NetHunter123/Jflyproject/GN+.md

---
tags:
  - project
  - engineering
  - gungnear
status: ✅ CFD дорахований; форма прийнята рішенням 01.10 з винятком (2 кВт на 250 км/год) — R07g, розд. 10 і 12
updated: 2026-10-01
---

# GN+ — модель для симуляції

> Зібрано 2026-09-29 з генератора light+. Питання: **чи лишаємо зовнішню форму**, перш ніж деталізувати стовбур, ніс і хвіст.
> Як рахувати і що вже запущено — [[R07g-GN+-CFD]]. Перший план із цієї нотатки аудит визнав невиконуваним, він в архіві: [[GN+-plan-do-audytu]].

## Файли

| | |
|---|---|
| STEP | `CAD/GN+.step` |
| STL | `CAD/GN+.stl` |
| Генератор | `python CAD/gn_detail.py` |
| Профіль | `CAD/clarky.dat` (Clark Y, UIUC) |
| Onshape | [GN+_onshape.step](https://cad.onshape.com/documents/81c8f94cadaabcb52f3eb3df/w/f67ffecee0ddf9010c7fb0ed) — окремі деталі, імпорт 2026-10-01. Файл `CAD/GN+_onshape.step`. Безкоштовний акаунт: документ публічний |

Перевірка збірки: планер і кок — два валідні тіла. Ніс від кока, хвіст x = 1371 мм, розмах 1342 мм, хорда 224 мм. Труба Ø80.

**Одиниці файлу — міліметри.** У солвері модель має стати метрами (масштаб 0,001). Контроль після імпорту: розмах **1,342 м**, довжина **1,37 м**. Якщо розмах вийшов 1342 м, масштаб не застосований, результати викинути.

Старий запуск на 250 км/год (16,5–18,5 Н) — інший літак: коротший, MH 32, із шасі. З цією GN+ його не порівнювати.

## Що в моделі є

Зібрано `python CAD/gn_detail.py`. Два тіла: планер і кок із гвинтом. Кок **не злитий** з корпусом.

- Крило **0,30 м²**, Clark Y, установка +2°, V 2°.
- Труба **Ø80**, шкіра носа і конуса врівень з нею.
- **Кок до x = 33 мм** сидить на гвинті. **Капот починається з x = 39 мм.** Між ними щілина 6 мм, у ній лопать.
- Чотири пази за мотором (x 104–118) і отвір **Ø20** у торці хвоста. Це записаний варіант носа, не остаточне рішення по охолодженню батареї.
- Чотири отвори під шпильки М3 на пробці носа і на пробці хвоста, хрест під 45° до крила.
- Джойнер Ø16 крізь трубу, з буртиком на стінці.
- Стабілізатор і кіль на конусі.

## Чого в моделі немає

- Отворів вентиляції батареї в циліндрі труби. Їх досі не вибрали.
- Люків. Труба суцільна.
- Окремих гайок і різьби: шпильки задані отворами, не нарізаним металом.
- NACA 4412.

Числа R07c (11,9 Н і 33 хв на 180 км/год, зрив 73 км/год, запас стійкості 12 %) пораховані на **MH 32**. Для Clark Y на 180 км/год очікувалась втрата близько **4 хв**, якщо решта літака та сама. Це орієнтир, не результат CFD.

## Навіщо кожен пакет

Форму міняємо, якщо спрацьовує хоч один пункт:

1. **180 км/год.** Поправлений опір на 1g вищий за **16 Н**: 33 хв тоді стають близько 25 хв, форму обговорюємо до заморозки. Стелю мотора **2 кВт** дивитись на 250 км/год: на 180 вона відповідає опору близько 34 Н і спрацьовує пізніше за 16 Н.
2. **Катапульта.** З отриманого CL_max швидкість сходу 1,2·Vs вища за **25 м/с** (стеля ELI PL-40).
3. **Стійкість.** Нахил Cm(CL) дає запас відносно x = 591 мм менший за **8 %** хорди або більший за **20 %**. Або нейтральна точка так зсунулась, що записана коробка ЦМ 575–596 мм більше не тримає близько 12 %.

Якщо жоден пункт не спрацював — зовнішня форма GN+ для цього кроку прийнятна, можна переходити до стовбура. Матеріал крила і заміна на NACA 4412 цим пакетом не вирішуються.

## Опорні числа (повний літак, 7,75 кг)

Вага **76,0 Н**. Площа **0,30 м²**. Хорда **0,2236 м**. Розмах **1,3416 м**. Повітря ρ = 1,225 кг/м³, ν = 1,46·10⁻⁵ м²/с.

Точка моментів: **x = 0,5837 м** (25 % хорди), y = 0, z = 0. Осі файлу: x назад, y на праве крило, z вгору. Позитивний Cm — ніс угору.

ЦМ для запасу стійкості лишаємо **x = 0,591 м** з R07c. Під масу крила Clark Y його не перераховували. У звіті це написати прямо.

| Режим | V | Потрібний CL на 1g | Re хорди |
|---|---|---|---|
| Найдовший політ, 88 км/год | 24,4 м/с | **0,69** | 3,7·10⁵ |
| Крейсер, 180 км/год | 50 м/с | **0,166** | 7,7·10⁵ |
| Стеля, 250 км/год | 69,4 м/с | **0,086** | 1,06·10⁶ |

CL на 1g = 76,0 / (q · 0,30), q = 0,5 · 1,225 · V². Кут 1g знаходити інтерполяцією поляри, не вгадувати. **α = 0° — це не безпідйомний політ** (установка крила +2°, профіль вигнутий).

## Як читати результат

Розклад кутів, сітки і поправка на шорсткість — у [[R07g-GN+-CFD]]. Коротко, щоб не розійтись із тим файлом:

- A і B — півмодель `GN+_cfd`. F — повна модель, бо ковзання на дзеркалі не існує.
- Лопаті в розрахунку немає. Корпус для сітки суцільний.
- Шорсткість: **D_льот = D_тиск + 1,35·D_тертя**. На весь опір 1,35 не множити.
- Опорна площа півмоделі в солвері **0,15 м²**, довжина **0,2236 м**. Сили півмоделі ×2 = повний літак.
- Наступна сітка, якщо ці запуски доведеться повторити: розділ 8 у R07g. Не повертати рецепт «7 мкм, 18 шарів, ріст 1,25».

Форму чіпаємо, якщо спрацював хоч один поріг із розділу вище. Геометрію в солвері під результат не підправляти.
