NetHunter123/Jflyproject/R08-Elektronik.md

---
tags:
  - project
  - engineering
  - gungnear
status: 🔍 дослідження записане 2026-10-03; окрема перевірка ще не проведена
updated: 2026-10-03
---

# R08 — електроніка light+: підбір, розміри, розклад

> **Рішення Віктора 2026-10-03.** Нічого ще не куплено, підбираємо все. **4 серви, без закрилків** (2 елерони + висота + напрямок). **FPV на борту** (камера + відеопередавач). Розклад робимо в Python-генераторі, а всі розміри й креслення лежать тут.
> Генератор: `python CAD/gn_layout.py` → `CAD/GN+_layout.step` (імпорт в Onshape) і `CAD/layout_report.json`.
> Скоуп як завжди: посадка і правила польотів не враховуються ([[proj. Gungnear]]).

## 1. Коротко

- Усе підібрано під стандарт R07c (12S, ~400 kV, APC 11×14). У кожної деталі є точні розміри з даташита або магазину. Де розмір оцінений, це сказано прямо (розділ 11).
- **Рекомендую варіант A:** друкований ніс подовжується на **92 мм**, у ньому відсік з ESC, датчиком струму і FPV. Ніс стає окремим «силовим модулем». **Маса ≈7,74 кг, центр мас 584,8 мм** (❌ без шпильок; з ними ≈7,97 кг і ≈587 мм — розділ 7) (коробка 575–596, перші польоти 583–590), баласт не потрібен. Апарат стає 1468 мм замість 1371.
- Варіант B (як у R07c: ESC у спинному обтічнику над носом): 593,8 мм, для перших польотів потрібно ≈60 г баласту в носі.
- Чотири речі, які розклад знайшов у вже записаному. Деталі в розділі 9:
  1. **Щілина 6 мм між коком і капотом не пропускає справжній гвинт.** Маточина APC 11×14 має товщину 14,5 мм, корінь лопаті ще ширший. Кок має закривати маточину і мати вирізи під лопаті, а капот починається за ним.
  2. **Алюмінієва труба — клітка Фарадея.** Антени приймача, відео й GPS усередині ринви не працюють. Тому GPS і приймач стоять у друкованому конусі, а відео — у друкованому носі.
  3. **ESC у трубу не стає ні вздовж, ні впоперек.** Дроти виходять з торців, і місця на їхній вигин немає. Звідси подовження носа (A) або обтічник (B).
  4. **Пакет 21700 має обрис Ø66, а не Ø70.** Шпильки М3 на Ø72 проходять з запасом 3,5 мм, суперечності з хаба більше немає. У центрі пакета лишається отвір **Ø22,5** під дроти і повітря.

> ❌ **З перевірки [[R09-Akku-Waerme]] (2026-10-04), стосується цього розкладу:**
> - **Старт на справжньому повному газі — ≈80–95 А з пакета**, а не 55–65 А (розділ 11 тут). Це понад 70 А мотора і на межі 80 А ESC. Для катапульти потрібен ліміт газу ≈85 % або сильніші мотор і ESC.
> - **250 км/год лише на свіжому пакеті** (≥3,68 В на комірку): нижче мотору бракує напруги.
> - **Потрібен конденсаторний блок (Castle CapPack ≈880 мкФ / 50 В) біля ESC**: силові дроти від пакета до ESC ≈1,5 м.
> - **XT90-S і XT90 у кільці** розраховані на 40–45 А тривало: старт і 250 км/год їх перевантажують.
> - **ESC Edge Lite у відсіку A** потребує тісного кожуха з власним NACA-входом. Деталі й решта — у R09, розділи 3–6.
> - Струм на 180 км/год ≈26 А, а не 19 А з R07c.

## 2. Список деталей

| № | Вузол | Модель | Розміри, мм | Маса, г | Живлення | Джерело |
|---|---|---|---|---|---|---|
| M | Мотор | **Scorpion SII-4035-380KV** | Ø48,8 × 64,9 корпус, загальна довжина з валом 95, вал Ø7,98, різьба гайки M8×1 | 435 | 12S, до 70 А, 2600 Вт тривало | scorpionsystem.com |
| P | Гвинт | **APC 11×14 (LP11014, «Sport»)** | маточина Ø25,4 × 14,5, отвір 5/16" (7,94) → розвернути до 8,0 | 39 | — | apcprop.com |
| E | ESC | **Castle Phoenix Edge Lite HV 80** (без BEC) | 69 × 30,5 × 17,8; у другого продавця 66 × 30,5 × 21,4 → у моделі конверт **69 × 30,5 × 21,4** | 94,6 з дротами (42,5 без) | 3–12S, 80 А | Castle / Kings Lynn Model Shop |
| I | Датчик струму + напруги | **Mauch HS-100-HV** | 47 × 18 × 11 | 8 | 4–14S, 100 А, живлення 5 В | mauch-electronic.com |
| PM | BEC | **Matek PM12S-3** | 61 × 40 × 15 | 53 | вхід 9–55 В; Vx 5,25/6/8 В 15 А; 5,2 В 4 А; 12 В 4 А; дільник 1:21 | mateksys.com |
| FC | Польотник | **Matek H743-WING V3** | 54 × 36 × 13, кріплення 30,5 × 30,5 | 30 | вхід 8–36 В (беремо 12 В з PM); свої BEC 5 В і 9/12 В | getfpv / mateksys |
| RX | Приймач | **RadioMaster RP3 V2** (ELRS 2,4 ГГц, дві антени) | 22 × 13 × 4, антени T 65 мм | 4,6 | 5 В | buddyrc |
| G | GPS + компас | **Matek M10Q-5883** | 20 × 20 × 12,4 | 8 | 5 В | readymaderc / rotorama |
| A | Датчик швидкості | **Matek ASPD-4525** + трубка Піто | плата ≈20 × 20, у моделі 20 × 20 × 6 | 3,5 + трубки | 5 В, I2C | readymaderc |
| V, K | FPV | **DJI O4 Air Unit (Lite)** | модуль 30 × 30 × 6, камера 13,44 × 12,36 × 16,5 | 8,2 (+0,75 антена) | 3,7–13,2 В → беремо 9 В з FC | DJI / getfpv |
| T, WS | Серви, 4 шт. | **KST X10** (тонке крильне, сталеві шестерні) | 30 × 29,6 × 10; з вушками 35,5 | 28 кожне | 6–8,4 В; 9,5 кг·см на 7,4 В, 10,8 на 8,4 В | KST / buddyrc |
| X1 | Головний роз'єм | **Amass XT90-S** (антиіскровий) | пара в зборі 49 × 21 × 10 | 15,3 | 45 А тривало, 90 А пік | rotorama / gator-rc |
| J | Сигнальні роз'єми | **MPX8** (8 контактів), 4 пари | ≈24 × 14 × 10 — **зміряти** | ≈6 пара | 6 А на контакт | modelheliservices |
| — | Комірки | клас 21700, приклад **Molicel P50B** | Ø21,55 × 70,15 max | 71 max | 5 Ач, 60 А | molicel.com |

**Чому саме ці.**

- **Мотор.** Справжніх 12S-моторів на ~400 kV і 2 кВт мало. SII-4025-440 бере лише 7S. T-Motor AT4130 є на 12S тільки у версії KV300, а це 13,3 тис. об/хв без навантаження: нижча стеля швидкості. SunnySky X4130-III розрахований на 6S. SII-4035-380 — 12S, 2600 Вт, 380 kV × 44,4 В ≈ 16 900 об/хв, тобто під лімітом APC 11×14 (17 273). Ціна: **на 55 г важчий** за бюджет 380 г, 279,99 $.
- **ESC.** Найменший і найлегший з 12S-регуляторів на 80 А, які знайшлися. Інші: Castle Edge HV 80 72 × 51 × 23, T-Motor FLAME 80A 84 × 33,5 × 19,5 / 109 г, YGE Aureus 105 V2 78 × 37 × 20 / 146 г / 369 €, Hobbywing FlyFun HV 110A 92,7 × 45,6 × 27 / 170 г. У Edge **Lite немає радіатора**, тому він мусить стояти в потоці повітря. У варіанті A він сидить на шляху охолодження мотора.
- **Живлення авіоніки.** Matek H743-WING бере максимум 8S. Тому 12S іде в PM12S-3: 12 В на вхід польотника, 8 В окремою шиною на серви. Польотник далі сам дає 5 В на приймач, GPS і датчики та 9 В на відео. Струм усього літака міряє Mauch на головному проводі, бо датчик польотника тепер бачить лише авіоніку. Напругу 12S дає дільник у PM12S-3.
- **FPV.** O4 Lite важить 8,2 г і має тонкий модуль 6 мм, який стає над ESC. O4 Pro (33,5 × 33,5 × 13 + камера 25,55 × 20 × 23,3, 32 г, 7,4–26,4 В) пише краще відео, але у відсік стане лише після перекладання датчика струму.
- **Серви.** Момент на шарнірі елерона 310 × 56 мм на 250 км/год: ≈3 кг·см при 10° і ≈6 кг·см при 20° (Ch_δ ≈ −0,6/рад, оцінка). X10 на 8 В дає ≈10 кг·см, запас ≥1,7. Руль висоти ≈1,7 кг·см при 10°. Усі чотири серви однакові, тож запасне одне на всіх.

## 3. Схема живлення і проводів

```
         НІС (знімний)                  ПЕРЕДНІЙ ПАКЕТ+ВАНТАЖ          КІЛЬЦЕ     ЗАДНІЙ ВАНТАЖ+ПАКЕТ        ЗАДНІЙ МОДУЛЬ + КОНУС
 мотор ─3 фази─ ESC ─ Mauch ─ XT90-S ══ F−  [6S3P]  F+ ──────────── XT90 ── R−  [6S3P]  R+                 PM12S-3 ─12 В→ FC ─5 В→ RX, GPS, ASPD
                 │                       ↑ R+ іде крізь отвір Ø22,5 ───── XT90 ───────────┘                   │  └─8 В→ 4 серви
                 └─ шина 12S (2×20 AWG) ═ MPX8 ═════════════════════════ MPX8 ═════════════════════════ MPX8 ┘  FC ─9 В→ O4 (у носі)
 O4 Lite + камера ── UART ═ MPX8 ═════════════════════════════════════ MPX8 ═════════════════════════ MPX8 ── FC
```

- **Пакет 12S** — два блоки 6S3P, з'єднані послідовно через XT90 у кільці. Плюс заднього блоку (R+) іде вперед крізь центральний отвір переднього блоку до XT90-S на носі.
- **Ніс з'єднується наосліп.** Половина XT90-S і MPX8 сидять на торцевій пластині переднього пакета, друга половина — у носі. Ніс сідає на шпильки, і роз'єми входять самі. **Посадка носа = подача живлення**, мотор крутиться лише після арму з пульта.
- **Вісім контактів MPX8, однакові на всіх трьох стиках:** 1 +12S шина (запобіжник 2 А біля Mauch), 2 GND, 3 +5 В (живлення Mauch), 4 сигнал струму Mauch, 5 газ ESC, 6 +9 В на O4, 7 UART TX, 8 UART RX. На задньому стику друга MPX8 несе 2 сигнали елеронів, +8 В і GND (4 контакти в резерві).
- **Крило.** Дроти серв і силіконові трубки Піто заходять у трубу біля кільця. Як саме — відкрите питання 3 у розділі 10.

## 4. Варіанти розкладу носа

| | **A — подовжений ніс (рекомендую)** | B — спинний обтічник (R07c) |
|---|---|---|
| Де ESC | у друкованому відсіку Ø80 × 92 мм між моторною плитою і трубою, уздовж осі | у горбі ≈75 × 55 × 28 на капоті |
| Довжина апарата | **1468 мм** (+97) | 1373 мм |
| Маса | **7,74 кг** | 7,70 кг (+60 г баласту = 7,76) |
| Центр мас | **584,8 мм** — у вікні перших польотів 583–590 | 593,8 мм → ≈60 г баласту для 590 |
| Додатковий опір на 180 км/год (оцінка) | ≈+0,2 Н від довшого циліндра + ≈0,05 Н блістер камери → ≈−0,4 хв з 26 | ≈+0,05–0,16 Н від горба (R07b-V, перераховано з 250 км/год) |
| Нейтральна точка | ≈1 мм уперед (довший ніс і гвинт далі) — запас 14–16 % майже не міняється | без змін |
| Охолодження | ESC у потоці мотора, вихід через пази капота; батарея й авіоніка мають свій шлях | ESC у зовнішньому потоці, найкраще охолодження |
| Обшивка | гладка, лише блістер камери 8 мм | горб над носом, нових продувок не було |

Обидва варіанти вкладаються в коробку ЦМ. Різниця в тому, чи ніс стає знімним силовим модулем без нічого назовні (A), чи лишається коротким із горбом (B). **Вибір за Віктором.** Генератор будує геометрію лише для A.

## 5. Станції варіанта A (x від старого носа, мм)

| Зона | x | Що там |
|---|---|---|
| Новий ніс (вершина кока) | **−97,0** | було −2,1 |
| Маточина гвинта | −60,4 … −45,9 | APC 11×14, Ø25,4 |
| Кок | −97,0 … −44,9 | кок закриває маточину, вирізи під лопаті, основа ≈Ø57,6 |
| Капот (друк, стінка 2,4) | від −42,9 | щілина 2 мм за коком |
| Мотор | −40,9 … 24,0 | Ø48,8; зазор дзвона до капота **2,6 мм** |
| Моторна плита | 24,0 … 28,0 | 4 мм |
| **Відсік ESC** (друк, Ø80) | **28,0 … 120,0** | 8 мм на фазні дроти, ESC 36–105, 15 мм на вхідні дроти |
| ESC (E) | 36 … 105 | y ±15,25, z ±10,7, по осі |
| Датчик струму (I) | 58 … 105 | над ESC, z 12–23 |
| Модуль O4 (V) | 40 … 70 | під кришкою зверху, z 25–31 |
| Камера O4 (K) | 30 … 46,5 | у блістері, верх лінзи z ≈47 (на 7,4 мм вище Ø80) |
| XT90-S (X1) | 87 … 136 | під ESC, z −23…−13; з'єднання біля x ≈118 |
| MPX8 ніс (J1) | 106 … 136 | зверху, z 25–35, запас до стінки 0,8 мм |
| Ринва Ø80 × 0,7 | 120,0 … 1230,26 | без змін |
| Пробка носа | 120 … **134** | було 20 мм, тепер 14: батарея починається на 136 |
| Передній блок B1 | 136,0 … 350,25 | 6 комірок кільцем, обрис Ø65,7 (+рукав 0,8), отвір Ø22,5 |
| Передня камера вантажу | 354,25 … 574,25 | Ø66, як R07c |
| Кільце + XT90 + MPX8 | 577,25 … 601,25 | джойнер Ø16 на x 589,25 |
| Задня камера вантажу | 604,25 … 824,25 | Ø66 |
| Задній блок B2 | 843,26 … 1057,51 | як B1 |
| 2 × MPX8 (J2) | 1060 … 1088 | стик пакет ↔ задній модуль |
| PM12S-3 | 1090 … 1151 | знизу, z −20…−5 |
| FC H743-WING | 1094 … 1148 | над PM, z −2…11 |
| ASPD-4525 | 1152 … 1172 | |
| Серви хвоста T1, T2 | 1190,8 … 1226,3 | на конусному модулі, стоять у пробці, y ±2…12 |
| Пробка хвоста | 1205,3 … 1230,3 | 25 мм |
| GPS | 1236 … 1256 | угорі конуса під коренем кіля, z 20–32,4, запас 1,7 мм |
| Приймач | 1262 … 1284 | над стабілізатором, z 9–13 |
| Торець конуса | 1371,26 | вихід Ø20 без змін |

**Крило (кожне півкрило):** серво X10 на x 620–650, y 345–380, плоско (товщина Clark Y там ≈23 мм, серво 10 мм). Елерон y 330–640, хорда 56 мм (25 %), шарнір x 695,5. Трубка Піто на y 300: виступає на 40 мм перед передньою кромкою, поза струменем гвинта (r ≈ 140).

## 6. Креслення

Бічний розріз (помаранчеве — ніс, синє — пакет і вантаж, зелене — задній модуль, червоне — конус):

![[gungnear-r08-layout-side.png]]

Поперечні розрізи (вигляд ззаду). Жовті точки — шпильки М3 на Ø72:

![[gungnear-r08-layout-sections.png]]

Праве півкрило:

![[gungnear-r08-layout-wing.png]]

3D: `CAD/GN+_layout.step` — оболонка напівпрозора, кожна деталь окремим тілом з ID з таблиці. Імпортується в Onshape як збірка.

## 7. Маса і центр мас

База — R07c-V: **7750 г, ЦМ 590,6 мм**. З неї знято старий бюджет електроніки і додано новий поелементний список. Батарея, вантаж і конструкція лишаються на місцях R07c.

**Знято (бюджет R07b-V/R07c), 1111 г:** мотор 380 @88 · гвинт 39 @48 · кок/моторама/капот 81 @70 · ESC в обтічнику з проводкою, роз'ємами і запобіжником 271 @165 · авіоніка FC/GPS/RX/BEC 96 @1132 · 2 серво хвоста 75 @1142 · 4 серво крила 149 @620 · проводка R07c 20 @600.

**Додано, варіант A, 1097 г:**

| Що | г | x, мм |
|---|---|---|
| Мотор | 435 | −4 |
| Гвинт | 39 | −53 |
| Кок | 20 | −62 |
| Капот + плита | 61 | −5 |
| Відсік ESC (друк) | 50 | 74 |
| ESC | 94,6 | 70,5 |
| Mauch | 8 | 81,5 |
| O4 модуль + антена | 5,9 | 55 |
| O4 камера + блістер | 6,1 | 38 |
| XT90-S | 15,3 | 111,5 |
| MPX8 ніс | 6 | 121 |
| Кільце: XT90 + MPX8 | 20 | 589 |
| Провід R+ крізь передній блок | 21 | 220 |
| Джгут ніс → корма | 27 | 610 |
| Дроти серв крила | 8 | 860 |
| 2 × MPX8 ззаду | 12 | 1074 |
| PM12S-3 | 53 | 1120 |
| FC | 30 | 1121 |
| ASPD | 3,5 | 1162 |
| Розподіл 8 В | 5 | 1120 |
| 2 серво хвоста | 56 | 1209 |
| Тяги хвоста | 20 | 1280 |
| GPS | 8 | 1246 |
| Приймач | 4,6 | 1273 |
| 2 серво елеронів | 56 | 635 |
| Тяги й кришки серв крила | 24 | 686 |
| Піто + трубки | 8,4 | 760 |

**Результат A: 7736 г, ЦМ 584,8 мм.** Без баласту, у вікні перших польотів 583–590. Розпіркою заднього блоку (±15 мм → ±3,5 мм ЦМ) можна підняти ЦМ до 588 ± 3.
**Результат B: 7704 г, ЦМ 593,8 мм.** До 590 потрібно ≈60 г баласту в носі.

Не враховано: шпильки довші на ≈83 мм кожна, якщо вони доходять до моторної плити (+≈18 г на x ≈80, ЦМ −1,2 мм).

> ❌ **ВИПРАВЛЕНО 2026-10-03** (знайдено перевіркою довідки про Ø90): **самі шпильки в масі взагалі не враховані**, ні тут, ні в R07c. Це 8 × М3 сталь, 0,0555 г/мм: передні 4 × ≈457 мм (кільце → пробка носа) ≈101 г, задні 4 × ≈604 мм ≈134 г, разом **≈235 г**. З ними варіант A ≈**7,97 кг, ЦМ ≈587 мм**. Це ще у вікні перших польотів 583–590 і в коробці 575–596. Якщо шпильки доходять до моторної плити, додай ще ≈18 г. Полегшити можна алюмінієвими (7075) або титановими шпильками, або М2,5 — не пораховано. Окремої перевірки R08 ще не було.

## 8. Перевірка «чи влазить» (генератор)

Запас від кута деталі до внутрішньої стінки в найвужчому місці її довжини, мм. Перетинів між деталями немає.

| Деталь | Запас | | Деталь | Запас |
|---|---|---|---|---|
| Мотор у капоті | 2,6 | | PM12S-3 | 11,0 |
| ESC | 19,0 | | FC | 18,2 |
| Mauch | 12,9 | | ASPD | 28,5 |
| Модуль O4 | 3,2 | | Серви хвоста (у пробці) | 17,5 |
| XT90-S | 11,2 | | **GPS у конусі** | **1,7** |
| **MPX8 ніс** | **0,8** | | Приймач | 15,1 |
| Пакети B1/B2 | 5,7 | | Камери вантажу | 6,3 |
| Шпилька ↔ комірка | 3,5 | | Отвір у пакеті | Ø22,5 |

Найтісніші місця — MPX8 у пробці носа і GPS під кілем. Обидва треба звірити зі справжніми деталями.

## 9. Що це міняє в уже записаному

- ~~Кок до x = 33, капот з x = 39, щілина 6 мм, у ній лопать~~ ❌ **R08:** маточина APC 11×14 має 14,5 мм, а лопать біля кореня при кроці 14" займає вздовж осі ще більше. Кок мусить закривати маточину й мати вирізи під лопаті. Капот починається на 2 мм за коком. Повітря на мотор у такій щілині ≈3 см², тож вхід охолодження проєктувати окремо. **Зовнішня форма не міняється.**
- ~~Мотор у капоті x 48–98, «загальний» Ø46~~ ❌ **R08:** реальний 12S-мотор має довжину 64,9 мм і Ø48,8. Перед x ≈54 (старі координати) капот для нього затісний. Моторна плита стоїть на 118,9–122,9 (старі) або 24–28 (A).
- ~~Пакет 21700 у конверті Ø70, шпилька на r=36 заходить на пакет~~ ❌ **R08:** 6 комірок кільцем дають обрис **Ø65,7** (з рукавом ≈Ø67,3). Шпилька на Ø72 за 3,5 мм від найближчої комірки. Суперечність закрита.
- ~~Пробка носа 20 мм~~ ❌ **R08:** **14 мм**, бо батарея починається за 16 мм від торця труби. Навантаження несуть шпильки й торець, як і записано в [[Zbirka-shpilky]].
- ~~ESC Castle Edge HV 80 (72 × 51 × 23) як еталон~~ ❌ **R08:** беремо Edge **Lite** HV 80 (69 × 30,5 × 21,4, 94,6 г). Усередину ринви він не стає з жодним поворотом, бо дроти виходять з торців.
- ~~Авіоніка FC/GPS/приймач/BEC на x ≈1132, серви хвоста x ≈1142~~ ❌ **R08:** GPS і приймач переїхали в друкований конус, бо крізь алюміній не проходить радіо. Серви хвоста стоять на конусному модулі в пробці (1191–1226). Кіль у зоні над GPS не може мати вуглецю.
- ~~6 серв (з закрилками)~~ ❌ рішення 03.10: **4 серви**.

## 10. Відкриті питання — рішення Віктора

1. **Варіант A чи B** (розділ 4). Від цього залежить, чи переробляти ніс у CAD.
2. **Комірка.** P50B (5 Ач, 71 г, 648 Вт·год на 36 шт.) чи P45B (4,5 Ач, 70 г, 583 Вт·год, база R07c). Розміри однакові, розклад від вибору не залежить. Час у повітрі з P50B ≈+11 %, маса +36 г.
3. **Як дроти крила і Піто заходять у трубу.** Пропоную по два отвори Ø8–10 на кожен бік, на 15–20 мм позаду гільзи джойнера, під зализом кореня крила. У кільці стоять гнізда, у які встромляються роз'єми кореня. Хаб поки дозволяє лише отвір під джойнер, тож без рішення Віктора не свердлити.
4. **Компас.** Серви хвоста стоять за ≈10 мм від GPS-компаса. Для літака INAV/ArduPilot можуть летіти без компаса, за курсом GPS. Пропоную компас вимкнути, а не відсувати серви.
5. **O4 Lite чи Pro.** Lite стає як є. Pro потребує переставити датчик струму.
6. Шпильки до моторної плити (тягу несе метал, +≈18 г) чи до пробки носа (тягу несе друкований відсік).

## 11. Що не перевірено (для окремого проходу перевірки)

- Розміри MPX8 (≈24 × 14 × 10) — даних не знайдено, оцінка.
- Монтажні отвори Scorpion SII-4035 не опубліковані. У старшої серії HKIII-4035 — 30 × 25 мм під M4; для SII зміряти.
- Довжина валу перед дзвоном (≈30 мм з «загальної довжини 95») — висновок, не креслення.
- Струм на старті з катапульти: оцінка ≈55–65 А при повному газі (Cp статичний ≈0,08–0,09, не з даних APC). Межі ESC 80 А, мотора 70 А, XT90-S 45/90 А не перевищено, але це треба перерахувати.
- Шлейф камери O4 Lite: чи дістає від блістера до модуля (≈40 мм шляху).
- Маси: кок 20, капот 61, друкований відсік 50, тяги, джгути, роз'єми MPX8 — оцінки.
- Розміри Castle Edge Lite в двох джерелах різні (17,8 / 21,4 мм висоти). У моделі взято більший.
- Шарнірні моменти — тонкопрофільна оцінка Ch_δ ≈ −0,6/рад, без даних для конкретних рулів.
- Ефект подовженого носа на опір і стійкість — оцінка, не CFD.

## 12. Джерела

- Scorpion SII-4035-380: https://www.scorpionsystem.com/catalog/aeroplane/motors_1/sii-40/SII-4035-380/
- Scorpion SII-4025-440 (7S max): https://www.scorpionsystem.com/catalog/aeroplane/motors_1/sii-40/SII-4025-440/
- T-Motor AT4130: https://store.tmotor.com/product/at4130-long-shaft-fixed-wing-motor.html
- APC 11×14: https://www.apcprop.com/product/11x14/
- Castle Edge Lite HV 80: https://www.castlecreations.com/en/phoenix-edge-lite-hv-80-esc-010-0118-00 · https://www.kingslynnmodelshop.co.uk/castle-creations-phoenix-edge-80-lite-hv-esc/
- YGE HV: https://www.yge.de/en/high-voltage-hv-2/ · T-Motor FLAME 80A: https://www.getfpv.com/tiger-motor-flame-80a-esc.html
- Matek PM12S-3: https://www.mateksys.com/?portfolio=pm12s-3 · PM12S-4A: https://www.mateksys.com/?portfolio=pm12s-4a · FCHUB-12S: https://www.mateksys.com/?portfolio=fchub-12s
- Matek H743-WING V3: https://www.getfpv.com/mateksys-h743-wing-v3-flight-controller.html
- Mauch HS-100-HV: https://mauch-electronic.com/products/074-hs-100-hv
- Matek M10Q-5883: https://www.readymaderc.com/products/details/matek_gps_compass_module_m10q-5883
- Matek ASPD-4525: https://www.readymaderc.com/products/details/matek-digital-airspeed-sensor-aspd-4525
- RadioMaster RP3 V2: https://www.buddyrc.com/products/radiomaster-rp3-expresslrs-2-4ghz-nano-receiver
- DJI O4 Lite: https://www.getfpv.com/dji-o4-air-unit.html · O4 Pro: https://www.getfpv.com/dji-o4-air-unit-pro.html
- KST X10: https://www.buddyrc.com/products/kst-x10-digital-servo-8-4v-0-10s-7-5kg-cm-104oz-in
- XT90-S: https://www.rotorama.com/product/xt90s-antispark-konektor-par
- MPX8: https://www.modelheliservices.com/products/mpx8-gp-high-current-plug-green-1-pair
- Molicel P50B: https://www.molicel.com/wp-content/uploads/Product-Data-Sheet-of-INR-21700-P50B-80122.pdf · P45B: https://www.molicel.com/inr-21700-p45b/
