NetHunter123/Jflyproject/R09-Akku-Waerme.md

---
tags:
  - project
  - engineering
  - gungnear
status: 🔍 перевірено 2026-10-04 (розділ 9) — основне вистояло, кілька важливих поправок внесено видимо
updated: 2026-10-04
---

# R09 — готові батареї, нагрів, охолодження, шкідливе сусідство

> **Питання Віктора 2026-10-04.** (1) Чи не логічніше брати готові зібрані батареї? Вони зазвичай прямокутні. Знайти збірки різного формату, які підходять. (2) Список усього, що гріється, хто потребує сильного чи активного охолодження, орієнтовні температури на різних режимах, варіанти охолодження і їхній вплив на конструкцію. (3) Список шкідливого сусідства, на кшталт «мотор біля GPS» чи «GPS біля BEC».
> База — розклад [[R08-Elektronik]] (варіант A, Ø80). Тут нічого не змінено в CAD і в рішеннях: усе нижче — дані й пропозиції. Рахунки лежать у scratchpad-сесії (`r10/packs`, `r10/thermal`). Скоуп як завжди: без посадки й правил.

## 1. Коротко

**Батареї.** Віктор правий наполовину. Готові Li-ion збірки справді прямокутні, і популярні «пласкі» 6S2P (130 × 75 × 42 та подібні) у трубу **не стають ніколи**: у них комірка лежить поперек, а 70–75 мм поперек труби Ø78,6 не проходять. Але є друга поширена родина — **«башта» 2 × 3 комірки** (переріз ≈43 × 64), де комірки стоять уздовж. Вона стає без змін шпильок і має в шарі ті самі 6 комірок, що й наше кільце. Тобто кругла труба нічого не губить.
- Найкращий двійник нашого блока — **Topwell 6S3P 42 × 63 × 210**. Дві штуки дають 648 Вт·год, 2,66 кг і стають точно на станції 214 мм, але продаються лише за запитом.
- Що реально продається в ЄС — **Dogcom 6S2P 43 × 64 × 145**. Дві штуки дають 444 Вт·год і ≈20 хв замість 26, зараз немає в наявності.
- **Рекомендація:** не купувати LiPo, напівтвердотільні чи «пласкі» пакети. Блок перемалювати з кільця на **брусок 2 × 3 × 3** і замовити у німецького збирача на P50B/P60B. P60B дає ≈778 Вт·год, ≈34,6 хв.

> ❌ **Після перевірки (розділ 9) головне змінилось так:**
> - Брусок 2 × 3 стає лише в двох вікнах кута, тому **обов'язковий лоток зі шпонкою**, вставляти під 45°.
> - Канал Б охолоджує ESC **лише з тісним кожухом** довкола нього (зазор 2–3 мм). Без кожуха ESC перегрівається, навіть на 88 км/год.
> - **Справжній повний газ на старті — ≈80–95 А, а не 60 А.** Це понад межу мотора (70 А) і на межі ESC (80 А), тож для старту потрібен ліміт газу.
> - **250 км/год досяжні лише в першій половині розряду батареї** (≥3,68 В на комірку).
> - **Потрібен конденсаторний блок біля ESC:** силові дроти від батареї ≈1,5 м, а Castle для HV-регуляторів вимагає додаткових конденсаторів уже понад ≈30 см.

**Нагрів.** Справжніх проблем три:
1. **ESC без радіатора** у закритому відсіку перегрівається за ≈1–2 хв у будь-якому режимі, крім 88 км/год. Потрібні свій канал повітря і пластина на обшивку.
2. **Мотор** без вихідних пазів у капоті перегрівається вже на 180 км/год. З пазами 180 км/год нормально, а рівно 250 км/год — межа на ≈3 хв.
3. **Батарея при +35 °C** після старту і 24 хв на 180 км/год доходить до ≈63 °C при межі 60 °C. Ривок на 250 км/год обмежений теплоємністю: від 35 до 60 °C за ≈4 хв.

Окремо: **O4 Lite на землі без обдуву вимикається за кілька хвилин.** Потрібен вентилятор до пуску.

**Сусідство.** Головне — компас у GPS:
- поруч сталеві гайки задніх шпильок (13 мм) і серви хвоста (11 мм), норма 10 см;
- приймач ELRS за 9 мм від GPS, норма ≥5 см.

Найпростіше рішення — **вимкнути компас**: літак летить за курсом GPS. Приймач відсунути. Головний струм батареї компасу майже не заважає, бо дроти укладені співвісно.

## 2. Готові батареї

### 2.1 Яка форма проходить у трубу

Внутрішній Ø78,6. 4 шпильки М3 на Ø72 під 45° до крила, їхній внутрішній край на r 34,5. Зазор на люфт і друкований лоток — 1,8 мм.

| Форма | Що проходить |
|---|---|
| Прямокутник з гострими кутами, сторони вздовж осей крила | квадрат ≤46 мм; «висока» смуга між шпильками 44 × 61, 40 × 63, 30 × 69; «пласка» 64 × 39, 70 × 27, 72 × 21 |
| Той самий прямокутник, повернутий на 45° (шпильки дивляться в середини граней) | квадрат ≈53 мм; 50 × 56, 60 × 45 |
| Сітка 2 × 3 комірок 21700 (круглі кути) | ~~**стає**: 4,1 мм до стінки, 2,6–4,35 мм до шпильок~~ ❌ **стає лише в двох вікнах кута**: уздовж осей крила ±2,5° (2,6 мм до шпильок); під **45° ±11°** (4,1 мм до стінки, 5,45 мм до шпильок). При 9–27° налазить на шпильки до −0,7 мм |
| 1 + 6 (шестикутник) 21700 | стає |
| 3 × 3 комірок 18650 | стає (3,4 мм) ❌ лише при повороті ≈16–74°; уздовж осей крила налазить на шпильку (−1,4 мм) |
| 3 × 3 або 2 × 4 комірок 21700 | **не стає** |
| Будь-який переріз, де один розмір = довжина комірки 70–78 мм | ~~**не стає ніколи**~~ ❌ один ряд комірок поперек, ≤72 × 22 мм, стає. Два ряди або довжина ≥73 мм — ні. На практиці такий ряд дає ≈−46 % енергії на мм труби |

**Правило:** готовий Li-ion пакет стає, лише якщо комірки в ньому стоять **уздовж труби**, а переріз не більший за 2 × 3 комірки 21700 (≈43 × 65) або 3 × 3 комірки 18650 (≈56 × 56). Повернути пакет на 45° — те саме, що перенести шпильки на 0/90/180/270°. Тому переносити шпильки не треба.

### 2.2 Знайдені збірки

| Збірка | Хімія, схема | Розміри, мм | Маса, г | Вт·год | Струм | Стає? | Для 12S | Ціна, де купити |
|---|---|---|---|---|---|---|---|---|
| **Topwell 6S3P 15 Аг** | Li-ion 21700 | **42 × 63 × 210** | 1330 | 324 | 90 А | **так** | 2 шт.: 12S3P, 648 Вт·год, 2,66 кг, ≈28,9 хв, станції без змін | за запитом, OEM (Китай) |
| **Dogcom 6S2P 10 Аг** | Li-ion 21700 | **43 × 64 × 145** | 896 | 222 | ≈100 А | **так** | 2 шт.: 12S2P, 444 Вт·год, 1,79 кг, ≈20 хв, на станції 69 мм запасу (±8,7 мм ЦМ) | 112,90 € fpv24.com, зараз немає |
| Dogcom 6S1P 4 Аг | Li-ion 21700 | 43 × 64 × 77 | 434 | 89 | ≈40 А | так | 6 шт. (3P на станцію): 533 Вт·год, 2,6 кг, станція 239 мм, ≈23,8 хв | не вказано |
| Tattu напівтвердотільний 6S 12 Аг | напівтвердий LiPo | 194 × 71 × 32 | 800 | 266 | **36 А** | ні (0,36 мм до голої стінки) | 2 шт.: 533 Вт·год, 1,6 кг, але 36 А не тягне 250 км/год | 267 € gensace.de, немає |
| Tattu напівтвердотільний 6S 17 Аг | напівтвердий LiPo | 191,5 × 71,5 × 49,4 | 1376 | 377 | 51 А | ні | — | 345 € gensace.de |
| Gens Ace G-Tech 6S 5000 | LiPo | 163 × 46 × 45 | 724 | 111 | 300 А | так | 4 шт.: 444 Вт·год, 2,9 кг, станції 330 мм, камери вантажу 104 мм | 120 € gensace.de |
| Tattu G-Tech 6S 8000 | LiPo | 172 × 66 × 48 | 1140 | 178 | 200 А | ні | — | — |
| Tattu 12S 10000 | LiPo | 182 × 67 × 115 | 2800 | 444 | 300 А | ні | — | 468 $ |
| Upgrade Energy GREEN 6S3P (Amprius SA10) | Li-ion 18650 Si | 135 × 56 × 56 | 919 | 259 | **≈11,5 А** | так (як 3 × 3) | 2 шт.: 518 Вт·год, 1,84 кг, але струм не тягне навіть крейсер | 275 $, США |
| ZOHD Lionpack 4S1P 21700 | Li-ion 21700 | 75 × 43 × 43 | 305 | 74 | 10 А | так | 9 шт., 707 мм — камер не лишається | знято з виробництва |
| Keeppower 6S2P 21700 | Li-ion 21700 | 130 × 75 × 42 | — | 216 | — | **ні** | — | — |
| Auline S70 6S2P | Li-ion 21700 | 75 × 42 × 130 | 852 | 200 | 140 А | ні | — | 169 $ |
| GNB / Racepow 6S2P 8000 | Li-ion 21700 | 44 × 81 × 130 / 43 × 77 × 130 | 880 / 858 | 178 | 80 А | ні | — | rotorama, знято |
| MaxAmps 12S2P | Li-ion | 253 × 43 × 75 | — | 432 | — | ні | — | 720 $, США |
| WREKD 6S1P P50B | Li-ion 21700 | 139 × 25 × 72 | 450 | 108 | 60 А | впритул, без лотка | 6 шт.: станції по 425 мм | 126 $, США |

### 2.3 Порівняння з нашим блоком

Хвилини на 180 км/год рахуються як 26 хв × (Вт·год / 583) − 0,027 хв на кожні +100 г.

| Варіант | Вт·год | Маса, кг | Вт·год/кг | Довжина в трубі | Хв на 180 |
|---|---|---|---|---|---|
| Кільце P45B (R07c/R08) | 583 | 2,63 | 222 | 2 × 214 | 26,0 |
| Кільце / брусок на P50B | 648 | ≈2,67 | ≈243 | 2 × 214 | ≈28,9 |
| Брусок на **P60B** (6 Аг, 21,6 Вт·год, ≤75 г, 60 А) | ≈778 | ≈2,81 | 277 | 2 × 214 | **≈34,6** |
| Topwell 6S3P × 2 | 648 | 2,66 | 244 | 2 × 210 | ≈28,9 |
| Dogcom 6S2P × 2 | 444 | 1,79 | 248 | 2 × 145 | ≈20,0 |
| LiPo Gens Ace 6S 5000 × 4 | 444 | 2,90 | 153 | 2 × 330 | ≈19,7 |

**Де готове краще:** заводське зварювання, ізоляція, баланс-роз'єм, тест. Не потрібні зварювальник і навичка, можна купити одразу.
**Де готове гірше:** більшість готових пакетів не стає зовсім. Ті, що стають, у роздрібі продаються лише як 6S1P/6S2P: це або −24 % енергії, або 4–6 пакетів з паралельним джгутом. Бренд комірок у Dogcom і Topwell невідомий. LiPo і напівтвердотільні або не стають, або слабкі за струмом.

**Струм.** Крейсер ≈25–26 А, старт і 250 км/год ≈60–68 А. Це ≥20–23 А на комірку в 3P. P45B/P50B/P60B і Dogcom 10C тягнуть. Amprius SA10 (8 А на комірку) і Tattu 12 Аг (36 А на пакет) — ні.

### 2.4 Рекомендація

1. **Не купувати** LiPo, напівтвердотільні і «пласкі» Li-ion 6S2P.
2. **Перемалювати блок з кільця на брусок 2 × 3 × 3**: 18 комірок 21700 уздовж труби, переріз ≈43 × 65, довжина ≈215 мм. Шість комірок у шарі, 214 мм на станцію — маса й ЦМ не міняються. Шпильки лишаються, брусок краще повернути на ≈40–45° до крила (запас 4,35 мм). Провід R+ іде вільним сегментом труби (висота ≈17,5 мм) замість центрального отвору. Повітря довкола бруска навіть більше, ніж довкола кільця: ≈2040 мм² проти ≈1690.
   ❌ **Уточнення перевірки:**
   - **Лоток зі шпонкою обов'язковий.** Брусок ставити під **45°**: допуск ±11°, до шпильок 5,45 мм, мінімум 4,13 мм дає стінка. Без шпонки при 9–27° різьба шпильки зрізає термоусадку.
   - **Довжина ≈215 мм не влазить** у станцію 214,25 мм. У кресленні для збирача задати ≤214 мм або подовжити станцію на 1–3 мм.
   - Під 45° шпильки стоять посеред вільних сегментів, тож для R+ лишається **≈11,8 мм**. R+ вести в захисній оболонці, бо він тертиметься об різьбу.
   - **Проводка «U»:** ряд A — три шари вглиб, на задньому торці перемичка A → B, ряд B повертається вперед. Так обидва полюси на передньому торці. Між рядами до ≈21 В — потрібна ізоляція (fish paper).
   - Відводи балансу (7 на блок) класти на грані, що дивляться у вільні сегменти, не на кути біля шпильок.
   - Масу лотка замість рукава 0,8 мм не пораховано.
3. Такий блок **замовити у збирача пакетів** за кресленням, комірки Molicel P50B або P60B:
   - AkkuPlus (Burgwald): https://akkuplus.de/Akku-und-Batteriepacks-Konfektionierung
   - Akkukaufhaus «Wunschakku» (Kiel): https://www.akkukaufhaus.de/Wunschakku/
   - також akkukonfigurator.de, elbatec.de

   Або запитати Topwell 6S3P 42 × 63 × 210 у двох екземплярах. Або зварити самому, але прямокутником.
4. **Купити й летіти зараз:** 2 × Dogcom 6S2P 10 Аг. Це 444 Вт·год, ≈20 хв, ЦМ 585,9 мм, пакети можна зсувати на станції для підстроювання ЦМ.
   ❌ **Уточнення перевірки:**
   - Це 2P: на крейсері 13 А на комірку (у 3P — 8,7 А), на піку 30–34 А. Тепла в комірках ≈2,2 раза більше, просідання більше, тож **≈20 хв оптимістично**.
   - У готових пакетів гнучкі виводи. Для сліпого стикування XT90-S і MPX8 потрібна своя торцева пластина.
   - **Topwell:** 42 × 63 × 210 — це рівно кратні голої комірки, без нікелю й ізоляції. Реальний пакет ≈44 × 65 × ≥215, тож «точно на станції 214» не доведено. Заявлені 90 А суперечать ≤300 мОм з того самого даташиту.

⚠️ Кільце в [[R08-Elektronik]] — це досі записаний розклад. Перехід на брусок — **рішення Віктора**, тут лише пропозиція.

## 3. Що гріється

Режими з R07g: 88 км/год — 0,18 кВт на валу; 180 км/год — 0,91 кВт; 250 км/год — 2,29 кВт. Старт з набором — повний газ ≈60 А протягом 2 хв (оцінка). Повітря на землі +20 і +35 °C.

> ❌ **ВИПРАВЛЕНО:** струм пакета на 180 км/год **≈26 А**, а не ≈19 А з R07c/R08. 19 А — це книжковий опір 11,9 Н на MH 32. За CFD (15,3 Н) виходить ≈26 А, ≈8,7 А на комірку.

Температури: «20 / 35» означає повітря +20 / +35 °C. «Без доробки» — так, як зараз у R08.

| Що | Де | Втрати, Вт (88 / 180 / 250 / старт) | Температура без доробки | З охолодженням | Межа | Потреба |
|---|---|---|---|---|---|---|
| **ESC Castle Edge Lite HV 80** | ніс x 36–105, без радіатора | 14 / 43 / 65 / 60 | перегрів: 35 → 100 °C за ≈100 с на 180, ≈66 с на 250 | канал Б: 180 — 69–83 / 84–98 °C; 250 — 83–102 / 98–117 °C; з пластиною В ще −10…20 К | 100 °C (Castle) | **сильний потік, окремий канал** |
| **Мотор Scorpion SII-4035** | ніс x −41…24 | 35 / 109 / 243 / 232 | глухий капот: 180 — ≈151/166 °C, 250 — >200 °C | з пазами: 88 — 30–51 °C; 180 — 53–84 °C; 250 (≈3 хв) — 92–140 °C; старт 2 хв — 79–110 °C | провід 180 °C, магніти без числа | **сильний потік, вихідні пази** |
| **Батарея (кожен блок)** | x 136–350, 843–1058 | 1 / 20 / 140 / 116 (на блок) | старт + 24 хв на 180: 48 / **63 °C**; з 3 хв на 250: 62 / 78 °C | канал Г: 35 / 50 °C; містки Д: 31 / 46 °C; з ривком 41 / 56 °C | 60 °C розряд (Molicel) | **потік або містки при 35 °C** |
| Провід R+ 10 AWG у центрі пакета | вісь, ≈0,96 м | 0,1 / 2,1 / 14,6 / 12,1 | +25 К/хв на 250 без потоку, гріє комірки зсередини | 8 AWG: 9,6 Вт/м замість 15,3 | комірки 60 °C поруч | пасивне |
| XT90-S (ніс) / XT90 (кільце) | x 87–136 / 577–601 | 0,04 / 0,76 / 5,2 / 4,3 і 0,02 / 0,41 / 2,8 / 2,3 | 88, 180: +5–10 К; 250, старт: +30–60 К за кілька хв | — | **40 А тривало** (RS PRO), 90 А мить | пасивне |
| Mauch HS-100-HV | над ESC | ≈0,1 / 0,5 на 250 | ≈ESC − 10…20 К, до 70–90 °C | у каналі ESC | ≥85 °C | пасивне |
| **DJI O4 Lite** | над ESC | 4,9–6,0 у польоті, 3 у low-power | **на землі: 70 °C за 60 с, вимкнення за кілька хв** | у польоті з обдувом 44–54 / 59–69 °C | внутрішній захист | **активне на землі (вентилятор)** |
| BEC PM12S-3 | x 1090–1151, закритий задній відсік | 1–1,6 крейсер, 2–3 пік | 45–60 / 60–75 °C | 1–2 малі отвори або частина каналу | тепловий захист, числа немає | пасивне |
| Польотник H743-WING | над PM | ≈1,7 | 40–55 / 55–70 °C | як PM | ≈85 °C (типово) | пасивне |
| Серви KST X10 (хвіст, крило) | пробка хвоста / крило | 0,3–1,5 кожна | 35–50 / 50–65 °C | не пускати на них вихлоп батареї | **65 °C** (KST) | пасивне |
| ASPD-4525 | 3 мм від PM | ≈0,01 | 45–60 / 60–75 °C, **дрейф нуля** | відсунути ≥30 мм | 85 °C | пасивне |
| GPS, приймач, MPX8 | конус / шини | <0,5 | ≈температура повітря | — | GPS 80 °C | не треба |
| Сонце на землі | уся труба | +18…80 Вт поглинання | пакет на 5–15 К тепліший за повітря після 20–30 хв | тінь, пакет ставити перед пуском | — | організаційне |

> ❌ **Поправки перевірки до таблиці:**
> - **ESC:** теплоємність плати ≈40 Дж/К, а не 66 (52 г із 94,6 — дроти). У закритому відсіку 100 °C настає за ≈61 с на 180 і ≈40 с на 250. **Перегрівається і на 88 км/год:** за 9–15 хв, а політ 96 хв. Числа «з охолодженням» вимагають ≈15–25 м/с повітря вздовж ESC. Це дає лише **тісний кожух** (зазор 2–3 мм, прохідний переріз ≈2–3 см²). Без кожуха 5,4 г/с розходяться по відсіку до ≈1,3 м/с, і ESC на 180 значно вище 100 °C.
> - **Мотор:** втрати в залізі невизначені, діапазон 29–35 / 81–109 / 185–243 Вт.
> - **250 км/год:** мотору на 14 000 об/хв треба 38,9 В, а пакет під 68 А при 3,6 В на комірку дає лише 38,3 В. **Ривок 250 можливий лише в першій половині розряду** (≥3,68 В на комірку).
> - **Старт:** «60 А» — це ≈87 % газу. **Справжній повний газ дає ≈80–95 А**: понад 70 А мотора, на межі 80 А ESC, удвічі понад XT90-S і XT90 (40/45 А). Тепло на старті в 1,6–2,4 раза більше. Для катапульти — ліміт газу ≈85 % або сильніші мотор, ESC і роз'єми.
> - **Батарея, закритий пакет:** не враховано випромінювання й контакт лотка. Реальний UA 0,25–0,5 Вт/К, тож старт + 24 хв при +35 °C дають **≈58–60 °C, а не 63**. Межа 60 °C у Molicel — це температура середовища при розряді; струми задані до 80 °C на комірці (P60B — 90 °C). Тобто ризик менший, ніж здавалось. Не враховано ≈5 мОм перемичок (+9 % тепла). P50B гріється на ≈15 % менше за P45B.
> - На старті обдув гвинтом (45–51 м/с у струмені проти 26) охолоджує мотор і ESC краще, ніж пораховано.
> - O4 Lite «70 °C за 60 с» — джерело blog.uavmodel.com, не oscarliang. На oscarliang лише «дуже гарячий за 20–30 с» і «вимикається за кілька хвилин».
> - **Пропущено:** від батареї до ESC ≈1,5 м силових дротів (R+ ≈0,96 м + перемичка ≈0,55 м). Castle для HV-регуляторів понад ≈30 см вимагає додаткових конденсаторів. Потрібен **Castle CapPack (≈880 мкФ / 50 В) біля ESC**, інакше вхідні конденсатори ESC гріються і з'являються викиди напруги.
> - **Пропущено:** нагрів після зупинки мотора на землі (тепло мотора, ESC і пакета йде в ніс і на O4); сонце на чорних друкованих конусі й носі (до 50–60 °C — межа для PLA, тому ASA і світлий колір).

**Сильного або активного охолодження потребують:**
- **ESC** — свій канал повітря обов'язково, плюс пластина на обшивку. Якщо на тесті понад 90 °C — більший ESC.
- **Мотор** — вихідні пази в капоті ≥4,5 см² обов'язково. Вхід 2 мм за коком повітря дає достатньо.
- **O4 Lite** — вентилятор на землі (активне), у польоті вистачає потоку.
- **Батарея при +35 °C** — канал або теплові містки. При +20 °C закритий пакет витримує крейсер.
- **Ривок 250 км/год** охолодженням не лікується: його обмежує теплоємність пакета. Ліміт ≤3 хв при +35 °C, датчики NTC.

## 4. Варіанти охолодження

| | Для чого | Як | Розміри і потік | Опір на 180 км/год (верхня межа m·V) | Маса | Вплив на конструкцію |
|---|---|---|---|---|---|---|
| **А** | мотор | вхід — щілина 2 мм за коком (≈3 см²), уздовж дзвона, вихід — пази в капоті одразу за мотором; моторна плита **глуха** | пази ≥4,5 см² (напр. 4 × 12 × 10 мм); 3,7 / 7,6 / 10,6 г/с на 88/180/250 | 0,38 Н (≈0,6 хв) | ≈0 | труба не зачеплена. Капот і плита з **ASA** (PLA м'якне при 60 °C, PETG при 80, ASA при 110). Пази не мають дути на камеру |
| **Б** | ESC, O4, Mauch | свій втоплений **NACA-вхід** знизу-збоку відсіку носа: O4 → перегородка → ESC → жалюзі **назовні** | горло ≈1,8 см² (≈15 × 12 мм), рампа ≈60 мм, вихід ≥2,5 см² на x ≈105–118 | 0,27 Н (≈0,45 хв) | 5–8 г | лише друкований ніс. Вода й пил на ESC і O4 → лак (conformal coat). Вирізи не перетинають шпильки |
| **В** | ESC (доповнення до Б) | ESC без термоусадки з боку ключів через **ізолюючу** термопрокладку притиснутий до алюмінієвого вікна ≈70 × 40 × 1 мм у дні відсіку | знімає 15–30 Вт при +40–50 К | 0 | 8–12 г | на ключах фаза 44 В: прокладка мусить ізолювати |
| **Г** | батарея, R+, частково PM/FC | **канал Віктора з 01.10**: свій вхід → крізь пробку носа → центр і зазор B1 → повз вантаж → крізь кільце → B2 → вихід | ≈4 г/с на 180; вхід ≈1 см²; доступний тиск ≈q = 357 / 1500 / 2890 Па, канал не задихається | 0,20 Н (≈0,35 хв) | 15–30 г | вихід а) крізь хвіст Ø20 — тепло на серви, FC, барометр; **б) 2–4 круглі отвори Ø8–10 на боках труби (y ±40, z 0) біля x 1060–1080** — краще. Кільце з осьовими отворами ≥2–3 см². Пил і вода крізь пакет → сітка, злив, герметичний рукав |
| **Д** | батарея | **теплові містки** пакет → труба: алюмінієві сідла 0,5 мм на ізолюючих прокладках, пружні смужки до стінки, між шпильками | 0,3–0,6 К/Вт на блок; труба має UA ≈34 Вт/К на 180 | 0 | 60–80 г на обидва блоки | отворів немає. **Критично:** банки комірок під різними потенціалами — лише ізолюючі прокладки, подвійна ізоляція. Займають зазор, де мав іти канал Г: містки вгорі й унизу, канал з боків |
| **Е** | O4, ESC на стоянці | вентилятор 25–30 мм 5 В у вхід каналу Б (вмикає FC до арму) або зовнішній у NACA до пуску | 1–2 л/с | бортовий ≤0,05 Н | 3–5 г | нічого в трубі |
| **Є** | батарея, мотор, ESC, XT90-S | **обмеження режиму + датчики**: NTC у кожен блок і на мотор, лог температури ESC, ривок 250 ≤3 хв при 35 °C, тривога на 55 °C | — | 0 | ≈5 г | 2 дроти через вільні контакти MPX8 |

**Сумарно:** А + Б + Г за верхньою межею коштують ≈0,85 Н на 180 км/год, тобто ≈−1,4 хв з 26. Реально приблизно вдвічі менше, бо виходи назад повертають частину імпульсу. Цього опору немає в CFD R07g.

> ❌ **Поправки перевірки до варіантів:**
> - **Б:** без кожуха не працює (розділ 3). ESC ставити в тісний друкований кожух з прохідним перерізом ≈2–3 см², O4 — перед ним. Геометрія NACA ~~15 × 12 мм, рампа 60 мм~~ → **≈27 × 7 мм, рампа ≈55 мм під ≈7°** (ширина/глибина 3–5). Площа та сама.
> - **Г:** модель тепловіддачі неявно потребує **≈8 г/с**, а не 4. Вхід 1 см² пропускає ≤6 г/с. При 4 г/с задній блок B2 дихає повітрям після B1 і при +35 °C доходить до **≈57 °C, а не 50**. Запас лише ≈3 К. При 8 г/с опір ≈0,4 Н, а не 0,2. Канал Г сам по собі слабший, ніж записано. Містки Д або комбінація Г + Д надійніші.

## 5. Шкідливе сусідство

**Хто кому заважає — простими словами:**
- **Компас** (маленький магнітний датчик усередині модуля GPS) чує магнітні поля. Йому шкодять постійні магніти (мотор, двигуни серв), струми в дротах, дроселі BEC і **сталь** (шпильки, гайки).
- **Сам GPS** (приймач супутників) чує радіо. Йому шкодять передавачі поруч (ELRS-телеметрія, відео), цифровий шум і метал над антеною.
- Тому «мотор біля GPS» — це насамперед проблема **компаса**, а «GPS біля BEC» — і магнітна, і радіошумова, але слабша.

| Пара | Чому | Серйозність | Зараз у R08 | Норма | Що зробити |
|---|---|---|---|---|---|
| **Компас ↔ сталеві шпильки й гайки в хвостовій пробці** | сталь концентрує поле Землі, спотворення міняється з курсом; помилка курсу ≈6–28° | високa | гайки 12,8 мм до GPS, 29 мм до центру | Matek: 10 см від заліза | **вимкнути компас**; якщо лишати — останні ≈150 мм шпильок і гайки з титану, латуні чи алюмінію |
| **Компас ↔ серви хвоста** | магніти двигунів + змінний струм до ≈1 А | висока | 11 мм | Matek 10 см, INAV ≥5 см | вимкнути компас; дроти серв скрутити й вести вперед |
| **GPS ↔ приймач ELRS з телеметрією** | 250 мВт за кілька мм «глушить» вхід GPS | висока | **9 мм** | INAV ≥5 см | приймач у задню частину конуса (x ≈1300–1340), антени назовні вниз і вбік, обмежити потужність телеметрії |
| **Антена O4 ↔ алюмінієва труба** | труба закриває пілота позаду-внизу на 5,8 ГГц | висока | антена на верху відсіку, труба за 50 мм | — | антену вивести **вниз або вбік, нижче осі труби** |
| **ESC ↔ O4 Lite** | тепло 43–65 Вт + шум комутації | висока | 14 мм | — | O4 першим у холодному потоці, перегородка, живлення 9 В — скручена пара |
| GPS ↔ край алюмінієвої труби | труба закриває небо попереду нижче ≈26° | середня | 5,7 мм від торця | — | GPS на 10–20 мм назад (і на 3–5 мм нижче) → ≈12–16° |
| GPS/компас ↔ PM12S-3 і FC | дроселі, імпульсні струми, ВЧ-шум | середня | ≈88 мм | 5–10 см | майже в нормі; вихідні дроти скрутити, ферит на кабель GPS |
| Антени ELRS ↔ труба і вуглець | тінь на 2,4 ГГц, вуглець розлаштовує | середня | місце антен не задане | — | одна вниз під конусом, друга вбік, поза вуглецем |
| ASPD-4525 ↔ PM і FC | нагрів → дрейф нуля швидкості | середня | 3–4 мм | — | ≥30 мм або в корінь крила; нуль калібрувати після прогріву |
| Барометр FC ↔ канал охолодження | тиск каналу міняється зі швидкістю → висота стрибає | середня | на шляху виходу Г-а | — | вихід Г-б через бокові отвори, або барометр під поролоном |
| Серви хвоста ↔ вихлоп батареї | +5–10 К, межа 65 °C | середня | на шляху виходу Ø20 | — | вихід Г-б |
| Батарея B1 ↔ ESC, XT90-S, гаряче повітря носа | тепло в трубу | середня | XT90-S впритул до B1 | — | глуха моторна плита, вихлоп носа назовні, 3–5 мм повітря між XT90-S і B1 |
| Батарея ↔ провід R+ у центрі | 12–15 Вт/м на 250 і старті | середня | по осі | — | 8 AWG або 2 × 10 AWG |
| Аналоговий Mauch і газ ESC ↔ 12S-шина в джгуті | наводки, петля землі → шумний струм | середня | сусідні контакти 4 і 5 поруч з 12S | ArduPilot: скручувати | кожен сигнал скрутити зі своїм GND, GND між сигналами в MPX8, RC-фільтр |
| Компас ↔ головний струм батареї | поле постійного струму | **низька** | 192 мм | 10 см | укладка співвісна (R+ по осі, комірки кільцем) гасить поле до 0,2–0,5 мкТл; лишити R+ по осі, перемичку в зоні вантажу скрутити з R+ |
| Mauch ↔ фазні дроти ESC | стороннє поле в Hall-датчику | низька | 1,3 мм над ESC | — | калібрувати на місці |
| Вантаж ↔ батарея | тепло | низька | 4 і 19 мм | — | диски пінопласту 5–10 мм, якщо вантаж чутливий |
| Сталеві шпильки ↔ алюмінієва труба | різне розширення (0,26 мм на 600 мм при 40 К), гальванічна корозія | низька | по всій довжині | — | пружні шайби, оцинковані або титанові шпильки, друковані втулки |
| GPS ↔ O4; ELRS ↔ O4 | радіошум | низька | ≈1,2 м, між ними труба | ≥5 см / 10–20 см | нічого |

**Примітка про брусок 2 × 3:** якщо блок стане бруском (розділ 2.4), R+ уже не йде по осі крізь кільце. Співвісного гасіння поля тоді немає, тож R+ і перемичку треба вести скрученою парою.

> ❌ **Поправки перевірки до сусідства:**
> - **Шпильки:** «6–28°» — це помилка **до калібрування**. Сталь, закріплена на корпусі, — класичне «м'яке залізо», і калібрування компаса компенсує більшу частину. Дешева заміна — шпильки з **нержавійки A2/A4** (майже немагнітна, μr ≈1–1,05). Вимкнення компаса лишається найпростішим.
> - **Брусок 2 × 3:** поле головного струму на компасі ≈0,6–3,4 мкТл, у ≈5 разів більше, ніж у кільця, але мало. Скрутка R+ з перемичкою це зміщення не прибирає. Компенсується параметром **COMPASS_MOTCT** за струмом з датчика Mauch.
> - Серви: постійні магніти — сталий зсув, калібрується. Змінний струм — ні.
> - **Пропущено:** гальванічна пара **вуглецевий джойнер ↔ алюмінієва труба й гільза**, якщо джойнер вуглецевий. Вона сильніша за сталь ↔ алюміній. Потрібні ізолююча втулка або плівка.
> - **Пропущено:** довгі силові дроти без конденсаторів біля ESC (розділ 3).
> - Друковані пробки в трубі розширюються на 0,14–0,21 мм на 40 К при зазорі 0,4 мм на радіус — ризик малий.

## 6. Що пропонується змінити в R08 (рішення Віктора, нічого не внесено)

1. **Компас вимкнути.** ArduPilot Plane: `COMPASS_ENABLE=0`, курс від GPS або GSF (`EK3_SRC1_YAW=8`). INAV fixed-wing компас не вимагає. Тоді можна взяти GPS без компаса.
2. **Приймач** у задню частину конуса, ≥50 мм від GPS; антени назовні. **GPS** на 10–20 мм назад.
3. **Ніс:** глуха моторна плита; пази капота ≥4,5 см²; NACA-канал Б з порядком O4 → перегородка → ESC → вихід назовні; алюмінієве вікно під ESC; усе з ASA.
4. **Антена O4** на низ або бік носа.
5. **R+** 8 AWG або 2 × 10 AWG.
6. **XT90-S** на 60–68 А перевищує номінал 40 А тривало (RS PRO), а не 45 А, як записано в R08. Для ривків довше 2–3 хв — роз'єм більшого класу. Між XT90-S і B1 — 3–5 мм повітря.
7. **ASPD** відсунути ≥30 мм від PM/FC.
8. **Батарея:** при +35 °C канал Г, містки Д або комбінація. Тримачі лише з PETG/ASA. Датчики NTC.
9. **Канал Г** — вихід через бокові отвори Ø8–10 біля x 1060–1080, не крізь хвіст. Кільце з прохідними отворами.
10. **Задній відсік** провітрити 1–2 малими отворами; барометр під поролон.
11. **На землі:** O4 у low-power режимі, вентилятор, живлення перед пуском, тінь.
12. **Сигнальні дроти** скрутити з GND, GND між сигналами в MPX8.

## 7. Що не перевірено (для окремого проходу)

- Внутрішнє розміщення комірок у Dogcom і Topwell (2 × 3) виведене з розмірів, продавці його не публікують. Бренд комірок невідомий; заявлені 10C і 90 А — дані продавців.
- Чи візьмуться німецькі збирачі за 2 бруски, ціна і строк. Ціни P50B/P60B у ЄС не перевірені.
- Кути пакета Tattu 12 Аг: якщо округлені радіусом ≈5 мм, він міг би стати. Треба виміряти.
- ККД ESC (94–97,5 %), тепловий опір мотора, втрати в залізі ((об/хв)^1,5 від Io), оберти гвинта на режимах — оцінки.
- Струм старту 55–65 А і тривалість ривку 250 — оцінки, не виміри.
- Межа 100 °C і «Edge Lite для екстремального потоку» — з пошукових фрагментів castlecreations.com, сторінка обрізалась.
- O4 Lite: 70 °C за 60 с і вимкнення — з oscarliang.com; 2,5 хв на землі — DJI FAQ.
- Теплові містки 0,3–0,6 К/Вт і маса 30–40 г на блок — без прототипу.
- Магнетизм: μr сталі шпильок 100–500, місце гайок за пробкою, поле Землі ≈21 мкТл, схема перемичок у блоці — оцінки.
- Тінь антен від труби, правила λ/4 від металу й вуглецю — без джерела.
- Опір охолодження (m·V) — верхня межа; опір пазів на обтіканні не пораховано.
- Номінал XT90-S: 40 А тривало (RS PRO) проти 45 А (rotorama, R08). Розбіжність між джерелами.

## 9. Перевірка (2026-10-04)

Окремий прохід, 2 агенти, лише читання. Кожне число перераховано власними скриптами, веб-сторінки відкрито заново.

**Підтверджено:**
- Межі перерізу: квадрат 46,2 мм уздовж осей / 53,0 мм під 45°. Пари W × H — з точністю до округлення, деякі рівно на межі зазору 1,8 мм.
- 1 + 6 стає за будь-якого кута. 3 × 3 і 2 × 4 комірок 21700 не стають.
- 14 сторінок пакетів (Dogcom, Tattu, Gens Ace, Amprius, ZOHD, Auline, GNB, MaxAmps, WREKD, Topwell): розміри, маси, струми, ціни, наявність. Keeppower не відкрився (блок мережі).
- Molicel P60B за даташитом: 6 Аг / 21,6 Вт·год, ≤75 г, Ø21,35 × 70,13, 60 А стандартно / 100 А максимум, 12,8 мОм. Таблиця 2.3 відтворюється до сотих.
- Німецькі збирачі існують і роблять пакети за кресленням. AkkuPlus прямо продає P50B і варить поштучно.
- Струм на 180 км/год 25–26 А; втрати мотора, батареї й ESC (за прийнятими ККД) відтворюються. Закритий пакет 48 / 63 °C, 6,3 К/хв на 250 — за тією самою моделлю (див. поправку про випромінювання).
- Опір охолодження m·V: 0,38 / 0,27 / 0,20 Н.
- Співвісне гасіння поля в кільці: 0,23–0,60 мкТл.
- Дослівно підтверджено:
  - Castle: «Controller temperature must never exceed 100C»; Edge Lite «for applications with extreme air-flow».
  - Matek M10Q-5883: компас 10 см від заліза й силових дротів; −20…80 °C.
  - INAV: GPS ≥5 см від джерел завад, зокрема приймача з телеметрією.
  - ArduPilot Plane: `COMPASS_ENABLE=0`, `EK3_SRC1_YAW=8` (GSF).
  - INAV fixed-wing: компас опційний (з 8.0 дає лише бонус у RTH і dead-reckoning).
- XT90-S: RS PRO — 40 А тривало, rotorama — 45 А. Обидва числа реальні, обидва нижчі за 60–68 А. Те саме стосується XT90 у кільці.

**Виправлено** — позначено ❌ у розділах 1–5. Головне:
- брусок 2 × 3 — лише під кутом, лоток зі шпонкою;
- ESC — лише з тісним кожухом, перегрівається й на 88 км/год без нього;
- старт на повному газі 80–95 А;
- 250 км/год — лише на свіжому пакеті;
- канал Г потребує ≈8 г/с і дає B2 ≈57 °C при +35 °C;
- закритий пакет ≈58–60 °C, а не 63;
- конденсатори біля ESC;
- NACA 27 × 7 мм;
- шпильки калібруються, A2/A4 як дешева заміна;
- гальванічна пара вуглецевий джойнер ↔ алюміній.

Скрипти перевірки: scratchpad `r10/verify`.

## 8. Джерела

- Topwell 6S3P: https://www.topwellpower.com/products/6s3p-216v-15000mah-li-ion-battery-pack-for-agricultural-drone
- Dogcom 6S2P (fpv24): https://www.fpv24.com/de/dogcom/dogcom-batterie-10000mah-222v-6s2p-10c-li-ion-akku-xt90-plug · Dogcom 6S1P: https://dogcombattery.com/products/dogcom-21700-li-ion-battery-4000mah-6s1p-222v-is-designed-for-long-range-pilots
- Tattu напівтвердотільні: https://www.tattuworld.com/products/tattu-380wh-kg-12000mah-6s1p-22-2v-10c-semi-solid-state-uav-lipo-battery.html · https://www.tattuworld.com/products/tattu-300wh-kg-17000mah-6s1p-22-2v-10c-semi-solid-state-uav-lipo-battery.html
- Gens Ace 6S 5000: https://gensace.de/products/gens-ace-g-tech-5000mah-22-2v-60c-6s1p-xt90-lipo-battery-pack
- Tattu 6S 8000: https://www.grepow.com/uav-battery/tattu-g-tech-6s-8000mah-22-2v-25c-lipo-drone-battery.html · Tattu 12S 10000: https://genstattu.com/ta-30c-10000-12s1p-as150u.html
- Amprius GREEN 6S3P: https://www.upgradeenergytech.com/products/green-6s3p-12000mah-ampruis-sa10
- ZOHD Lionpack: https://www.readymaderc.com/products/details/zohd-liion-pack-5000-4s1p
- Keeppower 6S2P: https://keeppower.com/product/keeppower-6s2p-21-6v-22-2v-21700-10000mah-fpv-drone-and-uav-high-power-li-ion-battery-pack-with-amass-xt90s-f-connector/
- Auline S70: https://www.au-line.com/products/21700-s70-9000mah-6s2p-22-2v-140a-xt60 · GNB: https://www.rotorama.com/product/gnb-liion-8000mah-6s2p-10c
- MaxAmps 12S: https://maxamps.com/collections/12s-43-2v-li-ion · WREKD P50B: https://wrekd.com/products/6s1p-21-6v-molicel-p50b-5000mah-li-ion-battery-pack
- Збирачі: https://akkuplus.de/Akku-und-Batteriepacks-Konfektionierung · https://www.akkukaufhaus.de/Wunschakku/
- Molicel P45B / P50B даташити (опір 15 мОм DC, межа 60 °C): https://www.molicel.com/inr-21700-p45b/ · https://www.molicel.com/wp-content/uploads/Product-Data-Sheet-of-INR-21700-P50B-80122.pdf
- Scorpion (провід 180 °C): scorpionsystem.com · Matek M10Q-5883 (10 см від заліза, −20…80 °C): mateksys.com · KST X10 (−10…65 °C): kstservos.com
- INAV GPS-and-Compass-setup (≥5 см) · ArduPilot common-compassless, common-magnetic-interference: ardupilot.org
- O4 Lite нагрів: https://oscarliang.com/dji-o4-air-unit-lite/ · DJI FAQ
- Температури друку: CNC Kitchen
