NetHunter123/Jflyproject/configs/gungnear-v1-light/Gungnear v1 light.md

---
tags:
  - project
  - engineering
  - gungnear
config: gungnear-v1-light
status: ❄️ заморожена конфігурація (2026-09-25)
---

# Gungnear v1 light

> Базова конфігурація **без шасі**, запуск із катапульти. Числа перевірено в [[R07b-Masa-Nutzlast]] (розділ R07b-V).
> CAD: `gungnear-v1-light.step` у цій папці. Генератор: `CAD/model1.py --no-gear` (`CAD/model1b_nogear.step`).
> GitHub (приватний): `NetHunter123/gungnear`, тег `gungnear-v1-light`.

![[gungnear-r07b-model1b-nogear.png]]

> Цю конфігурацію не будуємо. Труба проєкту вирішена пізніше: [[R07f-Fertigrohr]]. Шлях до неї — [[R07e-Rumpf-Material]] в архіві.

> 🔎 **[[R07e-Rumpf-Material]] (перевірено 2026-09-26):** для light папір + скло з люком батареї **на межі або нижче** (MS −0,36 з неперевіреною силою на хвості; ≈ −0,01 без неї). Рішення — **1 шар карбону замість скла** (маса та сама, MS +0,66) або скло + 4 стрічки 1×5 (+23 г). Потрібні щоки рами крила (зминання під гільзою джойнера 7,9 МПа у папері). Klima Ø75 зараз не продається.

## Геометрія

| | |
|---|---|
| Довжина з коком | 898,5 мм (корпус 900) |
| Розмах × хорда | 1224,7 × 204,1 мм, прямокутне, AR 6 |
| Площа крила | 0,25 м² |
| Профіль | MH 32 (8,7 %), установка +2°, V 2°, середньоплан |
| Крило на фюзеляжі | передня кромка x 304, c/4 x 355, лонжерон / джойнер x 361 мм |
| Фюзеляж | паперова труба Ø75 / 72,6 × **639 мм** (x 120–759) + друкований ніс 120 мм (ожива, кок Ø57) + друкований S-конус 141 мм до Ø30 |
| Стабілізатор | 470 × 118 мм, NACA 0009, 0° (V_H 0,49) |
| Кіль | хорди 150 / 100 мм, висота 190 мм (V_V 0,035) |
| Висота | 257,5 мм |
| Шасі | немає |

## Силова установка (стандарт, зафіксовано Віктором)

- Мотор 1,5–2 кВт, ~380–420 kV, 12S (реальна маса ≈380 г).
- Гвинт APC 11×14, фіксований, тягнучий.
- ESC 80 A HV — у спинному обтічнику над носом.
- Батарея 12S3P Molicel P45B, 583 Вт·год, 2,63 кг, два блоки 6S3P: x 136–350 і 372–586.

## Маса й центрування

| | |
|---|---|
| **Готовий до польоту** | **≈5,07 кг (4,4–6,0)** |
| Навантаження на крило | ≈20 кг/м² |
| ЦМ | ≈358 мм (26 % САХ) |
| Нейтральна точка | ≈376–394 мм |
| Межі ЦМ | 345–365 мм |

## Льотні характеристики (розрахунок)

| | |
|---|---|
| Зрив (CL_max ≈1,0) | ≈65 км/год |
| Найдовший політ | ≈155–160 хв (≈120–190) на ≈78 км/год |
| 250 км/год | ≈1,5 кВт на валу |
| Схід із катапульти | ≈21,6 м/с, ≈1,2 кДж |
| Вантаж усередині | ≈0,2 кг без баласту, ≈0,45 кг максимум (корма Ø64 × 140 мм) |

## Не вирішено (див. R07a / R07b)

- Подовження крила, довжина фюзеляжу, профіль — блокери R07a.
- Лонжерон і труба не пораховані на міцність.
- Посадка відкладена.
