NetHunter123/Jflyproject/Kontekst-chativ.md

---
tags:
  - project
  - gungnear
updated: 2026-10-03
---

# Контекст чатів розробки

Зведення п’яти чатів (28.09–01.10). Числа CFD лишаються в [[R07g-GN+-CFD]]. Тут те, що вирішували в розмові.

## Що це за літак

Відкритий гвинт, труба як фюзеляж, без каналу і без шасі. Канал, імпелер, саморобний кожух і гібрид відхилені. Модульні відрізки труби — окрема ідея на потім, у цю збірку не входить, поки Віктор сам не скаже.

Робочий апарат — **light+**. Light і V30 не ведемо. Метрика — час у повітрі. Стеля 250 км/год не тримається на 2 кВт; форму через це не міняли.

## Збірка, як її зафіксували

- Ринва Ø80, суцільна, без люків, без заклепок. У магазині (toom/OBI) на полиці саме 80 мм, не 76. Циліндр близько 1110 мм, увесь літак 1371 мм.
- Зварювання немає і не планується: інструментів немає.
- Два друковані стовбури з торців. Кришки на 4 шпильках з кільця біля джойнера. Шпильки фіксувати в кільці, дві четвірки, не одна на всю довжину. Хрест під 45°.
- Шкіра кришок врівень, пробка всередині. Ніс 20 мм, хвіст 25 мм. Довша пробка з’їдає батарею.
- Тягу несе моторна пластина, не тонка стінка носа. Гвинт на рідному валу. Кок крутиться з гвинтом (до x=33 мм), капот з x=39 мм, щілина 6 мм. Надставку вала на 6 см відкинуто.
- Комірки — клас 21700, 12S3P, не прив’язані до Tenpower 40TG. У розрахунку середина ринку, близько 2,7 кг і 580 Вт·год. Приклад Віктора був ≈2,6 кг.
- Зліт — катапульта. З руки не злітає.
- Джойнер Ø16 для навантаження не завеликий. У MH 32 він не влазив у товщину крила. У Clark Y висота ≈26 мм, місце є.

## Крило і хвіст

- Зараз **Clark Y**, бо плоский низ простіше зробити. NACA 4412 — наступний: кращий біля зриву, важчий у виготовленні. На 180 км/год обидва близько −4 хв проти MH 32 (до CFD).
- Стабілізатор і кіль — **NACA 0009**, симетричні, установка 0°. Сидять на знімному конусі. Чи друкуються разом із конусом, чи окремо — не вирішено. У CAD злиті. Кіль зсунутий назад на 5,6 мм, щоб корінь сів на конус.
- Матеріал і спосіб крила відкриті.

## Охолодження — не вирішено

Глухий капот мотор перегріє. Голий мотор холодніший, але бруднить ніс. Щілина за коком і чотири бічні пази — варіант у моделі, не рішення. Довгий хід «ніс → вся труба → хвіст» гріє батарею повітрям після мотора.

01.10, слова Віктора: охолодження робити **разом із начинкою**, не дірками в уже зібраній укладці. Ідея, не рішення: окремі канали в зазорі між стовбуром і стінкою, вихід у хвіст; свій шлях від мотора, свій для батареї і плат. «Димар» у горизонтальній трубі не працює: перепад від висоти Ø80 мізерний, потік дають гвинт і швидкість. Дірок у трубі не свердлити, поки шлях не вибраний.

## CFD, простими словами

Форму прийнято 01.10 з винятком: на 2 кВт (вал) виходить близько 235–238 км/год, не 250. Віктор сказав, що цей результат наразі влаштовує.

На звичайних 180 км/год потік тримається літака. Зворотна течія на α −3° — 29 см² півмоделі, сила +0,007 Н. Зайвий опір це не пояснює. Слабке місце в сітці на тонкому передньому краї, тож «2,3 кВт» може бути песимістичним. Сказати, що в повітрі на 250 км/год потужності точно вистачить, не можна: гвинт, щілини й охолодження додадуть опір, якого в рахунку немає.

Нових продувок поки не треба. Лишилось 5 запусків із 10. Тиск для охолодження із записаних результатів не знятий.

SimScale, проєкт «Model 1», симуляція Incompressible 2: https://www.simscale.com/workbench/?pid=6964947354939215330

## Onshape, де зупинились увечері 01.10

Модель залили в інший акаунт, ніж публічний GN+. Робочий документ: https://cad.onshape.com/documents/5a8118881f4951e4960dce78

Імпорт `GN+_onshape.step` сів окремими тілами. Z вгору. Труба від x=120 до x=1230, Ø80.

Зроблено кільце окремою деталлю: зовні Ø77,8, довжина 24 мм, центр на джойнері. Вісім глухих отворів Ø2,5×8 мм під різьбу М3, коло Ø72, хрест 45°. Між зустрічними отворами 8 мм тіла, шпилька має упор. Різьба не нарізана. Роз’ємів немає: розміру немає.

Стовбур Віктор сказав поки не чіпати. Чорнову укладку з кільцем розклали без труби. ESC Castle Phoenix Edge HV 80 (72×51×23 мм, еталон класу, не обов’язкова покупка) **у трубу не влазить**: лежить на зовнішній шкірі. Польотник Matek H743-WING бере лише до 8S, на 12S потрібен окремий BEC. Батарея в моделі — 36 комірок, два блоки по 18, у перерізі 6 штук кільцем без центральної, обрис близько Ø64 у конверті Ø70.

Наступний крок того вечора: Віктор шукає точні розміри куплених речей (мотор, BEC, GPS, приймач, датчик, серво, маточина гвинта). Поки їх немає, конверти не замінювати.

Ключі Onshape в цю нотатку не переносяться.
