NetHunter123/Jflyproject/proj. Gungnear.md

---
tags:
  - project
  - engineering
status: 🔧 зовнішня форма прийнята, далі фюзеляж
ziel: зібрати light+ до зваженого апарата з центром мас у коробці
updated: 2026-10-03
---

# proj. Gungnear

Будуємо **light+**. Відкритий гвинт, без каналу і без шасі. Метрика — час у повітрі. Стеля швидкості ~~250 км/год~~ ❌ CFD 01.10: на 2 кВт (вал) ≈235–238 км/год; рівно 250 потребує ≈2,3–2,4 кВт (R07g, розд. 10–12). Ривок на 344 км/год скасовано.

> [!note] Робочий літак (рішення 2026-09-28, порядок 2026-09-29)
> Труба — **алюмінієвий водостік Ø80**, суцільна, **без люків**. Шкіра кришок врівень. Пробки: ніс 20 мм, хвіст 25 мм. Охолодження мотора і батареї **не вирішене** — [[Zbirka-shpilky]]. Отвір лише під джойнер крила, з втулкою. Начинка — два друковані стовбури: передній через знімний ніс, задній через знімний хвостовий конус (на ньому стабілізатор і кіль). Кришки тримають 4 шпильки з розпірного кільця біля джойнера. Комірка не фіксована: клас 21700, 12S3P, у розрахунку ≈2,7 кг і ≈580 Вт·год.
>
> **Порядок, що лишилось (2026-10-01).** Зовнішня форма прийнята. Light і планер на 8 кг не ведемо.
> 1. **Фюзеляж у металі.** Ринва Ø80, гільза джойнера, кільце, 4 шпильки, ніс і хвіст. Перед різкою закрити суперечності: пробка носа 20 мм не влазить у 16 мм до батареї; шпилька на r=36 заходить на пакет Ø70; текст про батарею досі рахує Ø76.
> 2. **Начинка разом з охолодженням.** Два стовбури. Окремий короткий хід повітря від мотора, окремий для батареї і плат до виходу в хвіст. Шлях ще не вибраний, дірки в трубі не свердлити до того.
> 3. **Крило.** Матеріал і спосіб виготовлення відкриті. Зараз Clark Y. NACA 4412 — коли дійдемо до заміни. Елерони додати (рішення 2026-10-03): два на задній кромці, дві сервоприводи в товстій частині крила, петлі, кабанчики, тяги всередині. Закрилки не повертаємо. У CFD їх ще немає.
> 4. **Хвіст на конусі.** Стабілізатор, кіль, серво, тяги. У CAD кіль зсунутий на 5,6 мм без потреби — прибрати, коли робитимемо хвіст.
> 5. **Мотор, гвинт, батарея, авіоніка** за вже записаним стандартом. Нічого з цього ще не зважене.
>    ➕ 2026-10-03: підібрано всі моделі з розмірами й зроблено розклад — [[R08-Elektronik]] (перевірка ще попереду). Рішення: 4 серви без закрилків, FPV на борту. Варіант A (ніс +92 мм під ESC) дає ЦМ 584,8 мм без баласту. Знайдено: щілина 6 мм за коком не пропускає гвинт, антени мусять стояти поза алюмінієм. Суперечності з пункту 1 (пробка носа, шпилька і пакет Ø70) закриті там.
> 6. **Зважити зібране** і перевірити центр мас у коробці 575–596 мм. Міцність суцільної ринви ще не порахована: старі числа були про папір з люками.

Посадку і правила польотів Віктор тримає поза розробкою (2026-09-26). Довідка про правила лежить в архіві, у [[R07d-8kg-160kmh]].

## Де що лежить

| | |
|---|---|
| Збірка і шпильки | [[Zbirka-shpilky]] |
| Труба, яку купувати | [[R07f-Fertigrohr]] — ринва Ø76 / Ø80 × 0,7, toom/OBI |
| Числа польоту і маси | [[R07c-Light-Plus]] — ще на MH 32, під Clark Y не перераховані |
| Модель для CFD | [[GN+]], файли `CAD/GN+.step` |
| Стан симуляції | [[R07g-GN+-CFD]] |
| Електроніка, розміри, розклад | [[R08-Elektronik]], генератор `CAD/gn_layout.py` |
| Готові батареї, нагрів, охолодження, шкідливе сусідство | [[R09-Akku-Waerme]] (2026-10-04, перевірено) |

CFD зовнішньої форми дорахований (A, B, F) і 01.10 прийнятий **рішенням Віктора з винятком**: поріг 2 кВт на 250 км/год спрацював. Кіль тримає, запас стійкості 14–16 % з гвинтом, катапульта 23,2–23,7 м/с. На 180 км/год поправлений опір 15,3 Н → **≈26 хв** (книга R07c — 33). Поріг 16 Н пройдено номінально, але в межах похибки сітки не вирішено. 2 кВт на валу вистачає приблизно до ~~**238 км/год**~~ **≈235–238 км/год**; на рівно 250 виходить 2,3–2,4 кВт. Форму через це не міняємо. Числа в [[R07g-GN+-CFD]], розділ 10. Перевірка 01.10 — розділ 12: числа підтверджені, надлишок опору ймовірно здебільшого чисельний, тиск для охолодження ще не отримано.

## Крило

Зараз у моделі **Clark Y**: його простіше виготовити. Коли дійдемо до заміни — **NACA 4412**. Матеріал і спосіб виготовлення крила відкриті.

Елерони — рішення 2026-10-03. Два рулі на задній кромці і дві сервоприводи в крилі. У продувці крило ще суцільне: щілину в `GN+.step` не різали. На рівному польоті рулі стоять на нулі, тож старі сили лишаються базою.

Оцінка на 180 км/год (2026-09-29, не рішення). База light+ з вантажем: **33 хв** при опорі 11,9 Н на MH 32. Заміна профілю міняє лише опір крила і довантаження хвоста. Поляри XFOIL, гладке крило, Re ≈ 7,5·10⁵:

| Профіль | Хвилини на 180 км/год |
|---|---|
| MH 32 | **33** (база) |
| Eppler 205 | ≈ −2 хв |
| NACA 4412 | ≈ −4 хв |
| Clark Y | ≈ −4 хв |

Шорстке крило зменшить розрив. Найдовший політ (близько 88 км/год) тут не перерахований.

❌ Таблицю вище для Clark Y перекрито CFD 01.10 ([[R07g-GN+-CFD]]): на 180 км/год **≈26 хв**, тобто ≈ −7 хв, а не −4 (весь літак, D_льот 15,3 Н; маса й ЦМ ще з R07c).

## Конфігурації

| | Що це | Де |
|---|---|---|
| **v1 light+** | Те, що будуємо. Корпус 1371 мм, крило 0,30 м², Clark Y, ≈7,75 кг | [[Gungnear v1 light+]] |
| v1 light | Заморожена. Без вантажу, ≈5 кг. Не ведемо | [[Gungnear v1 light]] |
| 8 кг на 160 км/год | Закрите бічне питання. V30 ≈20 кг; V60 під 25 кг лише на 130 км/год | [[R07d-8kg-160kmh]] |

Гвинт обрано 2026-09-23: звичайний мотор і відкритий гвинт. Імпелер програє за потужністю, часом і ККД. Ціна рішення: у гвинта немає контейнменту.

Закриті етапи R00–R07e, старий CFD і перший план GN+ — в [[_Archiv/_README|_Archiv]].
