NetHunter123/Jflyproject/R07c-Light-Plus.md

---
tags:
  - project
  - engineering
  - gungnear
etappe: R07c
status: 🔍 перевірено (R07c-V) — основне вистояло; маса +60 г, конструкцію перераховано, поправки внесено видимо
updated: 2026-09-25
---

# R07c — Gungnear v1 light+: +2 кг вантажу, крейсер ~180 км/год

> ⚠️ **ДОСЛІДНИЦЬКИЙ прохід** (1 агент, порція 1 з 2). Жодна маса **не зважена**, жодна міцність **не порахована** — усе розрахунок від перевіреного списку мас [[R07b-Masa-Nutzlast]] (R07b-V) і розкладу опору [[R07a-3D-Modell-CFD]] (R07a-V2).
![[gungnear-r07c-v1-light-plus.png]]

> **Завдання Віктора від 2026-09-25:** +2 кг щільного вантажу (~1 л на 1–1,5 кг), крейсер ~180 км/год, фюзеляж можна подовжити. Мотор і гвинт — стандартні (1,5–2 кВт, ~380–420 kV, 12S, APC 11×14). Посадку не розглядаємо.

---

> [!warning] ❓ МАТЕРІАЛ ФЮЗЕЛЯЖУ ПЕРЕГЛЯДАЄТЬСЯ (2026-09-25 → досліджено 2026-09-26)
> Паперова труба Klima — це **спірально-намотана картонна труба для моделей ракет** (Raketenmodellbau Klima, Ø75 / 72,6 мм, 120 г на 500 мм). Її вибрав [[R04-Rumpfform]] як найлегший дешевий Ø75: карбонової труби такого діаметра у двох німецьких магазинах не знайшли, а HT/ПВХ-трубу DN75 відкинули як у ~2,5 раза важчу. Жорсткість мала давати сама стінка труби + 1 шар склотканини + друковані шпангоути. Аудит [[R05-Fluegel-Hardware]] уже тоді показав, що папір м'якший, ніж думали (E 1–1,5 ГПа), а [[R07c-Light-Plus]] (R07c-V) — що з люками вона **не тримає**.
> **Віктор планував каналізаційну / ПВХ-трубу.** **Результат [[R07e-Rumpf-Material]] (перевірено 2026-09-26):** сіра HT-труба — це поліпропілен (м'який, епоксидкою не клеїться), справжній ПВХ-U 75×2,3 — +0,4 кг на light+, руда KG DN110 — +0,85–1,05 кг → **для корпусу ні**; вони годяться як **оправка** для викладки. Прохідні варіанти: **карбон замість скла + стрічки + силові кришки** (маса та сама) або **саморобна карбонова / склопластикова труба на HT-оправці + стрічки** (light+ −0,19…−0,26 кг). Klima Ø75 зараз не продається (заміна — LOC 3.00", Ø78,7). **➕ [[R07f-Fertigrohr]] (перевірено 2026-09-26), бо ламінувати зараз не можна:** найкраща **готова** труба — **алюмінієва водостічна Ø76 / Ø80 × 0,7 «natur», зварна** (toom/OBI ≈22 € за 2 м), з крайовими карбоновими стрічками на люках; light+ +40 г (знімний ніс + 1 люк), light +93 г. **Остаточний вибір матеріалу — за Віктором.**

## 0. Яку крейсерську швидкість закладено досі

**Фіксованої крейсерської швидкості в проєкті не було.** Головна метрика з 2026-09-24 — час у повітрі: найдовший політ light ≈155–160 хв на ≈78 км/год. 200 км/год — довідковий крейсер із [[R04-Cruise-Payload]], 250 км/год — максимум.

**Light (5,07 кг) на 180 км/год:** опір ≈10 Н, ≈0,6 кВт на валу, ≈0,7 кВт з батареї, ≈16 А на 12S, ≈40 хв, ≈113–119 км. Стандартний мотор і APC 11×14 тягнуть це з великим запасом: ≈9 400 з 17 273 об/хв.

---

## 1. Ідея компонування

- Лонжерон і джойнер крила мусять стояти біля центру мас. Тому один суцільний вантаж на ЦМ не покласти — його перетинає гільза джойнера.
- **Рішення:** розрізати фюзеляж по зазору джойнера (між двома блоками батареї) і вставити відсік **456 мм**. Вантаж — **дві камери Ø66 × 220 мм по 1 кг (разом 1,5 л)** симетрично спереду й ззаду джойнера (±125 мм).
- Центр вантажу = джойнер = ЦМ → **відсік CG-нейтральний за конструкцією**, з вантажем і без баласт не потрібен.
- Щоб порожній апарат центрувався точно на джойнер: **авіоніку (FC/GPS/приймач/BEC, 96 г) перенесено з носа (x 240) у корму**, задній блок батареї відсунуто на 15-мм розпірку. Без перенесення корпус +50–60 мм, з подовженням хвоста замість цього — +200–340 мм.
- Переріз камери Ø66 (не Ø72,6): під камерою потрібен кабельний канал ≤ 6 мм для силових дротів заднього блоку (2 × 10 AWG) і дротів серв.

## 2. Станції (x від носа, мм)

| Зона | x, мм | Примітка |
|---|---|---|
| Ніс, кок, мотор, фаєрвол | 0–120 | без змін (мотор 88, гвинт 48, фаєрвол 117) |
| Передній блок 6S3P | 136–350,25 | без змін |
| Перегородка 1 | 350,25–353,25 | упор батареї на трубу, не на джойнер (R07b-V) |
| **Передня камера** | 354,25–574,25 | Ø66 × 220, 1 кг, центр 464,25 |
| Перегородка 2 | 575,25–578,25 | |
| **Зона джойнера / рама крила** | 578,25–600,25 | джойнер **Ø16** на x 589,25. Якщо гільза не влізе в 22 мм — зона 26 мм, усе позаду +4 мм |
| Перегородка 3 | 600,25–603,25 | |
| **Задня камера** | 604,25–824,25 | Ø66 × 220, 1 кг, центр 714,25 |
| Перегородка 4 + розпірка-упор | 825,25–843,26 | 3 + 15 мм; регулювання ±15 мм = ЦМ ±3,5 мм |
| Задній блок 6S3P | 843,26–1057,51 | центр 950,4 (у light 479) |
| Кормовий відсік | 1057,5–1230,3 | серви хвоста x ≈1142, авіоніка x ≈1132 |
| ESC 80 A HV | x ≈140–190 | спинний обтічник над носом, як у light (L1c) |
| Гак катапульти | ~~x ≈558~~ **x 578–600** | ❌ ВИПРАВЛЕНО R07c-V: x 558 — це вже під передньою камерою; гак має стояти на рамі крила |
| Хвостовий конус | 1230,3–1371,3 | та сама S-крива Ø75 → Ø30 |

**Труба Klima Ø75 / 72,6:** x 120–1230,3 = **1110,3 мм**, шматки 469 + 500 + 141 мм. Стики — у рамі крила (x 589) і в кормі (x ≈1089). У зону батареї муфту не ставити: її внутрішній Ø70,2 заважає пакету.

**Люки:** 2 над блоками батареї + 2 над камерами (x ≈353–576 і 603–826). Камеру вздовж труби не вставити (гільза джойнера), тож люк має бути з хордою 66 мм — **дуга ≈131°**. Рамки вуглецеві, замки мають нести розтяг.

## 3. Геометрія: light → light+

| Параметр | light | **light+** |
|---|---|---|
| Корпус (ніс → дно конуса) | 900 мм | **1371,3 мм** |
| Площа крила | 0,25 м² | **0,30 м²** |
| Розмах × хорда (AR 6) | 1224,7 × 204,1 | **1341,6 × 223,6 мм** |
| Передня кромка / c/4 | 304 / 355 | **527,8 / 583,7** |
| Лонжерон / джойнер | x 361, Ø14 | **x 589,25 (27,5 % хорди), Ø16**, полиці ≈7,5 мм² (було ≈4,8) |
| Профіль, установка, V | MH 32, +2°, 2° | без змін |
| Стабілізатор | 470 × 118 (0,0555 м²) | **432,5 × 108,7 (0,0470 м²)**, LE 1257,6, TE 1366,3 |
| Плече стабілізатора | 451,5 мм (2,2 САХ) | **701 мм (3,1 САХ)** |
| Кіль | 150 / 100 × 190 (0,0238 м²) | **137,6 / 91,7 × 174,3 (0,0200 м²)**, LE кореня 1228,7 |
| V_H / V_V | 0,491 / 0,0345 | ті самі |
| Висота | 257,5 | 241,8 мм |
| Змочена площа | 0,820 м² | 1,0075 м² |

**Константи для `CAD/model1.py`:** X_CONE_START 1230.26, X_BASE 1371.26, WING_AREA 0.30e6, X_WING_C4 583.73, X_TAIL_TE 1366.26, HT_SPAN 432.45, HT_CHORD 108.65, VT_ROOT_LE 1228.68, VT_TIP_Z 204.26, VT_TIP_LE 1274.54. CAD зібрано й перевірено: одне валідне тіло, довжина 1371,3, розмах 1341,6.

## 4. Маса

| Зміна проти light | Δ, г |
|---|---|
| Паперова труба +471 мм | +113 |
| Склообшивка труби | +33 |
| Покриття фюзеляжу | +15 |
| Другий стик труби (муфта) | +34 (0–34) |
| 4 перегородки відсіку | +24 (16–36) |
| 2 люки вантажу з рамками й замками | +40 (25–60) |
| Ложемент, канал, фіксатори | +50 (25–80) |
| Проводка: 2 × 10 AWG через відсік + подовжувачі серв | +60 (45–75) |
| 4 вуглецеві стрічки-лонжерони відсіку | +35 (20–60) |
| Кільце-шпангоут | +8 |
| Клей, дрібниці | +15 |
| Запас на ріст маси нових вузлів | +50 (0–100) |
| Крило 0,25 → 0,30 м²: обшивка й серцевина | +78 |
| Лонжерон під 7,7 кг | +40 |
| Джойнер Ø14 → Ø16 | +28 |
| Покриття крила | +13 |
| Стабілізатор, кіль, їх покриття (менші) | −16 |
| Авіоніка, задній блок, серви хвоста | 0 (лише переміщення) |
| ➕ R07c-V: другий люк батареї (рамка, замки) | +10 (5–20) |
| ➕ R07c-V: проводка після перенесення авіоніки (сигнал до ESC ~1 м, живлення 12S до BEC ~1 м, серви, трубки ПВТ) | +20 (10–40) |
| ➕ R07c-V: щоки рами крила (їх вимагає розділ 8) | +15 (5–30) |
| ➕ R07c-V: лижа на довше черево (710 → 1180 мм) | +15 (0–33) |
| **Разом конструкція** | ~~+620~~ **≈+680** |
| Вантаж | +2 000 |

- ~~**Порожній ≈5,69 кг** (4,8–6,8)~~ ❌ ВИПРАВЛЕНО R07c-V: **порожній ≈5,75 кг (4,82–6,97)**, на ≈0,68 кг важчий за light.
- ~~**З вантажем ≈7,69 кг** (6,8–8,8)~~ ❌ ВИПРАВЛЕНО R07c-V: **з вантажем ≈7,75 кг (6,82–8,97)**. Навантаження на крило ≈25,8 кг/м² (light 20,3).
- Якщо вантажу потрібні окремі капсули — ще +0,10–0,15 кг. Якщо кришки люків мають бути силовими (див. розділ 8, кручення) — ще +0,02–0,04 кг.
- Друга муфта в моделі маси стояла на x 469, а стик — на x 589 (ЦМ +0,7 мм). Нижня межа «0 г» суперечить нарізці 469 + 500 + 141 — муфта потрібна.

## 5. Центрування й стійкість

- ~~**ЦМ 589,2 мм = 27,5 % САХ — і порожнім, і з 2 кг.**~~ ❌ ВИПРАВЛЕНО R07c-V (з доданими масами): **ЦМ порожнього ≈591 мм (578–598), з вантажем ≈590,6 (581–596)** — вантаж і далі майже не зсуває ЦМ. Зсув центру вантажу на ±15 мм → ЦМ ±3,9 мм.
- **Нейтральна точка ≈618 мм** (613–627): VLM 634,8, поправки на фюзеляж −4,4, гвинт −5,6, ефективність хвоста −6,4. Та сама методика дає для light 385 (R07b-V).
- ~~**Запас стійкості ≈13 %** (10,7–16,8)~~ ❌ ВИПРАВЛЕНО R07c-V: **≈12,2–12,4 % (9,8–16,1)**; у light 13,7 %. NP 618 перевірено незалежно (VLM 634,8, підручникова оцінка 625–635) — стоїть.
- **Межі ЦМ ≈575–596 мм**, перші польоти 583–590 (та сама смуга запасу 9,8–19,6 %, що дала 345–365 для light).
- Через розкид мас ЦМ порожнього може вийти ~~577–595~~ **578–598** мм. На збірці виставити **589 ± 3 мм** розпіркою заднього блоку або баластом. ➕ R07c-V: розпірка ±15 мм дає лише ±3,5 мм ЦМ — у важкому випадку потрібно **≈130 г баласту в носі**.
- ⚠️ **Вантаж лише в одній камері зсуває ЦМ на ±18,7 мм (570 / 608) — поза межами.** Ззаду лишається запас лише ≈4 % (R07c-V: ЦМ ≈609). **Возити тільки дві рівні половини** або класти в порожню камеру муляж такої самої маси.
- Плече хвоста 701 мм проти 451 — демпфування тангажу краще.

## 6. Льотні характеристики

Методика: опір — розклад R07a-V2 по вузлах × 1,378 + обтічник ESC, перераховано за площами, Re і видовженням. Для light модель відтворює перевірені 157 хв і ≈1,42 кВт на 250 км/год. Крейсер — APC PER3 11×14 + модель мотора 400 kV + ESC + опір пакета. У дужках — гвинт на 5 % гірший за дані APC.

| | light 5,07 кг | light+ порожній 5,69 кг | **light+ з 2 кг, 7,69 кг** |
|---|---|---|---|
| **180 км/год: опір** | 10,0 Н | 11,6 Н | **11,9 Н** |
| на валу / з батареї | 595 / 700 Вт | 685 / 807 Вт | **706 (743) / 832 (877) Вт** |
| струм 12S | 16,2 А | 18,7 А | **19,3 А (20,3)** |
| оберти гвинта | 9 390 | 9 640 | **9 700 з 17 273** |
| **час / дальність на 180** | 39,6 хв / 119 км | 34,4 хв / 103 км | **33,4 хв (31,7) / ≈100 км (95)** |
| 200 км/год | 30 хв / 100 км | 26 хв / 87 км | 25,4 хв / 85 км |
| Найдовший політ | 157 хв на 78 км/год | 145 хв на 75 | **97 хв на 88** (75–114) |
| Максимум 1,5 / 2 кВт | 255 / 283 км/год | 242 / 269 | **241 / 268** |
| Зрив | 65 км/год | 63 | **73** |
| Схід із катапульти (1,2·Vs) | 21,6 м/с, 1,19 кДж | 20,9 м/с, 1,24 кДж | **24,3 м/с, 2,27 кДж** (з візком 1,5 кг 2,72) |
| Катапульта 10 g / 15 g | 2,4 м, 497 Н / 1,6 м, 746 Н | 2,2 м, 558 Н | **3,0 м, 754 Н / 2,0 м, 1131 Н** |

**180 км/год з 2 кг — це 35–47 % потужності стандартного мотора**, 56 % ліміту обертів гвинта, ~~0,43 А на комірку з 45 А~~ ❌ ВИПРАВЛЕНО R07c-V: **6,4 А на комірку (1,4C), 14 % від 45 А**. Мотор і гвинт міняти не треба.

> 🔍 **R07c-V з масою 7,75 кг:** 180 км/год — 11,9 Н, ≈833 Вт з батареї, 19,3 А, 33,3 хв, ≈100 км; **реалістично 90–100 км** (ККД ланцюга на крейсері 0,716 не калібрований, а та сама модель на найдовшому польоті виявилась на 14 % оптимістичною). 200 км/год ≈80–85 км. Найдовший політ ≈96 хв на 88 км/год (75–113). Максимум 241 / 268, зрив 73,2 км/год. Схід 1,2·Vs 24,4 м/с, 2,31 кДж (з візком 2,76); 1,1·Vs 22,4 м/с; 10 g — хід 3,04 м, 760 Н на апарат, 907 Н на катапульту з візком.

## 7. Крило: чому 0,30 м²

| | 0,25 м² (старе) | **0,30 м²** |
|---|---|---|
| Злітна маса | 7,56 кг | 7,69 кг |
| Навантаження | 30,3 кг/м² | 25,6 кг/м² |
| Зрив | 79 км/год | 73 км/год |
| **Схід 1,2·Vs** | **26,4 м/с** (мін. 24,2) — **таких катапульт на ринку немає** | **24,3 м/с** (мін. 22,3) — верхня межа ринку |
| 180 км/год | 10,5 Н, 735 Вт, ≈113 км | 11,9 Н, 832 Вт, ≈100 км |
| Найдовший політ | 91 хв | 97 хв |

- ~~Катапульта — єдиний спосіб старту, а ринок дає 24–25 м/с (C400P, SCL-1A, ELI PL-40/60/80 — з пошукових зведень R07b-V). Ця стеля жорстка, тому **0,30 м²**.~~ ❌ ВИПРАВЛЕНО R07c-V: **аргумент «0,25 м² поза ринком» перебільшений.** При T/W ≈0,5 і повному газі схід на 1,1·Vs — нормальна практика, і тоді 0,25 м² дає 24,2 м/с — у межах ринку 24–25 м/с. Відмова від 0,25 м² — **вибір запасу, а не фізична неможливість.** Головна невизначеність — невиміряний CL_max: ±10 % дає ±5 % швидкості сходу (для 0,30 м² це 23,1–25,6 м/с). **Рішення 0,30 м² лишається** — заради запасу на ріст маси й невизначеність CL_max. Втрата ≈13 км на 180 км/год менша за виграш: сходить без трюків, зрив нижчий, у повітрі довше.
- ➕ R07d-V (ринок катапульт): у ELI PL-40/60/80 офіційна межа виробника — **25 м/с** (26,0–26,6 у таблицях — поза дозволеним). Для light+ (24,4 м/с) PL-40 підходить формально, **із запасом лише ≈0,6 м/с**. Див. [[R07d-8kg-160kmh]], розділ 6.
- 0,28 м² → схід 25,1 м/с (не вкладається в 24). 0,32 м² → 23,6 м/с, але на 180 км/год лише ≈95 км.
- Закрилки на старті (CL_max 1,2 — припущення, не виміряно) дали б для 0,25 м² ≈24,1 м/с — на самій межі, без запасу.
- **Умова перегляду:** якщо зважена маса з вантажем вийде понад ≈7,9 кг — або 0,32 м², або закрилки на старті обов'язкові.
- AR 6 лишається відкритим блокером R07a. AR 7 на 0,30 м² дав би кращу витривалість, але важчий лонжерон.

## 8. Конструкція — головні ризики

> Усе нижче — оцінки першого порядку. **Розрахунку міцності немає.**

1. **Згин фюзеляжу біля кореня крила — головний новий ризик.** Ніс і передній блок тепер на ≈228 мм далі від крила: момент на передній кромці крила 6,5–7,1 Н·м на 1g проти 2,17 у light (×3,0–3,3). На 6g це **≈8,5 МПа в самій паперовій трубі** (light 2,6), ще без вирізів. Критичне напруження оболонки: 6–11 МПа (аудит R05) або 14,5–21,7 МПа (R06, NASA SP-8007) — **ця суперечність досі не розв'язана.**
   - ❌ ВИПРАВЛЕНО R07c-V: **розрахунковий переріз не той.** Найбільше навантажені **кінці люків біля джойнера**: x 575 — 8,5–9,0 Н·м/g, x 603 — 8,2–8,7 Н·м/g плюс ≈20 Н·м від 30 Н на стабілізаторі. Суцільна труба на 6g — **10–11 МПа** (не 8,5). **Переріз із вирізом 131° — 22–37 МПа, з навантаженням хвоста до ≈47 МПа** — це вище за обидві оцінки критичного напруження паперу, тому стрічки обов'язкові.
   - ➕ R07c-V: **корма не порахована:** на задній кромці крила 4,24 Н·м/g проти 0,64 у light (**×6,6**).
2. **Люки на 131° дуги** стоять саме в зоні максимального моменту. Потрібні **4 вуглецеві стрічки 1 × 6 мм** уздовж x ≈345–850: дві по краях люків, дві в нижніх чвертях (~~≈0,7 кН на стрічку, ≈120 МПа~~ ❌ ВИПРАВЛЕНО R07c-V: **≈0,95–1,3 кН, 160–215 МПа** — у перерізі на кінцях люків). Кришки — із замками, що несуть розтяг. Внесок склообшивки в згин ніде не рахувався.
   - ➕ R07c-V, **кручення (нове):** 874 мм із 1110 мм труби відкриті вирізами 131–148°. Відкритий профіль: жорсткість на кручення падає з ≈378 826 до **≈85 мм⁴ (~4 500 разів)**. Крутний момент від хвоста до крила йде через ≈289 мм відкритого профілю (у light 78 мм). **Кришки мають передавати зсув по всій довжині країв**, а не лише розтяг у замках.
   - ➕ R07c-V, **конфлікт:** краї люків (z ≈ +15,1) збігаються з верхньою поверхнею кореня крила (z до 16,6 на x ≈560–650).
3. **Рама крила** (x 578–600) передає на фюзеляж ≈67 Н на 1g, ≈400 Н на 6g. Гільза в паперовій стінці 1,2 мм цього не тримає: потрібні друковані або фанерні щоки (R07c-V: маса +15 г тепер у розділі 4).
   - ➕ R07c-V: гільза джойнера OD ≈18 у зоні 22 мм — по 2 мм з боків, на межі. Внутрішня муфта Klima (ID 70,2) на стику x 589 заходить на торці камер і перекриває канал, якщо вона довша за 22 мм і без вирізу. Штифт проти провертання крила не може заходити в трубу — там камери.
4. **Згин крила** ×1,74: при 6g × 1,5 ≈74 Н·м у корені. Джойнер Ø14 — 275 МПа, **Ø16 — 184 МПа** → Ø16. Будівельна висота лонжерона 17,8 → 19,5 мм.
   - 🔍 R07c-V: 184 МПа — для **суцільного** прута. Трубка Ø16/12 — 269 МПа. З розподілом підйомної сили за Шренком момент +10 % → 203 МПа (суцільний).
5. **Катапульта:** стиск труби попереду гака 297 / 445 Н при 10 / 15 g (light 205 / 307). ➕ R07c-V: не враховано **розтяг позаду гака — 457 / 686 Н** при 10 / 15 g. Гак — на раму крила x 578–600.
6. **Упори вантажу:** 2 кг дають 196 / 294 Н при 10 / 15 g. Закласти ≥450 Н назад і ≥600 Н уперед. Перегородки — кільця з пояском ≥10 мм, вклеєні в трубу.
7. **Довша корма:** перша частота згину ~37 Гц (light ~50) — ⚠️ R07c-V: методу немає, не перевірено. Крутильну жорсткість (див. п. 2) і флатер руля висоти треба перевірити.

> 🔎 **Пораховано в [[R07e-Rumpf-Material]] (R07e + R07e-V, 2026-09-26):** папір + скло на x 603 не тримає навіть закритий (MS −0,25 волога / −0,14 суха), з люками −0,68. Прохідні варіанти: **8 стрічок 1×5 через обидві зони** (≈47 г, а не 35) → +0,66; або **карбон замість скла** + стрічки через обидві зони → +0,62; або **саморобна карбонова труба на HT-оправці** + 4 стрічки → +0,15…+0,71 (−0,19…−0,26 кг). Сіра HT-труба (PP) і ПВХ-U — ні. Силові кришки обов'язкові для будь-якого матеріалу.

**Порахувати пізніше:** трубу з вирізами й стрічками на +6g / −3g разом із хвостом; раму крила; лонжерон і джойнер Ø16; упори при 15 g; **зразки труби Klima** (E, стиск, стійкість) — без них про міцність нічого не відомо.

## 9. Варіанти, які теж пораховано

| Варіант | Корпус | Порожній / з 2 кг | 180 км/год | Найдовший | Схід |
|---|---|---|---|---|---|
| **Основний: 0,30 м², відсік 1,5 л** | 1371 мм | ~~5,69 / 7,69~~ **5,75 / 7,75 кг** (R07c-V) | ≈100 км (реально 90–100) | ~~97~~ 96 хв | ~~24,3~~ 24,4 м/с |
| Відсік 2,0 л (вантаж ~1 кг/л): камери 2 × Ø66 × 292 | 1527 мм | 5,75 / 7,75 кг | ≈100 км | 96 хв | 24,4 м/с |
| Старе крило 0,25 м² (не рекомендовано) | 1382 мм | 5,56 / 7,56 кг | ≈113 км | 91 хв | **26,4 м/с — поза ринком** |

Варіант 2,0 л: джойнер x 661,25, LE крила 600,3, стабілізатор 407,7 × 102,4 (LE 1419,4), кіль 129,6 / 86,4 × 164,2, задній блок 998,8–1213,1 (розпірка 26,6). Льотні характеристики майже ті самі, але згин і довжина більші.

## 10. Відкриті питання

- **Чи ділиться вантаж на дві рівні половини по 1 кг** (кожна ≤ Ø66 × 220 мм)? Якщо це один неподільний предмет — потрібне крило на сідлі або плечове (джойнер над трубою, суцільний відсік Ø66 × ≈450 мм). Не пораховано.
- Густина вантажу: 1,5 л (≥1,33 кг/л) вистачить, чи потрібен варіант 2,0 л?
- Яка конкретна катапульта дає 24–25 м/с для 7,7 кг + візок (≈2,7 кДж)? Вантажопідйомність комерційних моделей не перевірялась.
- Чи продає Klima шматки, довші за 500 мм?
- Чи згоден Віктор перенести авіоніку в корму? (Сигнальний дріт до ESC ≈1 м.)
- Перевантаження n = 6 і коефіцієнт безпеки 1,5 — прийнято, не підтверджено.
- Зона джойнера 22 мм із гільзою Ø16 — влазить чи 26 мм?
- Подовження AR 6 — блокер R07a.
- ➕ R07c-V: **силові кришки люків на кручення** — конструкція й маса.
- ➕ R07c-V: згин корми разом із навантаженням хвоста.
- ➕ R07c-V: довжина муфти на x 589 або перенесення стику.
- ➕ R07c-V: **форма вантажу.** 1,5 л — лише для циліндричного вантажу. Прямокутний у Ø66 — максимум 46,7 × 46,7 мм, тобто **≈0,96 л** на дві камери, а не 1,5 л. Чи потрібні капсули?
- ➕ R07c-V: **компас на x 1132** поруч із виводами 10 AWG заднього блоку: 30 А на 75 мм дає ≈80 мкТл — більше за поле Землі. Виводи скрутити або винести компас.
- ➕ R07c-V: живлення BEC від 12S у кормі.
- ➕ R07c-V: прийняти схід на 1,1·Vs із повним газом як офіційний критерій катапульти?

## 11. Що не має джерела (оцінки)

- Маси нових вузлів (перегородки, люки, ложемент, стрічки, запас, проводка) — інженерні оцінки, не зважено. Погонна маса дроту 10 AWG ≈57 г/м — довідкова без джерела.
- Частка лонжерона в масі крила (60 з 450 г), масштабування лонжерона ∝ m·b і джойнера ∝ M^(2/3).
- Kf фюзеляжу (Raymer, прочитано наближено), CNα гвинта 0,1–0,3, ηt 0,88 (підібрано під NP light 385).
- Розклад опору R07a-V2 — оцінка аудитора; множник 1,378 виведено з CD0 0,0243.
- Модель мотора (Rm 0,032 Ом, Io), ККД ESC, опір пакета 0,072 Ом — не з даташита конкретного мотора.
- APC PER3 — розрахункові дані виробника, не продувка (звідси −5 % у дужках).
- CL_max 1,0 і +0,2 від закрилків — R07b-V, не виміряно.
- Критичне напруження паперової труби — R05 і R06 суперечать одне одному.
- ➕ R07c-V: частота корми 37 / 50 Гц — методу немає.
- ➕ R07c-V: стеля ринку катапульт 24–25 м/с і їхня вантажопідйомність — лише пошукові зведення. Маса візка 1,5 кг — припущення.
- ➕ R07c-V: правило «сталі V_H / V_V» як достатня умова — не доведено (груба оцінка аудитора: Cnβ ≈ −6 %).
- ➕ R07c-V: 10 AWG «57 г/м» у тексті, а модель рахує 64 г/м.
- ➕ R07c-V: ККД ланцюга на 180 км/год (0,716) не калібрований.
- ➕ R07c-V: «+50–60 / +200–340 мм» без перенесення авіоніки — вихід моделі, незалежно не перевірено.

## 12. Файли

- CAD: [[Gungnear v1 light+]] — `configs/gungnear-v1-light-plus/gungnear-v1-light-plus.step`, генератор `CAD/model1.py --config light-plus`. Превʼю: `_Assets/gungnear-r07c-v1-light-plus.png`. Робочий скрипт і розрахунки — scratch сесії 2026-09-25 (`lpmodel.py`, `lpsolve.py`, `vlmfast.py`, `lpperf.py`, `loads_lp.py`).
- Порція 2 (8 кг на 160 км/год) — окремий етап. Груба оцінка агента без перевірки: злітна маса ≈15–17 кг, крило ≈0,6–0,65 м², ≈1 кВт на валу на 160 км/год — **це новий планер, а не подовження light+.**

---

## 🔍 R07c-V — перевірка (2026-09-25, 1 адверсарний аудитор)

**Вердикт: основні числа вистояли.** Геометрія, NP, льотні характеристики й CAD збігаються з нотаткою. Поправки внесено вище видимо (~~закреслено~~ + ❌ ВИПРАВЛЕНО / ➕ R07c-V).

| Що перевірено | Результат |
|---|---|
| Сума мас конструкції, масштабування труби, скла, крила, лонжерона, хвоста | стоїть, але **пропущено ≈60 г** (2-й люк батареї, проводка після перенесення авіоніки, щоки рами крила, довша лижа) → **5,75 / 7,75 кг** |
| ЦМ / NP / запас | ЦМ ≈591 (порожній) / 590,6 (з вантажем); NP 618 стоїть; запас 13 → **12,2–12,4 %** |
| Межі ЦМ 575–596, заборона однієї камери | стоять |
| 180 км/год: 11,9 Н, 832 Вт, 19,3 А, 33 хв, 100 км | стоїть; **реалістично 90–100 км** |
| «0,43 А на комірку» | ❌ → 6,4 А (1,4C) |
| 200 км/год, найдовший, максимум, зрив, схід | стоять (96 хв, 24,4 м/с) |
| Відмова від крила 0,25 м² | ❌ аргумент перебільшений: на 1,1·Vs із повним газом 0,25 м² у межах ринку. 0,30 м² лишається як запас |
| Згин фюзеляжу | ❌ не той переріз: кінці люків x 575 / 603, з вирізом **22–47 МПа**; корма ×6,6 не порахована |
| Кручення відкритого профілю | ➕ нове: жорсткість ÷4 500, кришки мають бути силовими на зсув |
| Стрічки | 0,7 кН / 120 МПа → **0,95–1,3 кН / 160–215 МПа** |
| Джойнер Ø16, рама крила, упори, стиск на катапульті | стоять (+ розтяг позаду гака 457 / 686 Н; гак — на раму крила) |
| CAD STEP | **збігається:** 1 тіло, 1371,26 мм, розмах 1341,6 (у проєкції 1341,25), висота 241,8, змочена 1,0071 м², V_H 0,491, V_V 0,0345 |
| Об'ємні перевірки | камера Ø66 + канал 6 мм — зверху 0,6 мм зазору (тісно); гільза джойнера — по 2 мм; конфлікти муфти й країв люків (розділ 8) |

**Що це означає:** light+ як концепція тримається — 2 кг на 180 км/год стандартний мотор везе легко. Але **фюзеляж із паперової труби з чотирма великими люками — слабке місце**, і воно гірше, ніж здавалось до перевірки. Перед будь-яким виготовленням потрібні розрахунок труби з вирізами (згин + кручення) і випробування зразків Klima.
