NetHunter123/Jflyproject/R07f-Fertigrohr.md

---
tags:
  - project
  - engineering
  - gungnear
etappe: R07f
status: 🔍 перевірено (R07f-V) — №1 алюмінієвий водостік стоїть; люкам потрібні крайові стрічки (кручення); для light+ краще знімний ніс + 1 люк; маси трохи більші
updated: 2026-09-26
---

# R07f — Готова труба фюзеляжу з ринку ЄС без ламінування: алюмінієвий водостік, лист, друк, ПВХ, полікарбонат

> **Запит Віктора (2026-09-26):** матеріал, який уже готовий, поширено й вільно продається в ЄС і легко обробляється (ПВХ, інша труба, алюміній, друкована труба з цікавою стінкою). Карбон і ламінування зараз недоступні.
> **Рамки:** посадку (шасі, парашут, посадка на черево) і правила польотів не враховано й варіанти ними не обмежуються — це Віктор вирішує сам. Мотор і гвинт — без змін.
> **Прохід:** 2 агенти послідовно (ринок → розрахунок). Попередня стадія — [[R07e-Rumpf-Material]]. Спершу ринок (агент ринку + перевірка ключових позицій), потім розрахунок. Скрипти в scratchpad: `r07f/r07f_calc.py`, `joints_pod.py`, `summary.py`; результати — `r07f_calc_out.txt`, `summary_out.txt`, `joints_pod_out.txt`; журнал — `struct_progress.md`. Навантаження й маси — з R07e / R07e-V (tubecalc, audited).

## 0. Нагадування: що таке V30 і V60

Це два варіанти окремого, більшого апарата з [[R07d-8kg-160kmh]]: 8 кг вантажу, крейсер 160 км/год. Число означає час польоту.

| | **V30** | **V60** |
|---|---|---|
| Час / дальність на 160 км/год (з резервом 10 %) | ≈32,7 хв / 87 км | ≈61,8 хв / 165 км |
| Батарея | 12S5P, 1,05 кВт·год, 4,5 кг | 12S12P, 2,52 кВт·год, 10,8 кг (×2,4) |
| Злітна маса (реалістично, R07d-V) | ≈19,6 кг | ≈28,5 кг |
| Крило | 0,62 м², розмах 2,22 м | 0,86 м², розмах 2,63 м |
| Гондола | Ø150 × 1,29 м | Ø150 × 1,48 м |
| Катапульта | ≈6,2 кДж | ≈8,3 кДж |
| Згин на задній рамі крила (ult) | 247 Н·м | 422 Н·м |
| Відсік вантажу | 630 мм | 630 мм |

**Різниця — лише батарея і все, що росте разом із нею** (крило, гондола, катапульта, навантаження).

## 1. Відповідь простими словами

- **Найкраще готове — алюмінієва водостічна труба (Fallrohr) Ø76 або Ø80, стінка 0,7 мм.** ✏️ R07f-V: норма EN 612 допускає й **0,6 мм** — стінку поміряти штангенциркулем; брати **«Alu natur» (без фарби) зі зварним швом**.
  - ~~Продається в Baumarkt (toom, Bauhaus, OBI, Globus; у Франції — Leroy Merlin) і в онлайн-магазинах покрівлі, ≈10–12 €/м.~~ ❌ R07f-V: **Ø80 на полиці — DE/AT** (toom 22,99 €, OBI 21,99 € за 2 м); у FR — лише фарбована 0,6 мм по 3 м; у NL/PL у будівельних магазинах немає. **Ø76 — лише онлайн DE**, з доставкою ≈40 € за 2 м.
  - Ріжеться ножівкою, свердлиться, клепається, клеїться епоксидкою.
  - Важить 450–480 г/м (папір зі склом — 310), але жорсткіша в **11–13 разів** і майже не крутиться.
- **Головна слабкість будь-якої труби — великі люки.** Якщо люки лишити лише над батареями, а вантажні камери засувати через люк батареї в закритий відсік, ~~алюмінієва труба не потребує жодних стрічок~~ ❌ R07f-V: **кожному люку однаково потрібні 2 крайові стрічки 6×1** (заведені на 40–50 мм за торці люка, із заклепками на кінцях) **або силові кришки на гвинтах**, плюс кутові накладки — причина **кручення** (депланація біля торців люка), а не згин.
  - ➕ R07f-V, **краще компонування (г):** знімний ніс (мотор + фаєрвол + ESC одним блоком на 4 гвинтах) — через нього ставляться передня батарея й передня камера; лишається **тільки задній люк батареї**. На 10 г легше й міцніше, ніж (в); ціна — знімати ніс при кожній заміні батареї.
  - Light+ тоді важчий лише на ~~**+21 г (Ø76) / +60 г (Ø80)** → ≈95,6 / 94,7 хв~~ ❌ R07f-V: **(г) +40 / +78 г → ≈95,2 / 94,3 хв; (в) +50 / +89 г → ≈95,1 / 94,2 хв** замість 96.
- **Light:** та сама труба Ø76 з нинішнім люком — ~~+63 г (≈154 хв замість 157), без підсилень~~ ❌ R07f-V: **+93 г (≈153 хв замість 157), з крайовими стрічками на люку** (або силовою кришкою) і кутовими накладками.
- **Найлегше без ламінування — друкована тонка труба ASA + 4 готові карбонові стрічки** (~~−0,21…−0,24 кг~~ **≈−0,19 кг**, ≈99,5 хв на light+; R07f-V: лише 4 стрічки **6×1** на ±76° / ±160°, стики сегментів — внапуск ≥10 мм). Але це багато друку й клею, закрутка більша, від удару тріскає.
- **«Цікава структура стінки» друкованої труби не допомагає:** жорсткість дає матеріал на зовнішньому радіусі, а не візерунок. Подвійна стінка з гіроїдом ще й з'їдає внутрішній діаметр.
- **ПВХ, полікарбонат, готовий склопластик — ні:** +0,16…+0,6 кг. ПВХ ще й не пропускає пакет уздовж.
- **8 кг:** готова алюмінієва труба DN150 × 0,8 теж працює (+0,55 / +0,9 кг до злітної V30 / V60).

## 2. Припущення

| Параметр | Значення | Джерело |
|---|---|---|
| Моменти (ult, +6g × 1,5, хвіст 30 Н) | light x372 45 Н·м; light+ x575 79, **x603 109**, x843 46 | R07e / R07e-V |
| −3g | −0,5 × (+6g), верхні краї люків у стиску | R07e |
| Кути люків | 2·arcsin(ширина / ID): пакет 69,7, камера 66 | розрахунок |
| Алюміній водостоку | E 69 ГПа; допустиме **100 МПа** (сплав і стан не опубліковані; типові EN AW-3103/3105 H14/H24 мають Rp0,2 ≥110–130) | оцінка; чутливість ×0,6 |
| Лист Al 0,5 (Baumarkt) | 80 МПа; стійкість ×0,6 за ручне згортання | оцінка |
| Друк (стоячи → згин поперек шарів) | E_Z; допустиме = 0,5 × міцності між шарами: ASA/PLA 15,5, PETG 9, LW-PLA 2,1 МПа; стійкість ×0,8 | TDS Bambu / Prusament / CNC Kitchen; коефіцієнти — оцінка |
| Стрічки | R&G пултрудовані 3×1 (4,5 г/м), 6×1 (9,6 г/м), 10×1 (16,3 г/м); допустиме 500 / 350 МПа (як R07e) | r-g.de |
| Теплове | ±30 K, стрічки (CTE ≈0) проти оболонки: ASA ±4,9 МПа, Al ±5,9 МПа | розрахунок, CTE типові |
| Люки / кришки | у списку R07c: люки з рамками light 20 г, light+ 70 г; силові кришки +10 / +30 г | R07c, оцінка |
| Продуктивність | витривалість ∝ m^−1,41; схід ∝ √m; +0,18 × ΔD/D опору | R07e |

## 3. Що є на ринку (Ø75-клас)

| Варіант | OD × стінка, мм | ID, мм | г/м | EI, Н·м² | Ціна | Де | Висновок |
|---|---|---|---|---|---|---|---|
| Папір Klima + скло (база R07e) | 75 × 1,2 + 0,15 | 72,6 | 310 | 634 (волога) / 729 | 9,90 €/500 мм | ❌ не продається | довідка |
| **Алю-водостік Ø76 × 0,7, зварний** | 76 × 0,7 | 74,6 | 450 (розрах.) | 8 100 | **9,70 €/м** (Paulus, мін. 2 м; R07f-V: з доставкою ≈40 € за 2 м) | онлайн DE: Paulus, Dachrinnen-Shop, Blechshop24, Löffert | ✅ №1 |
| **Алю-водостік Sarei DN80** | 80 × ≈0,71 (з маси; R07f-V: реально 0,6–0,7 — поміряти) | 78,6 | **480** (0,96 кг / 2 м, toom, OBI) | 9 460 | ≈22 €/2 м | ✅ Baumarkt DE/AT (toom, OBI); ~~FR (Leroy Merlin Ø80, 3 м), IT~~ FR — лише 0,6 мм фарбована; IT — фарбована з фальцем; NL/PL — ні | ✅ №1-бис |
| Алю-водостік Ø76 × 0,8 | 76 × 0,8 | 74,4 | 514 | 9 220 | 22,85 €/2 м | онлайн DE | важчий без виграшу |
| ~~Алю-труба димохідна DN80 × 0,6~~ ❌ R07f-V: 81,4 × 0,7 | ~~80 × 0,6~~ 81,4 × 0,7 | ~~78,8~~ 80 | ~~407~~ ≈480 | ~~8 100~~ ≈9 970 | 27,90 €/м | печі, онлайн, лише для газу | без переваги над водостоком |
| Лист Al 0,5, згорнутий на HT DN75 | 76 × 0,5 (+шов 15 мм) | 75,0 | 333 | 5 900 | 5–8 € | ✅ Baumarkt (Alberts), AlMg3 на розкрій | ✅ №3 (лише закрите) |
| Алю-труба 75 × 1 | 75 × 1 | 73,0 | 640 (опубл.) | 10 980 | на запит | B2B (ESS) | ❌ важка |
| Зрошувальна Al 3" | 76,2 × ≈1 | — | ≈650 | — | — | фермерські дилери, 6 м | без переваг |
| ПВХ-U 75 × 2,3 | 75 × 2,3 | 70,4 | 735 | 937 (40 °C) | 8,84 €/м | онлайн | ❌ |
| Полікарбонат 80/76 | 80 × 2 | 76 | 588 | 745 (40 °C) | 50–60 €/м | онлайн | ❌ |
| Пултрудований склопластик 80×76 | 80 × 2 | 76 | 955 | 13 000 | 29,70 €/м | онлайн | ❌ важкий |
| Поштовий картонний тубус 84/80 | 84 × 2 | 80 | 390 (з лаком) | 650 | 2–3 € | ✅ пакування | макет |
| Друк ASA 0,8 (сам / + 4 × 6×1) | 75 × 0,8 | 73,4 | 196 | 272 / ≈4 000 | ≈6 € + 14 € стрічок | ✅ | ✅ №2 |
| Друк PLA 0,8 | 75 × 0,8 | 73,4 | 231 | 264 | ≈5 € | ✅ | ❌ м'якне при 54 °C |
| Друк PETG 1,0 | 75 × 1,0 | 73,0 | 295 | 247 | ≈5 € | ✅ | слабке зчеплення шарів |
| Друк LW-PLA 1,2 (ρ 0,55) | 75 × 1,2 | 72,6 | 153 | 170 | ≈4 € | ✅ | ❌ не тримає |
| Друк ASA 2 × 0,45 + гіроїд 2,5 | 80 × 3,4 | 73,2 | 303 | 351 | ≈6 € | ✅ | ❌ гірше за просту стінку |

- **Водостоки:** алюміній без покриття або з фарбою. Сплав і стан **не публікують** ні Sarei, ні онлайн-магазини. ➕ R07f-V: типово EN AW-3103 / 3105 H2x/H4x (Rp0,2 ≥105–120), але EN 612 допускає й 1050A (≈85) — тест на згин обов'язковий. Фарбовані труби зазвичай із **фальцевим** швом, а фарба знижує міцність клею в 2–3 рази — **брати «natur» зі зварним швом**; у зонах клею фарбу знімати. **Розтруб у Sarei не гарантований** — з'єднання окремим Fallrohrverbinder (50 г). Розтруб ≈50 мм на одному кінці; шов буває зварний (Paulus: «geschweißt») або фальцевий (PREFA, DN150 Dachrinnen-Shop). Шов Sarei DN80 — не опубліковано, подивитися в магазині.
- **Один 2-м водостік вистачає на light+ (1 110 мм) і на light (639 мм)** — муфт не треба.

## 4. Чому «цікава структура стінки» не допомагає

- **Жорсткість на згин:** EI ≈ E·π·r³·t. При фіксованому Ø75 вона залежить лише від кількості матеріалу на зовнішньому радіусі. Двостінка, гіроїд чи ізогрід її не збільшують — вони лише покращують місцеву стійкість.
- **Друк стоячи:** згин фюзеляжу діє поперек шарів. Міцність між шарами ASA/PLA ≈31 МПа (у тонкій стінці — менше), спіненого LW-PLA — лише ≈4 МПа.
- **Двостінка з гіроїдом при OD 75** дає ID 68 < пакет 69,7 → можлива лише при OD 80. Навіть тоді вона на 100–130 г важча за просту стінку 0,8 зі стрічками при меншій жорсткості.
- **Ізогрід:** ребра ±60° працюють на осьову жорсткість лише на ~⅓. Кільцеві ребра стоячи не друкуються (навис 90°).
- **Що справді працює:** проста тонка стінка 0,8 мм + 4 готові карбонові стрічки в надрукованих пазах. Друком зручно одразу зробити перегородки, бобишки під джойнер, канали для дротів. Так роблять і Eclipson Apex: друкована оболонка + карбоновий хребет.

## 5. Три компонування

- **(а) люки як зараз** — 2 люки батареї + 2 люки вантажу (light+), дуги 114–164°.
- **(б) повністю закрита труба** — знімний ніс + один розріз позаду задньої камери (x≈834). Через джойнер крила вздовж усієї труби нічого не просунеш.
- **(в) гібрид** — люки лише над батареями; камери вставляють через люк батареї й засувають у закритий відсік вантажу. R07f-V: передній люк має починатися на ≥30–40 мм за фаєрволом (закрите кільце біля мотора).
- ➕ **(г) знімний ніс + лише задній люк (рекомендовано R07f-V для алюмінію)** — передня батарея й передня камера ставляться через ніс (мотор + фаєрвол + ESC одним блоком, 4 × М3 у сталевих рифлених заклепкових гайках); задня батарея й задня камера — через задній люк. На 10 г легше за (в), немає відкритого перерізу біля мотора.
- Деталі: поле «closed_layout_uk» / розділ 9.

## 6. Light+ (7,75 кг) — результати

Δm — проти паперу зі склом (база: 440 г пакета з 4 стрічками 3×1). MS — запас із вибраними стрічками при +6g / −3g × 1,5 і ±30 K.

| Варіант | Комп. | Пакет, г | Δm, г | Підсилення | MS | Маса, кг | Політ, хв | Схід, м/с | ΔЦМ, мм | Закрутка |
|---|---|---|---|---|---|---|---|---|---|---|
| Папір + скло (база) | а | 440 | 0 | 4 × 3×1 (27 г) | +0,18 | 7,75 | 96,0 | 24,40 | 0 | 1,8° |
| Al Ø76 × 0,7 | а | 537 | +97 | 4 × 3×1 (27 г) | +0,18 | 7,85 | 94,3 | 24,55 | +1,0 | 0,06° |
| Al Ø76 × 0,7 | б | 470 | ~~+30~~ +66 (R07f-V) | — (стик x834 — болтовий) | +1,84 | ~~7,78~~ 7,82 | ~~95,4~~ 94,8 | 24,45 | +1,0 | 0,04° |
| **Al Ø76 × 0,7** | **в** | **461** | ~~**+21**~~ **+50** (R07f-V) | крайові 6×1 на люках батареї з анкеруванням + кутові накладки (≈28 г) | **+0,79** | ~~**7,77**~~ **7,80** | ~~**95,6**~~ **95,1** | **24,48** | −0,5 | ~~0,05°~~ ≈0,21° |
| ➕ **Al Ø76 × 0,7** | **г** (R07f-V) | — | **+40** | задній люк: крайові 6×1 + накладки | ≥ (в) | **7,79** | **95,2** | 24,46 | −0,2 | ≈0,2° |
| Al Ø80 Sarei | а | 570 | +130 | крайові 6×1 (22 г) | +0,10 | 7,88 | 93,5 | 24,60 | +1,4 | 0,05° |
| Al Ø80 Sarei | б | 508 | ~~+68~~ +128 (без розтруба, R07f-V) | — | +2,13 | ~~7,82~~ 7,88 | ~~94,5~~ 93,5 | 24,51 | +1,5 | 0,03° |
| **Al Ø80 Sarei** | **в** | 499 | ~~**+60**~~ **+89** (R07f-V) | крайові з анкеруванням + накладки | **+1,31** (при 0,6 мм — менше) | ~~7,81~~ 7,84 | ~~94,7~~ 94,2 | 24,54 | 0,0 | ≈0,2° |
| ➕ Al Ø80 Sarei | г (R07f-V) | — | +78 | задній люк | ≥ (в) | 7,83 | 94,3 | — | — | — |
| Al Ø76 × 0,8 | в | 532 | +92 | крайові | +1,00 | 7,84 | 94,4 | 24,54 | +1,7 | 0,04° |
| Лист Al 0,5 | а | 445 | +6 | 4 × 6×1 — мало, треба 10×1 | −0,09 | 7,76 | 95,8 | 24,41 | −0,4 | 0,08° |
| Лист Al 0,5 | б | 368 | ~~−72~~ −49…−42 (R07f-V) | стик x834: 12 × М3 або накладка | +0,65 | ~~7,68~~ 7,70 | ~~97,2~~ 96,8 | 24,29 | +0,3 | 0,05° |
| Лист Al 0,5 | в | 339 | −101 | крайові | +0,06 ⚠️ | 7,65 | 97,7 | 24,24 | −0,4 | 0,07° |
| Друк ASA 0,8 + стрічки | а | 289 | −151 | 4 × 6×1 на всю довжину (55 г) | +0,75 | 7,60 | 98,7 | 24,16 | −1,4 | 2,0° |
| Друк ASA 0,8 + стрічки | б | 239 | −200 | 4 × 3×1 (26 г) | +0,54 | 7,55 | 99,6 | 24,08 | −1,1 | 1,2° |
| **Друк ASA 0,8 + стрічки** | **в** | 199 / **≈228** | −240 / ~~**≈−211**~~ **≈−193** | ~~4 × 3×1 /~~ **лише 4 × 6×1 на ±76° / ±160°** (R07f-V) | ~~+0,55 / **+1,9**~~ 3×1: −0,16…+0,08 ❌; **6×1: +0,71** | 7,56 | **≈99,5** | 24,09 | −2,8 | 1,6° (до 2,3°) |
| Друк PLA 0,8 + стрічки | в | 241 | −199 | 4 × 3×1 | +0,54, але ❌ 54 °C | 7,55 | 99,6 | 24,08 | −1,3 | 1,7° |
| Друк PETG 1,0 + стрічки | в | 314 | −126 | 4 × 3×1 | +0,50 | 7,62 | 98,2 | 24,20 | −0,4 | 1,7° |
| Друк ASA двостінка + гіроїд (OD 80) | в | 332 | −108 | 4 × 3×1 | +0,58 | 7,64 | 97,6 | 24,23 | −0,2 | 1,3° |
| Друк LW-PLA 1,2 + стрічки | б | 188 | −252 | — | **−0,73 ❌** | — | — | — | — | 1,9° |
| ПВХ-U 75 × 2,3 | а | 843 | +403 | 4 × 3×1 | +0,16 | 8,15 | 89,4 | 25,03 | +4,2 | 0,5° |
| ПВХ-U 75 × 2,3 | б | 796 | +356 | — | +2,11 (пакет не засунеш) | 8,11 | 90,1 | 24,95 | +4,9 | 0,3° |
| Полікарбонат 80/76 | б | 638 | +198 | — | +2,39 | 7,95 | 92,3 | 24,71 | +3,4 | 0,4° |
| Алю-труба 75 × 1 | в | 661 | +221 | — | +1,19 | 7,97 | 92,3 | 24,75 | +3,2 | 0,04° |
| Склопластик 80×76 | б | 1 045 | +606 | — | +11 | 8,36 | 86,1 | 25,34 | +7,4 | 0,1° |
| Тубус 84/80 + лак + стрічки | в | 410 | −30 | 4 × 3×1 | +0,85 (картон невідомий) | 7,72 | 96,0 | 24,35 | +0,5 | 2,3° |

- **Напруження (ult, +6g) без стрічок:**
  - Al Ø76: (а) край люка на x603 — 112 МПа; (в) край люка батареї x843 — 56; (б) закрита — 35.
  - Ø80: 91 / 43 / 32 МПа.
  - Лист 0,5: 151 / 75 / 48 МПа.
- **Місцева стійкість:** закрита Al-труба (R/t 54–57) — σкр ≈535–570 МПа ≫ межа текучості, не визначає.
- **Вільні краї люків на −3g:** Ø76 (а) −56 МПа — ~~це вже рівень «плоскої полиці 15 мм» (58 МПа). Тому краї люків потрібно підкріплювати: рамка з R07c + 2 стрічки 6×1.~~ ✏️ R07f-V: розрахунок методом скінченних смуг дає σкр краю 126–135 МПа (Ø76), тож **стійкість краю не визначає**. Але **кручення** (депланація біля торців відкритого відсіку від кіля 9 Н·м ult) дає на краях **±89 МПа** (задній люк), біля мотора **±110 МПа** — разом зі згином 145 МПа > 100. Тому **крайові стрічки 6×1 з анкеруванням за торці люка (або силові кришки) обов'язкові** на кожному люку, плюс кутові накладки (R ≥ 10, Kt 1,5–2,5).
- **Гільза джойнера в Al 0,7:** 605 Н / (2 × 18 × 0,7) = 24 МПа — стінка тримає (у паперу були потрібні щоки).
- **ЦМ:** алюміній зсуває його назад на +1,0…+1,5 мм. Виставляється розпіркою заднього блоку (±15 мм = ±3,5 мм ЦМ, R07c), баласт не потрібен.

## 7. Light (5,07 кг) — результати

| Варіант | Комп. | Пакет, г | Δm, г | Підсилення | MS | Маса, кг | Політ, хв | Схід, м/с | ΔЦМ, мм | Закрутка |
|---|---|---|---|---|---|---|---|---|---|---|
| Папір + скло (база) | а | 246 | 0 | 4 × 3×1 (13 г) | +1,52 (без стрічок −0,36) | 5,07 | 157,0 | 21,60 | 0 | 1,0° |
| **Al Ø76 × 0,7** | **а** | **309** | ~~**+63**~~ **+93** (R07f-V) | крайові 6×1 з анкеруванням + накладки — **обов'язково** (кручення) | **+0,83** | ~~5,13~~ **5,16** | ~~154,2~~ **152,9** | 21,80 | +0,9 | ≈0,16° |
| Al Ø76 × 0,7 | б | 303 | +57 | — (ніс + розріз x592) | +5,85 | 5,13 | 154,5 | 21,72 | +1,1 | 0,02° |
| Al Ø80 Sarei | а | 333 | +87 | крайові | +1,36 | 5,16 | 152,8 | 21,79 | +1,6 | 0,03° |
| Лист Al 0,5 | а | 234 | −12 | крайові | +0,09 ⚠️ | 5,06 | 157,4 | 21,58 | −0,3 | 0,05° |
| Лист Al 0,5 | б | 243 | −3 | — | +2,98 | 5,07 | 157,0 | 21,59 | +0,6 | 0,03° |
| Друк ASA 0,8 + 4 × 3×1 | а | 148 | −98 | 15 г стрічок | +1,08 | 4,97 | 161,4 | 21,39 | −1,4 | 1,1° |
| Друк PLA 0,8 + 4 × 3×1 | а | 172 | −74 | 15 г | +1,06 (❌ 54 °C) | 5,00 | 160,3 | 21,44 | −1,0 | 1,2° |
| ПВХ-U 75 × 2,3 | а | 470 | +224 | — | +0,44 | 5,29 | 147,7 | 22,07 | +3,7 | 0,3° |
| Полікарбонат 80/76 | а | 381 | +135 | — | +1,34 | 5,21 | 150,8 | 21,89 | +2,7 | 0,4° |
| Тубус 84/80 + 4 × 3×1 | а | 273 | +27 | 13 г | +2,10 | 5,10 | 154,9 | 21,66 | +1,1 | 1,6° |
| Алю-труба 75 × 1 | а | 419 | +173 | — | +1,25 | 5,24 | 149,7 | 21,97 | +2,8 | 0,03° |
| Склопластик 80×76 | а | 615 | +370 | — | +10 | 5,44 | 141,7 | 22,37 | +6,2 | 0,1° |

Напруження Al Ø76 (а) на x372 (край люка 138°): 55 МПа; закрита — 15 МПа.

## 8. Чутливість (MS з вибраними стрічками)

| Варіант | База | Сплав м'який (×0,6 → 60 МПа) | Хвіст 70 Н | Обидва разом |
|---|---|---|---|---|
| light+ Al Ø76 (а) | +0,18 (3×1) | −0,23 з 6×1 → треба 10×1 | +0,05 (6×1) | −0,19 навіть з 20×1 ❌ |
| light+ Al Ø76 (б) | +1,84 | +0,70 | +1,07 | +0,24 |
| light+ Al Ø76 (в) | +0,79 | +0,07 | +0,14 | 3×1 −0,14 → 4 × 6×1 |
| light+ Al Ø80 (в) | +1,31 | +0,39 | +0,47 | +0,09 (3×1) |
| light+ лист 0,5 (б) | +0,65 | +0,10 (3×1) | +0,20 | −0,14 (6×1) → 10×1 |
| light+ друк ASA (в) | +0,55 (3×1) | — | +0,12 | +0,12 |
| light Al Ø76 (а) | +0,83 | +0,10 | +0,16 | −0,12 (3×1) → 6×1 |
| light Al Ø76 (б) | +5,85 | +3,11 | +3,35 | +1,61 |
| light Al Ø80 (а) | +1,36 | +0,42 | +0,50 | +0,11 (3×1) |

**Висновок:** закрита або гібридна алюмінієва труба лишається додатною навіть у найгіршому поєднанні (у «в» — із 4 стрічками 6×1). З великими люками вантажу (а) результат повністю залежить від невідомого сплаву.

## 9. Закрите компонування — стики

| Стик | Момент (ult) | Конструкція | Перевірка | Маса |
|---|---|---|---|---|
| Знімний ніс x120 (light / light+) | 1,7 Н·м; катапульта 74 Н; мотор ≤3,7 Н·м | мотор + фаєрвол + ESC одним блоком, 4 × М3 у **сталеві рифлені** заклепкові гайки зі зниженою голівкою або байонет | ~~≈25 Н на гвинт~~ **≈74 Н на гвинт, 35 МПа, MS +3,5** (R07f-V) | ≈15 г |
| light+ розріз x≈834 | 48 Н·м (75 з хвостом 70 Н) | готовий розтруб водостоку 50 мм (Ø76; у Sarei Ø80 — окремий з'єднувач) + 8 × М3 + бандаж з вуглецевої стрічки 25 мм + друковане кільце | ~~зминання 151 МПа проти ≈210 (+0,39); з 70 Н 235 МПа (−0,11)~~ ✏️ R07f-V: **болтовий стик**, 153 МПа проти 158–225 (за сплавом) → MS +0,03…+0,47; на 70 Н — 12 × М3, 8 × М4 або накладка 0,5 мм | ~~≈25 г~~ **≈39 г (Ø76) / ≈63 г (Ø80)** + роз'єми ≈20 г |
| light розріз x≈592 | 13,6 Н·м (26,5) | 4 × М3 | 85 (166) МПа | ≈15 г |

- ~~**Контактний тиск на губі розтруба:** 1,5 МПа при перекритті 50 мм, 0,7 МПа при 75 мм.~~ ❌ R07f-V: для стінки 0,7 мм контактна модель нефізична (кільцевий згин ~2 400 МПа) — **момент несуть гвинти**; стик проєктувати як болтовий (ряд гвинтів посередині перекриття, щільна посадка). Бандаж і внутрішнє кільце лише обмежують овалізацію.
- **Для друкованої труби** стрічки на розрізі перериваються. Потрібна товста друкована муфта (≈45 г), бо в стінці 0,8 мм гвинти вминаються (132 МПа).
- **Баланс мас:**
  - (б): ~~+60 г стиків −70 г люків −30 г силових кришок ≈ **−40 г**~~ **≈+4 г** проти (а) (R07f-V: силових кришок у списку 7,75 кг ніколи не було, стик реально важчий);
  - (в): ~~−40 г люків вантажу −20 г їхніх кришок +11 г країв ≈ **−49 г**~~ **≈−12 г**, без жодного стику (R07f-V: + анкерування, заклепки, ізоляція, кутові накладки);
  - ➕ (г): ≈ (в) −10 г.

## 10. Обробка, клей, температура, вм'ятини, ремонт, ціна

| | Al водостік | Лист Al 0,5 | Друк ASA + стрічки | ПВХ-U |
|---|---|---|---|---|
| Різка | ножівка 32 TPI або лобзик із пилкою по металу, дерев'яна пробка всередині; розтруб — відрізати або використати як стик | ножиці по металу | — | ножівка |
| Люки й отвори | Dremel з відрізним диском, ступінчасте свердло, кути R ≥ 10 мм | так само | друкуються одразу | фреза |
| З'єднання | заклепки Al 2,4–3,2, заклепкові гайки М3, 2K епоксидка після P120 + знежирення | шов внапуск 15 мм: епоксидка + заклепки 2,4 кожні 25–30 мм | CA / 2K епоксидка, стрічки в пази | THF-клей |
| Карбон на алюмінії | ізолювати (склострічка / шар епоксидки) — гальванічна корозія; кінці стрічок закріпити заклепкою | так само | — | — |
| Сонце / авто | не м'якне | не м'якне | ASA HDT 92–100 °C ✅ (PLA 54 ❌, PETG 68) | Vicat 76 °C |
| Холод | ok | ok | ASA ok; PLA крихкий | крихкий < 0 °C |
| Вм'ятини («індекс» σт·t², розр.) | 54 Н (≈3× паперу+скла 18 Н); м'неться, не тріскає | 20 Н | 20 Н, але тріскає по шарах | 264 Н |
| Ремонт | вирівняти + накладка з листа 0,5 на епоксидці/заклепках | так само | CA + друкована накладка або передрукувати сегмент | латка на THF |
| Шов | зварний шов — ~~збоку, біля нейтральної осі (закрита ±90°; з люком згори ≈±115°)~~ ✏️ R07f-V: **на ±115° по всій довжині** (на ±90° у відкритому перерізі зона термовпливу шва має лише MS ≈+0,1; ±115° ще й обходить отвори джойнера); без отворів у шві | шов на нейтральній осі | стики сегментів не в зоні x575–603 | — |
| Ціна light+ (оцінка) | 19–25 € труба (Ø76 онлайн з доставкою ≈40 €) + ≈20 € кріплення/клей | 5–8 € + ≈15 € | ≈6 € ASA + 12–15 € стрічок | ≈18 € |
| Робота (оцінка) | 2–4 год | 4–8 год (оправка, шов, круглість) | 10–20 год друку + 3–4 год збирання | 2 год |

## 11. 8-кг гондола (R07d, Ø150, відсік 630 мм, виріз 100°)

| Варіант | г/м | Циліндр V30 / V60, кг | Δ, кг | MS виріз V30 / V60 | Злітна V30 / V60 (база R07d-V 19,6 / 28,5) | Де |
|---|---|---|---|---|---|---|
| Композит R07d, склопластик 0,73 (довідка) | 619 | 0,53 / 0,65 | 0 | +1,09 / +0,22 (0/90: −0,20) | 19,6 / 28,5 | потрібне ламінування |
| **Алю-водостік DN150 × 0,8 (фальц)** | 1 040 | 0,89 / 1,08 | +0,36 / +0,44 | **+1,27 / +0,33** | **≈20,1 / ≈29,4** | онлайн DE, 67 €/2 м, 6–8 днів |
| Алю спірально-фальцева Ø150 × 0,6 (EN 1506) | ≈845 | 0,72 / 0,88 | +0,19 / +0,23 | +0,73 / +0,01 | ≈19,9 / ≈29,0 | B2B, на запит |
| Алю спірально-фальцева Ø160 × 0,6 | ≈900 | 0,77 / 0,94 | +0,24 / +0,29 | +0,96 / +0,15 | ≈20,0 / ≈29,1 (+опір Ø160) | B2B |
| Друк ASA Ø150 × 1,2 + 4 стрічки 6×1 | 589 + ≈40 г | 0,50 / 0,61 | ≈0 | без стрічок −0,46 / −0,69 (закрита V60 −0,27); зі стрічками ≥0 | ≈19,6 / ≈28,5 | принтер 256 мм, 4–5 сегментів |
| KG DN160 | 2 745 | 2,34 / 2,86 | +1,8 / +2,2 | +3,3 / +1,6 | ≈22,4 / ≈33,1 | ❌ |

- **DN150:** фальцевий шов ~~проклеїти епоксидкою або заклепати~~ **обов'язково** проклеїти епоксидкою або заклепати (R07f-V: непроклеєний фальц робить з усієї гондоли відкритий переріз, GJ 1,5 проти 54 257 Н·м²) і поставити збоку. ➕ R07f-V: для V60 з м'яким сплавом (×0,6) MS −0,20 → крайові стрічки на виріз або перевірка сплаву.
- **Стійкість оболонки:** R/t 93, σкр ≈300 МПа — не визначає.
- **Не пораховано:** кріплення 8 кг вантажу та батареї на 8–10 g катапульти (див. R07d-V).

## 12. Рекомендація

- **Light+:**
  1. **Алю-водостік Ø76 × 0,7 (або Ø80 з Baumarkt) + компонування ~~«в»~~ «г» (знімний ніс + лише задній люк; «в» — теж можна):** ~~+21 / +60 г, 95,6 / 94,7 хв, стрічки не потрібні~~ ✏️ R07f-V: **+40 / +78 г (г) або +50 / +89 г (в), ≈95 / 94 хв; на кожному люку — 2 крайові стрічки 6×1 з анкеруванням (або силова кришка) + кутові накладки**; шов на ±115°; гак катапульти — ≥8 кріплень + накладка.
  2. **Друк ASA 0,8 + 4 стрічки 6×1, компонування «в»:** ~~≈−211 г, ≈99,8 хв~~ **≈−193 г, ≈99,5 хв** (стрічки лише на ±76° / ±160°, стики внапуск); більше роботи й ризиків.
  3. **Лист Al 0,5, закрите «б»:** ~~−72 г, 97,2 хв~~ **−49…−42 г, ≈96,8 хв**; стик x834 — 12 × М3 або накладка; сплав листа з Baumarkt невідомий.
  - ПВХ, полікарбонат, склопластик, Al 75×1, LW-PLA, двостінка, картон — ні.
- **Light:** **алю-водостік Ø76 × 0,7 з нинішнім люком** (~~+63 г, 154 хв, без підсилень~~ **+93 г, ≈153 хв, з крайовими стрічками й накладками** — R07f-V). Друк ASA + 3×1 — −98 г, якщо є принтер (не перевірено окремо).
- **8 кг:** алю-водостік DN150 × 0,8 (+0,55 / +0,9 кг до злітної) або друк ASA + стрічки (як композит); композит — коли з'явиться можливість ламінувати.

## 13. Що зробити далі

1. **Купити одну трубу** Ø76 × 0,7 (онлайн) або Ø80 (Baumarkt). Перевірити тип шва (зварний — тонка рівна лінія; фальц — виступ), круглість і прямизну. Вибрати пряму трубу без вм'ятин. ➕ R07f-V: **поміряти стінку** (0,6 чи 0,7), брати «natur» без фарби; у Sarei перевірити, чи є розтруб.
2. **Простий тест на згин:** шматок 1 м з вирізом люка батареї (138°) на опорах 0,9 м, вантаж посередині 21 кг (= 46 Н·м, розрахунковий момент на x843). Після зняття вантажу не має лишитися залишкового прогину. Закритий шматок — 50 кг (= 110 Н·м). Тест заодно покаже, чи сплав не м'який.
3. **CAD:** ніс і конус під Ø76 (+1 мм) або Ø80 (+5 мм). Люки батареї ≥225 мм завдовжки; перегородки 1 і 4 — знімні упори; сліпий роз'єм камер.
4. **Краї люків:** рамка + 2 стрічки 6×1 (ізольовані склострічкою) або алюмінієвий куточок 10×10×1 на заклепках.

## 14. Без джерела (оцінки / розрахунок)

- Сплав і стан водостоків (допустиме 100 МПа, чутливість ×0,6); м'якша зона зварного шва.
- Стінка Sarei DN80 (з маси); маси Ø76 × 0,7, DN150 × 0,8 і спіральних труб (+10 % на фальц).
- Сплав Baumarkt-листа (80 МПа, стійкість ×0,6).
- Допустимі друкованих стінок (0,5 × між шарами, стійкість ×0,8); CTE і ΔT ±30 K.
- Маси стиків, люків, силових кришок; допустиме зминання ≈210 МПа.
- Стійкість вільного краю (лише оцінка «плоска полиця 15 мм»); «індекс вм'ятини» σт·t².
- Властивості картонного тубуса й лаку; PC при 40 °C; E пултрудованого склопластику.
- Хвіст 30 Н, кручення 6 Н·м (R07e); коефіцієнти росту 1,54 / 2,06 і база R07d-V; години роботи й ціни кріплення.

## 15. Відкриті питання

- Сплав, стан і тип шва конкретної труби. Sarei DN80 у Baumarkt — зварна чи фальцева?
- Ø76 (ближче до CAD, лише онлайн) чи Ø80 (будь-який Baumarkt, +35–40 г, CAD +5 мм)?
- Чи є принтер ≥250 мм з кожухом (для ASA)?
- Чи влазить люк батареї ≥225 мм спереду (фаєрвол x117). Знімні перегородки 1 і 4, сліпі роз'єми камер.
- Реальна сила на хвості (30 чи 70 Н).
- Кріплення кореня крила й гака катапульти до стінки 0,7 мм. Заклепкові гайки М3 у 0,7 мм — перевірити на зразку.
- Карбон на алюмінії: ізоляція й теплові напруження на кінцях стрічок.
- Діапазон температур експлуатації (критично для друку).
- 8 кг: виріз 100° чи завантаження через ніс; кріплення вантажу на 8–10 g.

## 16. Джерела

- toom Sarei Aluminium-Fallrohr 80 mm, 0,96 кг / 2 м: https://toom.de/p/aluminium-fallrohr-80-mm/3309658
- Sarei техлист (DN 60/76/80/87/100, Al natur/farbig, 2 м; сплав не вказано): https://static.toom.de/produkte/bilder/3309658/technisches_datenblatt_3309658_01.pdf
- Paulus Alu-Fallrohr Ø76 0,7 geschweißt, 9,70 €/м, розтруб з одного боку: https://www.dach-paulus.de/alu-fallrohr-%C3%B876-0-7-geschweisst_124465_p.dpage
- Dachrinnen-Shop Aluminium-Fallrohr DN150, 0,8 мм (EN 612), гефальцований, 67,12 €/2 м: https://www.dachrinnen-shop.de/Dachrinnen-und-Anbauteile/Dachentwaesserung-aus-Alu-Natur/Fallrohre-verschied-Varianten/Aluminium-Fallrohre-O-DN150/Aluminium-Fallrohr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
- Leroy Merlin FR, Ø80 aluminium 3 м (ALUHOME): https://www.leroymerlin.fr/produits/tuyau-de-descente-circulaire-anthracite-diam-80-mm-en-aluminium-l-3-m-aluhome-95887678.html
- Bauhaus AT Sarei: https://www.bauhaus.at/fallrohre/sarei-fallrohr/p/22476173 ; Globus: https://www.globus-baumarkt.de/p/sarei-fallrohr-alu-anthrazit-nw-80-2-meter-0782147039/
- rokaflex Wickelfalzrohr Aluminium (EN 1506, на запит): https://www.rokaflex.de/produkt/wickelfalzrohr-aluminium/
- R&G пултрудовані карбонові стрічки: https://www.r-g.de/art/600052/
- Alberts Glattblech: https://www.alberts.de/produkte/profile-bleche/bleche/glattblech/ ; AlMg3 0,5: https://bestell-dein-lochblech.de/products/aluminiumblech-almg3-t-0-5mm
- TDS: Bambu PLA Basic / ASA / PLA Aero; Prusament PETG; colorFabb LW-PLA; CNC Kitchen LW-PLA (див. market_progress.md)
- Eclipson Apex (друкована оболонка + карбоновий хребет): https://www.eclipson-airplanes.com/apex
- ПВХ ipz-shop, PC KUS, склопластик Carbon Composite AG, Kartonfritze — див. ринковий прохід (scratchpad `r07f/market_progress.md`)
- NASA SP-8007 (коефіцієнт стійкості) — як у R07e

---

## 🔍 R07f-V — перевірка (2026-09-26, 2 незалежні адверсарні аудитори)

**Вердикт.** №1 — **готова алюмінієва водостічна труба** — стоїть: легшого на одиницю жорсткості й так само доступного готового продукту не знайдено. Рейтинг (1 — водостік, 2 — друк ASA + стрічки, 3 — лист 0,5 закритий) не змінюється. Змінюється зміст пунктів; поправки внесено вище видимо.

| Що перевірено | Результат |
|---|---|
| Sarei DN80, 0,96 кг / 2 м, ≈22 € (toom, OBI) | стоїть |
| Стінка 0,7 мм | ✏️ EN 612: 0,7 (клас A) **або 0,6** (клас B) — поміряти; при 0,6 напруження +17 %, EI −14 % |
| Сплав 3103/3105, допустиме 100 МПа | стоїть для 3xxx; EN 612 допускає 1050A (≈85) — покривається чутливістю ×0,6 і тестом на згин |
| «Широко в ЄС» | ❌ на полиці лише DE/AT (Ø80); FR — 0,6 мм фарбована; NL/PL — ні; Ø76 — лише онлайн DE (≈40 € з доставкою) |
| Розтруб 50 мм у кожної труби | ❌ у Sarei не гарантований (окремий з'єднувач 50 г) |
| Димохідна Al DN80 × 0,6 | ❌ насправді 81,4 × 0,7, ≈480 г/м |
| Фарбовані труби | ➕ зазвичай фальцевий шов; фарба слабить клей у 2–3 рази — брати «natur» зі зварним швом |
| Дані друку (Bambu, Prusament, colorFabb, Polymaker) і стрічок R&G | стоять (PETG «vertical xz» — не вісь Z) |
| Напруження перерізів, EI, стійкість закритої труби | стоять (112 / 56 / 35 МПа; 567 МПа) |
| Стійкість вільного краю люка | ✏️ не критична (σкр 126–135 МПа, а не 58) |
| **«Стрічки не потрібні» / «light без підсилень»** | ❌ **кручення** (депланація біля торців люка) дає ±89…110 МПа → **крайові стрічки 6×1 з анкеруванням або силові кришки обов'язкові**, плюс кутові накладки |
| Закрутка | 0,05° → ≈0,2° (усе одно ≪ 1,8° паперу) |
| Шов | на ±115° по всій довжині, без отворів у шві |
| Ніс 4 × М3 | 25 → 74 Н на гвинт, MS +3,5 — тримає |
| Стик x834 | болтовий, не контактний; 153 МПа проти 158–225 за сплавом; на 70 Н на хвості — 12 × М3 / 8 × М4 |
| Маси | light+ (в) +21 → **+50 г**; (г) **+40 г**; Ø80 (в) +89; друк −211 → **−193**; лист (б) −72 → −49; light +63 → **+93 г** |
| Друк ASA 3×1 | ❌ стрічки у скрипті стояли там, де їх фізично не поставити (всередині люка); лише 6×1 на ±76° / ±160°, MS +0,71 |
| Гак катапульти в 0,7 мм | ≥8 кріплень + накладка |
| 8 кг DN150 × 0,8 | стоїть (+0,55 / +0,9 кг); фальц **обов'язково** проклеїти; для V60 з м'яким сплавом — крайові стрічки |

**Що змінилося в рекомендації:**
- **Light+:** Al-водостік, компонування **(г)** — знімний ніс + лише задній люк батареї (+40 г, ≈95,2 хв). Або (в) — два люки батареї (+50 г). На кожен люк — 2 крайові стрічки 6×1 з анкеруванням (або силова кришка) і кутові накладки.
- **Light:** Al-водостік із нинішнім люком — +93 г, ≈153 хв, зі стрічками на люку.
- **Перед покупкою:** Sarei Ø80 «natur» у toom/OBI — подивитися шов і розтруб, поміряти стінку. Тест на згин шматка 1 м — обов'язковий.
