NetHunter123/Jflyproject/R07g-GN+-CFD.md

---
tags:
  - project
  - engineering
  - gungnear
etappe: R07g
status: ✅ CFD прийнято 01.10 рішенням Віктора з винятком (поріг 2 кВт на 250 км/год спрацював); 2 кВт на валу вистачає до ≈235–238 км/год; перевірено 01.10
updated: 2026-10-01
---

# R07g — тест зовнішньої форми GN+ у CFD

> Модель і план — [[GN+]]. Питання: **чи лишаємо зовнішню форму**, перш ніж деталізувати стовбур, ніс і хвіст.
> 💾 Розділи 0–11 записано до перевірки. Прохід дослідження: 2 агенти (аудит змін і плану; незалежна розрахункова оцінка).
> 🔍 **Адверсарна перевірка 01.10** (окремий прохід, 2 агенти: перерахунок чисел і знаків з сирих даних; спроба спростувати методику й вердикт) — розділ 12. Критичних помилок немає; виправлення позначені ❌ ВИПРАВЛЕНО.

## 0. Що змінилось у проєкті після 2026-09-26

Файли, які інший чат змінив 28–29.09, і що з ними:

| Файл | Що змінилось | Оцінка |
|---|---|---|
| [[Zbirka-shpilky]] | Збірка на 8 шпильках M3 від кільця біля джойнера, пробки 20/25 мм, охолодження не вирішене | Ідея кільця-якоря робоча. Суперечності: пробка носа 20 мм довша за 16 мм до батареї; у шапці Ø80, а розділ про батарею рахує Ø76 (ID 74,6); шпилька на r=36 заходить на пакет Ø70 на 0,5 мм. На зовнішню форму не впливає |
| `CAD/nose_tail.py` | Розділений ніс (кок до x=33, капот від x=39, щілина 6 мм), пази за мотором, хвіст із перегородкою, отвір Ø20 | Шлях повітря в CAD не працює: плита мотора лишає 148 мм² (вал, болти), перегородка хвоста — 36 мм², тож Ø20 веде в глухий мішок. **Кіль зсунуто на +5,58 мм без потреби** (коментар стосувався Ø75): −4,5 % відкритої площі кіля |
| `CAD/model1.py` | light+ переведено на Clark Y | Команда з docstring `--out GN+` будує **інше** тіло (Ø75, без розділеного носа) і перезапише `GN+.step`. Контроль «розмах 1,342 / довжина 1,37» цього не помітить |
| `CAD/clarky.dat` | Новий профіль Clark Y 11,7 % | Коректний. Разом із `thicken_te` задня кромка **0,67 мм**, не 0,4 |
| `CAD/gn_detail.py` → `GN+.step` | Збірка GN+ для симуляції | Три дефекти, кожен ламає CFD — розділ 1 |
| [[GN+]] | План CFD: пакети A–F, критерії | Арифметика опорних чисел правильна (похибки < 1 %). План у такому вигляді не виконуваний — розділ 1 |
| [[proj. Gungnear]], [[Gungnear v1 light+]] | Робочий напрям Ø80 алюміній без люків, Clark Y, таблиця хвилин за профілями | Таблиця «Clark Y −4 хв» без етапного файлу й перевірки. Конфіг-нотатка досі описує паперову трубу Ø75, 4 люки, ESC у спинному обтічнику |

Решта сховища (поза проєктом): 33 з 36 «видалених» файлів — перенесення в `_Archiv`. Справді зникли 2 тексти B1 (`Texte/B1`), `Sprechen/_MOC.md` і одна картинка. Останній коміт — 2026-06-15. **Папка proj. Gungnear у git не відстежується** — резервної копії й історії змін немає.

## 1. Аудит GN+ і плану GN+.md перед симулятором

Незалежно перевірено в CadQuery на самому `GN+.step` (STEP збігається з `gn_detail.build()` до 0,000 мм³).

| # | Що | Вага | Наслідок для CFD | Що зроблено |
|---|---|---|---|---|
| 1 | **«Лопать» — пласка пластина 279,4 × 22 мм поперек потоку** | критично | Відкрита лобова площа ≈5 250 мм². Опір ≈9,4–10,5 Н на 50 м/с, тобто майже весь книжковий опір літака (11,9 Н). Після ×1,35 пункт «> 16 Н» спрацював би хибно. Пластина зриває вихори, стаціонарний розрахунок не зійдеться | Лопать прибрано. Втрати живого гвинта вже сидять у ККД 0,84 ланцюга |
| 2 | **Порожнистий корпус:** стінка 0,7 мм, щілини 0,4 мм, отвори Ø3,4 | критично | +0,39 м² внутрішніх стінок, ребра 0,24 мм. Щоб сітка не «проколола» стінку, потрібні десятки мільйонів комірок. Внутрішній потік у порожній трубі нічого не моделює, охолодження не вибране | Корпус суцільний. Охолодження — окремий запуск, коли шлях повітря вибрано |
| 3 | **Ковзання β = 5° на півмоделі** (пакет F) | критично | Площина симетрії забороняє ковзання: гарантовано марний запуск | F — на повній моделі, окремою сіткою |
| 4 | **План ≈16–19 запусків, у квоті 9** (10/рік, 1 використано) | критично | Квота скінчилась би посеред пакета B, вердикту не було б | Кілька кутів за один запуск — розділ 4 |
| 5 | Стрижень джойнера Ø16 на z=0 виступає під крилом (3,9 см³, до 4,8 мм, |y| 39–90), буртик назовні | серйозно | Штучний тупий виступ ≈0,3–0,6 Н і витік у порожнину біля кореня | Прибрано для CFD. Для конструкції: вісь джойнера на z≈+8 (товщина там 26,3 мм) |
| 6 | Кути A (−2…6°) і D (−2…2°) не охоплюють 1g | серйозно | 1g на 50 м/с при α ≈ −2,7°, на 69,4 м/с при ≈ −3,6°. Опір довелося б екстраполювати | Нові кути — розділ 4 |
| 7 | Рецепт сітки повторює помилку R07a-V2 | серйозно | 18 шарів ×1,25 від 7 мкм = 1,53 мм шару при пограншарі ≈5,5 мм на кромці крила. Опір знову завищиться | Пограншар задано абсолютною товщиною — розділ 4 |
| 8 | Шорсткість ×1,35 застосована до всього D − D_i | серйозно | Множиться й опір тиску, дна, відривів | D_льот = D_тиск + 1,35·D_тертя (SimScale дає їх окремо) |
| 9 | Запас стійкості з CFD без поправки на гвинт | серйозно | Гвинта в моделі немає, запас оптимістичніший ≈2,5 % | До NP з CFD додавати −5,6 мм (R07c) |
| 10 | CL_max з RANS — лише верхня оцінка | серйозно | Пункт «катапульта» проходить при CL_max ≥ 0,95 — RANS це майже напевно дасть. Верхня оцінка довести «проходить» не може | Кути до 14° рахуємо (ціни в запусках не мають), але CL_max для вердикту беремо консервативний |
| 11 | Межа «2 кВт на 180 км/год» | дрібне | Відповідає D_льот 33,6 Н — раніше за «16 Н» ніколи не спрацює | 2 кВт перевіряти на 250 км/год (пакет D) |
| 12 | Кіль зсунуто, кромка крила 0,67 мм | дрібне | −4,5 % площі кіля; +≈0,1 Н | Лишено як у GN+: обидва — у безпечний бік. Виправити в `nose_tail.py` |
| 13 | Маса 7,75 кг і ЦМ 591 не перераховані під Ø80 без люків, шпильки, батарею 2,7 кг | дрібне | CL 1g, кути, схід зсуваються на 1–3 % | Поза цим етапом. Записати у звіт |

Губа капота (радіус коку 21,2 → капот 23,8 мм на x 33→39, ≈370 мм² назустріч потоку) — частина форми GN+, лишена. CFD покаже її ціну.

## 2. Модель для CFD: `GN+_cfd.step`

Генератор `CAD/gn_cfd.py`. `GN+.step` не змінено.

- Ті самі зовнішні обводи: кок, капот, труба Ø80, конус, крило Clark Y (0,30 м², +2°, V 2°), стабілізатор, кіль (зсунутий, як у GN+).
- **Без лопаті.** Маточина R14 заповнює щілину 6 мм до капота: щілина лишилась канавкою.
- **Суцільне тіло:** немає стінки 0,7 мм, порожнин, пазів, отворів шпильок, отвору Ø20. Дно конуса плоске Ø30.
- **Немає стрижня джойнера й буртика** назовні.
- Перевірка: 1 тіло, 1 оболонка, 168 граней, змочена площа 1,030 м², розріз по y=0 валідний. Найкоротші ребра 0,11 і 0,34 мм — на тупому носику коку r=2.
- У SimScale: розмах 1,341 м, довжина 1,373 м — масштаб правильний.

## 3. Незалежна розрахункова оцінка (до CFD)

Вихровий метод (крило + стабілізатор, серединна лінія Clark Y), момент фюзеляжу за Мунком, поляри Clark Y з XFOIL (airfoiltools, Re 2·10⁵…10⁶), опір — покомпонентно. Повністю турбулентний гладкий планер, як у CFD. Скрипт: scratch `lowfi_aero.py`.

| Що | Оцінка |
|---|---|
| CL_α | 0,081 /град |
| α нульової підйомної сили літака | −4,7° |
| dCm/dCL | −0,208 |
| Нейтральна точка | 0,630 м (0,625 з ефективністю хвоста 0,9) |
| Запас на ЦМ 591 | 17,5 % (15,3 %); **з поправкою на гвинт −5,6 мм ≈ 13–15 %** |

| Режим | α 1g | D (турб.) | D (з переходом) | L/D | Навантаження стабілізатора без балансування |
|---|---|---|---|---|---|
| 88 км/год, 24,4 м/с | +3,9° | 5,3 Н | 4,5 Н | 14,5 | −1,7 Н |
| 180 км/год, 50 м/с | −2,7° | **9,5 Н** | 7,1 Н | 8,0 | −12,4 Н |
| 250 км/год, 69,4 м/с | −3,6° | 16,5 Н | 12,4 Н | 4,6 | −25,5 Н |

Розклад опору на 50 м/с (турб.): профіль крила 5,3 · фюзеляж 1,7 · індуктивний 1,1 · стабілізатор 0,9 · кіль 0,4 · дно 0,1 Н.

CL_max: нижня оцінка 0,99 (схід 24,5 м/с) · середня 1,08 (23,5 м/с) · верхня 1,49 без балансування (20,0 м/с).

⚠️ Модель відкалібрована лише на одному запуску R07a (MH 32). Це орієнтир для перевірки CFD, не результат.

## 4. План розрахунку

**Квота SimScale.** 2026-09-29, до грубої A: 9 запусків і 2966 CPU-год. Сітка витрачає лише CPU-години. 2026-09-30 після старту A fine, B fine і F витрачено 5 прогонів із 10 за рік. У резерві **5**. Години після цих трьох стартів наживо не перечитувались; ~~оцінка SimScale на A fine і на B fine — по 25–37 CPU-год~~ ❌ ВИПРАВЛЕНО 01.10: фактично A fine 123,4, B fine 90,9, F 44,5, A-груба 75 CPU-год (разом ≈335 + сітки ≈1).

**Кілька кутів за один запуск.** У стаціонарному розрахунку «час» — це номер ітерації. Вхідна швидкість задана таблицею t → (Ux, Uy, Uz): кожен кут тримається 700 ітерацій (перший 1400), між кутами перехід 20 ітерацій. Кожен рівень сходиться від попереднього поля. Сили пишуться щоітерації в ньютонах (тиск і тертя окремо) — CL, CD, Cm кожного кута беремо з кінця його рівня. Поля пишуться кожні 700 ітерацій, тобто в кінці кожного рівня.

| Запуск | Сітка | Кути | Навіщо |
|---|---|---|---|
| A-груба | груба | 50 м/с: −3, −4, −2, 0, +2°; 69,4 м/с: −3,5, −4,5° | Перевірка механізму таблиці + сітковий етюд у всіх точках A |
| A-дрібна | дрібна | те саме | 180 і 250 км/год: опір 1g, нахили CL і Cm |
| B-дрібна | дрібна | 24,4 м/с: 2, 4, 6, 8, 10, 12, 14° | 88 км/год: 1g, лінійна ділянка для NP, межа розрахунку |
| F-повна | груба, повна модель | 24,4 м/с, α 3,5°: β 0, потім β +5° | Кіль, плюс перевірка припущення симетрії півмоделі |

Разом **4 запуски з 9**, 5 лишаються в резерві (охолодження, NACA 4412, повторення). Таблиці: `CFD/GN+_A_50_69.csv`, `CFD/GN+_B_24.csv`, `CFD/GN+_F_beta.csv`. Для F: U = V·(cos α cos β, −sin β, sin α cos β), стійко, якщо момент навколо +z (осі CAD) < 0.

**Сітка.** Стандартний сітковик SimScale. Пограншар задано **абсолютною** товщиною (виправлення уроку R07a-V2):

| | Груба | Дрібна |
|---|---|---|
| Поверхня літака | 4,5 мм | ≈3 мм |
| Пограншар | 20 шарів, 15 мкм → 5 мм | ≈24 шари, 8 мкм → 6 мм |
| Коробка навколо літака і сліду (x −0,1…2,5, y 0…0,75, z −0,25…0,3 м) | 12 мм | ≈8 мм |

**Фізика і граничні умови:** нестисливе, стаціонарне, k-ω SST, ρ 1,225, ν 1,46·10⁻⁵. Домен x −8…16, y 0…8, z −8…8 м. Вхід — Min X, Min Z, Max Z, Max Y; вихід p=0 — Max X; симетрія — Min Y. Турбулентність на вході 0,5 %, масштаб 1 мм (типові SimScale 5 % і 1 м завищені для вільного польоту).

**Сили:** повний літак (усі 128 граней півмоделі) і окремо крило (основна грань). Фюзеляж + хвіст = різниця. Точка моментів x = 0,5837 м.

## 5. Додаткові перевірки понад GN+.md

1. **Сітковий етюд у кожній точці A**, не лише при одному куті.
2. **Тиск і тертя окремо** → чесна поправка на шорсткість і видно, чи опір тиску не роздутий (відриви).
3. **Опір крила окремо від решти** → звідки береться опір, якщо форму таки міняти.
4. **Точки тиску для охолодження:** канавка за коком, капот біля пазів (x 111), за дном конуса, опорна точка попереду. Перепад «канавка → дно» — це тиск, яким можна продувати мотор і батарею без вентилятора. Охолодження ще не вибране, число знадобиться. ❌ **Не виконано:** зонди не записались (розділ 11, п. 3).
5. **Балансування:** Cm навколо ЦМ 591 у точках 1g → потрібне навантаження стабілізатора і кут його установки (зараз 0°).
6. **Порівняння з розрахунковою оцінкою** (розділ 3): розбіжність у рази = помилка налаштування.
7. **y+ і напруження тертя** на стінці → якість пристінної сітки й зони відриву (конус Ø80→Ø30 крутий, до 15,6°; стик крила з трубою без галтелі). ❌ **Виконано для α −3°, 50 м/с** (розділ 13): площа τx > 0 і y+ прямо з поля. Інші кути — ні.
8. **Повна модель при β = 0** перевіряє саму півмодель: сили мають збігтися з A/B.

## 6. Стан SimScale

Проєкт «Model 1» (публічний), геометрії `GN+_cfd` (півмодель) і `GN+_cfd - Copy` (повна, y −8…8). Симуляція «Incompressible 2».

- [x] Геометрія, об'єм потоку, тіло видалено
- [x] Матеріал, граничні умови, турбулентність на вході
- [x] Сили: повний літак, крило; ~~4 точки тиску~~ ❌ ВИПРАВЛЕНО 01.10: точки задані, але жоден запуск не записав їхніх даних (розділ 11, п. 3)
- [x] Груба сітка (Mesh 6): **4,49 млн комірок**, пограншар 20 шарів 15 мкм → 5 мм
- [x] Дрібна сітка (Mesh 7): **7,83 млн комірок**, 24 шари 8 мкм, поверхня 3 мм, коробка 8 мм. Якість: неортогональність до 88,4° у поодиноких призмах (межа 88), на 1 грані пограншар не ліг (прибрана як дрібна деталь)
- [x] Повна модель (Mesh 8): поверхня 4,5 мм, коробка 12 мм (y −0,75…0,75), 20 шарів 15 мкм → 5 мм, 168 граней
- [x] CSV розкладів кутів завантажені в A, B, F (вибір файлу — Віктор)
- [x] Керування: A і B 5600 ітерацій, F 2100, запис полів кожні 700, ліміт часу 1,5·10⁵ с
- [x] Сили F: усі 168 граней, точка моментів x = 0,5837
- [x] Запуск A-груба стартував 29.09 17:52: 8 ядер, ≈6,2 с на ітерацію → ≈9,5 год на 5600 ітерацій
- [x] Ітерація 1400→1446: кут перемикається з −3° на −4° (Fz півмоделі 31,6 → 21,2 Н і далі падає) — **механізм таблиці працює** (перевірено 29.09 20:28)
- [x] Mesh 8 (повна): **8,78 млн комірок**, неортогональність до 89° у поодиноких призмах, на 1 грані без пограншару (як у Mesh 7)
- [x] A-груба «A coarse 50-69 alpha-table» завершена 30.09 о 03:15: 9 год 23 хв, 8 ядер, 75 CPU-год
- [x] A-дрібна «A fine 50-69 alpha-table» завершена 01.10 о 02:48: 15 год 26 хв. Вердикт — розділ 10
- [x] B-дрібна «B fine 24 alpha-table» завершена 30.09 о 22:46: 11 год 22 хв
- [x] F «F full beta» завершена 30.09 о 16:59: 5 год 33 хв, 8 ядер, 44,5 CPU-год. Результат — розділ 9
- Скрипт обробки: `CFD/process_gnplus.py` (рівні → 1g, D, потужність, хвилини, NP, запас, CL_max)

Перед стартом SimScale попередив, що кілька комірок поза рекомендованою якістю. Це ті самі поодинокі призми нижче. Натиснуто Run anyway: сітки під ці запуски вже були прийняті.

## 7. Без джерела (для перевірки)

- Cd пластини 1,17–1,3; опір виступу стрижня 0,3–0,6 Н; губа капота — оцінки аудитора.
- Модель кутів 1g і NP відкалібрована лише на запуску R07a (MH 32).
- Поправка на гвинт −5,6 мм взята з R07c, під Clark Y не перераховувалась.
- Таблиця хвилин за профілями в хабі (Clark Y −4 хв) — без етапного файлу; аудитор оцінює −3…−4 хв як правдоподібне. ❌ CFD 01.10: на 180 км/год ≈ −7 хв (26 проти 33), розділ 10–12.

## 8. Неортогональність і наступна сітка (2026-09-30)

Неортогональність — кут між лінією центрів двох сусідніх комірок і нормаллю до спільної грані. **0° добре.**

| Кут | Що означає |
|---|---|
| до 70° | Нормальна сітка. OpenFOAM вважає перевірку пройденою |
| 70–80° | Ще рахується. Солвер виправляє нахил корекціями; у фізиці цього проєкту їх дві |
| 88° | Межа попередження SimScale |
| 90° | Злам схеми |

Mesh 7 має максимум **88,4°**, Mesh 8 — **89°**, лише в поодиноких призмах пограншару. На одній грані шар не ліг, її прибрали як дрібну деталь. Та сама картина була на Mesh 5, яка дорахувалась: 87 комірок вище 88°, це 0,002 % сітки.

Наступного разу не дрібнити весь літак. Погані комірки сидять там, де шар не лягає рівно: задня кромка, крутий хвостовий конус (до 15,6°) і стик крила з трубою без галтелі.

1. **Галтель у геометрії** на стику крила з трубою. Навіть маленький радіус тримає призми краще за повзунок сітки.
2. **Дрібнити лише ті ребра.** Автоматичні ~50 мм на Mesh 5 v1 дали сотні комірок за 88° і аспект до 7255. Явні 4 мм зняли майже всі. Mesh 7 на 3 мм усюди поодинокі призми не прибрав. Далі: 3–4,5 мм на гладкому, дрібніше на кромках, конусі й корені.
3. **Товщину шару лишати абсолютною, ріст не швидший за 1,2.** Закороткий шар R07a (1,4 мм, ріст 1,40, стрибок до тетраедра ×10…×25) завищив опір. Mesh 6 і 7 уже задають 5–6 мм. Якщо попередження повториться — менше шарів або трохи вища перша комірка, не повернення до тонкого шару.
4. **Рахувати комірки вище 88°, а не ганятися за одним кутом.** Перед запуском: скільки комірок за 88°, чи шар є на крилі й фюзеляжі, чи його товщина близька до пограншару, чи ріст ≤ 1,2.

## 9. Результат F (2026-09-30, до вердикту форми)

Повна модель, Mesh 8, 24,4 м/с, α = 3,5°. Плато — середнє останніх 200 ітерацій рівня (β 0: 1201–1400, β +5°: 1901–2100). Дрейф сил за останні 100 ітерацій менший за 0,005 Н, момент рискання — за 0,001 Н·м: рівні зійшлися. Сили — увесь літак, один монітор. Файл: `CFD/plateaus_F.json`.

| | β = 0° | β = +5° |
|---|---|---|
| Підйомна L | 79,7 Н | 78,9 Н |
| Опір D (тиск + тертя) | 6,21 Н (4,78 + 1,44) | 6,36 Н |
| D_льот = D_тиск + 1,35·D_тертя | 6,72 Н | — |
| Бокова Fy | 0,004 Н | −3,26 Н |
| Момент рискання Mz | +0,030 Н·м | **−1,59 Н·м** |

**Кіль тримає.** β додатне, Mz від'ємний — момент навколо +z протилежний ковзанню, як у критерії розділу 4. На β = 0 бокова сила і Mz майже нуль (0,03 Н·м проти 1,59 на β +5°): повна модель сама по собі симетрична.

~~Півмодель підтверджена.~~ ❌ ВИПРАВЛЕНО 01.10: **півмодель підтверджена за L і Cm** (+0,4 % і −1,2 %). Різниця D (+3 %) має підпис грубої сітки проти дрібної (тиск +6,8 %, тертя −7,4 %, як в етюді A), тож симетрію за опором цим не перевірено. Інтерполяція B (дрібна сітка, 2° і 4°) на α = 3,5° дає L = 79,4 Н і D = 6,02 Н. F на тому самому куті: L = 79,7 Н, D = 6,21 Н. CL з одного кута F — не CL_max.

Орієнтир розділу 3 на 88 км/год: турбулентний опір 5,3 Н при α 1g ≈ +3,9°. Тут α = 3,5°, L = 79,7 Н (вага 76 Н), D = 6,2 Н, L/D = 12,8. Той самий порядок, не розбіжність у рази. Сітка F груба.

## 10. Вердикт форми (2026-10-01)

A fine, B fine і F завершені. Нових запусків немає. Геометрію під ці числа не змінювати.

Точка моментів у солвері перевірена: x = 0,5837 м. У A і B два монітори. **«Forces and moments 2» — 128 граней, увесь літак.** «Forces and moments 1» — одна грань крила: її момент майже не змінюється з кутом, бо фокус крила сидить біля 25 % хорди. Вердикт нижче — тільки з монітора 2, сили півмоделі ×2. Плато — останні 200 ітерацій рівня. Файли: `CFD/plateaus_A_fine.json`, `plateaus_A_coarse.json`, `plateaus_B_fine.json`.

Кути 1g збіглися з оцінкою розділу 3 ❌ УТОЧНЕНО 01.10: на 180 і 250 км/год (різниця 0,05–0,06°); на 88 км/год CFD на 0,75° нижче оцінки. Опір вищий за ту оцінку, але того самого порядку.

| Режим | α 1g, CFD | α 1g, оцінка | D | D_льот | Вал на D_льот |
|---|---|---|---|---|---|
| 88 км/год, 24,4 м/с | +3,15° | +3,9° | 5,79 Н | 6,34 Н | 0,18 кВт |
| 180 км/год, 50 м/с | −2,75° | −2,7° | 13,29 Н | **15,33 Н** | 0,91 кВт |
| 250 км/год, 69,4 м/с | −3,66° | −3,6° | 24,13 Н | **27,69 Н** | **2,29 кВт** |

D_льот = D_тиск + 1,35·D_тертя. На 180 розклад D: тиск 7,48 Н, тертя 5,81 Н. З них крило ≈ 7,9 Н, фюзеляж і хвіст ≈ 5,4 Н. Ланцюг скрипта дає на D_льот близько **26 хв** на 180 км/год (книга R07c — 33 хв при 11,9 Н на MH 32). ЦМ 591 під Clark Y не перерахований.

**Пороги [[GN+]]**

1. **180 км/год, 16 Н — не спрацював.** D_льот = 15,3 Н. Груба сітка на тому самому 1g дала 16,3 Н. Запас до порога (0,7 Н) менший за різницю сіток (1,0 Н). Дрібна сітка — та, за якою поріг записаний, і вона нижче лінії. ❌ ДОПОВНЕНО 01.10: **номінально не спрацював, але в межах похибки не вирішено** — запас 0,7 Н менший і за різницю сіток (1,0 Н), і за смугу двосіткової оцінки 12,9–17,7 Н; екстраполяція Річардсона дає 13,3–14,5 Н (нижче лінії), а неврахований опір (обдув гвинтом, охолодження, щілини, рулі) тягне вгору. Розділ 12.
2. **Катапульта, 1,2·Vs > 25 м/с — не спрацював.** На 8° CL = 1,11, ~~рівень зійшовся~~ ❌ ВИПРАВЛЕНО 01.10: рівень майже зійшовся (дрейф L +0,26 Н/100 ітерацій, консервативно для катапульти), підйомна ще росте. З цього CL швидкість сходу 1,2·Vs = 23,2 м/с. На 10° CL дійшов 1,23, але дрейф сили 1,3 Н. На 12° підйомна за рівень упала на 8 Н — це не плато, кут зриву не виміряний. Навіть нижня межа (CL на 8°) стелю катапульти не переходить.
3. **Стійкість, 8–20 % хорди на x = 591 — не спрацював.** На 50 м/с, п'ять кутів −4…+2°: нейтральна точка **628 мм**, запас **16,7 %**, з поправкою гвинта −5,6 мм — **14 %**. На 24,4 м/с, кути 2…8°: 633 мм, 19 % і 16 % з гвинтом. Оцінка розділу 3 була 13–15 % з гвинтом. Груба сітка дає ту саму точку (628 мм). ~~Два кути на 69,4 м/с дають крутіший нахил; для порога їх замало.~~ ❌ ВИПРАВЛЕНО 01.10: два кути на 69,4 м/с на дрібній сітці дають 647 мм, але рівень −3,5° не зійшовся (дрейф My +0,9 Н·м/100 ітерацій); груба сітка на тих самих кутах — 630 мм. Це артефакт збіжності, не фізика. Друга умова порогу 3 (коробка ЦМ 575–596 тримає ≈12 %): з поправкою гвинта NP ≈ 622,6 мм → коробка дає ≈11,9–21,3 %, тобто передні ≈5 мм коробки виходять за 20 %. Передній край старої коробки ЦМ (575 мм) виходить на ≈24 % хорди, тобто вище 20 %, але поріг записаний на x = 591.
4. **2 кВт на 250 км/год — спрацював.** Вал = D·V / 0,84. На D_льот це **2,29 кВт**. На сирому D — 1,99 кВт, тобто стеля і без шорсткості. Груба сітка — 2,50 кВт. Ще один такий самий крок дрібнення (мінус ≈8 % опору) лишив би близько 2,1 кВт.

Поріг 2 кВт на рівно 250 км/год формально спрацював. На D_льот ті самі 2 кВт тримають близько ~~**238 км/год**~~ ❌ ВИПРАВЛЕНО 01.10: **≈235–238 км/год** — 238 спирається на незійдений рівень −3,5° на 69,4 м/с, що дрейфує в бік більшого опору; на рівно 250 км/год — 2,3–2,4 кВт на валу. Якщо 2 кВт — електричний ліміт мотора, а не вал, то вистачає лише до ≈225 км/год. Без поправки на шорсткість 250 км/год дає 1,99 кВт. **01.10 Віктор: цей результат наразі влаштовує, форму через нього не міняємо.** Кіль (розділ 9) і півмодель лишаються в силі. ⚠️ За правилом [[GN+]] («форму міняємо, якщо спрацьовує хоч один пункт») це **прийняття з винятком**, а не «жоден поріг не спрацював».

На 1g момент навколо ЦМ додатний (ніс угору). Щоб обнулити його, стабілізатору на 180 км/год потрібно близько +4 Н догори, тобто близько +0,9° до нинішніх 0°. Це балансування, не поріг.

## 11. Незалежний перерахунок і доповнення (2026-10-01, до адверсарної перевірки)

Сили заново вивантажено з SimScale API (ті самі 4 запуски, ті самі вікна: останні 200 ітерацій рівня), сирі плато — `CFD/raw_plateaus.json` з контрольними сумами, конвертер `CFD/gnplus_from_raw.py`, підсумок `CFD/gnplus_results.json`. **Усі числа розділів 9–10 відтворились до сотих** (15,33 Н; 27,69 Н; 2,29 кВт; NP 628 / 633 мм; 16,7 %). ⚠️ Файли `plateaus_A_coarse/A_fine/B_fine.json` при цьому перезаписані новим вивантаженням (той самий формат, ті самі середні, додано розмах Fz). `plateaus_F.json` не чіпав, мій F — `plateaus_F_full.json`.

Чого в розділі 10 немає:

1. **Поріг 16 Н залежить від формули поправки.** Розділ 10 рахує D_льот = D_тиск + 1,35·D_тертя (аудит, пункт 8) → 15,3 Н. ~~За формулою самого [[GN+]]~~ ❌ ВИПРАВЛЕНО: за старою формулою, яку аудит відхилив ще 29.09, до результатів ([[GN+-plan-do-audytu]]: D_i + 1,35·(D − D_i)), на тій самій дрібній сітці виходить **17,7 Н → 1,05 кВт, 22,5 хв** — поріг спрацював би. Живий [[GN+]] сам визначає D_льот = D_тиск + 1,35·D_тертя, тож 15,3 Н — заздалегідь зафіксована формула, не вибрана після результату. Обидва числа лишаються видимими.
2. **250 км/год спирається на незійдений рівень.** Рівень α −3,5° (перший після стрибка 50 → 69,4 м/с) за 700 ітерацій не встиг: дрейф Fz −1,2 Н, D ~~+0,24 Н~~ ❌ ВИПРАВЛЕНО: +0,31 Н (0,24 — це дрейф Fx в осях тіла, без проєкції на потік) на 100 ітерацій (повний літак); на грубій сітці той самий рівень: L −0,57 Н, D +0,13 Н. Рівень −4,5° зійшовся і дає майже той самий D (24,8 Н), тому D_1g ≈ 24–25 Н. Висновок «2 кВт не вистачає на рівно 250» від цього не змінюється, хіба посилюється.
3. **Тиск для охолодження не отримано.** Ні в одному запуску немає графіка точок тиску — зонди не записались, хоча в розділі 6 позначені. Додаткова перевірка 4 (розділ 5) не виконана. Потрібен постпроцесор або окремий запуск.
4. **Куди йде «зайвий» опір.** Порівняно з оцінкою розділу 3 (9,5 Н) CFD дає 13,3 Н на 180 км/год. Розклад на 1g (дрібна сітка, повний літак):

| | 180 км/год: D (тиск + тертя) | L | 250 км/год: D (тиск + тертя) | L |
|---|---|---|---|---|
| Крило | 7,9 Н (4,3 + 3,6) | 87,8 Н | 13,4 Н (6,9 + 6,5) | 106,9 Н |
| Фюзеляж + хвіст | 5,4 Н (**3,2** + 2,2) | −11,8 Н | 10,8 Н (**7,0** + 3,7) | −30,9 Н |

Опір тиску фюзеляжу з хвостом 3,2 Н на 50 м/с — це Cx ≈ 0,4 на лобову площу Ø80, удесятеро більше, ніж має тіло з подовженням 17. Кандидати: канавка й губа між коком і капотом, стик крила з трубою без галтелі (SST відомо завищує відрив у таких кутах), крутий конус 15,6° з плоским дном Ø30. Без картини напруження тертя (зони τx < 0) це гіпотеза, не висновок. ~~Якщо колись різати опір — дивитись сюди, не на профіль.~~ ❌ ВИПРАВЛЕНО 01.10 (перевірка): **головний кандидат — чисельний, не геометричний.** Надлишок сидить в опорі тиску, який між сітками падає на 8–21 %, і на крилі він такий самий аномальний (D_тиск крила 4,3 Н проти очікуваних ≈2 Н). Радіус передньої кромки Clark Y ≈2,5–2,8 мм — менший за комірку поверхні 3 мм; у NACA 0009 стабілізатора й кіля ≈1 мм проти 3–4,5 мм. Крім того, монітор «крило» — лише головна грань: торець задньої кромки і закінцівки потрапляють у «фюзеляж + хвіст» (≈0,1–0,3 Н). Тому і +40…46 % опору, і висновки про 2 кВт / 238 км/год можуть бути песимістичні (Річардсон на 250 км/год: 1,86–2,12 кВт). Що саме ріже опір, покажуть лише поле τ/Cp або сітка, згущена на передніх кромках.
5. **Сітковий етюд у кожній точці A:** дрібна сітка знизила D на 3,8–10,5 % (тиск −8…−21 %, тертя +5…+10 %), CL змінився ≤ 0,007, Cm ≤ 0,007. Різниця понад 5 % → ~~за правилом [[GN+]]~~ ❌ ВИПРАВЛЕНО: за правилом первісного тексту GN+ (29.09: «якщо дрібніша сітка зменшує CD більш ніж на 5 %… лишати дрібнішу і написати, що опір усе ще може бути завищений»; в архівний витяг [[GN+-plan-do-audytu]] це речення не потрапило) опір дрібної сітки ще може бути завищений. Сітки до того ж не систематичне дрібнення (комірок ×1,74, пограншар змінено 15 мкм/20 шарів → 8 мкм/24), тож порядок збіжності не визначений.
6. **Катапульта з балансуванням.** На 8° для балансу стабілізатор має дати −5,1 Н → CL_bal 1,06, схід **23,7 м/с** (без балансування — 23,2). На 6° CL_bal 0,91 → 25,6 м/с, тобто для сходу нижче 25 м/с потрібен кут ≥ ≈~~7°~~ 6,6° (інтерполяція). Вердикт тримається, поки маса ≤ ≈8,6 кг (на CL_bal 1,06); маса 7,75 кг під Ø80, алюмінієву трубу й батарею 2,7 кг не перерахована. Потрібний CL для 25 м/с — 0,95. На 10–14° залишки p 2·10⁻²…2,4·10⁻¹: розрахунок там не зійшовся, ці кути — не результат.
7. **Балансування на всіх режимах** (стабілізатор зараз 0°, оцінка ~~a_t ≈ 0,066/°~~ ❌ ВИПРАВЛЕНО: 0,066 — нахил без коефіцієнта 0,9; з ним a_t ≈ 0,061/°): 88 км/год ~~−1,9°~~ **−2,1°**, 180 км/год **+0,9°**, 250 км/год ~~+1,1°~~ **+1,2°** (250 — з незійденого рівня). Діапазон руля висоти на крейсерських режимах ≈ ~~3°~~ 3,3°. Без гвинта 0° стабілізатора балансує при CL ≈ 0,33 (≈127 км/год).
8. **Бічна стійкість (F, β +5°, стандартні осі):** Cn_β = **+0,124 /рад** (флюгерна стійкість є; +0,127 як різниця β 5° − 0°; знак надійний, величина ±15 %, без гвинта — він зменшив би приблизно на 0,02), Cl_β = ~~−0,061 /рад (поперечна V 2° працює)~~ ❌ ВИПРАВЛЕНО: ≈ **−0,06 /рад** (−0,059 як різниця), увесь літак; частину дає кіль, що стоїть вище осі, тож приписати це лише V 2° без окремого монітора не можна. Бокова сила −3,3 Н.
9. **Нейтральна точка залежить від вибору кутів:** B 2…6° → 626 мм (13,0 % з гвинтом), 2…8° → 633 мм (16,2 %), 4…8° → 637 мм (18,1 %). A −4…+2° → ~~627 мм (13,7 %)~~ ❌ ВИПРАВЛЕНО: 628 мм (14,2 % з гвинтом), як у розділі 10. Локально в точці 1g на 88 км/год (2…4°) — 627 мм, 13,7 %. Вище 6° Cm(CN) нелінійний. Усе в межах 8–20 %. Через CN чи CL — різниця < 0,3 мм.
10. **Узгодженість з оцінкою розділу 3:** α 1g −2,75 / −3,66 / +3,15° проти −2,7 / −3,6 / +3,9°; α нульової підйомної −4,6° проти −4,7°; CL_α 0,091 /° проти 0,081 /° (+12 %); NP 627–633 проти 625–630 мм. Опір: +40 % (180), +46 % (250), +9 % (88 км/год).
11. **Збіжність:** A — залишки p ≤ 2,6·10⁻⁴, дрейф сил < 0,05 Н/100 ітерацій ~~(крім пункту 2)~~ ❌ ВИПРАВЛЕНО: так на A-дрібній, крім пункту 2; на A-грубій ще α 0° (Fz −0,08 Н) і той самий рівень −3,5° на 69,4 м/с. 700 ітерацій вистачає на крок 1–2° при сталій швидкості, але не на стрибок швидкості — наступного разу такому рівню давати 1400. B 2–8° — p ≤ 8,8·10⁻⁴. y+ напряму не вивантажено. З середнього тертя: дрібна сітка ≈ 0,6 (50 м/с) і 0,8 (69,4 м/с), груба ≈ 1,1–1,5. На передніх кромках у 2–3 рази більше.
12. **Хто запускав.** A-дрібну, B-дрібну і F створено 30.09 об 11:22–11:24 (не з сесії, що їх налаштовувала). Імена й сітки відповідають плану. Витрачено: 4 запуски (лишилось **5 з 10** на рік), ≈335 CPU-год (лишилось ≈2630; години сіток ≈1 CPU-год не враховані).

## 12. Адверсарна перевірка (2026-10-01)

Окремий прохід, 2 агенти, лише читання. Перший незалежно перерахував усі сили з `CFD/raw_plateaus.json` власним скриптом. Другий намагався спростувати методику й вердикт.

**Підтверджено.** Контрольні суми; формули підйомної сили, опору й моменту; подвоєння півмоделі; перенесення моменту на ЦМ (+(x_ЦМ − x_ref)·Fz); NP = x_ref − c·dCm/dCN; ланцюг потужності; хвилини. Усі головні числа розділу 10 і хабу збігаються до 4 знаків. Знак кіля виведено з перших принципів: β +5° → Uy < 0 → вітер справа; Mz < 0 навколо +z повертає ніс у вітер, отже момент відновлювальний. Поправка гвинта −5,6 мм зсуває NP вперед, тобто консервативна для нижньої межі 8 %. Помилки налаштування немає. Нахил CL крила за його головною гранню 0,0786/° — те саме, що теорія Гельмбольда для AR 6 (0,079/°). Знаки навантаження стабілізатора узгоджені.

**Що змінює прочитання вердикту:**

1. **Прийняття форми — виняток, а не «жоден поріг не спрацював».** Поріг 2 кВт на 250 км/год спрацював. Рішення Віктора 01.10 це свідомо приймає.
2. **16 Н на 180 км/год — номінально пройдено, але в межах похибки не вирішено.** Отримано 15,3 Н проти смуги 12,9–17,7 Н. Ймовірніше нижче лінії (Річардсон 13,3–14,5 Н), але неврахований опір тягне вгору.
3. **Усе на 250 км/год спирається на незійдений рівень.** Це ≈235–238 км/год, 2,3–2,4 кВт, «крутіший нахил» і балансування +1,2°.
4. **Надлишок опору (+40…46 %) ймовірно здебільшого чисельний.** Він сидить у тиску на передніх кромках при комірці ≈ радіусу кромки. Отже 2 кВт / 238 км/год можуть бути песимістичні. Атрибуцію опору фюзеляжу знято.
5. **База 2 кВт не визначена.** Якщо це вал — ≈238 км/год. Якщо електрика (×1,18) — ≈225 км/год.
6. **Час польоту — головна метрика проєкту.** На 180 км/год CFD дає ≈26 хв (22,5 за старою формулою) проти книжкових 33 хв, тобто −7 хв, а не очікувані −4.

**Дрібні виправлення:** позначені ❌ ВИПРАВЛЕНО в розділах 4, 5, 6, 9, 10, 11. Скрипт `process_gnplus.py` виправлено: дрейф D з проєкцією на потік, a_t з коефіцієнтом 0,9, CL_max лише зі зійдених рівнів.

**Що лишилось невиконаним:**
- тиск у точках для охолодження;
- поле τ і y+ на інших кутах (α −3°, 50 м/с — розділ 13);
- y+ на передній кромці окремо від середнього по літаку, на 250 км/год.

Варіанти:
- **Постпроцесор SimScale** на наявних результатах — безкоштовно за квотою. Площа τx > 0 і y+ на α −3°, 50 м/с уже зняті (розділ 13). Лишились інші кути і тиск для охолодження.
- **Запуск із сіткою, згущеною на передніх кромках** — вирішив би 16 Н і 2 кВт. Коштує 1 з 5 запусків і ≈20–25 год.

⚠️ Папка proj. Gungnear не в git. Первинні `plateaus_A/B` того чату перезаписані тим самим вмістом за середніми, звірити розділ 10 з його власними вхідними файлами вже не можна. Залишки збіжності в цьому розділі взято з графіків SimScale наживо, файлом не збережені.

## 13. Поле тертя, α −3° (2026-10-01)

A-дрібна, перший записаний кадр: кінець рівня α −3°, 50 м/с (ітерація 1400). Це сусід кута 1g на 180 км/год (−2,75°). Шкала τx від −0,05 до +0,05 Па, щоб зворотне тертя стало червоним.

**Що видно.** Зверху потік прилеглий. Світлі плями біля задньої кромки — τ ≈ 0 на торці тупої кромки 0,67 мм, не міхур відриву. Знизу, після площини z = −0,35 м, теж прилеглий: червоного немає, крім цятки на нижньому кінчику коку. Темні смуги — ребра згущення сітки.

**Вибірка звірена з монітором.** Перший клік дав грань 192 м² — це дно домену (24 м × 8 м), не літак. Після приховування граней домену статистика по 132 гранях: ∫ τx = −2,896 Н. Монітор тертя цього рівня, півмодель, Fv_x = +2,9026 Н (середнє ітерацій 1201–1400, `plateaus_A_fine.json`). Різниця 0,2 % — кадр кінця рівня проти середнього плато, не чужі грані. Знак: +x у хвіст; на прилеглому потоці напруження на рідину дивиться проти потоку, тож τx < 0, а сила на літак додатна. Зворотна течія була б τx > 0.

**Площа зворотної течії.** Поле `wallShearStress` з кадру ітерації 1400 (кінець рівня α −3°). Індикатор (τx + |τx|) / (2|τx|) дорівнює 1 там, де τx > 0. По 127 гранях типу wall, півмодель:

| | |
|---|---|
| Змочена площа | 0,515 м² |
| Площа τx > 0 | **29,2 см²** (0,57 %) |
| з них τx > 0,05 Па | 25,5 см² |
| Сила цих зон, +x | +0,0067 Н |
| ∫τx по всіх стінках | **−2,904 Н** |

∫τx збігається з монітором тертя +2,9026 Н (сила на літак — протилежний знак). 29 см² — не пил від нуля: середнє τx там 2,3 Па, максимум 30 Па. Уздовж x ця площа сидить трьома смугами: 10,3 см² на 0…0,20 м (ніс), 12,7 см² на 0,39…0,59 м (крило), 5,4 см² на 1,18…1,37 м (хвіст). На повному літаку дзеркально це близько 58 см². Внесок у опір 0,007 Н проти зайвих ≈3,8 Н: зірваний слід цей опір не робить.

**y+ на цьому ж кадрі**, прямо з поля: середнє по площі 0,58, максимум 2,22. Частка площі з y+ > 1 — 0,8 %. Вище 5 немає. Оцінка з середнього тертя (≈0,6) підтвердилась.

На цьому куті великого відриву немає. Кути катапульти цим кадром не перевірені.
