NetHunter123/Jflyproject/Zbirka-shpilky.md

---
tags:
  - project
  - engineering
  - gungnear
status: 💡 робоча ідея збірки
updated: 2026-09-28
gutter: Ø80
---

# Збірка light+ на шпильках

> Ідея Віктора, 2026-09-28. Оцінка нижче. Робоча конфігурація — [[Gungnear v1 light+]].

## Як збирати

1. Ринва **Ø80**, ≈1110 мм. Два отвори під гільзу джойнера Ø16.
2. Буртик на отвір, щоб стрижень крила не витягував край стінки 0,7 мм в овал.
3. Розпірне кільце засовується з торця до цих отворів. У ньому вже стоять роз’єми (силовий і сигнальний) і гнізда під шпильки.
4. Гільза вставляється крізь обидва отвори і крізь кільце. Вона фіксує кільце на місці.
5. У кільце ставляться **дві четвірки** шпильок: одна вперед, до носа, друга назад, до хвоста. Не одна шпилька на всю довжину.
6. На шпильки надягають передній і задній блоки.
7. Ніс (з моторною пластиною) і хвостовий конус притягуються гайками на кінцях тих самих шпильок.

## Оцінка

Схема робоча. Шпильки всередині труби, тож зовні немає ні заклепок, ні головок, і опору від кріплення немає. Вони ж напрямні для блоків і розтяжки, якими ніс і хвіст тримаються на корпусі.

**Шпильки фіксувати в кільці.** Наскрізного каналу без упора мало: гайка на носі просто витягне шпильку крізь кільце, і тязі мотора нікуди спертись. Кільце — якір. Різьбова втулка або дві гайки по боках кільця. Вільний кінець дивиться в ніс або в хвіст, на нього надягається блок, потім кришка і гайка.

Кільце передає цю тягу на трубу через гільзу і буртик. Тяга близько 30–50 Н, для джойнера, який і так несе крило, це добавка мала.

**Чотири шпильки, не шість.** Ставити їх хрестом під 45° до крила. Ліворуч і праворуч, в площині крила, шпилька впреться в гільзу.

**Не тягнути одну шпильку від носа до хвоста.** Передня четвірка йде від кільця до носа (≈470 мм по алюмінію), задня — від кільця до конуса (≈640 мм). Так їх можна вкрутити в уже встановлене кільце з відкритого торця. Суцільна шпилька на 1,1 м провисає і зв’язує ніс із хвостом намертво: алюміній і сталь гріються по-різному, збірка клинить.

**Батарея майже не лишає місця.** Пакет 21700 хоче близько Ø70 мм, ринва Ø76 × 0,7 має всередині ≈74,6 мм. З кожного боку лишається ≈2,5 мм. Шпилька М4 (4 мм) поруч із круглим пакетом не проходить. М3 проходить лише в западинах між комірками, якщо блок надрукований з канавками під шпильки. Камери вантажу Ø66 мм місце дають. У моделі блока ці канавки мають бути від початку.

Краще гладкий стрижень із різьбою лише на кінцях. Повна різьба на всій довжині дере друкований блок, коли його засовуєш.

Шпильки не замінюють трубу як балку. Вони тримають кришки і ведуть блоки. Згин крила лишається на алюмінії.

## Діаметр і пробки (2026-09-28)

Ринва **Ø80**. Шкіра носа і конуса врівень із зовнішнім діаметром, пробка всередині з зазором 0,4 мм на радіус (стінка 0,7 мм; якщо реально 0,6 — зазор трохи більший).

Довгі пробки не потрібні: кут і відрив тримають торець труби і чотири шпильки. Пробка лише центрує кришку.

- Ніс: **20 мм**. Довша залізла б у передню батарею (вона починається за 16 мм від торця труби).
- Хвіст: **25 мм**. Трохи довше, бо корінь кіля сидить на цьому стику. Авіоніка на x≈1132 лишається вільною.

## Що мають зійтись у 3D-моделях

Ніс, хвіст і кільце — один шаблон отворів: 4 шпильки, той самий діаметр кола, ті самі кути 45° до крила.

- Ніс розділений. **Кок** (до x=33 мм) кріпиться до гвинта, в силову оболонку не входить. **Корпус** починається з x=39 мм: щілина 6 мм — вхід повітря на мотор, чотири пази за мотором — вихід. Кок не прибираємо: він легкий і закриває гайку.
- Хвіст: конус 141 мм + пробка **25 мм**. Кіль і стабілізатор на конусі. Два серво в порожнині конуса, тяги до керма висоти і до кіля. У плоскому торці Ø30 — вихідний отвір Ø20.

## Потік охолодження — НЕ ВИРІШЕНО (2026-09-28)

Система охолодження мотора і батареї **не вибрана**, але вона в плані. Рішення 01.10: робити її **разом із начинкою**, не окремо після стовбура. Внутрішній хід повітря має охолоджувати мотор і батарею, а не бути дірками, пробитими в уже зібраній укладці. Записаний нижче хід — лише один із варіантів, не рішення.

Що відомо:

- Глухий капот мотор перегріє. Голий мотор у струмені гвинта холодніший і надійніший, але бруднить ніс.
- Щілина за коком — прийнятний вхід. Чотири бічні пази як єдиний вихід — штраф на обтіканні. Вихід у торець хвоста для опору найспокійніший.
- Довгий хід «ніс → уся труба → хвіст» гріє батарею повітрям, яке вже пройшло мотор. Батарея і сама гріється на крейсері (близько 6 А на комірку).
- Отвори в циліндрі фюзеляжу для вентиляції батареї **не вирішені**. Малі круглі — дешевий опір і майже не ламають трубу. Великі прорізи — уже і опір, і місцева слабкість. Їх не ставити біля джойнера.

Поки немає рішення, у міцнісну модель не закладати ні бічні пази носа, ні отвори фюзеляжу як остаточні.

Ідея 01.10, не рішення. Окремі канали в зазорі між стовбуром і стінкою ринви, вихід у хвіст: свій шлях від мотора, свій для батареї і плат. Так мотор не гріє батарею своїм повітрям. Тягне не «димар». Труба лежить горизонтально, гаряче повітря піднімається лише на її діаметр і далі саме не йде. Перепад від висоти Ø80 — близько 0,1 Па. Зустрічний тиск на 88 км/год — близько 365 Па, тобто потік дають гвинт і швидкість: вхід у щілині за коком, вихід у торці хвоста. Зазор малий, близько 4 мм на пакет Ø70 у ринві Ø80, тож довгий тонкий канал легко задихнеться. Шлях мотора краще тримати коротким.
- Кільце: отвір під гільзу, 4 різьбові гнізда, роз’єми поза площиною крила.
