NetHunter123/Jflyproject/configs/gungnear-v1-light-plus/Gungnear v1 light+.md

---
tags:
  - project
  - engineering
  - gungnear
config: gungnear-v1-light-plus
status: 🔧 робоча збірка (рішення 2026-09-28)
updated: 2026-09-30
---

# Gungnear v1 light+

> [[Gungnear v1 light]] з подовженим фюзеляжем під **+2 кг щільного вантажу**, крейсер ~180 км/год. Числа перевірено в [[R07c-Light-Plus]] (розділ R07c-V).
> CAD робочої збірки: `gungnear-v1-light-plus.step` у цій папці. Генератор: `CAD/model1.py --config light-plus`.
> Симуляційна модель зовнішньої форми: **[[GN+]]**, файли `CAD/GN+.step` і `CAD/GN+.stl`. Генератор цієї моделі — `python CAD/gn_detail.py`. Команда `model1.py --out GN+` будує інше тіло і перезапише файл.
> GitHub (приватний): `NetHunter123/gungnear`, тег `gungnear-v1-light-plus`.

![[gungnear-r07c-v1-light-plus.png]]

> [!note] 🎯 РІШЕННЯ 2026-09-28
> Робоча збірка. Труба — **алюмінієвий водостік Ø80, суцільна, без люків**. Шкіра кришок врівень, пробка 20 мм (ніс) і 25 мм (хвіст). Охолодження мотора і батареї **не вирішене**. Деталі — [[Zbirka-shpilky]]. Джойнер Ø16 проходить крізь втулку. Начинка на **двох друкованих стовбурах**: передній (батарея + 1 кг) через знімний ніс, задній (батарея + 1 кг + авіоніка) через знімний конус. Стабілізатор і кіль сидять на конусі. Кришки на **4 шпильках** з розпірного кільця біля джойнера, без заклепок. Збірка — [[Zbirka-shpilky]]. Комірка — клас 21700, не конкретна модель; у масі лишаємо **≈2,7 кг / ≈580 Вт·год**.
>
> Труба для збірки — [[R07f-Fertigrohr]]. Чому відкинули папір і ПВХ — [[R07e-Rumpf-Material]] в архіві.

## Геометрія

Таблиця нижче — розрахунок R07c. Рядок паперової труби Ø75 описує ту модель мас. Збірка тепер ринва Ø80 без люків; числа польоту під це не перераховані.

| | light | **light+** |
|---|---|---|
| Корпус (ніс → дно конуса) | 900 мм | **1371,3 мм** |
| Паперова труба Klima Ø75 / 72,6 | 639 мм | **1110,3 мм** (x 120–1230,3; шматки 469 + 500 + 141) |
| Крило (AR 6, +2°, V 2°) | 0,25 м², 1224,7 × 204,1, MH 32 | **0,30 м², 1341,6 × 223,6 мм, Clark Y** (з 2026-09-29; далі NACA 4412). Числа польоту нижче — ще на MH 32 |
| Передня кромка / c/4 / джойнер | 304 / 355 / 361 (Ø14) | **527,8 / 583,7 / 589,25 (Ø16)** |
| Стабілізатор (NACA 0009) | 470 × 118 | **432,5 × 108,7 мм**, плече 701 мм |
| Кіль | 150 / 100 × 190 | **137,6 / 91,7 × 174,3 мм** |
| V_H / V_V | 0,491 / 0,0345 | ті самі |
| Висота | 257,5 | 241,8 мм |
| Змочена площа | 0,820 м² | 1,0075 м² |
| Шасі | немає | немає |

## Компонування

Це розклад R07c, на ньому стоять маси в таблиці нижче. Збірка 2026-09-28 інша: без люків, два стовбури, охолодження не вибране — [[Zbirka-shpilky]].

- **Вантажний відсік** 456 мм вставлено в зазор джойнера, між блоками батареї.
- **Дві камери Ø66 × 220 мм, по 1 кг** (разом 1,5 л для циліндричного вантажу; для прямокутного лише ≈0,96 л): x 354–574 і 604–824, симетрично ±125 мм від джойнера. Центр вантажу збігається з ЦМ.
- **Батарея:** передній блок x 136–350, задній 843–1058 (на 15-мм розпірці).
- **Авіоніка** (FC/GPS/приймач/BEC) перенесена в корму x ≈1132, серви хвоста x ≈1142. ESC — у спинному обтічнику над носом.
- **Люки:** 2 батарейні + 2 вантажні (дуга ≈131°), кришки мають нести зсув. 4 вуглецеві стрічки 1 × 6 мм уздовж відсіку.
- **Гак катапульти** — на рамі крила, x 578–600.

## Силова установка (стандарт, без змін)

Мотор 1,5–2 кВт, ~380–420 kV, 12S; гвинт APC 11×14 (фіксований, тягнучий); ESC 80 A HV; батарея 12S3P Molicel P45B, 583 Вт·год, 2,63 кг.

## Маса, центрування, характеристики (розрахунок, перевірено R07c-V)

| | порожній | **з вантажем 2 кг** |
|---|---|---|
| Маса | ≈5,75 кг (4,82–6,97) | **≈7,75 кг (6,82–8,97)** |
| Центр мас | ≈591 мм | ≈590,6 мм |
| Нейтральна точка / запас | ≈618 мм / ≈12 % | ≈618 мм / ≈12 % |
| Межі ЦМ | 575–596 мм (перші польоти 583–590) | |
| 180 км/год | ≈103 км, 34 хв | **11,9 Н, ≈0,83 кВт з батареї, ≈19 А, ≈33 хв, ≈90–100 км** |
| 200 км/год | ≈87 км | ≈80–85 км |
| Найдовший політ | ≈145 хв на 75 км/год | ≈96 хв на 88 км/год |
| Максимум (1,5 / 2 кВт на валу) | 242 / 269 км/год | 241 / 268 км/год |
| Зрив | 63 км/год | 73 км/год |
| Схід із катапульти 1,2·Vs | 20,9 м/с | **24,4 м/с, 2,3 кДж** (з візком 2,8) |

## ⚠️ Обмеження

- **Вантаж — тільки дві рівні половини.** 1 кг в одній камері зсуває ЦМ на ±19 мм, це поза межами.
- **Міцність паперу з люками** (22–47 МПа, кручення ÷4 500) стосується старого корпусу. Збірка тепер суцільна ринва без люків; той розрахунок її не описує.
- Жодна маса не зважена.
