NetHunter123/Jflyproject/_Archiv/R05-Fluegel-Hardware.md

---
tags:
  - project
  - engineering
  - gungnear
etappe: R05
status: 💾 дослідження записано, перевірка попереду
updated: 2026-09-24
---

# R05 — Крило, шасі, залізо, збірка

> ⚠️ **ДОСЛІДНИЦЬКИЙ прохід. Перевірка ще не проводилась.** 4 агенти. База: [[R04-Cruise-Payload]].

---

## 1️⃣ Крило — і несподіваний розворот

### Відображення «посадкова швидкість → площа крила»

При масі 5,26 кг, 333 Вт·год, із перерахунком гвинта в кожній точці:

| Приймаєте посадку на… | Крило | Дальність @200 | Час @200 |
|---|---|---|---|
| 76 км/год — колеса, трава, звичайне поле | 0,21 м² (як зараз) | 82,5 км | 24,8 хв |
| 90 км/год — колеса + закрилки, довга смуга | 0,15 м² | 97,7 км | 29,3 хв |
| **100 км/год — колеса з гальмами на асфальті або черево** | **0,12 м², розмах 849 мм, хорда 141 мм** | **106,0 км** | **31,8 хв** |
| 107 км/год — черево по траві, без шасі | 0,105 м² | 110,3 км | 33,1 хв |
| 116 км/год — черево, і ви готові щось ламати | 0,09 м² | 114,4 км | 34,3 хв |

Теоретичний мінімум опору — 0,055 м² (120,4 км), але зі швидкістю зриву 128 км/год. Нелітабельно.

**Рекомендація агента: 0,12 м², а не 0,105.** Це забирає 62 % усього доступного виграшу, а курс обміну далі різко гіршає: між 0,21 і 0,15 м² ви купуєте **1,09 км дальності за кожен км/год** посадкової швидкості, між 0,12 і 0,105 — лише **0,62 км**.

### 🔴 Але є розворот, який усе змінює

> **Якщо ваша справжня метрика — час у повітрі, а не кілометри, то зменшувати крило НЕ ТРЕБА. Це коштує 37 %.**

R04 встановив: корисна дальність видимості за VLOS — 550–820 м. Тобто **кілометри безглузді, метрика — хвилини**.

І якщо дозволити швидкості бути вільною:

| Крило | Найдовший політ | На якій швидкості |
|---|---|---|
| **0,21 м² (як зараз)** | **134,7 хв** | 86 км/год |
| 0,105 м² | 84,4 хв | 122 км/год |

Мале крило програє, бо **не може летіти достатньо повільно**, щоб дійти до власної швидкості мінімальної потужності.

**Мале крило виграє тільки якщо 200 км/год — вимога, а не наслідок.** Це ваше рішення.

### Гвинт лишається APC 11×14

Перебір 158 гвинтів APC: на новій меншій тязі ККД падає 0,8465 → 0,8236, і 7×11E формально кращий (0,8338, +1,2 %). **Але 7×11E не тягне ривок на 344 км/год** — йому треба понад 21 429 об/хв, а це за межею його ліміту. 11×14 робить ривок на 16 212 об/хв (ККД 0,8603), лишаючись у межах 17 273.

Хвіст: масштабувати **за коефіцієнтами об'єму**, не відсотком. Це варте **+10 процентних пунктів** — із замороженим хвостом 0,105 м² дає лише 100,3 км замість 110,3.

Подовження і профіль третьорядні: AR 6→8 дає +1,5 %, тонкий профіль (RG 15 / MH 32, t/c 9 %) +1,9 %.

---

## 2️⃣ Шасі — і конфлікт, який доведеться вирішити

### Пропущений опір більший, ніж думали

| Варіант | Опір @200 км/год | Частка крейсерського опору | Дальність |
|---|---|---|---|
| Немає шасі | 0 | 0 % | 110,3 км |
| Забиране, прибране | <0,2 Н | ~2 % | 106,3 км |
| Обтічене нерухоме | 2,0 Н | 16–20 % | 89,4 км |
| **Голе дротяне** | **4,3–7,4 Н** | **29–49 %** | **67,6 км** |

R04 казав 15 %. Насправді до **половини всього крейсерського опору**.

### Але колеса без гальм не сідають на реальне поле

| | Пробіг після посадки |
|---|---|
| Колеса без гальм | **240–680 м** |
| Колеса з гальмами | 65–130 м |
| Черево по траві | **60–120 м** |

Типові німецькі клубні смуги: FMSG Alling 100×25 м, Aero-Club Bamberg 150×20 м.

**Колеса без гальм — це пристрій для зльоту, а не для посадки.**

### 🔴 Крux: гвинт і черево не поєднуються

**Кінець лопаті APC 11×14 стоїть на 102 мм нижче лінії черева** труби Ø75 мм (139,7 − 37,5).

**Посадка на черево знищує гвинт щоразу.**

Єдиний вихід зі списку — **складаний гвинт RFM 10×16 CFK (€41,90, 254 мм, 17 000 об/хв)**. Але це 10-дюймова лопать із невідомою кривою Ct(J), тож **відповідь про гвинт доведеться відкривати заново**.

### Рекомендація агента

> **Без шасі взагалі: зліт із візка, посадка на черево, складаний гвинт, щілинні закрилки — і крило ближче до 0,15 м², ніж до 0,105.**

| Елемент | Вибір |
|---|---|
| Шасі | немає; лижа зі склопластику 3 мм на задніх 400 мм труби (~50 г, ~€20) |
| Закрилки | щілинні, 25–30 % хорди, 55 % розмаху, 2 серви, 60° на посадку. CL_max 1,00 → 1,22 |
| Зліт | візок по смузі: 24–74 м. Альтернатива — гумовий катапульт |
| Посадка | черево: 61–120 м по траві |
| Поле | трава ≥120 м корисних, ≥20 м завширшки, +60 м запасу |

При 0,15 м² із закрилками й без шасі: зрив 76,6 км/год, торкання 88,1 км/год, зліт ~45 м, пробіг ~85 м, **дальність ~92 км / 27,5 хв**. Половина призу за зменшення крила, але ви лишаєтесь у межах реального поля.

**Нерухоме шасі — єдиний варіант, який агент відмовляється будувати:** платить повний штраф за опір і все одно не зупиняє апарат на вашому полі.

⚠️ Катапульта: мале крило **тихо викреслює її** — запуск 0,105 м² потребує 29,7 м/с і 775 Н натягу при 15 g, це вище за всі знайдені каталожні вироби.

---

## 3️⃣ Збірка: обробка, хвіст, матеріали

### Обробка поверхні — менше, ніж здається, але правильна

Бюджет шорсткості на 55,6 м/с: **k_s = 26,3 мкм** (Гернер) або 16–18 мкм (Реймер).

> **20 % дальності купується знищенням слідів шарів друку (k_s 100–200 → ~20 мкм), а не тим, щоб зробити апарат блискучим.**

**Полірування й мокре шліфування до P1000 дають рівно нуль.** Будь-яке зерно від P240 уже в бюджеті.

**Розклад:** шпаклівка мікросферами + епоксидка → P180 → P240 → 2K епоксидний ґрунт-філер (Mipa, €22,95/400 мл) → P320 → 2K емаль. **Зупинитись тут.** +61 г, ~15 годин.

Годити варто на **крило й хвіст — це 75 % штрафу за шорсткість**, особливо на зовнішні 69 % розмаху поза струменем гвинта.

**Суперечка аудиторів R04 вирішена:** обидва міряли ту саму поверхню, але різні параметри. 10–25 мкм — це Ra, і це правильно. 100–200 мкм — це розмах піка-впадини (Rz), і це теж правильно. Але **k_s слідує за Rz, а не за Ra** — тож висновок аудитора B був правильний, а обґрунтування нечітке.

### 🔴 Бот-тейл, як намальовано, ГІРШИЙ за його відсутність

| Варіант | Опір |
|---|---|
| Просто обрізана труба | 0,581 Н |
| **Зірваний конус 18,4° (як намальовано)** | **0,643 Н** |
| Правильний конус 10° до Ø45 мм | **0,239 Н** |

Зірваний бот-тейл повертається до опору обрізаного циліндра, **але ви ще й платите за додаткову змочену поверхню**.

**Використати прямий конус із півкутом 10°, а не дугу** — при однаковій довжині дуга має більшу змочену площу. У межах 900 мм корпусу: 75 → 30 мм на довжині 141 мм дає економію 0,61 Н = **5,7 % крейсерського опору**.

*(Поправка: опір основи — 5,45 % крейсерського опору, а не 15 %, як казав R04.)*

### Ніс майже не має значення

M = 0,163 → хвильовий опір тотожно нуль. Різниця між оживалом, еліпсом і формою Хаака — лише в змоченій площі проти внутрішнього об'єму. Еліпс коштує +0,04 Н (**0,4 % опору**) і дає **+110 см³ корисного об'єму** в носі. Ваш вибір.

### Не друкуйте фюзеляж

| Варіант | Маса | Жорсткість EI |
|---|---|---|
| Друк PETG 1,2 мм | 318 г | 379 Н·м² |
| **Паперова труба Klima** | **216 г** | ~~**~758 Н·м²**~~ ❌ R07e: **≈379** (гола, E 2 ГПа); ≈730 з 1 шаром скла; ≈1 880 з 1 шаром карбону |
| Формований карбон | 127 г | ~4 565 Н·м² |

Друкована труба — одночасно найважча і найм'якша. **Klima: €9,90 за 500 мм, зовнішній діаметр рівно 75,0 мм.**

Друкувати варто ніс, бот-тейл і шпангоути. **Якщо друкуєте — орієнтуйте шари вздовж потоку, а не впоперек**: кільцеві сліди на надрукованому сторч корпусі — це поперечні ребра, найгірша можлива топографія. Різниця ~10 км дальності.

---

## 4️⃣ Залізо

| Що | Модель | Ціна |
|---|---|---|
| Мотор | **Scorpion HKIV-4035-450KV** (450 kV, 3 330 Вт тривало, 456 г, 12S) | €319,00 |
| ESC | **YGE Aureus 105 V2** (105 A / 170 A, 6–12S) | €369,00 |
| Батарея | **12S3P Molicel P45B самозбір**, 36 комірок, 583 Вт·год, 2,85 кг, 205 Вт·год/кг | €215,64 + ~€50 |
| Гвинт | APC 11×14 Sport | €6,40 |
| **Разом залізо** | | **~€997** |
| Інструмент (одноразово) | зварювальник kWeld €169 + зарядник iCharger X12 €246,90 | €443–533 |

### Три різні випадки визначають три компоненти
- **Мотор** — ривком на 344 км/год: 2 375 Вт на валу, 17 100 об/хв, 64,7 A
- **ESC** — низькошвидкісним перехідним режимом: без обмеження система тягне 130–170 A, у 2,5 раза більше за ривок
- **Батарея** — енергією крейсеру, не струмом. На 200 км/год це 1,04 C і 4,7 A на комірку з 45 доступних. Обмежує вона **максимальну швидкість** через внутрішній опір: просадка 4,5 В при 65 A → стеля 342 км/год на свіжому пакеті й 321 км/год наприкінці

### ⚠️ Обов'язкові налаштування до першого польоту
1. **Ліміт струму ESC 95 A** — це 5-секундний пік мотора
2. **Ліміт обертів 16 500** — при 450 kV на свіжому 12S холості оберти 22 140, тобто **на 28 % вище за ліміт гвинта APC**. Зірвана лопать несе 438 Дж, і ніщо їх не тримає
3. М'який старт; не відкривати газ повністю нижче ~100 км/год
4. Охолодження: вхід 8–10 мм перед мотором + узгоджений вихід. 164 Вт у мотор 456 г — це +192 K за 4 хвилини ривка
5. Запобіжник ANL 100 A між пакетом і ESC

**Пакет збирати як два блоки 6S3P послідовно**, не один 12S3P: дешевший зарядник, удвічі менше балансирних дротів, і якщо помилитись — замкнете 3 комірки, а не 12.

**Чи має аматор варити пакет?** Так — але тільки нормальним інструментом. Комірки 21700 **не можна паяти**. Економіка вирішальна: €0,370/Вт·год проти €1,211/Вт·год. Проти: 36 комірок без BMS, 583 Вт·год пожежного навантаження в апараті, що сідає на черево, і обов'язкова дисципліна балансування з журналом. **Не готові вести журнал — беріть LiPo і змиріться з 18,5 хвилинами.**

---

## 🔴 Дві речі, які ламають наявний проєкт

**1. Лонжерон крила проходить крізь батарею.** При 28 % САХ лонжерон стоїть на 361 мм від носа, а пакет 12S3P займає 180–602 мм. Треба або ділити пакет на дві частини спереду й ззаду лонжерона, або робити сідлове кріплення крила.

**2. Розбіжність енергії 583 проти 333 Вт·год.** 12S3P × 16,2 Вт·год = **583 Вт·год**, а вся дальність рахувалась на **333**. Або ви возите 250 Вт·год (1,2 кг комірок), які ніколи не використовуєте, — або моделі маси й енергії суперечать одна одній. **Це треба закрити до того, як різати крило**, бо воно визначає і масу, і центрування.

---

## 🔍 ПЕРЕВІРКА, ПРОХІД A (2026-09-24): крило + залізо

| Розділ | Вердикт |
|---|---|
| **Крило** | ✅ вистояв із поправками — але механізм був хибний |
| **Залізо** | ❌ **НЕ ВИСТОЯВ** — пакет неправильно розрахований, мотора не існує в продажу |

Вигаданих деталей у списку немає: **усі характеристики перевірені дослівно** в Scorpion, YGE, APC і Molicel.

---

### ✅ Крило: висновок правильний, три речі під ним — ні

**Розворот справжній, і рекомендацію НЕ різати крило підтверджено.** Аудитор відтворив базову точку з реальних файлів APC: 10 165 об/хв, ККД 0,8494, 804 Вт проти 10 155 / 0,8465 / 805 у первинному розрахунку.

**Але 37 % — неправильно, і всі чотири швидкості теж.**

Аудитор відновив, звідки взялись 134,7 і 84,4 хв: обидва крила рахувались на швидкості **мінімального ОПОРУ**, а не мінімальної **ПОТУЖНОСТІ**. І гвинт не перераховувався — використали ККД 0,8465 із 200 км/год на швидкостях 24 і 34 м/с.

> Для витривалості потрібен мінімум **потужності**, а не опору. Це різні точки.

| | Було | Правильно |
|---|---|---|
| Велике крило 0,21 м² | 134,7 хв на 86 км/год | **118–126 хв на 70–74 км/год** |
| Мале крило 0,105 м² | 84,4 хв на 122 км/год | **85–88 хв на 93–96 км/год** |
| Штраф за різання | 37 % | **28–30 %** |

Результат стійкий: 27,6 % при e = 0,85, 27,9 % при e = 0,65.

### 🔴 Механізм був хибний — і це небезпечно

Я написав, що мале крило програє, бо «не може летіти достатньо повільно». **Аудитор перевірив прямо: прибрав обмеження зриву — результат не змінився на жодну значущу цифру. Вартість обмеження зриву 0,00 % для обох крил.**

Справжня причина прозаїчна: **половина паразитного опору не зникає разом із крилом.** При 0,105 м² із 6,88 Н паразитного опору 3,50 Н — це `f_misc` і фюзеляж, яких зменшення крила не торкається. CD0 росте 0,0257 → 0,0346, і апарат змушений летіти на 30 % швидше.

**Чому це важливо:** хибний механізм підказує, що лікується це закрилками (більший CL_max). Розділ про шасі саме їх і пропонує — **і вони не повернуть жодної хвилини витривалості**.

### ➕ Висновок треба вести далі, ніж я його довів

Якщо метрика — хвилини, то оптимум не «лишити 0,21», а **збільшити крило**. З реалістичним штрафом за масу ~1,1 кг на м²:

| Крило | Час у повітрі |
|---|---|
| 0,105 м² | 85 хв |
| 0,2104 м² (як зараз) | 118 хв |
| 0,25 м² | **125 хв** |
| 0,30 м² | **132 хв** |
| 0,35 м² | **138 хв** |

Я подав поточне крило як переможця, хоча воно лише краще за пропозицію, з якою сперечалось.

**І дальність теж перестає бути аргументом за різання, якщо звільнити швидкість:** на оптимальній швидкості максимальна дальність майже не залежить від площі й навіть трохи на користь великого крила — 185,2 км при 0,2104 проти 168,2 км при 0,105 і 186,9 км при 0,25.

**Різати крило варто виключно якщо 200 км/год — жорстка вимога.**

Таблиця «посадкова швидкість → площа» ✅ підтверджена, але **трохи песимістична**: реальні дальності на 2–3 % вищі (0,12 м² дає ~108 км / 32,5 хв).

---

### ❌ Залізо: чотири речі, що ламають рекомендацію

**1. Розбіжність 583/333 Вт·год розкрита — і жодна з моїх версій не була правильною.**

Проєкт возить **два різні визначення батареї з часів R04**. R04 зафіксував 3 × SLS XTRON 6S 5000 = 2,244 кг = 333 Вт·год при 148 Вт·год/кг. R05 підставив у список 12S3P Li-ion (583 Вт·год, 2,85 кг) **і не проніс цю зміну через розрахунки**.

> **Якщо справді поставити пакет 583 Вт·год: 143,6 км / 43,1 хв замість 82,8 км / 24,8 хв.**

Ціною +0,6 кг. Апарат значно кращий, ніж проєкт досі стверджував.

**2. Ривок прорахований з помилкою 40 % — це корінь решти.**

Трійка «2 375 Вт / 17 100 об/хв / 64,7 A» внутрішньо узгоджена, але **не відповідає тому, що робить гвинт**. Оберти взяті з однієї робочої точки, а момент — з іншої.

Реально на 344 км/год: рівновага при **17 060 об/хв, 3 327 Вт на валу, 90,0 A**. Тривалий рейтинг Scorpion — 75 A / 3 330 Вт. **Чотирихвилинний ривок іде на 90 A, а це вкладається лише в 95-амперний піковий режим на П'ЯТЬ СЕКУНД.**

**3. Обмежувача обертів на вказаному ESC не існує.**

Аудитор витяг інструкцію YGE Aureus: режими 4/5/6 (літакові) **не мають регулятора обертів узагалі**. Цифра 240 000 об/хв — це стеля комутації, а не налаштування. Є ліміт струму, ліміту обертів немає.

Власна інструкція YGE радить у цьому випадку: *«візьміть мотор із меншим kV»*.

І навіть справжній обмежувач не допоміг би: **на 400 км/год із закритим газом гвинт розкручується потоком до ~18 800 об/хв**.

**4. Перекрут — це звичайний режим, а не курйоз.**

На повному газі зі свіжим пакетом 11×14 тримає **16 800–18 000 об/хв на ВСІХ швидкостях від нуля до 344 км/год** — тобто вище ліміту 17 273 майже весь час. Я подав це як холості 22 140 об/хв, яких гвинт у польоті не бачить, — і тим самим зробив попередження легким для ігнорування.

**5. Мотора не існує в продажу.** Усі характеристики Scorpion HKIV-4035-450KV правильні дослівно, але він у категорії «HK — HKIV Motors (2010–2022)», позначений *Available for Special Order only*, відсутній у freakware (€319 підтверджено) і в RedwingRC ($289,99). **Жодного продавця з наявністю не знайдено.**

### 🎯 Що з цього випливає

> **Візьміть власний висновок про хвилини серйозно — і вимога 344 км/год зникає. А разом із нею одночасно зникають: перевантаження мотора, перекрут гвинта, кидок 145 A, потреба в ESC на 105 A і 318 Вт теплової проблеми.**

Крейсер потребує 697 Вт на валу при 33 A. Це закриває **мотор на 1,5–2 кВт, ~380–420 kV, удвічі легший і втричі дешевший**, з запасом.

Якщо ривок усе ж потрібен — **жоден із двох кандидатів не годиться**, і гвинт треба міняти: 10-дюймовий піднімає ліміт до 19 000 об/хв, 9-дюймовий до 21 111.

### Дрібніші поправки

| Твердження | Правильно |
|---|---|
| Кидок ESC 130–170 A на малій швидкості | **112–145 A, пік на ~200 км/год** |
| 4,7 A на комірку, 1,04 C | це цифри для **12S4P**, не 12S3P. Для 12S3P: **6,21 A, 1,38 C** |
| kWeld €169 | це **нетто**; з ПДВ **€201–211**, плюс незакладене джерело живлення на 800–1 000 A |
| Економіка €0,370/Вт·год | **€0,4555/Вт·год** — без урахування €50 матеріалів пакета |
| Просадка 4,5 В при 65 A | структура правильна, але вимагає 10–14 мОм монтажу понад комірки |

✅ Вистояло: крейсерська точка гвинта (в межах 1 % від реального файлу APC), логіка «батарея визначається енергією, а не струмом», «варити, не паяти».

---

---

## 🔍 ПЕРЕВІРКА, ПРОХІД B (2026-09-24): шасі + збірка

| Розділ | Вердикт |
|---|---|
| **Шасі й експлуатація** | ❌ **НЕ ВИСТОЯВ** — але виправлення радикально спрощує апарат |
| **Специфікація збірки** | ✅ вистояла з поправками — арифметика на диво добра |

Вигаданих деталей знову немає: **усі дев'ять німецьких магазинних позицій перевірені**, Klima-труба підтверджена точно (€9,90, зовн. 75,0 / внутр. 72,6 мм, 120 г → 216 г на 900 мм).

---

### ❌ Шасі: три незалежні помилки, кожної досить для скасування

**1. Успадкована не та метрика.** Увесь розрахунок шасі зроблено на 200 км/год, де опір росте з q. Але прохід A вже встановив, що метрика — хвилини. На швидкості мінімальної потужності (~70 км/год) динамічний напір **у 7,7 раза менший**, і питання шасі стискається вп'ятеро:

| Варіант | Час у повітрі | Втрата |
|---|---|---|
| Без шасі | 118 хв | — |
| **Обтічене нерухоме** | **111 хв** | **−6,0 %** |
| Забиране | 110 хв | −7,1 % |
| Голе дротяне | 105 хв | −11,0 % |

> **Нерухоме шасі коштує шість хвилин зі ста вісімнадцяти.** Цього не вистачає, щоб виправдати візок, лижу, складаний гвинт і неповторювану польову процедуру.

Зверніть увагу на інверсію: **забиране шасі гірше за обтічене нерухоме**, бо на режимі витривалості індуктивна потужність становить ~75 % від усієї, і 320 г механізму коштують дорожче за 0,8 Н відкритої стійки.

**2. Висновок про обтічники був помилкою системи відліку.** Гернер відносить опір колеса до проєкційної площі **шини** (ширина × висота), а не до збільшеної площі обтічника. Коефіцієнт 0,14 застосували до площі, **у 2,3 раза більшої за правильну**, і «відкрили», що обтічники шкодять.

Правильно: голі колеса 0,75–1,36 Н, з обтічниками **0,36–0,60 Н**. **Обтічники зменшують опір коліс приблизно вдвічі.** І це тягне «обтічене шасі = 2,0 Н» вниз до **0,8–1,2 Н**.

**3. Більше крило розв'язує проблему поля, а не створює її.**

Повна посадкова дистанція (виліт + пробіг, інтегруванням, трава):

| Крило | Посадкова дистанція |
|---|---|
| 0,15 м² + закрилки | **109 м** |
| 0,2104 м² + закрилки | 79 м |
| **0,25 м² + закрилки** | **67 м** |

> **Рекомендована конфігурація — єдина, що НЕ влазить у смугу 100 м, яку сама ж і наводить як типову.**

Зі зльотом те саме: 0,25 м² на нерухомому шасі з трави — **42 м**, проти 79 м для 0,15 м² із візка.

**Більше крило виграє одночасно за витривалістю, зльотом і посадкою.**

### 🔴 Дві залізні знахідки, що ламають рекомендацію

- **Складаний гвинт RFM 10×16 — 13 000 об/хв, а не 17 000**, які проєкт носив увесь час. І це **лише лопаті**, без маточини й кока, яких зараз немає в наявності. А на ньому трималась уся ідея посадки на черево
- **Забиране шасі неможливо встановити фізично**: колесо 54–60 мм не ховається ні в трубу Ø75 мм, де вже лежить пакет, ні в крило товщиною 17 мм. Геометричної перевірки варіанта, який поставили на перше місце, ніхто не зробив

### ⚖️ Де я був несправедливо песимістичним

| Твердження | Правильно |
|---|---|
| Голе шасі 4,3–7,4 Н | **3,0–5,5 Н** (центр 4,2) — R04 з його 3–5 Н був ближчий |
| CL_max 1,00 чисте крило | **1,1–1,3** нормально для Re 2,3·10⁵ |
| Приріст від щілинного закрилка +0,22 | **+0,30…+0,45** |
| Пробіг із гальмами 65–130 м | **64–88 м** |
| «Мале крило викреслює катапульту» | **Неправда.** Рейка 8 м дає 5,6 g / 291 Н — м'якше за базове крило на 3 м |

### 🆕 Пропущено повністю: виліт перед торканням

Усі пробіги рахувались **тільки по землі**. Виліт від швидкості заходу до торкання додає від 25 м (0,25 м² із закрилками) до **133 м** (0,105 м² чисте крило).

**Для чистого малого крила виліт довший за пробіг.**

І саме тут закрилки насправді потрібні — **не заради CL_max, а заради кута заходу**: 5,7° → 12,2°, виліт 106 м → 40 м.

> Закрилки виживають з обґрунтування, якого я не навів, і гинуть із того, яке навів: «+6–11 км дальності» — навпаки, закрилки дальність **коштують**.

### ✅ Що аудитор рекомендує натомість

> **Крило 0,25 м² · щілинні закрилки заради кута заходу · ОБТІЧЕНЕ НЕРУХОМЕ ШАСІ · колеса 60 мм · гальма поки не треба**

Обточити передню кромку й звузити задню на наявній стрічці 4×20 мм + обтічники CMD за €19,90.

**Ціна: ~6 хвилин зі 118, ~210 г, ~€60.**
**Купує:** повторюваний зліт і посадку на смузі 100 м, без візка, без лижі, без складаного гвинта, без ударів гвинтом об землю — і пакет на 583 Вт·год ніколи не торкається трави.

---

### ✅ Збірка: вистояла, чотири поправки

**1. Твердження про жорсткість — найслабше місце.** Klima дає внутрішній діаметр 72,6 при зовнішньому 75,0, тобто стінка **1,2 мм — точно як у друкованої**. Момент інерції однаковий, і вся «вдвічі більша жорсткість» трималась на припущеному модулі 4,0 ГПа проти 2,0 у PETG. Опубліковані модулі спірально-намотаних паперових труб — **1–1,5 ГПа**. *(✏️ R07e / R07e-V 2026-09-26: для ракетних і архітектурних паперових труб опубліковано 1,57–2,7 ГПа, розчавлення 6,6–17 МПа; 1–1,5 — консервативно. Але модуль зсуву, ймовірно, лише 0,14–0,18 ГПа.)*

**Паперова труба не жорсткіша, а радше м'якша за друковану.** «Найважча» вистояло (318 проти 216 г), «найм'якша» — ні.

**2. 🔴 Розклад обробки зупиняється на крок раніше, ніж треба — за його ж власним критерієм.**

Шліфування **будь-яким зерном від P60 до P600** дає k_max 8–13 мкм. Але **незашліфована напилена фарба дає 39–50 мкм — у 1,5–2 рази поза бюджетом 26,3 мкм**.

> Кінцеву шорсткість задає **апельсинова кірка лаку**, а не зерно шкурки під ним.

Тобто «зупинитись на лаку, мокре шліфування після P320 дає нуль» — **неправильно**. Рівно один крок після P320 і працює: **зашліфувати САМ ЛАК P1000–1500 із легким поліруванням**. Це той самий крок, який я заборонив.

**3. Дуга проти прямого конуса — правильно, але з іншої причини, і різниця мізерна.** Обидва контури: дуга дає +0,025 Н = **0,23 % опору**, на порядок менше за 0,61 Н, у які це вбудовано.

Справжній аргумент інший: **дуга, що доходить до 30 мм за 141 мм, виходить під місцевим кутом 18,1°** — тобто порушує власний критерій зриву саме там, де зрив починається.

**Найкраще — косинусна S-крива**, дотична з обох кінців: той самий опір, максимальний кут **14,1°** і жодного зламу нахилу на стику. Строго краще за обидва варіанти, безкоштовно.

**4. У моделі бот-тейла немає умови зупинки.** Як оптимізатор вона жене звуження до 450 мм і бази 8 мм. Отже 75→30 мм за 141 мм — це не оптимум, а **непроголошене обмеження за об'ємом**. Виграш 0,61 Н — верхня межа.

**Бухгалтерська поправка:** у прохід A опір фюзеляжу 1,45 Н — це тертя й форма **без опору основи взагалі**. Тож «зекономити 0,61 Н» насправді означає «**не додати** 5,5 %, які базовий розрахунок забув».

### Інші поправки по збірці

- **k_s = 45–120 мкм**, а не 120–200. k_s ≈ 5,86 × Ra (Adams et al.), тобто між Ra і Rz, а не дорівнює Rz
- **🔴 Справжній механізм руйнування — місцева втрата стійкості оболонки, а не текучість.** При R/t = 31 і коефіцієнті зниження 0,2–0,3 критичне напруження **6–11 МПа проти прикладених 7,9**. Це **той самий порядок** — тобто реальний конструктивний ризик, який я пропустив
- Маса покриття **90–128 г**, а не 61. Балончиків треба 2–3, тобто €46–69
- Шліфувати варто **зовнішні 75 %** розмаху, а не 69 — але причина була хибна: струмінь гвинта підіймає напір лише на 9,2 %
- Математичне твердження про дотичність носових форм у основі **перевірено й підтверджено**

### ⚠️ Нерозв'язана суперечність специфікації

**Тягнучий гвинт чи штовхаючий?** Якщо штовхаючий — хвіст не може звужуватись до 30 мм, там маточина й підшипник, і висновок про бот-тейл втрачає свої 0,61 Н. Якщо тягнучий — мотор займає ніс, і «+110 см³ корисного об'єму» від еліптичного носа не є корисним об'ємом.

**Виживає рівно один із двох висновків. Треба визначитись до початку збірки.**

---

## 🎯 ПІДСУМОК R05: апарат радикально спрощується

Чотири аудити незалежно вказали в один бік:

| Було в дослідженні | Стало після перевірки |
|---|---|
| Різати крило до 0,105–0,12 м² | **Збільшити до 0,25 м²** |
| Без шасі, візок, черево, складаний гвинт | **Обтічене нерухоме шасі, колеса 60 мм** |
| Ривок 344 км/год у вимогах | **Викинути ривок** — і з ним зникають перевантаження мотора, перекрут гвинта, кидок 145 A і теплова проблема |
| Мотор Scorpion €319 (немає в продажу) | **1,5–2 кВт, ~380–420 kV, удвічі легший, утричі дешевший** |
| 333 Вт·год | **583 Вт·год → 143,6 км / 43,1 хв** |
| Зупинитись на лаку | **Зашліфувати сам лак P1000–1500** |
| Прямий конус хвоста | **Косинусна S-крива** |

**Більше крило виграє одночасно за витривалістю (125 проти 85 хв), зльотом (42 проти 79 м) і посадкою (67 проти 109 м).**

## 🔗 Далі

→ **R06**: рішення про ривок і компонування (тягнучий/штовхаючий), потім матеріали й безпека
→ Відкрите питання до вас: **чи потрібен ривок 344 км/год узагалі**
