NetHunter123/Jflyproject/_Archiv/_README.md

---
tags:
  - archiv
  - project
  - gungnear
updated: 2026-09-30
---

# Архів Gungnear

Сюди перенесено те, що вже не міняє літак, який будуємо. Посилання `[[ім'я]]` і далі відкривають ці файли.

Будуємо **light+**: алюмінієва ринва Ø80, без люків, Clark Y, відкритий гвинт. Живі нотатки лишились у папці проєкту: хаб, [[GN+]], [[R07g-GN+-CFD]], [[R07c-Light-Plus]], [[R07f-Fertigrohr]], [[Zbirka-shpilky]].

| Файл | Чому в архіві |
|---|---|
| [[R00-Baseline]] … [[R02-Rotor]] | Перша фізика і «вигнутий ротор». Ротор відкинуто |
| [[R03-Antrieb]], [[R04-Cruise-Payload]], [[R04c-EDF-Nutzlast]] | Порівняння гвинта й імпелера. Обрано відкритий гвинт (2026-09-23) |
| [[R04-Rumpfform]], [[R05-Fluegel-Hardware]] | Паперова труба Ø75 і крило 0,25 м². Збірку замінив light+ |
| [[R06-Hybrid]] | Внутрішній канал. Відповідь: ні |
| [[R07a-3D-Modell-CFD]] | CFD іншого літака: коротший, MH 32, із шасі. З GN+ не порівнювати. Урок сітки перенесено в [[R07g-GN+-CFD]] |
| [[R07b-Masa-Nutzlast]] | Конфігурація light без вантажу. Її не будуємо |
| [[R07d-8kg-160kmh]] | Окремий планер на 8 кг. Не ведемо, поки не сказано інакше. Там же довідка про правила, які в розробку не входять |
| [[R07e-Rumpf-Material]] | Чому не папір, HT і ПВХ. Висновок уже в [[R07f-Fertigrohr]]: ринва Ø80 |
| [[GN+-plan-do-audytu]] | Перший план запусків GN+. Аудит R07g визнав його невиконуваним |
| `BLI-tudelft.pdf` | Джерело до канального варіанту. Канал не будуємо |
