NetHunter123/Jflyproject/_Archiv/GN+-plan-do-audytu.md

---
tags:
  - archiv
  - project
  - gungnear
updated: 2026-09-30
---

# GN+ — план до аудиту R07g

Знято з [[GN+]] 2026-09-30. Цей текст **не виконувати**. Живий план і стан запусків — [[R07g-GN+-CFD]].

Аудит знайшов, що план у цьому вигляді зірвав би квоту і зіпсував сітку: лопать-пластина в потоці, порожнистий корпус, ковзання на півмоделі, близько 16–19 окремих запусків, пограншар 18×1,25 від 7 мкм (той самий закороткий шар, що завищив опір у R07a), шорсткість ×1,35 на весь опір крім індуктивного.

Кути, які тут стояли, теж не ті. 1g на 50 м/с близько −2,7°, на 69,4 м/с близько −3,6°. Робочі таблиці: `CFD/GN+_A_50_69.csv`, `CFD/GN+_B_24.csv`, `CFD/GN+_F_beta.csv`.

Нижче — знятий текст, як він стояв у GN+.md.

## Як рахувати (застаріло)

Той самий клас задачі, що в R07a. Солвер — SimScale або рівний йому стаціонарний RANS. Файл для імпорту — `CAD/GN+.step` (міліметри, два тіла: планер і кок із лопаттю).

- Нестисливе, стаціонарне, k-ω SST, повністю турбулентне.
- Півмодель, площина симетрії y = 0. Верхній паз і лопать перетинають цю площину.
- Корпус порожнистий. Стінка труби 0,7 мм — не згладжувати її в суцільне тіло.
- Домен: вхід x = −8 м, вихід x = +16 м, y від 0 до 8 м, z від −8 до +8 м.
- Кут атаки — поворотом вектора потоку.
- Опорна площа півмоделі 0,15 м². Опорна довжина 0,2236 м.
- Рецепт сітки з R07a: перший шар близько 7 мкм, 18 шарів із ростом 1,25. Саме цей рецепт R07g замінив абсолютною товщиною шару.
- Пакети: A 50 м/с кути −2…6°; B 24,4 м/с кути 0…10°; C це 12° і 14°; D 69,4 м/с кути −2…2°; E запас із B; F ковзання β = +5° на тій самій півмоделі.

Поправка, яку тут пропонували і яку аудит відхилив, бо вона множить і опір тиску:

```
D_i = q · 0,30 · CL² / 16,02
D_льот = D_i + 1,35 · (D − D_i)
P_вал = D_льот · V / 0,84
```

Жива поправка: D_льот = D_тиск + 1,35·D_тертя. SimScale пише їх окремо.
