NetHunter123/Jflyproject/_Archiv/R02-Rotor.md

---
tags:
  - project
  - engineering
  - gungnear
etappe: R02
status: ✅ готово
updated: 2026-09-22
---

# R02 — Багаторівневий вигнутий ротор: чи додасть тяги?

> 4 напрямки досліджень + адверсарна перевірка кожного з окремим пошуком фальшивих характеристик. Місія — швидкісний апарат, 300–355 км/год. База: [[R00-Baseline]], [[R01-Geometrie]].

## 🎯 Коротка відповідь

Формулювання «кілька рівнів, вигнута поверхня замість площини» має **чотири різні прочитання в реальній техніці**. Два з них правильні, два — ні. І жодне з правильних не є тим, що намальовано на ескізі.

| Прочитання | Що це в техніці | Вердикт |
|---|---|---|
| Закрутка лопаті по розмаху | Будь-яка нормальна лопать | ✅ **це вже так** |
| Mixed-flow (конічна втулка) | Діагональна крильчатка | ⚠️ реально, але не влізає |
| Тороїдальний (петльовий) гвинт | MIT Lincoln Lab | ❌ **у каналі безглуздий** |
| Диски різного діаметра «сходинками» | — | ❌ **активно шкідливо** |

**Головне відкриття етапу:** найбільші доступні виграші **невидимі на ескізі** — зазор лопать/стінка, кількість лопатей, вхідна губа й хвостовий кок за мотором.

---

## ✅ Закрутка по розмаху — ви вже маєте рацію

Це найчесніше прочитання «не площина, а вигнута поверхня», і воно **просто правильне**.

Реальна лопать **зобов'язана** бути закрученою:
- на втулці r=27,5 мм: U = 115,2 м/с, β₁ = arctg(115,2/85,4) = **53,5°**
- на кінці r=50 мм: U = 209,4 м/с, β₁ = **67,8°**
- різниця: **14,3° закрутки на 22,5 мм розмаху** — тільки щоб тримати нульовий кут атаки

Без неї лопать має +7° на втулці і −7° на кінці: один край зривається, другий крутиться вхолосту. Втрата **15–25 пунктів ККД**.

> Подивіться на ротор Schübeler чи Wemotec — ви побачите рівно ту вигнуту поверхню, яку намалювали. Ви незалежно дійшли до обов'язкової речі. Вона вже є в будь-якому готовому EDF.

## ⚠️ Mixed-flow — справжня «вигнута поверхня», але не сюди

Це найкращий збіг із вашими словами як **клас машини**: лопать сидить на конічній втулці, потік іде діагонально, радіус росте крізь вінець.

**Виграш реальний і великий.** Відцентровий член у рівнянні Ейлера: при зростанні середнього радіуса 39,5 → 43,2 мм на 40 000 об/хв це **+2 647 Дж/кг**, тобто **+40–55 % роботи ступеня** (після поправки перевіряльника — початкова оцінка +58–82 % була стелею ідеальної роботи, а не досяжним виграшем).

Існує в залізі: Garrett US4678398 (PR 3,0, ККД ступеня 85,3 %), CSIR-NAL, Teledyne CAE F408 (крилата ракета), P&W Canada PW600.

**Чому відхилено — і чесно про слабкість цього відхилення:**

1. **Потік треба повернути в осьовий** перед соплом. У єдиній опублікованій малій mixed-flow ступені (CSIR-NAL, 220 мм) саме цей вузол втратив **32 % повного тиску** і працював «fully separated» — PR впав 4,75 → 4,42. Поворот потребує 1,5–2 діаметри; у вас увесь канал L/D = 1,1–1,3
2. **Зазор на конусі некерований.** На конусі 32° осьовий зсув 0,3 мм змінює радіальний зазор на 0,19 мм — ±75 % від проєктних 0,25 мм. На циліндричному кожусі той самий зсув змінює зазор **на нуль**
3. **Надрукувати неможливо** — п'ятиосьова обробка, балансування на 40 000 об/хв

> ⚠️ **Чесне застереження від перевіряльника:** твердження «осьова схема виграє в mixed-flow за здатністю виконувати роботу» **не витримало перевірки** — звуження втулки і зсув радіуса це незалежні важелі, mixed-flow може мати й те, й те. Mixed-flow відхилено **за втратами на повороті й за неможливістю виготовити**, а не за термодинамікою. Якщо колись буде доступ до нормального виробництва — варто повернутись.

## ❌ Тороїдальний гвинт — саме той, від якого треба відмовитись

Найімовірніше, це те, що ви бачили: петльова лопать MIT Lincoln Laboratory, яка візуально і є «вигнута поверхня з кількома рівнями».

**Докази розділяються навпіл:**
- **Шум — правда.** −4…−6 дБ, до −70 % вібрації (MDPI Engineering 7(1):42; морське дослідження проти DTMB P4119). Патенти US 10,407,156 і 10,836,466 існують
- **Ефективність — маркетинг.** Найкращий незалежний вимір: **та сама тяга при +58 % моменту**, тобто ККД 1/1,58 = **−37 %**. Цифри «+20 %» і «+7 %», що ходять по інтернету, — це не порівняння з класичним гвинтом (7 % — це оптимізований тороїд проти неоптимізованого)

**Вбивчий аргумент не в цифрах, а в логіці:** весь механізм петлі — це керування **вільним кінцевим вихором**. Усередині каналу вільного кінцевого вихора **немає** — його придушення і є єдиною причиною, чому канал існує. Петля приносить у канал усі свої витрати (вдвічі більша змочена площа) і жодної своєї переваги.

## ❌ Диски різного діаметра «сходинками» — єдине, що просто шкідливо

Найбуквальніше прочитання ескізу, і єдине без фізичної основи взагалі.

У каналі сталого перерізу нерозривність фіксує ρ·A·Vx на кожному перерізі. Диск меншого діаметра нижче за потоком **не бачить додаткового повітря** — він бачить ту саму витрату через менший переріз при вищій швидкості, тобто при вищому коефіцієнті витрати, де він виконує **менше** роботи. Плюс неолопачене кільце на периферії, крізь яке потік просто обходить ротор.

---

## 🔄 «Кращий захват повітря» — інтуїція правильна, валюта не та

Це найважливіший розділ етапу.

**Витрата повітря не захоплюється лопатями.** Вона визначається перетином характеристики вентилятора з опором системи: ṁ = ρ·A·Vx, де Vx задається соплом і втратами на вході. Форма лопаті зсуває робочу точку на **±5–8 %**, і робить це через зміну тиску, а не «загрібанням».

**І головне — на 355 км/год більше повітря це не те, що вам потрібно:**

```
T = ṁ·(V_струменя − V_польоту)
при 355 км/год: V_польоту = 98,6 м/с, V_струменя = 123,6 м/с
(V_e − V_0) = лише 25 м/с
```

Коефіцієнт підсилення (2V_e − V_0)/(V_e − V_0) = **5,95**.
**Тяга у 6 разів чутливіша до швидкості струменя, ніж до площі.**

Наслідок, що суперечить інтуїції: **+10 % площі кільця = +6,9 % витрати, але −8,2 % тяги.**

### Два контрінтуїтивні висновки

**1. Вхід треба ЗВУЗИТИ, а не розширити.**
При 98,6 м/с трубка струму захвату має діаметр лише **83,6 мм**. Ваша 100-мм труба **проливає 30 % повітря повз себе** (MFR = 0,699) і платить за це додатковим опором. Правильний хід — звузити вхідну кромку до **88–92 мм**.
*(Поправка перевіряльника: виграш від цього +1…+6 %, залежно від того, скільки підсмоктування відновлює губа — точне число спирається на неперевірене припущення. Але хід безкоштовний і в правильному напрямку.)*

**2. Товста втулка мотора — це перевага, а не перешкода.**
При фіксованій швидкості кінця лопаті товста втулка **підіймає середню швидкість лопаті** U_m = ω(r_t+r_h)/2 і отже тиск ступеня. Тяга росте монотонно:

| Відношення втулки ν | Тяга на крейсері |
|---|---|
| 0,35 | 11,3 Н |
| 0,45 | 14,4 Н |
| **0,55** | **16,6 Н** |
| 0,65 | 17,3 Н |

Втулки 0,5–0,6 у серійних EDF — **не компроміс через мотор**, а майже оптимум за чистою аеродинамікою. Це заздалегідь знімає головне питання етапу R03.

---

## 🏆 Що насправді варто робити (за спаданням віддачі)

| # | Захід | Виграш | Вартість |
|---|---|---|---|
| 1 | **Закруглена вхідна губа** замість вістря | до **+39 %** крейсерської тяги (верхня оцінка) | 15–20 мм довжини |
| 2 | **Другий ступінь зустрічного обертання** | **+44,8 %** тяги за **+49 %** потужності | +25–35 мм, 2-й мотор |
| 3 | **Хвостовий кок за мотором** | **3,3–4,5 Н** = 5,5–7,7 % крейсерської тяги | **20–30 г пластику** |
| 4 | **Зазор 0,5 → 0,2 мм** | ~2 пункти ККД | акуратний друк |
| 5 | **Більше лопатей і кривизни** (ψ 0,21→0,28) | +35 % тяги за +57 % потужності | вибір готового ротора |
| 6 | **Звуження вхідної кромки до 90 мм** | +1…+6 % | одна деталь |
| 7 | Звуження втулки крізь ротор | тримає de Haller у нормі | форма втулки |

**Пункт 3 — найкраща тяга на грам у всьому проєкті.**

Передня стріловидність (forward sweep) — єдина з «вигнутих» геометрій, що лишилась у списку «розглянути»: дає +0,3…+2,2 % тяги і +10–28 % запасу до зриву. Але запас до зриву потрібен на зльоті, а не на максимальній швидкості — на розгоні коефіцієнт витрати **тікає від зриву до запирання**. Для вашої місії це майже нічого.

## ⚠️ Поправка до R00

Перевірка виявила помилку, що тягнеться з попереднього етапу: **«стеля класу 100 мм = 9,7 кВт / 130 Н» насправді належить Schübeler DS-94-DIA HST, а це вентилятор 128 мм на 30 000 об/хв**, а не 100-мм клас. Реальний репер 100-мм класу лишається DS-51-AXI HDS: **55 Н при 4,27 кВт** (перевірено дослівно). Стелю потужності для 100 мм треба встановити заново в R04.

## 🔍 Якість джерел

Окремий агент перевіряв кожну характеристику заліза пошуком. **Жодної вигаданої деталі, патенту чи статті не знайдено** — Schübeler, патенти MIT LL, Garrett US4678398, CSIR-NAL ACGT2016-94 підтверджені дослівно. Знайдено кілька неточних атрибуцій цифр (зокрема виграші від передньої стріловидності завищені: справжнє джерело дає +3,56 % тиску, а не +13,1 %) — вони враховані вище.

## 🔗 Далі

→ **R03 — мотор усередині каналу**. Частково вже відповіли: товста втулка не шкодить. Лишається охолодження (корпус мотора 75–250 °C) і чи потрібен rim-drive (попередньо ні — потрібен карбоновий бандаж на 209 м/с).
