NetHunter123/Jflyproject/_Archiv/R03-Antrieb.md

---
tags:
  - project
  - engineering
  - gungnear
etappe: R03
status: ✅ готово
updated: 2026-09-23
---

# R03 — Звичайний мотор+гвинт vs імпелер

> 4 напрямки + адверсарна перевірка з окремим пошуком вигаданих характеристик і цін. **Геометрія вільна** (70–500 мм, канал або без). Місія: крилатий апарат 300–355 км/год.

## 🏆 Вердикт: будувати ГВИНТ

Відкритий гвинт без каналу виграє на місії. Але **менше, ніж здалося спочатку**, і з іншої причини, ніж спершу здавалося.

| Показник на 300 км/год | Гвинт | Імпелер 90 мм | Імпелер 128 мм |
|---|---|---|---|
| Електрична потужність | **~2 500 Вт** | ~2 900 Вт | ~3 800 Вт |
| Час польоту з 333 Вт·год | **~5,0 хв** | ~4,7 хв | ~2,5 хв |
| ККД електрика→тяга | **0,765** | ~0,605 | 0,614 |
| Стеля швидкості | **~525 км/год** (каталожні деталі) | 328 км/год | 403 км/год |
| Маса апарата | **5,26 кг** | 5,00 кг | 6,76 кг |
| Контейнмент ротора | ❌ немає | ✅ карбоновий кожух | ✅ |

**Гвинт виграє за економічністю, стелею швидкості й ціною. Імпелер виграє за безпекою й простотою встановлення.**

---

## 🔄 Головна поправка: ринок гвинтів МАЄ те, що треба

Перший аналіз стверджував, що потрібного гвинта в каталогах немає, і що гвинт упирається в ~426 км/год проти 492 км/год у рекордного імпелерного апарата.

**Перевіряльник перекачав файли даних APC, написав власний парсер — і це виявилось неправдою.**

Фізична вимога виглядає так:
```
крок × оберти ≥ 292 323 дюйм·об/хв  (швидкість кроку > швидкості польоту при 20 % ковзання)
діаметр × оберти ≤ 204 372 дюйм·об/хв  (число Маха на кінці лопаті < 0,85)
→ відношення крок/діаметр ≥ 1,27…1,43
```

Твердження «таких гвинтів не буває» помилкове. **Працюють щонайменше 13 каталожних гвинтів**, а найкращий — несподіваний:

**APC 7×15E** (серія Thin Electric, P/D = **2,14**)
- маса **9,9 г**, ціна **$2,86**
- на 18 000–21 000 об/хв: **9,5–19,7 Н** тяги на 99 м/с
- ККД **0,843–0,869**, число Маха на кінці лише **0,57–0,64** (величезний запас)
- **стеля за нульовою тягою на 21 000 об/хв: 525 км/год**

> **525 км/год — це вище за рекорд Гіннеса для імпелерних моделей (492 км/год).**
> Теза «гвинт принципово повільніший» **спростована**.

Другий робочий варіант — більший **APC 11×14** на 17 000 об/хв: 24,9 Н при 2 831 Вт на валу, ККД 0,868, M = 0,787. Більше тяги, але вчетверо більша потужність і на межі обертів.

### Що НЕ працює
Гвинти з P/D ≤ 1,0 на 99 м/с майже не дають тяги: 16×16 дає ККД 0,570, 12×12 — 0,480. Не нуль (перше твердження було надто різким), але непридатно. **Великий повільний гвинт для цієї місії безглуздий.**

---

## ❌ Саморобний канальний гвинт — відхилено остаточно

Це буквально ваш початковий ескіз. Перевіряльник зробив те, чого не зробив основний агент: прогнав **чисту імпульсну розгортку без опору каналу взагалі** — тобто дав каналу максимально можливу фору.

Результат: на 92 м/с аеродинамічний ефект каналу становить **від +0,5 % до −5,5 %** потужності на валу для будь-якого σ від 0,85 до 1,15. Навіть ідеальне карбонове кільце з L/D = 0,2 **програє на кожному діаметрі**, крім єдиної точки D=100 мм при T=50 Н.

Причини:
1. **На крейсері струмінь гвинта звужується природно до 0,90** — канал тримає те, що й так уже сталося. Він момент-нейтральний саме там, де мав би допомагати
2. **Опір каналу росте як D²**, а виграш — ні
3. **Огортання ефективного швидкісного гвинта коштує 29 % тяги** на змочену площу
4. Зазор: на 100 мм FDM-друк дає ~1,03 мм = 3,45 % розмаху ≈ **5,5 пунктів ККД**

**Висновок:** якщо потрібен канал — **купіть готовий імпелер**. Саморобний кожух не виправдовує себе ні на якому діаметрі.

---

## ⚠️ Дві передумови місії зламались

Це важливіше за вибір двигуна.

### 1. «Тяга ≈ W/10» — помилка в 5–7 разів

Для моделі такого розміру реальна аеродинамічна якість **L/D на максимальній швидкості = 1,5–2,2**, а не 10. Отже:

```
тяга ≈ вага апарата,  а не вага/10
```

Причина: на 99 м/с динамічний напір q = 6 003 Па. Щоб опір був удесятеро менший за вагу, крило мусить бути крихітним — **навантаження 1 683 Н/м² і посадкова швидкість 180 км/год**. Це не літак, це ракета.

При нормальному крилі (250 г/дм², посадка 72 км/год) опір на максимальній швидкості ≈ 30 Н при вазі 51,6 Н.

### 2. «5 хвилин на 355 км/год» не закривається

Потрібно **631–1 002 Вт·год** = **4,3–6,8 кг** літій-полімеру. Жоден 5-кілограмовий апарат цього не несе.

**Реалістично:**
- 344 км/год → **234 секунди**
- 300 км/год → **~5 хвилин**

Верхні 55 км/год діапазону коштують подвоєння потужності й половини часу польоту. **300–320 км/год — це де апарат стає приємним замість граничного.**

---

## 🛠 Варіанти збірки (ціни перевірені окремо)

### A. Гвинт, компактний — найкращий ККД
- **APC 7×15E** ($2,86, 9,9 г) на 18 000–21 000 об/хв
- 9,5–19,7 Н на 99 м/с, ККД 0,87, запас за Махом величезний
- Найдешевший і найлегший шлях. Стеля 525 км/год
- ⚠️ мотор і ESC під цю точку ще не підібрані — завдання R04

### B. Гвинт, потужний — перевірене залізо
- **RFM 10×16 CFK** — €41,90, 17 000 об/хв ✅ *ціна і оберти підтверджені*
- **Kontronik PYRO 750-50 L2** — €679,90, 500 kV, 5 000 Вт, 485 г ✅ *підтверджено*
- ESC **YGE 205 HVT** ~€530–570 ✅
- 5,26 кг, **344 км/год**, ~€2 000
- ⚠️ гвинт працює на самій межі обертів без запасу

### C. Імпелер 90 мм — якщо важливіша безпека
- **Schübeler DS-51-AXI HDS** — **€187,00** ✅ *підтверджено двічі*
- Мотор **HET 700-68-1125** — €132,99 ✅
- ESC ~€250–309 → модуль разом **~€650–680**
- 5,00 кг, 328 км/год, ~4,7 хв
- ✅ **карбоновий кожух — справжній контейнмент**. Єдина причина, чому новачкові варто брати саме це

### D. Дешеві імпелери 70 мм — несправедливо відкинуті
Перевіряльник показав: шість комодитних 70-мм імпелерів дають **55 Н на 99 м/с при 9,7 кВт, ~1,1 кг, ~€420** — тобто практично те саме, що €1 099+ Schübeler DS-98. Варіант для бюджетного експерименту.

---

## 🚨 Безпека: гвинт програє

Гвинт на 17 000 об/хв запасає **~438 Дж** — стільки ж, скільки ротор імпелера (260–730 Дж за R00), **але його ніщо не утримує**. Карбоновий кожух імпелера — справжня захисна конструкція.

Це єдиний аргумент, який не перебивається жодною цифрою ККД.

## 📉 Знайдені помилки в цінах і даних

Перевіряльники знайшли реальні проблеми — будьте уважні при купівлі:

- **DS-98-DIA HST за €1 099 «з мотором» — неправда.** З мотором DSM6043-650 це ~€1 900–2 600. Варіант 128 мм насправді коштує €3 200–3 900, а не €2 400
- **YGE Saphir 125 — €309**, а не €150–200
- **«Кореневий переріз лопаті RFM 3,0 мм»** — це діаметр отвору (Bohrung), шийка лопаті 8,0 мм. Аргумент про міцність спирався не на той розмір
- **Molicel P45B — 231 Вт·год/кг** на рівні комірки, не 242. На рівні пакета ~195–210
- Не знайдено взагалі: **Tenshock 2230-11**, кілька цін на ESC і пакети
- **Статична тяга гвинта 91 Н — артефакт** моделі без урахування зриву. Реально **45–60 Н**, тобто T/W ≈ 0,9–1,2, а не 1,77. Це впливає на злітну дистанцію

✅ Підтверджено дослівно: усі характеристики й ціни Schübeler, Kontronik PYRO 750-50 L2, RFM 10×16, HET 700-68-1125, три рекорди швидкості.

## 🔗 Далі — R04

Рішення, які тепер потрібні:
1. **Гвинт чи імпелер** — цифри вище, вибір за вами (економічність+швидкість vs безпека)
2. **Цільова швидкість**: 300–320 км/год (розумно) чи 344+ (гранично)
3. Якщо гвинт — **компактний 7×15E чи потужний 10×16**

R04: підбір мотора/ESC/пакета під обраний варіант і розрахунок планера з **правильною** передумовою тяга ≈ W.
