NetHunter123/Jflyproject/_Archiv/R04-Cruise-Payload.md

---
tags:
  - project
  - engineering
  - gungnear
etappe: R04
status: ✅ готово, перевірено
updated: 2026-09-24
---

# R04 — Крейсер 200 км/год, дальність, вантаж, форма корпусу

> ✅ **ПЕРЕВІРЕНО.** 4 аудитори, кожен рахував незалежно; один завантажив усі 445 файлів APC і написав власний парсер.
>
> **Читати разом із розділом «РЕЗУЛЬТАТИ ПЕРЕВІРКИ» в кінці файлу.** Числа в тексті нижче лишені як були — помилкові позначені там.
>
> База: [[R00-Baseline]], [[R01-Geometrie]], [[R02-Rotor]], [[R03-Antrieb]].

---

## 1️⃣ Крейсер 200 км/год: дальність і ККД

### Пряма відповідь
**83 км за 25 хвилин** на пакеті 333 Вт·год (66 км / 20 хв, якщо розряджати лише на 80 %, як і треба).
Це **вдвічі більша дальність і втричі більший час**, ніж на 300 км/год.

**Але 200 км/год — це не оптимум економічності.** Моя попередня теза, що на 200 км/год апарат ближчий до найкращої аеродинамічної якості, виявилась хибною:

| Швидкість | L/D | Дальність |
|---|---|---|
| 90 км/год (оптимум L/D) | **11,9** | — |
| 135 км/год (оптимум дальності) | ~10 | **146 км / 65 хв** |
| **200 км/год** | **4,84** (41 % від найкращої) | **83 км / 25 хв** |
| 300 км/год | ~2,5 | 39 км / 7,8 хв |
| 344 км/год | ~1,9 | 30 км / 5,2 хв |

**Крейсер на 200 км/год коштує ~54 % досяжної дальності.** Якщо дальність важлива — 135–150 км/год дає 146 км.

### 🔒 Чому це не можна виправити
Щоб 200 км/год стало точкою найкращої якості, потрібне навантаження на крило **1 183 Н/м²** і швидкість зриву **151 км/год**. Таке не сідає.

**Апарат обмежений посадковою швидкістю, а отже приречений летіти швидше за свою оптимальну точку.** Ні гвинт, ні батарея цього не змінюють.

### ✅ Один гвинт покриває обидві задачі
Несподівано приємний результат: **APC 11×14** ($4,44, 39 г) — найкращий у всьому каталозі APC **і** на 200 км/год (η = 0,846), **і** на 344 км/год (η = 0,872).

Причина елегантна: опір тут переважно паразитний, тому T ~ V². Щоб утримати сталий коефіцієнт ходу J, потрібно n ~ V — а це рівно те, що робить ручка газу. **J лишається 1,02–1,21 на всьому діапазоні 90–344 км/год. Гвинт самоузгоджується.**

Змінний крок не потрібен. Другий гвинт не потрібен.

Гвинт під ривок (7×15E) на крейсері не катастрофа: η 0,794 проти 0,846, тобто −6,2 % дальності. Варто замінити, але це не аварія.

### 🔋 Головний виграш: 200 км/год відмикає літій-іон
На 200 км/год потужність падає до **805 Вт = 18 A = 6 A на комірку** в 12S3P Molicel P45B (розрахована на 45 A).

Високий струм розряду LiPo більше не потрібен → можна переходити зі **148 Вт·год/кг (LiPo) на ~200 Вт·год/кг (Li-ion)**:
**583 Вт·год за 2,92 кг → 128 км / 38 хв.**

Це найбільший окремий виграш від рішення летіти повільніше, і він доступний тільки тому, що впала потужність.

### Ланцюг ККД на крейсері
**0,736** загалом (батарея → тяга): 0,990 × 0,970 (ESC) × 0,903 (мотор) × 0,846 (гвинт)

---

## 2️⃣ Максимальна вага: ГВИНТ

### Пряма відповідь
**Максимум ~6,1 кг** вантажу на апараті 12 кг, або **12,2 кг** на 25 кг — але з майже порожньою батареєю (10 км / 3 хв). **Це неправильна точка для побудови.**

**Розумна точка: 11 кг злітної маси, 2,5–3,0 кг вантажу, 45–50 км (13–15 хв)**, мотор ~2,1 кВт, гвинт APC 14×14E. Рушій+ESC+гвинт+батарея ≈ €1 500–1 900; апарат цілком ≈ €2 000–2 700.

### Крива вантаж–дальність (11 кг, Li-ion 200 Вт·год/кг)

| Батарея, кг | Вантаж, кг | Дальність | Час |
|---|---|---|---|
| 1,04 | 5,30 | 14,9 км | 4,5 хв |
| 1,84 | 4,51 | 26,7 км | 8,0 хв |
| 2,63 | 3,72 | 38,4 км | 11,5 хв |
| **3,42** | **2,92** | **50,0 км** | **15,0 хв** |
| 4,22 | 2,13 | 61,8 км | 18,5 хв |
| 5,80 | 0,54 | 85,3 км | 25,6 хв |

Крива **пряма лінія**: на 200 км/год апарат на 96,5 % паразитно-опоровий, тож перекладання маси між батареєю й вантажем аеродинамічно нічого не змінює. Нахил: **−14,8 км на кожен доданий кг вантажу.**

На LiPo замість Li-ion — рівно **−26 %** дальності на всіх рядках.

### Три хороші новини проти дашевої точки
1. **Вимога до кроку обвалюється**: на 200 км/год потрібно P/D ≥ **0,72** замість ≥1,27–1,43. Майже весь каталог APC стає придатним, ККД гвинта росте з 0,75 до 0,85
2. **Зайва маса майже безкоштовна** за опором (96,5 % паразитного)
3. **Зліт ніколи не є обмеженням**: статичне T/W = 0,54–0,63 і розбіг 46–48 м по траві на всьому діапазоні 5–50 кг

Вантаж обмежують рівно дві речі: **з якою швидкістю ви готові сідати** і **тривала потужність доступного мотора**.

### Розгортка по масі

| Злітна маса | Гвинти | Розмах | P_ел | Вантаж@50км |
|---|---|---|---|---|
| 5 кг | 1 × 11×14 | 1,08 м | 943 Вт | ~1,2 кг |
| **11 кг** | **1 × 14×14E** | **1,61 м** | **2 072 Вт** | **2,92 кг** |
| 25 кг | 2 × 14×14E | 2,43 м | 4 711 Вт | 8,35 кг |
| 50 кг | 4 × 14×14E | 3,43 м | 9 421 Вт | ~17 кг |

Дальність залежить від **частки** батареї, а не від розміру — це результат Бреге. З розміром росте вантаж, приблизно 0,5 × злітної маси.

### ⚖️ Поправка до регулювання: 25 кг — НЕ стіна
Моя попередня теза була неточна. У німецькому модельному спорті під Betriebsgenehmigung від LBA (DMFV/MFSD) правила йдуть **до 150 кг**:

| Маса | Що потрібно |
|---|---|
| 2–12 кг | Kenntnisnachweis — **чиста зона, сюди потрапляє точка 11 кг** |
| 12–25 кг | + умови від Landesluftfahrtbehörde за §21f(3) LuftVO |
| 25–150 кг | + «Schein für Steuerer von Großflugmodellen» + майданчик із дозволом до 150 кг |
| поза модельним спортом | Відкрита категорія ЄС: **тут 25 кг справді жорстка стіна** |

**Реальний практичний поріг для аматора — 12 кг, а не 25.**

### 🎯 Про дальність як таку
На 200 км/год апарат проходить 1 км видимої дальності за **18 секунд**. VLOS обов'язковий і в відкритій категорії, і за правилами асоціацій.

**50 км — це не політ на 50 км, це 25 кіл по маршруту 2 км.** Корисна метрика тут — **13–15 хвилин**, а не кілометри.

### 🔧 Артефакт статичної тяги остаточно закрито
З власного файлу APC, а не з моделі: **7×15E на 21 000 об/хв статично = 22,5 Н** (FOM 0,27). Не 91 Н і навіть не 45–60 Н, які я називав «реалістичними» в R03.

Гвинт під ривок — **поганий статичний рушій**. Крейсерський 14×14E дає 66,4 Н статично на тих самих обертах, на яких крейсерує.

---

## 3️⃣ Максимальна вага: ІМПЕЛЕР (порівняння)

### Пряма відповідь
**~9,5 кг** на 25 кг злітної маси, 50 км — проти **10,88 кг** у гвинта в тому ж планері. **Імпелер дає 87 % вантажу гвинта.**

На 5 кг: імпелер 1,06 кг / 19,4 км проти гвинта 1,22 кг / 30,3 км.

### Три речі, важливіші за заголовок
1. **Обвал тяги на 200 км/год МЕНШИЙ**, ніж на дашевій швидкості: 32,5 Н = 59 % від статичних 55 Н (проти 23,1 Н = 42 % на 99 м/с). М'якший крейсер допомагає імпелеру
2. **Але ККД це не рятує, і звична пояснювалка хибна.** На крейсері треба лише 10,7 Н, вентилятор працює на 27 % газу, швидкість струменя падає до 78 м/с, і рушійний ККД цілком здоровий — **0,831**. Імпелер програє суто на **внутрішньому** ККД: 0,616 проти ~0,85 у гвинта з приводом. «Струмінь надто швидкий» — **не** проблема на притиснутому газі
3. **Це штраф малого масштабу, не принциповий**: надлишок потужності падає з **+59 % на 5 кг** до **+27 % на 25 кг** і **+13 % на 50 кг**, бо каталожний ККД Schübeler росте з 0,616 (90 мм) до 0,785 (195 мм)

### ⚠️ Поправка до мого брифу
Я писав, що реальний ККД DS-51 ≈ 0,70, а 0,616 занизьке. **Це було неправильно.** Три каталожні числа (55 Н, 4 270 Вт, 95,6 м/с) узгоджуються між собою **тільки** при 0,616. При 0,70 той самий вентилятор дав би 59,9 Н — вище за власний опублікований максимум.

0,70 — це **аеродинамічний** ККД самого вентилятора. 0,70 × 0,88 (мотор × ESC) = 0,616 загального. Перевірено тією самою тотожністю на DS-215: виходить 0,785 проти опублікованих Schübeler «78 %».

### Де імпелер справді виграє
Контейнмент ротора · безпека на землі · посадка на черево · відсутність реактивного моменту, P-фактора й гіроскопіки · простота встановлення · ціна модуля (€628,99 проти ~€665).

Рішення на користь гвинта правильне для 5-кілограмового апарата — **але з меншим відривом, ніж випливало з R03**, і воно перевернеться на осі безпеки, якщо контейнмент колись стане вимогою.

---

## 4️⃣ Трубний корпус чи класична форма?

### Пряма відповідь
> **Труба лишається. Але не та труба, що на ескізі.**

Сама по собі трубна форма — циліндр замість нормального тіла обертання — коштує **2 % дальності й 2,5 км/год**. Це шум.

Гроші коштує **як закриті кінці** і **який діаметр**:

| Рішення | Виграш дальності | Виграш швидкості |
|---|---|---|
| **Ніс: плоский → оживало** | **+47,5 км (+126 %)** | **+84,8 км/год** |
| Хвіст: плоский → бот-тейл 60 мм | +10,1 км | +15,8 км/год (за **16 г** пластику) |
| Хвіст: → повний конус 250 мм | +15,2 км | +23,2 км/год (за ~50 г) |
| Діаметр 100 → 75 мм | +5,5 км | +7,3 км/год (безкоштовно) |
| Труба → ідеальне тіло обертання | +2,0 км | +2,5 км/год |

**Ніс важливіший за питання «труба чи крапля» у 24 рази.**
Труба з плоским носом упирається в 240 км/год і 37,6 км — аеродинамічно безнадійна.

Короткий бот-тейл повертає **0,21 Н на грам**, довгий конус лише 0,093 Н/г. Беремо короткий.

### Чому класична форма не варта заходу
- При **однаковому внутрішньому об'ємі й довжині** обтічне тіло економить лише **3,5 % змоченої площі** — бо щоб утримати той самий об'єм, воно має бути на 22 % товстішим посередині. **Уся перевага обтічного тіла живе в кінцях, а не в середині**
- Другий козир класичної форми — ламінарний потік до 40–50 % довжини (−34 % тертя) — **вам недоступний**: допустима шорсткість на 55,6 м/с становить 31,5 мкм, а шари FDM-друку 100–200 мкм, тобто в 5–10 разів більше. Козир не розігрується
- Ідеальне тіло = 20–40 годин формування заради 0,05 км дальності за годину роботи

### Що взагалі найбільше опирається на 200 км/год
Крило **4,47 Н (51,5 %)** · фюзеляж 1,34 Н (15,5 %) · хвіст 1,28 Н (14,8 %)

CL на 200 км/год лише 0,130 — **крило майже нічого не несе, але тягне всю свою змочену площу**. Площа крила, а не форма фюзеляжу, — наступний реальний важіль.

### 🔩 Практична знахідка
Готова карбонова труба 75–100 мм **не продається** у двох перевірених німецьких постачальників: R&G має максимум 48 мм зовнішнього діаметра, cnc-zubehoer.eu — 52 мм. Реальний варіант — **спірально-намотана паперова ракетна труба**.

> ❌ **ВИПРАВЛЕНО [[R07e-Rumpf-Material]] (2026-09-26):** в інших магазинах карбонові труби 75–120 мм є (стінка 2–2,5 мм, 0,73–1,05 кг/м; LOC 3.0" — 1,0 мм). А паперова труба зі склом, як показали R07c-V і R07e, з люками не тримає.

---

## 🔍 РЕЗУЛЬТАТИ ПЕРЕВІРКИ (2026-09-24)

Усі чотири розділи: **вердикт вистояв із поправками.** Вигаданих деталей, цін чи джерел **не знайдено взагалі**.

### ✅ Вистояло беззаперечно

- **83 км / 25 хв** — відтворено до 3 значущих цифр незалежним ланцюгом. Так само L/D 4,84, опір 10,66 Н, 805 Вт, ККД 0,736, співвідношення 2,1×/3,2×, штраф 54 %
- **Один гвинт на обидві задачі — витримав найсильнішу можливу перевірку.** Аудитор перебрав **усі 445 файлів APC** грубою силою: 11×14 справді виграє і на 200, і на 344 км/год, і на 344 км/год це **єдиний гвинт із топ-15, що лишається в межах власного ліміту обертів**
- **Аргумент однакового обʼєму** (§4): обтічне тіло мусить бути на 22,47 % товстішим (√1,5), площа виходить 0,964–0,968 від циліндра. Відтворено точно
- **Німецька регуляторна драбина** — підтверджено за первинними джерелами
- **Точка 11 кг / 2,9 кг / 50 км** — відтворена з файлу APC, сходиться в межах 2–3 %
- **Уся арифметика §3 (імпелер)** — жодної обчислювальної помилки. DS-86-AXI HDS підтверджено повністю (35 500 об/хв, 7 500 Вт, 101 Н, 99 м/с, 290 г, $329)

### ❌ Головна помилка: «замок» був хибним висновком

У §1 я написав, що апарат **приречений** летіти з L/D 4,84 і «ні гвинт, ні батарея цього не змінюють». **Передумова правильна, висновок ні.**

Неможливість *досягти* найкращої якості ≠ застрягання на 4,84.

> **Удвічі менше крило (0,105 м²): L/D 4,87 → 6,36, дальність 83 → 107 км (+28 %)**, за зростання швидкості зриву 69 → 97 км/год (83 км/год із закрилками). Другий аудитор дає до **+43 %**, якщо масштабувати й хвіст.

§4 того самого файлу каже рівно це («крило дає 51,5 % опору, несучи майже нічого»), а §1 це заперечував. **§1 програв.** Замок відправляв не шукати саме там, де лежить найбільший виграш. Це завдання для R05.

### ❌ Оптимальна швидкість дальності — неправильна

Для електричного апарата зі сталою масою енергія на км = D/η, тому оптимум дальності стоїть на **мінімумі опору**, тобто практично на найкращій якості, зсунутий вгору лише на ~4 %.

| | Було в §1 | Правильно |
|---|---|---|
| Максимум дальності | 146 км на 135 км/год | **183 км на ~95 км/год** |

Цифру 180 км пораховано правильно, а підпис поруч поставлено хибний. **135–150 км/год — це відповідь для літака на паливі, не для цього.**

### ⚠️ Суперечність про шорсткість — і чим вона обернулась

§1 рахує CD0 по гладкій поверхні (+15 %), а §4 вбиває ламінарний потік шорсткістю FDM. **Обидва одночасно неможливі.**

Це **знімає відкрите питання №1**: обидва агенти мали рацію про **різні апарати**.

| Поверхня | CD0 | Дальність |
|---|---|---|
| Шліфована, шпакльована, фарбована | 0,025 | **83 км** |
| Як надруковано | 0,032–0,035 | **62–78 км** |

**83 км — це не прогноз, а вимога до обробки поверхні,** якої в тексті не було.

Але аудитор §4 заперечує різкість: виміряна шорсткість FDM при шарі 0,2 мм — **Ra 10–25 мкм, а не 100–200**. Висота шару ≠ амплітуда шорсткості. А рекомендована збірка (паперова труба + скло + фарба, шліфована) дає Ra 1–5 мкм — **комфортно під нормою**. Справжні перешкоди ламінарному потоку тут — нульовий градієнт тиску, обдув від гвинта й вібрація, а не фініш.

### ❌ Розгортка по масі зламана вище 12 кг

У §2 два взаємовиключні числа для того самого 25-кілограмового апарата: 12,2 кг на батареї 10 км **і** 8,35 кг на 50 км. При сталій злітній масі вантаж і батарея міняються рівно 1:1.

| Маса | Було | **Правильно** |
|---|---|---|
| 25 кг @ 50 км | 8,35 кг | **5,9 кг** |
| 50 кг @ 50 км | ~17 кг | **10,2 кг** |

**Частка вантажу ПАДАЄ з розміром**: 0,28 / 0,265 / 0,234 / 0,203 при 5 / 11 / 25 / 50 кг — бо маса крила росте як m^0,25. Правило «вантаж ≈ 0,5 × злітної маси» хибне: 0,5 × маси — це **вантаж плюс батарея**.

Рядки 5 і 11 кг здорові. Модель ламається там, де її екстраполювали.

### ❌ Вимога до кроку гвинта — спростована файлами APC

«P/D ≥ 0,72, майже весь каталог придатний» — неправда, і це суперечить власному ж інваріанту J = 0,875.

При J = 0,875 гвинт із P/D = 0,72 працює **за межею нульової тяги**. APC 18×12E на 200 км/год на своєму ліміті обертів дає **відʼємну тягу**.

**Справжній поріг: P/D ≈ 0,95–1,0** для серії Thin Electric. Придатна не «майже вся лінійка», а **сімейство квадратного кроку (12×12E, 14×14E і вище)** — приблизно чверть електричної лінійки.

### ❌ Зліт таки може бути обмеженням

Розбіг 46–48 м потребує CL_max ≈ 1,4, тобто закрилків, яких у розрахунку немає. При CL_max = 1,0 (те саме значення, яким рахувалась посадка) виходить **60–75 м по траві**.

Плюс **шасі взагалі відсутнє в моделі опору**, хоча в моделі маси воно є — це 3–5 Н, близько **15 % усього крейсерського опору**.

11-кілограмовий апарат, що відривається на 87 км/год з трави на малих колесах, — реальне обмеження.

### ❌ Інші поправки в цифрах

| Твердження | Було | Стало |
|---|---|---|
| Ніс: плоский → оживало | +47,5 км (+126 %) | **+41 км (+94 %)**, +72 км/год |
| Ніс проти форми корпусу | у 24 рази важливіший | **~20 разів** |
| Навантаження на крило як важіль | розмах 2,5× | **~2,1×**, і третина з того — легше крило |
| Видимість для VLOS | 1 км | **550–820 м** (формула ALOS від EASA) |
| ККД імпелера DS-51 | 0,616 доведено | **0,62 ± 0,04**, доказ був круговим |
| Ціна модуля імпелера | €628,99, дешевше за гвинт | **~€850, на 28 % ДОРОЖЧЕ** |

### ❌ Три окремі змістовні помилки

**1. Елегантний аргумент правильний у числах, хибний у причині.** J справді тримається 1,02–1,21 — підтверджено. Але **не тому**, що «опір паразитний, отже T~V²». Потрібне Ct/J² падає вдвічі (0,0713 → 0,0348). Аргумент V² працює лише вище 200 км/год; на 90 км/год індуктивний опір становить 51 % від усього.

Справжня причина — **крива Ct(J) саме цього гвинта крута біля J ≈ 1,1–1,2**. Це властивість гвинта, а не закон. **Якщо змінити крило або масу — гвинт треба перерахувати заново.**

**2. Бот-тейл 60 мм, як намальовано, зірве потік.** 100 → 60 мм на довжині 60 мм — це півкут 18,4°, а межа зриву 14–16°. Виправлення: **зробити профіль криволінійним** або розтягнути прямий конус до **≥75 мм** (для Ø100) чи ≥56 мм (для Ø75). Маса майже не змінюється, виграш 0,21 Н/г лишається.

**3. «Струмінь надто швидкий — не пояснення» — неправильно.** Порівнювалось 0,616 імпелера з 0,85 гвинта, але 0,85 — це тільки мотор × ESC, а 0,616 включає аеродинаміку вентилятора. Симетрично: у гвинта «все, крім рушійного» = 0,734 проти 0,616. Правильно: **приблизно навпіл — половина внутрішній ККД, половина швидкість струменя.**

### 🔩 Карбонова труба: причина була не та

Було написано, що готової карбонової труби 75–100 мм у Німеччині немає. **Неправда** — carbon-composite.com має цілу категорію 81–120 мм: 90, 95, 100, 105, 110, 115, 120 мм.

Але висновок не змінюється, а посилюється: **Ø90×80 мм, 1 м = €524,65** і ~1,9 кг/м карбону. Вона **непридатна за масою й ціною, а не за доступністю**. Паперова ракетна труба лишається правильним вибором.

### 📌 Що це означає для наступного етапу

1. **R05 має почати зі зменшення крила** — це +28…+43 % дальності, найбільший невикористаний важіль
2. Закласти в специфікацію **обробку поверхні** (шліфування, шпаклівка, фарба) — інакше 83 км перетворюються на 62–78
3. Перерахувати бот-тейл як криволінійний профіль
4. Додати шасі в модель опору або перейти на посадку на черево
5. CD0 вести **діапазоном 0,025–0,032**, а не одним числом — це найменш перевірена і найбільш навантажена величина в усьому розрахунку (індуктивний опір на 200 км/год лише 4,2 %, тож уся відповідь тримається на CD0)

## 🔗 Далі

→ **R05**: крило (зменшення площі), підбір мотора/ESC/пакета, шасі
