NetHunter123/Jflyproject/_Archiv/R04-Rumpfform.md

---
tags:
  - project
  - engineering
  - gungnear
etappe: R04
status: 🔬 ресерч зроблено, чекає адверсарної перевірки
updated: 2026-09-23
---

# R04 — Форма корпусу: труба чи класичний фюзеляж

> ⚠️ Це **дослідницький прохід**. Усі числа підлягають окремій адверсарній перевірці.
> Розмірність цього етапу: **(ii) ФОРМА КОРПУСУ**, а не канал навколо гвинта.
> Канал (duct) уже відхилено в [[R03-Antrieb]] — сюди не повертаємось.

---

## 🏁 ПРЯМА ВІДПОВІДЬ

**Труба — залишається. Але не та труба, що на ескізі.**

Сама по собі «циліндр замість каплі» коштує **~2 % дальності й ~2,5 км/год швидкості**. Це шум.
Що справді коштує грошей — це **чим ви закриваєте кінці** і **який діаметр**.

| Рішення | Приріст дальності на 200 км/год | Приріст макс. швидкості (3 кВт) |
|---|---|---|
| Ніс: плоский → оживальний | **+47,5 км** (+126 %) | **+84,8 км/год** |
| Хвіст D100: плоский → конус 250 мм | +15,2 км (+18 %) | +23,2 км/год |
| Хвіст D100: плоский → boat-tail 60 мм (16 г!) | +10,1 км (+12 %) | +15,8 км/год |
| Діаметр: 100 → 75 мм | +5,5 км (+5,5 %) | +7,3 км/год |
| Форма: труба → ідеальне тіло обертання | **+2,0 км (+1,8 %)** | **+2,5 км/год** |

> Тобто: **форма корпусу — остання за важливістю з усіх чотирьох рішень.**
> Ніс важить у 24 рази більше, ніж труба-vs-крапля.

**Що будувати:** паперова/склокомпозитна труба **Ø75 мм, довжина 900 мм**, оживальний ніс ~120 мм (друк), хвостовий конус (мінімум boat-tail 45 мм за Mair, краще конус 230 мм), штовхаючий гвинт у хвості.

---

## 📐 Вихідні припущення (усі — мої, усі під перевірку)

| Величина | Значення | Звідки |
|---|---|---|
| ρ | 1,225 кг/м³ | R00 |
| ν | 1,460·10⁻⁵ м²/с | стандартна атмосфера, 15 °C |
| a | 340 м/с | R00 |
| m | 5,26 кг → W = 51,60 Н | R03 (варіант B) |
| S_крила | 0,21 м² (250 г/дм²) | R03 |
| AR / e | 6,0 / 0,80 | **моє припущення** |
| t/c крила | 0,10, x_t/c = 0,35 | **моє припущення** |
| S_хвіст | 0,25·S = 0,0525 м² | **моє припущення** |
| «інше» (щілини, тяги, охолодження) | +15 % | **моє припущення, занижене** |
| η електрика→тяга | 0,765 | R03 |
| Батарея | 333 Вт·год = 1,1988 МДж | R03 |
| **L фюзеляжу** | **0,900 м** | **виведено з плеча хвоста, див. нижче** |

**Чому L = 0,9 м:** b = √(AR·S) = √(6·0,21) = **1,122 м**; MAC = S/b = **0,187 м**;
плече хвоста 3·MAC = 0,561 м + ніс 0,20 м + корінна хорда 0,19 м ≈ **0,90–0,95 м**.
👉 **Довжину фюзеляжу задає плече хвоста, а не об'єм батареї.** Це ключ до всього розділу.

### Режими
| V | q = ½ρV² | M | Re (L=0,9 м) | C_f турб. |
|---|---|---|---|---|
| 55,6 м/с (200,2 км/год) | 1 893,5 Па | 0,1635 | 3,4274·10⁶ | 0,003577 |
| 95,0 м/с (342,0 км/год) | 5 527,8 Па | 0,2794 | 5,8562·10⁶ | 0,003252 |
| 99,0 м/с (356,4 км/год) | 6 003,1 Па | 0,2912 | 6,1027·10⁶ | 0,003229 |

C_f = 0,455 / [(log₁₀Re)^2,58 · (1+0,144M²)^0,65] — DATCOM 1978 (4.1.5.1-26) / Raymer eq. 12.27,
через HAW Hamburg, *Aircraft Design*, розділ 13, рівн. (13.17).

---

## 1️⃣ Аеродинаміка: труба vs тіло обертання

Метод: C_D = C_f·FF·S_змоч/q + C_D,ніс·A_фронт + C_D,база·A_база.
База за Hoerner: **C_D,база = 0,029/√(C_D,носової частини)**, обидва — на площу бази.
Формфактор: FF = 1 + 60/(L/D)³ + (L/D)/400 (DATCOM 4.2.3.1) та Hoerner 1+1,5(D/L)^1,5+7(D/L)³.

### Опір самого фюзеляжу, Н

| Конфігурація | S_змоч, м² | Об'єм, л | **200 км/год** | **342 км/год** |
|---|---|---|---|---|
| A. Труба D100, плоский ніс + плоска база | 0,2827 | 7,07 | **15,01** | **43,50** |
| B. Труба D100, ожива + плоска база | 0,2627 | 6,40 | 3,18 | 8,98 |
| C. Труба D100, ожива + boat-tail 60 мм | 0,2597 | — | 2,18 | 5,93 |
| C⁺. Труба D100, ожива + конус 250 мм | 0,2338 | 5,30 | 1,75 | 4,70 |
| D. **Тіло обертання** L900 D100 (+FF) | 0,2233 | 4,71 | **1,61–1,67** | **4,28–4,44** |
| G. Труба D75, ожива + плоска база | 0,1999 | 3,68 | 2,04 | 5,69 |
| E⁻. Труба D75, ожива + boat-tail 45 мм | 0,1983 | — | 1,56 | 4,21 |
| E. Труба D75, ожива + конус 230 мм | 0,1821 | 3,15 | **1,34** | **3,59** |
| F. **Тіло обертання** L900 D75 (+FF) | 0,1671 | 2,65 | **1,18–1,21** | **3,13–3,20** |

**C_D на змочену площу:** труба E = 0,00389, ідеальне тіло F = 0,00358. Різниця **8,7 %**.
**C_D на фронтальну:** E = 0,160, F = 0,135.

> 🎯 **Головний результат розділу: модифікована труба відстає від ідеального тіла обертання на 0,13 Н при 200 км/год і 0,39 Н при 342 км/год.** Це 1,5 % повного опору апарата.

### Рівень апарата

| Конфігурація | D@200, Н | L/D | P_ел, Вт | час | **дальність** | V_max @3 кВт |
|---|---|---|---|---|---|---|
| A. плоский ніс D100 | 24,39 | 2,12 | 1 773 | 11,3 хв | **37,6 км** | 240,3 км/год |
| B. ожива + плоска база D100 | 10,78 | 4,79 | 783 | 25,5 хв | 85,1 км | 325,1 км/год |
| C. + boat-tail 60 мм | 9,63 | 5,36 | 700 | 28,5 хв | 95,2 км | 340,9 км/год |
| C⁺. + конус 250 мм | 9,14 | 5,64 | 664 | 30,1 хв | 100,3 км | 348,3 км/год |
| G. D75 + плоска база | 9,47 | 5,45 | 688 | 29,0 хв | 96,8 км | 342,3 км/год |
| E⁻. D75 + boat-tail 45 мм | 8,92 | 5,79 | 648 | 30,8 хв | 102,9 км | 351,4 км/год |
| **E. D75 + конус 230 мм** | **8,67** | **5,95** | **630** | **31,7 хв** | **105,8 км** | **355,6 км/год** |
| F. ідеальне тіло D75 | 8,51 | 6,06 | 619 | 32,3 хв | 107,8 км | ~358 км/год |

**Перевірка проти R03:** моя модель для конфігурації B дає **30,06 Н при 99 м/с** — R03 припускав ~30 Н. Збіг. Для «чистої» конфігурації C⁺ виходить 24,7 Н, бо конус і ожива реально прибирають ~5 Н.

### ⚠️ Консервативний варіант (беріть саме його)
Мій «чистий» розрахунок оптимістичний. Практична модельна цифра з [rc-soar](https://rc-soar.com/tech/perfanal.htm) — **C_d = 0,008 на змочену площу фюзеляжу незалежно від Re**, тобто **у 2,0–2,2 рази більше** за мій розрахунок (E@200: 2,76 Н замість 1,34 Н).
З опором ×1,25 і корисною ємністю 85 %:

| Конфігурація | 200 км/год | 342 км/год |
|---|---|---|
| E (труба D75 + конус) | L/D 4,76 · 787 Вт · 21,6 хв · **72,0 км** | 3 366 Вт · **28,8 км** |
| C⁺ (труба D100 + конус) | L/D 4,52 · 830 Вт · 20,4 хв · **68,2 км** | 3 564 Вт · **27,2 км** |

---

## 2️⃣ Ціна тупості: база й ніс

### База (хвіст)
| V | D100 плоска база | boat-tail 60 мм | конус 250 мм | **виграш** |
|---|---|---|---|---|
| 200 км/год | 1,247 Н | 0,271 Н | 0,021 Н | 1,0–1,4 Н |
| 342 км/год | 3,817 Н | 0,829 Н | 0,063 Н | 3,0–3,8 Н |
| 356 км/год | 4,160 Н | 0,904 Н | 0,069 Н | **3,3–4,7 Н** |

> ✅ **Попередня оцінка проєкту «хвостовий конус = 3,3–4,5 Н за 20–30 г пластику» ПІДТВЕРДЖЕНА незалежно.** Мій розрахунок при 99 м/с: 3,31 Н (короткий boat-tail) … 4,65 Н (довгий конус).
> На 200 км/год це падає до **1,0–1,4 Н**, бо базовий опір ∝ V². У відсотках від повного опору — те саме.

**Маса:** boat-tail 60 мм (100→60 мм), стінка 0,8 мм PETG: S = 0,0159 м² × 0,0008 м × 1 270 кг/м³ = **16,1 г** (густина PETG — довідкова, не специфікація товару).
Конус 250 мм (100→25 мм): 0,0496 м² → **50 г**.
👉 **0,21 Н/г для короткого boat-tail проти 0,093 Н/г для довгого конуса.** Короткий удвічі ефективніший на грам.

Це відповідає класиці: **Mair, W. A. (1969), «Reduction of Base Drag by Boat-Tailed Afterbodies in Low-Speed Flow», *Aeronautical Quarterly* 20(4), 307–320** — «найкращий обтічник, довжиною лише **60 % максимального діаметра**, дав майже таке саме зменшення опору, як повноцінний обтічний хвіст».

### Ніс
| Ніс | C_D,ніс (фронт.) | D_ніс @200 (D75) | D_ніс @342 |
|---|---|---|---|
| Плоский торець | **0,80** | 6,69 Н | 19,54 Н |
| Півсфера | 0,01 | 0,084 Н | 0,244 Н |
| Ожива 1,6·D | ~0,005 | 0,042 Н | 0,122 Н |

Для D100 плоский ніс = **11,90 Н при 200 км/год** і **34,73 Н при 342 км/год**.
Джерело значень: Hoerner — плоский циліндр C_D0 ≈ 0,80, півсферичний ніс ≈ 0,01, підтверджено сучасними CFD-порівняннями носових обтічників.

> ❌ **Труба з плоским носом фізично літає, але це не літак.** Максимум 240 км/год на 3 кВт, дальність 37,6 км. Категорія: *можливо, але погано* — на межі з *безглуздо*.

---

## 3️⃣ Об'єм і компонування — тут труба реабілітується

### Питання: «за однакового внутрішнього об'єму скільки зайвого опору несе труба?»
| Потрібний об'єм (L = 0,9 м) | циліндр | тіло обертання | S_тіло/S_циліндр |
|---|---|---|---|
| 1,5 л | D = 46,1 мм, S = 0,1303 м² | D = 56,4 мм, S = 0,1255 м² | **0,964** |
| 3,0 л | D = 65,1 мм, S = 0,1842 м² | D = 79,8 мм, S = 0,1778 м² | **0,965** |
| 5,0 л | D = 84,1 мм, S = 0,2378 м² | D = 103,0 мм, S = 0,2301 м² | **0,968** |

> 🔑 **За однакового об'єму й довжини обтічне тіло економить лише 3,5 % змоченої площі** — бо, щоб умістити той самий об'єм, воно мусить бути на 22 % товстішим у міделі.
> **Уся перевага обтічного тіла — у кінцях, а не в середині.** Постійний переріз сам по собі майже безкоштовний.

### Але об'єм — не те обмеження
Батарея **SLS XTRON 6S 5000 mAh 40C/80C: 163 × 45 × 49 мм, 748 г** ([Höllein](https://www.hoelleinshop.com/), inkl. MwSt.)

- діагональ перерізу = √(45² + 49²) = **66,5 мм**
- 3 пакети **в лінію**: 3 × 163 = **489 мм**, потрібен ID ≥ 66,5 мм → **OD ≈ 75 мм**
- 3 пакети **2 поруч + 1**: ширина 90 мм → ID ≥ 102 мм → **OD ≈ 105–110 мм**
- 3 × 111 Вт·год = **333 Вт·год**, 3 × 748 г = **2,244 кг = 43 % злітної маси**
- геометричний об'єм пакетів = **1,078 л** проти 3,15 л у трубі D75

👉 **Діаметр задає не об'єм, а переріз найширшої деталі.** Укладання пакетів у лінію замість «поруч» дає перехід 100 → 75 мм, а це **+5,5 км дальності й +7,3 км/год** — утричі більше, ніж уся різниця «труба vs крапля».

### Чи змінюється відповідь на 344 км/год?
Ні. Штраф труби: 1,8 % дальності на 200 км/год і 2,1 % на 342 км/год. **Практично інваріантний.**
Змінюється абсолютна ціна помилок: плоска база коштує 0,60 Н на 200 км/год і 1,85 Н на 342 км/год (D75). Тобто **на швидкості ростуть штрафи за кінці, а не за форму.**

---

## 4️⃣ Конструкція й збірка

### ⚠️ Готову карбонову трубу Ø75–100 мм купити важко
- **R&G Faserverbundwerkstoffe** — найбільший круглий намотаний CFK-профіль у каталозі **48,0 мм OD**. 75–100 мм у наявності **не знайдено**
- **cnc-zubehoer.eu** — найбільший знайдений **52 × 50 × 1000 мм**. Ціни на сторінці не відображено
- ❗ Це реальне обмеження: *«візьму карбонову трубу»* не працює на цьому діаметрі без спецзамовлення
- ❌ **ВИПРАВЛЕНО [[R07e-Rumpf-Material]] (2026-09-26):** як твердження про ринок — хибно. Карбонові труби 75–120 мм продаються (carbonscout, Carbon Composite AG, carbonrohr.net, Китай), але зі стінкою 2–2,5 мм (0,73–1,05 кг/м, €111–390/м). Є й тонша: LOC Precision 3.0" carbon Ultra Light, стінка 1,0 мм, Ø78,7 / 76,2.

### Що РЕАЛЬНО купується (перевірено, inkl. MwSt.)
**Raketenmodellbau Klima GmbH, спірально-намотаний паперовий Körperrohr:**

| Товар | Маса | Ціна |
|---|---|---|
| Ø75 мм, 250 мм | 60 г | **6,90 €** |
| Ø75 мм, 385 мм | 92 г | **8,90 €** |
| Ø75 мм, 500 мм | 120 г | **9,90 €** |
| Ø101 мм (ID 99), 2 × 457 мм + кулер | 166 г / шт, кулер 124 г | **22,90 €** |

→ **Ø75 × 900 мм = 500 + 385 мм + кулер ≈ 216 г за ~19 €.** Це **4,1 % злітної маси**.

### Порівняння варіантів корпусу (маси — розрахунок за довідковими густинами, не специфікації товару)

| Варіант | Маса на 900 мм | Ціна | Години | Жорсткість | Ремонт | Краш |
|---|---|---|---|---|---|---|
| **Папір Klima Ø75** | **~216 г** | **~19 €** | **1–2** | середня, боїться води | склеїти/замінити секцію | мнеться, поглинає |
| Папір + 1 шар скла 80 г/м² | ~280 г | ~30 € | 4–6 | добра | латка | добре |
| CFK-труба Ø75 (розрахунок: ст. 0,8 мм, ρ 1 550) — ❌ R07e: серійної 0,8 мм немає; є 1,0 мм (LOC, Ø78,7) і 2–2,5 мм | ~260 г | спецзамовлення | 0,5 | відмінна | погано | тріскає, розколюється |
| ~~HT/PVC-труба DN75 (ст. 1,8–2 мм, ρ 1 400)~~ ❌ **ВИПРАВЛЕНО R07e:** HT — це **поліпропілен** 75×1,9 (0,454–0,48 кг/м → **409–432 г**), жорсткість **як у голого паперу** (EI ≈372), епоксидкою не клеїться; справжній ПВХ-U — найтонший 75×2,3 (**≈662 г**) | ~~**~520–580 г**~~ | ~5 € | 0,5 | ~~добра~~ HT погана / ПВХ середня | термозварювання | в'язкий, важкий |
| Друк FDM PETG, ст. 1,2 мм | ~320 г | ~8 € філаменту | 15–25 друку | **погана на згин** | легко перепечатати | крихкий |
| Формований фюзеляж (болван + викладка) | ~150–250 г | ~40 € + болван | **20–40** | відмінна | середньо | добре |

> **Вердикт для аматора:** паперова труба Klima + 1 шар скла + друковані ніс і boat-tail.
> ❌ **ПЕРЕГЛЯНУТО в [[R07e-Rumpf-Material]] (2026-09-26):** папір + скло **не тримає люків** (light+, і на межі — light). Мінімум — **карбон замість скла** + стрічки; найкраще — саморобна карбонова/склопластикова труба на HT-оправці. Klima Ø75 зараз не продається (заміна LOC 3.00" kraft, Ø78,7).
> Формований фюзеляж дає +2 % дальності за **20–40 годин** роботи. Це **0,05 км дальності на годину праці**.

### ❌ Ламінарність недоступна — і це вбиває головну перевагу краплі
Ідеальне тіло обертання виграє переважно тим, що тримає ламінарний шар до 40–50 % довжини:

| x_перех/L | C_f @200 км/год | відносно турбулентного |
|---|---|---|
| 0 (все турбулентно) | 0,003577 | 1,000 |
| 0,15 (труба з оживою) | 0,003095 | 0,865 |
| 0,40 (гарна крапля) | 0,002348 | **0,656** |

**Але** допустима шорсткість (критерій Re_k = V·k/ν = 120):

| V | k_доп |
|---|---|
| 55,6 м/с | **31,5 мкм** |
| 95,0 м/с | **18,4 мкм** |
| 99,0 м/с | 17,7 мкм |

FDM-друк дає шар 100–200 мкм — **у 5–10 разів більше за допустиме**. Паперова труба з фарбою — приблизно так само.
👉 **Без шліфування до дзеркала ламінарності не буде ні в труби, ні в краплі.** Тобто головний козир класичної форми в аматорській збірці **не реалізується взагалі**. Це ще один аргумент за трубу.

---

## 5️⃣ Компонування

### Гвинт не змінює відповіді про форму, але змінює де що стоїть

**Штовхаючий (pusher) — рекомендовано:**
- гвинт на кінці boat-tail **знищує базовий опір фізично** — база стає диском гвинта
- заковтування примежового шару (BLI): TU Delft (van Arnhem) — виграш потужності **~7 %** для встановленого штовхаючого гвинта з BLI; інші роботи дають 21,7 % економії потужності проти переднього розташування в окремих конфігураціях. **Для нашого масштабу беріть нижню межу, ~5–7 %, і то як гіпотезу**
- фюзеляж у чистому потоці
- ⚠️ мінуси: гвинт ковтає збурений потік (втома лопаті + шум), хвостове оперення мусить бути перед гвинтом або на балках, мотор ззаду → батарея вперед (що добре: 2,24 кг пакетів — це і є ваш баланс)

**Тягнучий (tractor):**
- весь фюзеляж у струмені 7-дюймового гвинта (D_гвинта 178 мм > D_фюзеляжу 75 мм → 100 % обдуву)
- приріст динамічного напору на фюзеляжі: V_диск = ½(V + V·√(1 + 2T/(ρA_дискV²)))
  при T = 13 Н, A_диск = 0,02483 м², V = 55,6 м/с → V_e = 62,8 м/с, V_диск = 59,2 м/с
  → q_струм/q = (59,2/55,6)² = **1,134**, тобто **+13 % опору фюзеляжу ≈ +0,17 Н**
- ✅ плюси: охолодження мотора, простий ніс, гвинт у чистому потоці, безпечніше при посадці на черево

### Розумне аматорське компонування
```
[ожива 120 мм, друк]─[Ø75 труба: 3 пакети в лінію 489 мм]─[ESC+RX]─
                                     [крило, серединне]
                                          └─[boat-tail 45 мм + мотор + гвинт]
                                             хвіст: V-подібний на 2 балках
```
- **корисне навантаження = батарея.** 2,244 кг (43 % AUW) у трубі постійного перерізу — це саме те, для чого труба ідеальна: пакети лежать вздовж, без «мертвих кутів» звуженої краплі
- ЦТ: батарею можна рухати ±100 мм по трубі — безкоштовне балансування, чого моноліт не дає
- балки замість повного фюзеляжу **не потрібні**: труба вже є балкою, і вона й так тягнеться до хвоста

---

## 6️⃣ Що з цього насправді має значення

**Рейтинг важливості (дальність на 200 км/год / V_max при 3 кВт):**

1. 🔴 **Ніс: +47,5 км / +84,8 км/год** — єдине рішення, де помилка катастрофічна
2. 🟠 **Хвіст: +10,1…15,2 км / +15,8…23,2 км/год** — 16 г пластику дають 2/3 виграшу
3. 🟡 **Діаметр 100→75: +5,5 км / +7,3 км/год** — безкоштовно, якщо класти пакети в лінію
4. ⚪ **Труба → крапля: +2,0 км / +2,5 км/год** — 20–40 годин праці. **Не варто.**

### ⚠️ І найбільша деталь опору — це взагалі не фюзеляж
При 200 км/год у конфігурації E:
- крило **4,47 Н (51,5 %)**
- фюзеляж 1,34 Н (15,5 %)
- хвіст 1,28 Н (14,8 %)
- індуктивний 0,44 Н (5,1 %)
- «інше» +15 %

C_L на 200 км/год = 51,60/(1 893,5 · 0,21) = **0,1298**. Крило працює майже вхолосту й тягне саму лише змочену площу.
Зменшення S до 0,105 м² дало б +13 % дальності на 200 км/год і **+40 км/год** максималки — але посадкова зросла б з 72 до **102 км/год**. Це тема R05, не R04.

### Найкраща дальність — не на 200 км/год
Розгортка для конфігурації E («чиста» модель, 333 Вт·год):

| км/год | L/D | P_ел | дальність |
|---|---|---|---|
| 80 | 10,86 | 138 Вт | 192,9 км |
| **100** | **11,80** | **159 Вт** | **209,7 км** ← максимум |
| 140 | 9,71 | 270 Вт | 172,5 км |
| **200** | **5,96** | **629 Вт** | **106,0 км** |
| 300 | 3,00 | 1 873 Вт | 53,3 км |
| 340 | 2,40 | 2 649 Вт | 42,7 км |

> **200 км/год коштує рівно половину дальності від оптимуму.** Але це свідомий вибір швидкісного апарата, і на 200 км/год L/D = 5,95 проти 2,38 на 342 км/год — **утричі краще, ніж у початковій місії**. Перехід на 200 км/год — найсильніше рішення в проєкті після відмови від каналу.

---

## 🚩 Чого я НЕ зміг знайти / що є моїм припущенням

- ❌ **Не знайдено** готової карбонової труби Ø75–100 мм у R&G і cnc-zubehoer. Ціну «карбонова труба Ø75» у таблиці вище **не вказано** — це спецзамовлення
- ❌ **Не знайдено** ціни на трубу cnc-zubehoer 52×50×1000
- ⚠️ Маси корпусів (крім Klima) — **мої розрахунки** за довідковими густинами (PETG 1 270, PVC 1 400, CFRP 1 550 кг/м³), а не специфікації товарів
- ⚠️ AR = 6, e = 0,80, t/c = 0,10, S_хвіст = 0,25·S, «інше» +15 % — **усе моє**. Дальність чутлива до них лінійно
- ⚠️ C_D,ніс плоского торця 0,80 і півсфери 0,01 взято з вторинних переказів Hoerner, **не з оригіналу**
- ⚠️ Mair (1969) — прочитано лише **анотацію**, повний текст за пейволом. Число «60 % діаметра» з анотації, криві опору — ні
- ⚠️ Форма ідеального тіла обертання модельована **витягнутим сфероїдом** (точно рахується). Реальний фюзеляж на ±5 % інший
- ⚠️ Базовий опір за Hoerner виведено для тіл **без струменя**. Штовхаючий гвинт змінює це принципово — не враховано
- ⚠️ Виграш BLI 7 % — з роботи по **повнорозмірному** літаку. Для Re в 30 разів менших не перевірявся
- ⚠️ Мої «чисті» цифри опору в 2,0–2,2 рази оптимістичніші за практичний модельний C_d,змоч = 0,008. **Довіряйте консервативному варіанту**

---

## 🔗 Далі — R05

R05 (планер і керування) має вирішити те, що виявилось більшим за фюзеляж:
1. **Площа крила** — 0,21 м² на 200 км/год дає C_L = 0,13. Це головна деталь опору. Компроміс із посадковою швидкістю
2. Профіль крила й реальний C_d при Re 7·10⁵
3. Схема хвоста під штовхаючий гвинт (V-подібний на балках vs хрестоподібний перед гвинтом)
4. Чи лишаються 333 Вт·год і 43 % маси на батарею оптимальними на новій точці 200 км/год

## 📚 Джерела

- HAW Hamburg, *Aircraft Design*, гл. 13 «Drag Prediction» — рівн. (13.16), (13.17), (13.23): https://www.fzt.haw-hamburg.de/pers/Scholz/HOOU/AircraftDesign_13_Drag.pdf
- Mair, W. A. (1969), *Aeronautical Quarterly* 20(4), 307–320: https://www.cambridge.org/core/journals/aeronautical-quarterly/article/abs/reduction-of-base-drag-by-boattailed-afterbodies-in-lowspeed-flow/D82CBC6311E9BAB973ED27AB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
- rc-soar, Sailplane Performance Analysis (C_d,фюз = 0,008 на змочену): https://rc-soar.com/tech/perfanal.htm
- Raketenmodellbau Klima, Körperrohre: https://www.raketenmodellbau-klima.de/Raketenmodellbau/Zubehoer/Ersatz-Bauteile/Koerperrohre.htm
- Höllein, SLS XTRON 6S 5000 mAh 40C (163×45×49 мм, 748 г): https://www.hoelleinshop.com/
- R&G Faserverbundwerkstoffe, CFK-Rundrohre: https://www.r-g.de/en/list/CFRP/Carbon-tubes/Round/wound--all-
- TU Delft, van Arnhem, *Design and Analysis of an Installed Pusher Propeller with Boundary Layer Inflow*: https://repository.tudelft.nl/islandora/object/uuid:267beaa5-8b62-4e58-b1ad-ff94355c68f9
