NetHunter123/Jflyproject/_Archiv/R04c-EDF-Nutzlast.md

---
tags:
  - project
  - engineering
  - gungnear
etappe: R04c
status: 🔬 дослідження записане, очікує перевірки
updated: 2026-09-23
---

# R04c — Максимальна вага з ІМПЕЛЕРОМ (порівняльний варіант)

> Напрямок R04, вимір 3: **максимальна корисна вага імпелерної конфігурації** на крейсері 200 км/год.
> Рушій уже обрано — гвинт. Цей файл рахує імпелер **тільки як порівняння**, щоб було видно, чого коштує відмова від нього.
> ⚠️ Це **прохід 1 (дослідження)**. Перевірка — окремим проходом, поправки дописуються нижче.

---

## 🎯 Коротка відповідь

| Питання | Відповідь |
|---|---|
| Тяга DS-51 на 55,6 м/с (200 км/год) | **32,5 Н** (проти 55 Н статичної, проти 23,1 Н на 99 м/с) |
| Провал тяги на 200 км/год — гірший чи кращий? | **КРАЩИЙ.** На 200 км/год лишається 59 % статичної, на 355 км/год — лише 42 % |
| Корисна вага, апарат 5 кг, 1 кг LiPo | **1,06–1,27 кг** (залежно від крила), дальність **19–23 км** |
| Найбільша реалістична корисна вага | **≈ 9,5 кг** при 25 кг злітної, дальність 50 км, один DS-86 120 мм |
| Те саме з гвинтом | **10,9 кг** — імпелер дає **87 %** вантажу гвинта |
| Головна втрата імпелера на крейсері | **не тяга і не струмінь, а внутрішній ККД: 0,616 проти 0,85 у гвинта** |

**Імпелер програє не катастрофічно за вантажем (−13 %), але сильно за дальністю (−37 % на 5 кг).**
І — несподівано — **зі зростанням масштабу розрив майже зникає**.

---

## 1. Перевірка методу на заводських числах

Тотожність, якою рахується все далі:

```
T = ṁ·Ve,  ṁ = ρ·A_e·Ve   →   A_e = T/(ρ·Ve²)
P_струменя = ½·ṁ·Ve² = ½·T·Ve
η_заг = P_струменя / P_ел = T·Ve / (2·P_ел)
```

Застосовуємо до всієї родини Schübeler (усі три числа на кожен вентилятор — із заводських сторінок):

| Вентилятор | T, Н | P, Вт | Ve, м/с | A_e, см² | **η_заг** | Н/кВт |
|---|---|---|---|---|---|---|
| DS-51-AXI HDS 90 мм | 55 | 4 270 | 95,6 | 49,13 | **0,616** | 12,88 |
| DS-86-AXI HDS 120 мм | 101 | 7 500 | 99,0 | 84,12 | **0,667** | 13,47 |
| DS-98-DIA HST 128 мм | 130 | 9 700 | 108,0 | 90,98 | **0,724** | 13,40 |
| DS-215-DIA HST 195 мм | 250 | 15 600 | 98,0 | 212,50 | **0,785** | 16,03 |

**Два незалежні підтвердження, що метод правильний:**

1. **Schübeler сам пише для DS-215: «overall efficiency 78 %».** Тотожність дає **0,785**. Збіг до 0,5 в. п.
2. **DS-98: заводська площа ометання 98 см²**, тотожність дає A_e = 90,98 см² → σ = 0,928. Саме така конфузорна насадка й має бути. Три різні мотори на тому самому вентиляторі дають A_e = 90,98 / 92,83 / 94,70 см² — розкид 4 % на дворазовій зміні потужності.

### ⚠️ Поправка до вхідної передумови

Завдання казало: «Real overall efficiency approx 0.70 (an earlier 0.616 figure was too low)».
**Це не так для 90-мм вентилятора.** Три заводські числа DS-51 (55 Н, 4 270 Вт, 95,6 м/с) **взаємно узгоджені лише при η = 0,616**. Якби η справді було 0,70, то при 4 270 Вт вийшло б Ve = 99,8 м/с і T = 59,9 Н — більше за заводський максимум.

0,70 — це, найімовірніше, **аеродинамічний ККД самого вентилятора**, без мотора й ESC:
`0,70 × 0,88 (мотор×ESC) = 0,616`. Обидва числа правильні, але означають різне.

**Головний висновок таблиці:** η росте **0,616 → 0,785** з діаметром. **90-мм вентилятор — найгірший у родині.** Це визначає всю відповідь про масштабування.

---

## 2. Тяга імпелера на швидкості

Фіксоване сопло, стала електрична потужність:

```
η·P_ел = ½·ṁ·(Ve² − V₀²),   ṁ = ρ·A_e·Ve
→ Ve³ − Ve·V₀² = 2·η·P/(ρ·A_e) = K

K = 2·0,6157·4270 / (1,225·4,9126·10⁻³) = 873 723 м³/с³
```

| V₀, м/с | км/год | Ve, м/с | ṁ, кг/с | **T, Н** | η_рушійний | η_заг | T·V₀, Вт |
|---|---|---|---|---|---|---|---|
| 0 | 0 | 95,6 | 0,575 | **55,0** | — | 0 | 0 |
| 13,9 | 50 | 96,3 | 0,579 | 47,7 | 0,252 | 0,155 | 663 |
| 27,8 | 100 | 98,3 | 0,592 | 41,7 | 0,441 | 0,271 | 1 159 |
| 41,7 | 150 | 101,6 | 0,612 | 36,7 | 0,581 | 0,358 | 1 529 |
| **55,6** | **200** | **106,3** | **0,640** | **32,5** | **0,686** | **0,423** | **1 805** |
| 83,3 | 300 | 119,4 | 0,719 | 25,9 | 0,822 | 0,506 | 2 161 |
| 98,6 | 355 | 128,5 | 0,774 | 23,1 | 0,868 | 0,535 | 2 283 |

**Звірка:** на 99 м/с модель дає 23,1 Н, адверсарна перевірка R03 давала ~21 Н → збіг 91 %.

### Провал тяги на 200 км/год **менший**, ніж на 355 км/год

- 200 км/год: 32,5 / 55 = **59 % статичної**
- 355 км/год: 23,1 / 55 = **42 % статичної**

Нижчий крейсер **допомагає** імпелеру за тягою. Але одночасно **шкодить за ККД**: на повному газі η_заг = 0,423 на 200 км/год проти 0,535 на 355 км/год. Імпелер — машина з високою швидкістю струменя, вона любить летіти швидко.

---

## 3. Але на крейсері газ прибраний — і це все змінює

Апарату 5 кг на 200 км/год потрібно лише ~10,7 Н, а не 32,5 Н. Отже імпелер працює на **27 % газу**, а не на повному. Тоді:

```
Ve = V₀/2 + √(V₀²/4 + T/(ρ·A_e))
   = 27,8 + √(772 + 10,68/(1,225·4,9126·10⁻³)) = 27,8 + √(772 + 1 774) = 78,2 м/с
η_рушійний = 2/(1 + 78,2/55,6) = 0,831
η_заг = 0,616 × 0,831 = 0,512
P_ел = 1 161 Вт
```

> **Ключовий висновок усього файлу.** На крейсері 200 км/год **рушійний ККД імпелера цілком здоровий — 0,831.** Теза «струмінь надто швидкий» на прибраному газі **не працює**.
> Імпелер програє **виключно на внутрішньому ККД**: 0,616 проти 0,85 у зв'язки гвинт+мотор.
> Це втрати в лопатях, спрямляючому апараті, зазорі й соплі. Їх не прибрати налаштуванням.

### ⚠️ Найслабше місце цього розрахунку

Я припустив η_внутр = 0,616 **сталим** аж до 27 % газу. Перевірка каже, що це **оптимістично**:

```
статика: Δp₀ = ½·1,225·95,6²          = 5 598 Па,  Q = 0,470 м³/с
крейсер: Δp₀ = ½·1,225·(78,2² − 55,6²) = 1 859 Па,  Q = 0,384 м³/с
Δp/Δp_розр = 0,332,  але  Q/Q_розр = 0,818
```

За законом вентилятора (Δp~N², Q~N) падіння тиску в 0,332 означає N/N_розр = 0,576, а тоді й Q мало б бути 0,576. Насправді 0,818 → **коефіцієнт витрати в 1,42 раза вищий за розрахунковий**, тобто вентилятор заганяється у зону вільної подачі, де ККД осьового вентилятора валиться.

Додатково: **швидкісний напір на крейсері q = 1 890 Па ≈ підвищення тиску самим вентилятором 1 859 Па.** Тобто **вхідний дифузор стискає повітря не менше, ніж вентилятор.** Вентилятор майже розвантажений.

**Смуга чутливості (апарат 5 кг, T = 10,68 Н):**

| η_внутр | P_ел, Вт | η_заг | дальність з 1 кг LiPo |
|---|---|---|---|
| 0,616 (каталог) | 1 160 | 0,512 | **19,4 км** |
| 0,55 | 1 299 | 0,457 | 17,3 км |
| **0,50 (реалістично)** | **1 429** | **0,415** | **15,7 км** |
| 0,45 | 1 588 | 0,374 | 14,2 км |

Далі в таблицях **заголовні числа — каталожні (0,616)**, тобто **на користь імпелера**. Реальність на 15–20 % гірша.

---

## 4. Планер і маси (однакові для обох варіантів)

### Опір — модель відкалібрована на перевіреному числі R03

```
D = q·(f_корпус + 0,0133·S) + W²/(q·S·π·AR·e),   AR = 6, e = 0,85, CL_max = 1,0
```

**Калібрування:** m = 5,26 кг, S = 0,2104 м² (25 кг/м²), V = 99 м/с, f = 2,20·10⁻³ м²
→ D = **30,14 Н**. R03 дає ~30 Н. ✅

**Масштабування опору з розміром** (це виправлення — тримати f сталим було б помилкою):
`f_гвинт(m) = 2,20·10⁻³·(m/5,26)^0,60` — показник 2/3 за змоченою площею, −0,067 за Cf(Re)

**Штраф імпелера за товстіший фюзеляж.** 90-мм вентилятор вимагає фюзеляж ⌀125 мм проти ⌀90 мм у гвинта:

| Вентилятор | підлога f_корпус, м² |
|---|---|
| 90 мм | 2,78·10⁻³ |
| 120 мм | 3,37·10⁻³ |
| 128 мм | 3,54·10⁻³ |
| 195 мм | 5,25·10⁻³ |

> **Штраф імпелера за фюзеляж зникає вище ~7,8 кг** — при цій масі фюзеляж під гвинт і так доростає до 125 мм.

### Маси

```
m_конструкція = 0,28·m_злітна + 3,0 [кг/м²]·S
```
**Калібрування на реальному залізі:** HobbyKing ViperJet Composite 90 мм EDF — голий планер **2 170 г**, політна 3,6–4,1 кг, розмах 1,37 м (S ≈ 0,32 м²).
Модель: 0,28·4,0 + 3,0·0,32 = **2,080 кг** проти 2,170 кг → **96 %**. ✅

| Модуль імпелера | г | джерело |
|---|---|---|
| DS-51-AXI HDS | 114 | ✅ Schübeler |
| HET 700-68-1125 | 330 | ✅ turbines-rc (⌀39 мм, 67,5 мм, 1125 kV) |
| ESC | 150 | ⚠️ **припущення, не знайдено** |
| канал + кріплення + проводка | 200 | ⚠️ **припущення, не знайдено** |
| **разом** | **794** | |

Модуль гвинта для порівняння: **630 г** (гвинт 9,9 г + мотор 390 г — обидва підтверджені; ESC 150 г і кріплення 80 г — припущення).

Авіоніка 150 г. Батарея: LiPo **148 Вт·год/кг**, Li-ion **200 Вт·год/кг** (обидва на рівні пакета, підтверджені).
Придатна частка енергії **0,76** = 0,85 глибина розряду × 0,90 на зліт, набір і резерв.

---

## 5. Крива вантаж–дальність, імпелер, 5 кг, 200 км/год

Крило R03: S = 0,20 м² (25 кг/м²), звалювання 20,0 м/с = **72 км/год**.
Маси: конструкція 2,00 + модуль 0,79 + авіоніка 0,15 → **пул батарея+вантаж = 2,06 кг**
Опір 10,68 Н, **L/D = 4,59**, P = 1 161 Вт, газ 27 %, T_ст/W = 1,12

| Батарея, кг | Вантаж, кг | Час, хв | Дальність LiPo | Дальність Li-ion |
|---|---|---|---|---|
| 0,50 | **1,56** | 2,9 | 9,7 км | 13,1 км |
| 1,00 | **1,06** | 5,8 | 19,4 км | 26,2 км |
| 1,50 | **0,56** | 8,7 | 29,1 км | 39,3 км |
| 2,00 | **0,06** | 11,6 | 38,8 км | 52,4 км |
| 2,06 | 0 | 12,0 | 39,9 км | 53,9 км |

**Те саме з гвинтом** (APC 11×14 @ 10 000 об/хв, η = 0,846 із реальних даних APC, привід 0,85 → η_заг 0,719; D = 9,46 Н, P = 742 Вт):

| Батарея, кг | Вантаж, кг | Дальність LiPo | Дальність Li-ion |
|---|---|---|---|
| 1,00 | **1,22** | 30,3 км | 41,0 км |
| 2,00 | **0,22** | 60,6 км | 81,9 км |

> ⚠️ Побіжне, але важливе: **APC 7×15E — неправильний гвинт для 200 км/год.** Він під 355 км/год.
> На 55,6 м/с при потрібних 10 Н він іде на 14 000 об/хв з η = 0,797, тоді як **APC 11×14 на 10 000 об/хв дає η = 0,846**. Зміна крейсера міняє й гвинт. Деталі — у вимірі про гвинт.

---

## 6. Що насправді обмежує вантаж

Крило під звалювання 25 м/с (90 км/год), батарея 1 кг LiPo.
Умови придатності: вантаж > 0; T_статична/W ≥ 0,35 (зліт із розбігу); T_крейс_макс/D ≥ 1,4.

| Злітна | S, м² | Констр. | Вантаж гвинт | Вантаж імпелер 90 | L/D | T_ст/W | Запас крейс. |
|---|---|---|---|---|---|---|---|
| 5 кг | 0,128 | 1,78 | **1,44** | **1,27** | 5,4 | 1,12 | 3,57 |
| 10 кг | 0,256 | 3,57 | **4,65** | **4,49** | 7,1 | 0,56 | 2,35 |
| 15 кг | 0,384 | 5,35 | **7,87** | **7,70** | 7,6 | 0,37 | 1,68 |
| 25 кг | 0,640 | 8,92 | **13,67** | **13,34** | 8,2 | 0,45 (×2) | 2,18 |
| 50 кг | 1,281 | 17,84 | **28,49** | **27,83** | 9,0 | 0,45 (×4) | 2,39 |

**Вантаж імпелера відстає від гвинта лише на 0,16–0,66 кг на всьому діапазоні.** Різниця — це просто зайві 164 г модуля.

**Вантаж обмежує не вентилятор, а крило й закон.** Один DS-51 тягне апарат до ~15,7 кг при T/W = 0,35. Реальні стелі:
- **25 кг — межа «відкритої» категорії ЄС** (Regulation 2019/947, підкатегорія A3: злітна маса < 25 кг разом із паливом і вантажем). Вище — «специфічна» категорія з дозволом на операцію. ✅ джерело EASA
- L/D росте з масштабом (5,4 → 9,0), бо опір корпуса росте як m^0,6, а вага — як m

---

## 7. Вантаж–дальність на межі 25 кг (де вантаж максимальний)

S = 0,640 м² (39 кг/м²), конструкція 8,92 кг, опір 29,8 Н, L/D = 8,23

| Конфігурація | Модуль, кг | P_крейс, Вт | T_ст/W | Пул, кг | η_внутр |
|---|---|---|---|---|---|
| Гвинт ×2 | 1,26 | 2 302 | 0,45 | 14,67 | — |
| DS-51 90 мм ×2 | 1,59 | 3 395 | 0,45 | 14,34 | 0,616 |
| **DS-86 120 мм ×1** | **1,15** | **3 215** | 0,41 | **14,78** | 0,667 |
| DS-98 128 мм ×1 | 1,70 | 2 924 | 0,53 | 14,23 | 0,724 |
| DS-215 195 мм ×1 | 4,10 | 2 412 | 1,02 | 11,83 | 0,785 |

**Вантаж, кг, з Li-ion 200 Вт·год/кг:**

| Конфігурація | 25 км | 50 км | 100 км | 150 км |
|---|---|---|---|---|
| **Гвинт ×2** | **12,78** | **10,88** | **7,10** | **3,31** |
| DS-51 90 мм ×2 | 11,55 | 8,76 | 3,17 | — |
| **DS-86 120 мм ×1** | 12,13 | **9,49** | 4,20 | — |
| DS-98 128 мм ×1 | 11,82 | 9,42 | **4,61** | — |
| DS-215 195 мм ×1 | 9,85 | 7,86 | 3,90 | — |

> **ВІДПОВІДЬ НА ГОЛОВНЕ ПИТАННЯ:**
> **Найбільший реалістичний вантаж імпелера — 9,5 кг** при 25 кг злітної, дальності 50 км і 200 км/год,
> з одним **DS-86-AXI HDS 120 мм**. Гвинт у тій самій точці дає **10,9 кг** → імпелер = **87 %**.
> На дальності 150 км імпелер **не закриває місію взагалі** ні в одній конфігурації, гвинт — 3,3 кг.

---

## 8. Багато малих вентиляторів проти одного великого

| Злітна | Варіант | n | Модуль, кг | Вантаж @50 км | Вантаж @100 км |
|---|---|---|---|---|---|
| 10 кг | DS-51 90 | 1 | 0,79 | **2,93** | 0,38 |
| 10 кг | DS-86 120 | 1 | 1,15 | 2,89 | **0,64** |
| 10 кг | DS-215 195 | 1 | 4,10 | — | — |
| 25 кг | DS-51 90 | 2 | 1,59 | 8,76 | 3,17 |
| 25 кг | **DS-86 120** | 1 | 1,15 | **9,49** | 4,20 |
| 25 кг | DS-98 128 | 1 | 1,70 | 9,42 | **4,61** |
| 50 кг | DS-51 90 | 4 | 3,18 | 18,76 | 8,69 |
| 50 кг | **DS-86 120** | 2 | 2,30 | **20,18** | 10,66 |
| 50 кг | DS-215 195 | 1 | 4,10 | 20,10 | **12,30** |

**Правило, яке з цього випливає:**
- **На коротку дальність виграє легкий модуль**, навіть із гіршим ККД → багато малих
- **На довгу дальність виграє ККД**, бо батарея важить більше за модуль → один великий
- Точка перетину — приблизно **80–100 км** на 50 кг
- **DS-215 195 мм при 5 і 8 кг злітної фізично не злітає**: сам модуль 4,10 кг з'їдає весь пул

---

## 9. Чи закриває імпелер розрив на масштабі — ТАК

Потрібна потужність на крейсері, імпелер ÷ гвинт:

| Злітна | Найкращий імпелер | P імпелер | P гвинт | **Перевитрата** |
|---|---|---|---|---|
| 5 кг | DS-51 90 мм | 969 Вт | 608 Вт | **+59 %** |
| 25 кг | DS-98 128 мм | 2 924 Вт | 2 302 Вт | **+27 %** |
| 50 кг | DS-215 195 мм | 4 746 Вт | 4 208 Вт | **+13 %** |

> **Це найважливіший результат для розуміння імпелера.**
> Програш імпелера — **не фундаментальний, а масштабний.** На 5 кг він програє у півтора раза, на 50 кг — на одну восьму.
> Причина: η_внутр росте 0,616 → 0,785, і на більшій вазі вентилятор працює ближче до розрахункового навантаження.
> **Для іграшки 5 кг імпелер — поганий вибір. Для апарата 50 кг це вже майже паритет.**

---

## 10. Чесне порівняння: де імпелер ВИГРАЄ

| Вісь | Гвинт | Імпелер 90 мм | Хто |
|---|---|---|---|
| Вантаж, 5 кг апарат | 1,44 кг | 1,27 кг | гвинт +13 % |
| Дальність, 5 кг, 1 кг LiPo | 30,3 км | 19,4 км | **гвинт +56 %** |
| Потужність на крейсері | 608–742 Вт | 969–1 161 Вт | гвинт |
| η_заг на 200 км/год | 0,719 | 0,512 (реально ~0,42) | **гвинт** |
| L/D на 200 км/год | 5,18 | 4,59 | гвинт (товщий фюзеляж) |
| Ціна модуля | ~€665 | **€628,99** | **імпелер, дешевше** |
| Статична тяга | 45–60 Н @ ~3,1 кВт | 55 Н @ 4,27 кВт | гвинт на ват, **паритет за модулем** |
| Швидкість звалювання | однакова (крило те саме) | однакова | паритет |
| **Контейнмент ротора** | ❌ 438 Дж, нічим не стримані | ✅ **карбоновий кожух** | **ІМПЕЛЕР** |
| **Безпека на землі** | ❌ відкритий різак | ✅ нічого відкритого | **ІМПЕЛЕР** |
| **Посадка на пузо / ґрунт** | ❌ гвинт розбивається | ✅ байдуже | **ІМПЕЛЕР** |
| **Момент, P-фактор, гіроскоп** | ❌ є, треба парирувати | ✅ **немає** | **ІМПЕЛЕР** |
| **Просто встановити** | треба вал, кок, кліренс | ✅ труба у фюзеляжі | **ІМПЕЛЕР** |
| Шум | ~600 Гц (18 000×2) | ~8 250 Гц (45 000×11) | **гвинт**, A-зважування карає 2–8 кГц |
| Масштабованість | рівна | **краща** (+59 % → +13 %) | імпелер на великому |

### Де імпелер виграє по-справжньому

1. **Контейнмент — єдиний аргумент, що не б'ється жодним ККД.** Карбоновий кожух — справжня захисна конструкція; у гвинта її немає взагалі.
2. **Ціна модуля нижча** — €628,99 проти ~€665. Несподівано, але так.
3. **Немає реактивного моменту й гіроскопічних ефектів** — апарат простіший у керуванні, особливо на зльоті.
4. **Можна сідати на пузо** — для апарата без шасі це реальна експлуатаційна перевага.
5. **Розрив закривається з масштабом** — якщо проєкт колись виросте до 25–50 кг, імпелер перестає бути поганим вибором.

### Чого імпелер НЕ дає, всупереч очікуванням

- **Не дає більшої статичної тяги за модуль.** 55 Н проти 45–60 Н у гвинта — паритет. Просто імпелеру на це треба 4,27 кВт, а гвинту ~3,1 кВт.
- **Не страждає від «надто швидкого струменя» на крейсері.** На прибраному газі η_рушійний = 0,831, цілком здоровий.
- **Не виграє злітну дистанцію** при однаковій потужності.

---

## 📌 Припущення, до яких результат чутливий

| Припущення | Значення | Чутливість |
|---|---|---|
| η_внутр стале на частковому газі | 0,616 | **ВИСОКА.** Реально 0,45–0,55 → дальність −15…−27 % |
| Маса ESC | 150 г | середня, **не знайдено** |
| Маса каналу+кріплення+проводки | 200 г | середня, **не знайдено** |
| ККД мотор×ESC для гвинта | 0,85 | середня, **не знайдено** |
| Модель конструкції 0,28·m + 3,0·S | — | висока на вантаж; звірено з ViperJet (96 %) |
| f_корпус ∝ m^0,60 | — | висока на масштабуванні |
| Довжина фюзеляжу імпелера 8,5·d | — | середня, **власна оцінка** |
| Придатна частка батареї 0,76 | — | пряма пропорція до дальності |
| CL_max = 1,0, AR = 6, e = 0,85 | — | середня |

## 🔍 Що має перевірити адверсарний прохід

1. **η = 0,616 проти 0,70** — чи правильно я відкинув 0,70 (аргумент: три каталожні числа DS-51 не сходяться при 0,70)
2. **Модель сталої потужності з фіксованим соплом** — чи коректно описує імпелер на швидкості
3. **Штраф за частковий газ** — 0,50 замість 0,616 це здогад; чи є реальні дані характеристики вентилятора
4. **Модель конструкції** звірена лише на одному планері (ViperJet)
5. **Ціни**: DS-86 (USD 329) і DS-215 (USD 4 790) — без ПДВ, у доларах; курс я НЕ переводив
6. **Маса ESC і каналу** — чисті припущення, треба знайти реальні
7. Чи справді **DS-98 128 мм коштує €1 099 без мотора** (R03 уже ловив помилку на цьому)

## 📚 Джерела цього проходу

- Schübeler Store — DS-51-AXI HDS (90 мм): 55 Н, 4 270 Вт, 95,6 м/с, 45 000 об/хв, 114 г, €187,00, таблиця моторів
- Schübeler Store — DS-98-DIA HST (128 мм): €1 099,00, ометання 98 см², три мотори 78/107/130 Н
- turbines-rc — DS-86-AXI HDS (120 мм): 101 Н, 7 500 Вт, 99 м/с, 35 500 об/хв, 290 г, USD 329 без податку
- turbines-rc — DS-215-DIA HST (195 мм): 250 Н, 15,6 кВт, 98 м/с, 3 400 г, USD 4 790, **«overall efficiency 78 %»**
- turbines-rc — HET 700-68-1125: ⌀39 мм, 67,5 мм, **330 г**, 1125 kV
- HobbyKing ViperJet Composite 90 мм EDF: планер **2 170 г**, політна 3,6–4,1 кг, розмах 1 370 мм
- APC PER3 файли даних (7×15E, 11×14 та ще ~30) — реальні дані, інтерпольовані на 124,3 mph
- EASA — Regulation 2019/947, підкатегорія A3: злітна маса < 25 кг

> ✅ Побіжна знахідка: **Tenshock 2230-11 існує** — він є у власній таблиці моторів Schübeler (6S, 95 A, 33 Н, 35 000 об/хв). R03 писав, що його «не знайдено взагалі».
