NetHunter123/Jflyproject/_Archiv/R06-Hybrid.md

---
tags:
  - project
  - engineering
  - gungnear
etappe: R06
status: 💾 дослідження записано, перевірка попереду
updated: 2026-09-24
---

# R06 — Гібрид: тягнучий гвинт + внутрішній канальний вентилятор

> ⚠️ **ДОСЛІДНИЦЬКИЙ прохід.** 2 агенти. Оцінювалась конкретна пропозиція Віктора від 2026-09-24.

## 📋 Що оцінювали

Пропозиція: крила спереду · мотор із гвинтом на носі · **усередині труби звужений канал** · **електроніка в кільцевому просторі між каналом і зовнішньою трубою** · другий мотор за звуженням · бот-тейл із вузьким виходом.

## 🎯 Відповідь: НІ. Будувати тягнучий гвинт сам по собі.

Але **три частини міркування правильні**, і дві з них — поправки до записів проєкту на вашу користь.

---

## ✅ Що правильно

### 1. Ви незалежно вивели поглинання примежового шару

Кормовий вентилятор, що заковтує примежовий шар фюзеляжу, **справді зменшує потрібну рушійну потужність** — він не розганяє свіже повітря, а повертає енергію вже загальмованому. Реальна архітектура: NASA STARC-ABL, MIT/Aurora D8, EU CENTRELINE/DisPURSAL, TU Delft.

**Це не венturi й не другий співобертовий ротор. Це інший, законний механізм.**

### 2. 🔴 ПОПРАВКА ДО ЗАПИСІВ: вузький вихід справді перестає бути безглуздим

З протоком усередині **звуження на виході стає справжнім реактивним соплом**. Розрахунок: вихід 44,4 мм при захваті 50,6 мм, співвідношення площ 0,77, число Маха на виході 0,21 — **без запирання, без взаємного знищення інтегралів тиску**.

> **Відхилення №1 (венturi = нуль) і №4 (запирання) до цієї геометрії НЕ застосовуються.** Поправку прийнято в записи проєкту.

### 3. 🔴 ПОПРАВКА: механізм не перевертається на модельному масштабі

Єдиний натурний експеримент із BLI на фюзеляжі (della Corte та ін., TU Delft, AIAA Journal 2021) виконано при Re_L = 3,5–4,7·10⁶.

**Ваш фюзеляж на 55,6 м/с дає Re_L = 3,43·10⁶.**

> Їхній експеримент — це, з точністю до 20 %, **ваш фюзеляж**. І там воно працювало.

---

## ❌ Що вбиває ідею: три числа

### (а) Геометрична неможливість — вирішальна

Примежовий шар на хвості: товщина **16,42 мм**, площа кільця **47,2 см²**.

Згорнути це кільце в коло — вийде діаметр **77,5 мм**.

> **Більше за 75-міліметровий фюзеляж, який цей шар і створив.**

Канал, захований **усередині** труби, ніколи не зможе вмістити примежовий шар, що виріс **зовні** неї.

Великі літаки цього уникають, бо в них кільце шару — лише ~35 % перерізу фюзеляжу. На трубі 75 мм це **107 %**. Це і є інверсія масштабу.

| | Кільце шару / переріз фюзеляжу |
|---|---|
| Фюзеляж класу 737 | 0,345 |
| **Ваша труба 75 мм** | **1,066** |

### (б) Передумова про компонування суперечить сама собі

Вентилятор із корисною часткою тяги 20 % потребує захвату **50,6 мм** усередині труби з внутрішнім діаметром 72,6 мм. Лишається кільце глибиною **10,7 мм**.

> **Комірки 21700 мають діаметр 21,55 мм. Не влазить жодна.**

А пакет із 36 комірок потребує ~350 мм труби **повного діаметра**.

**Звуження не звільняє місце для громіздкого — воно знищує єдине місце, де громіздке могло лежати.**

### (в) Енергії немає на тій швидкості, яка вам потрібна

На режимі витривалості індуктивна потужність — 75 % від усієї, тож фюзеляж дає лише **3,5–5,7 % опору**.

| | Значення |
|---|---|
| Теоретична стеля виграшу | **0,83–1,34 %** = **+1,0…+1,7 хв зі 125** |
| Вартість другої силової установки (~400 г) | **−12,9 хв** |
| Потрібно для беззбитковості | **10,34 %** |

**Не вистачає у 8–12 разів** — і це при ідеальному вентиляторі, ідеальному вході й нульовій доданій масі.

### І вхід, який ви самі назвали відкритим питанням

Ніс зайнятий мотором, тож заводити повітря доведеться збоку. Реальний підфюзеляжний або NACA-вхід заковтує лише **~10 % дефіциту імпульсу** фюзеляжу:

- реальний виграш: **2,5 Вт** із 747 Вт на валу
- втрати входу й каналу: **32–56 Вт**

**Мінус ще до того, як вентилятор увімкнули.**

### ⛔ Окремо: кільцевий вхід навколо кока фізично неспроможний

Він заковтує струмінь від гвинта на **58,3 м/с — це на 4,8 % ВИЩЕ за швидкість набігання**, а не нижче. Це протилежність BLI і рівно той випадок послідовного ступеня, який уже відхилено.

---

## 📦 Компонування: звуження — це податок, а не вигода

### Таке звуження КОШТУЄ об'єму

| Варіант каналу | Кільцевий об'єм |
|---|---|
| Звуження 70 → 40 мм на 500 мм | 852,5 см³ |
| **Сталий Ø40 мм (та сама горловина)** | **1 441,5 см³** |
| Сталий Ø55 мм | 881,9 см³ |

> **Звуження викидає 589 см³ — 41 % того самого кільця, яке мало б створити.**

Корисного об'єму (глибина ≥10 мм): звуження дає 513,6 см³ на 210 мм, сталий канал — 1 441,5 см³ на 500 мм. **У 2,81 раза гірше.**
На передньому кінці звуженого кільця глибина взагалі **1,3 мм**.

**Усе, що вміщує звужений канал, сталий канал того самого мінімального діаметра вміщує краще — і по всій довжині, а не на задніх 40 %.**

### Електроніка не влазить у жодне кільце при 75 мм

| Компонент | Потрібен канал не ширший за |
|---|---|
| ESC (YGE Aureus, 78×37×20 мм) | **Ø22,5 мм** — «це не канал, це соломинка» |
| Комірка 21700 | Ø26,1 мм |
| **Приймач (Jeti REX 6)** | **Ø46,2 мм** — єдине, що справді влазить |

Мінімальна корисна глибина кільця: 6 мм для проводів, **12 мм для будь-якої коробки**.

### Додана змочена площа

- Загерметизоване кільце: **+42,6 %** до зовнішнього фюзеляжу
- Провітрюване кільце: **+143,7 %**

---

## 🌡 Охолодження: намір правильний, геометрія навпаки

Я шукав цю перевагу за вас, бо ви її не заявляли. Вона реальна — але **кільце для неї завелике**.

| | Швидкість повітря | h | Потрібна площа радіатора |
|---|---|---|---|
| Кільце | 0,86 м/с (ламінарно) | 5,6 Вт/м²К | **0,107 м²** — у 20 разів більше, ніж має ESC |
| **Кожух 37×5 мм по ESC** | **11,8 м/с** | **70 Вт/м²К** | **0,0086 м²** |

**Кільце у 12,5 раза гірше за друкований кожух за €2.**

Тепловіддача росте з місцевою швидкістю, а кільце має переріз у 14 разів завеликий. **Охолодження вимагає щільного рукава навколо гарячої деталі — тобто протилежності кільцю.**

> І поправка до R00: знахідка «корпус мотора 75–250 °C» тут **не діє** — мотор тепер тягнучий на носі, у власному струмені, це найкраще охолоджуване місце на апараті. **Гріється ESC, і саме йому потрібен кожух.**

---

## ✅ Три речі, які варто зробити натомість

**1. Кожух охолодження для ESC** — забірник 10 мм за гвинтом, друкований канал із звуженням до 37×5 мм над радіатором, узгоджений вихід біля основи бот-тейла.
**15 г, 0,10 Н (0,16 хв), 2 години роботи.**

**2. Подовжити хвостовий конус** — **0,22 Н (12 Вт) за 20 г**. Без другого мотора, без каналу, без входу, без ESC. Те саме заповнення основи, якого мав досягти внутрішній вихлоп.

**3. Якщо BLI колись знадобиться — штовхаючий гвинт у хвості**, на осі фюзеляжу, що заковтує весь шар. Не вентилятор, закопаний у середину за совком. Така схема **не додає маси взагалі**, тож її ~1 хвилина безкоштовна, а не куплена за 400 г.

**4. Кільцеві шпангоути замість каналу** для жорсткості: три друковані кільця по ~8 г. Внутрішній канал дав би +17 % жорсткості за +31 % маси труби — гірший підсилювач на грам, ніж сама труба.

---

## ⚠️ Дві відкриті суперечності

**1. Стійкість оболонки — розбіжність із R05.**
NASA SP-8007 (2020 Rev 2) дає коефіцієнт зниження γ = 0,736 при r/t = 30,75 → критичне напруження **14,5–21,7 МПа** проти прикладених 7,9, тобто запас **1,8–2,7**.
Аудит R05 брав γ = 0,2–0,3 і отримав 6–11 МПа — у 2,5–3,7 раза консервативніше за опубліковану нижню межу.
**Хтось із них помиляється, і від цього залежить, чи є взагалі проблема з фюзеляжем.**

**2. Центрування переважує все інше в цьому розділі.**
Сам канал коштує 6,3 хв зі 125. А **мотор 456 г у хвості зсуває центр ваги на 38,7 мм**, і виправлення носовим баластом коштує **32,4 хвилини**.
Безкоштовне виправлення існує — **зсунути крило назад на ті самі 38,7 мм**. Перевірити до будь-якого баласту.

---

## 🔍 Що перевіряти

1. Кільце примежового шару = 77,5 мм проти труби 75 мм — вирішальне число всього етапу
2. Стеля виграшу 0,83–1,34 % і беззбитковість 10,34 %
3. Re_L = 3,43·10⁶ проти експерименту TU Delft 3,5–4,7·10⁶
4. Втрата 589 см³ від звуження
5. Суперечність зі стійкістю оболонки: γ = 0,736 чи 0,2–0,3
6. Позначене агентом як власна оцінка: товщина шару на фюзеляжі 737 (0,30 м)

## 🔗 Далі

→ **R06-V** — перевірка цього файлу
