NetHunter123/Jflyproject/_Archiv/R07a-3D-Modell-CFD.md

---
tags:
  - project
  - engineering
  - gungnear
etappe: R07a
status: 🔍 перевірено (R07a-V) — 3 блокери-рішення, дефекти CAD виправляються
updated: 2026-09-24
---

# R07a — 3D-модель і CFD у SimScale

> ⚠️ **ДОСЛІДНИЦЬКИЙ прохід.** 2 агенти: (1) геометрія планера з R00–R06, (2) режими польоту + план CFD. Файли R00–R06 не змінювались.
> Це частина R07 «Креслення»: тут лише геометрія й аеродинамічна перевірка. BOM і бюджет — окремо.
> **R06-V ще не зроблено**, тому все, що спирається лише на R06 (кільця-шпангоути, канал охолодження ESC, довший конус), у модель **не входить**.

## 🎯 Навіщо

Перевірити в CFD, чи планер справді дає ту підйомну силу й той опір, що заклали ручні розрахунки R04/R05. Точки перевірки: **режим максимальної тривалості польоту (~72 км/год)** і **250 км/год**.

## ☁️ SimScale

- Проєкт **«Model 1»**, **публічний**: безкоштовний тариф не дає приватних проєктів. Назва й опис нейтральні, без згадки Gungnear. Рішення Віктора від 2026-09-24.
- Квота на рік: **10 симуляцій, 3000 CPU-год**. Обмежує саме кількість запусків, а не години. Тому геометрію й сітку треба довести до ладу **до першого запуску**.

---

## 📐 Геометрія моделі

Осі: **x** — від кінчика носа назад, **y** — у бік правого крила, **z** — вгору. Вісь фюзеляжу: y = z = 0.

### Зафіксоване в нотатках (locked / derived)

| Вузол | Значення | Джерело |
|---|---|---|
| Фюзеляж | Труба **Ø75,0** (внутр. 72,6), корпус **900 мм**: ніс 0–120, циліндр 120–759, конус 759–900 | R04-Rumpfform «Вихідні припущення»; R05 §3; R05 ПЕРЕВІРКА B |
| Ніс | Дотична **ожива L 120, D 75** (L/D 1,6) | R04-Rumpfform «ПРЯМА ВІДПОВІДЬ», «Ніс» |
| Хвостовий конус | **Косинусна S-крива Ø75 → Ø30 за 141 мм**, макс. кут 14,1°; плоске дно Ø30 | R05 §3 «Бот-тейл»; R05 ПЕРЕВІРКА B п. 3–4 |
| Крило | **0,25 м²** | хаб «Поточна конфігурація після R05» |
| Гвинт | **APC 11×14**, Ø279,4, тягнучий на носі, без каналу | хаб «ТИП РУШІЯ»; R05 §1 |
| Шасі | **Нерухоме обтічене**, колеса **Ø60**, стійка-стрічка **4×20 мм** | хаб; R05 ПЕРЕВІРКА B |
| Маса | **≈5,9 кг** (5,86–6,12). У нотатках явно ніде не записана, виведена агентом | R03; R05 ПЕРЕВІРКА A |

### ⚠️ Припущення: у нотатках цього немає

Узгоджено з тим, на чому стоять ручні розрахунки опору. Кожне можна змінити **до першого запуску в SimScale**.

| Вузол | Прийнято | Чому |
|---|---|---|
| Подовження крила | **AR 6** → розмах **1225**, хорда **204,1** (прямокутне, без стріловидності й крутки) | AR 6 — припущення R04-Rumpfform, на ньому стоїть кожен розрахунок опору. Його **ніколи не обирали** |
| Профіль крила | **MH 32** (8,7 %), задня кромка 0,4 мм (для сітки) | R05 §1 називає «RG 15 / MH 32, t/c 9 %»; «крило 17 мм» у R05-V(B) |
| Установка крила | **Середньоплан** (z = 0), кут установки **+2°**, V **2°**. Передня кромка x = 304, c/4 = 355, лонжерон 361 | Лонжерон на 361 мм — R05 «Дві речі…» |
| Хвіст | **Класичний**. Стабілізатор **470 × 118**, NACA 0009, 0° (V_H 0,50). Кіль **0,0238 м²** (V_V 0,035): трапеція 150/100, висота 190, стріловидність передньої кромки 15° | R05: «масштабувати хвіст за коефіцієнтами об'єму». Значень у нотатках немає |
| Шасі | **Хвостова опора (taildragger)**: одна гнута стрічка, осі x = 300, колія 280; обтічники ~100 × 32 × 68; земля z = −175 | Єдина умова з R05: кінчик гвинта на 102 мм нижче черева. Кліренс 35 мм |
| Кок | Ø57 × 60 (передня половина оживи) | Стандартний розмір |
| Центр мас / точка моментів | x = 355 (25 % САХ) | Від лонжерона на 361 |
| 🔧 Моє відхилення | Задні кромки хвоста на **x = 895, а не 905** (за 5 мм до дна, а не за 5 мм позаду) | Інакше позаду дна стирчать обрубки стабілізатора й кіля — погано для сітки. Плече хвоста коротшає на 10 мм (V_H 0,49) |

### 🗑 Застарілі значення (у модель не беремо)

Крило 0,21 / 0,12 / 0,105 / 0,15 м² → **0,25**. Труба Ø100 → **Ø75**. Штовхаючий гвинт → **тягнучий**. V-хвіст на балках (для штовхаючого) → не визначено, прийнято класичний. Бот-тейл 18,4° / прямий 10° → **S-крива**. Без шасі / прибирається → **нерухоме обтічене**. Батарея 333 Вт·год → **583 Вт·год, 2,85 кг**. Мотор 456–485 г → **1,5–2 кВт, ~230 г**. Макс. швидкість 300–355 → **250 км/год**.

### Спрощення для CFD

- **Без лопатей гвинта**, кок лишається. Похибка: опір занижено на ~3–6 %, підйомну силу на ~2–4 %. Ручні розрахунки R04/R05 теж без гвинта, тож порівняння чесне.
- Усі входи охолодження й щілини рулів закриті. Хвостового колеса немає.
- **Півмодель** із площиною симетрії y = 0.
- Стінки гладкі. Шорсткість додається вручну: CD0 0,025 для шліфованої поверхні проти 0,032–0,035 для необробленого друку.

---

## ✈️ Режими польоту й цілі для CFD

| Режим | V | Потрібний CL | Очікуваний опір | L/D | Re крила |
|---|---|---|---|---|---|
| **Макс. тривалість польоту** | 72 км/год (20 м/с) | **0,945** | ~5,0 Н (чиста збірка 4,8–4,9) | 11,5–12 | 2,8·10⁵ |
| Найкраща якість | 87 км/год (24,2 м/с) | 0,645 | ~4,7 Н | 12,3 | 3,4·10⁵ |
| **Максимальна** | **250 км/год (69,4 м/с)** | **0,078** | 19,8 Н проєктний; **13,6–16,5 Н** чиста збірка | ~2,9 | 9,7·10⁵ |
| Зрив, чисте крило | ≈64 км/год | CL_max 1,2 | — | — | 2,5·10⁵ |

Швидкість 72 км/год — середина діапазону 70–74 з R05-V(A). **Але той діапазон рахували для старого крила 0,21 м².** Для 0,25 м² точного числа в нотатках немає.

### Як читати результат на 250 км/год

- ~~**~14–16 Н** → ручний розрахунок підтверджено.~~
- ~~**~19,8 Н** → запас, закладений у проєктний CD0, з'їдено.~~
- ~~**> 20 Н** → ручні розрахунки оптимістичні.~~

> ❌ **ВИПРАВЛЕНО в R07a-V.** Проблема старої шкали: сам розклад дає 13,5–14,3 Н, а не 13,6–16,5 Н (16,5 взято іншим методом). До того ж CFD на 1g неминуче містить опір фюзеляжу під кутом, навантаження хвоста від Cm профілю і стики. Тому навіть за правильного ручного методу результат ≈15,5–17 Н потрапив би в неописану зону.
> **Нова шкала:**
> - **≈15,5–17 Н** → ручний метод підтверджено;
> - **17–19,8 Н** → ручний метод занижує;
> - **≥ 19,8 Н** → проєктний запас з'їдено.
>
> **На 72 км/год:**
> - **4,6–5,0 Н** → метод підтверджено;
> - **5,0–5,9 Н** → очікувано через CL-залежний опір біля зриву;
> - **> 6 Н** → проблема.
>
> Проєктне значення на 72 км/год з поправкою на Re: ≈5,5 Н, L/D ≈ 10,6.

⚠️ CFD треба порівнювати з **покомпонентною збіркою**, а не з CD0 0,0264. У проєктному CD0 сидить незадокументована «misc»-грудка (~2 Н на 200 км/год) і консервативний множник. Чиста CAD-модель їх не відтворить.

Еталон покомпонентно, 250 км/год: крило 7,8 · хвіст ~~2,2~~ **2,7–2,8** ⚠️ · фюзеляж 2,0–2,2 · шасі 1,2–1,8 · індуктивний 0,3 Н.

> ⚠️ **R07a-V:** 2,2 Н — це хвіст 25 % S із моделі опору. У CAD хвіст займає **31,7 % S** (стабілізатор 0,0555 + кіль 0,0238 м²), тож 2,7–2,8 Н. Збірка саме для CAD-геометрії: 7,57 + 2,80 + 2,08 + 1,25–1,87 + 0,28 = **14,0–14,6 Н**.
> Ще **балансування**. Cm MH 32 ≈ −0,05; установка +2°/0°; ЦМ на c/4. На 1g стабілізатор тиснутиме вниз ≈ −30 Н, індуктивний опір виросте до ≈1,0–1,4 Н.

---

## 🧪 План CFD

Це рекомендація агента з практики CFD, а не з нотаток.

- **Incompressible, стаціонарний, k-ω SST**, повністю турбулентний. Так само, як ручні розрахунки з турбулентним Cf. ρ 1,225, ν 1,46·10⁻⁵.
- Домен: x −5…+12 м, y 0…5 м (симетрія), z −5…+5 м.
- **Одна сітка на всі запуски.** Перший шар 7 мкм, 18 шарів ×1,25. y+ ≈ 0,5 на 72 км/год і ≈ 1,5 на 250 км/год. ~3–6 млн комірок.
- Кут атаки задається **поворотом вектора потоку**, без перебудови сітки.
- Сили окремо по вузлах: крило / фюзеляж / стабілізатор / кіль / шасі.

| # | V, м/с | α, ° | Навіщо |
|---|---|---|---|
| 1 | 69,4 | ~~0~~ **−2,8** ⚠️ | Перевірка налаштувань; 1g на 250 км/год. ❌ R07a-V: α 0° — це не CD0, а ≈4g з опором 18–20 Н. CD0 отримувати екстраполяцією поляри до CL = 0 |
| 2 | 20 | 8 | **Режим макс. тривалості польоту** (CL ≈ 0,95) |
| 3 | 69,4 | −3 | Разом із №1 обмежує α, при якому підйомна сила = вага на 250 км/год |
| 4 | 20 | 4 | Точка поляри (CL ≈ 0,6) → нахил і коефіцієнт Освальда e |
| 5 | 20 | 11 | Запас до зриву (CL ≈ 1,1) |
| 6 | 20 | 8 | Перевірка сітки (дрібніша) |
| 7 | 20 | 0 | Вплив числа Рейнольдса на CD0 |
| 8 | ~~17,75~~ | ~~13~~ | ❌ R07a-V: **у резерв.** Після зриву стаціонарний RANS не збігається. Запуск 5 брати на α ≈ 10°, CL_max — з XFOIL |
| 9 | 20 | 8 | Опційно: диск гвинта (actuator disk) |
| 10 | — | — | Резерв |

Оцінка: ~300–600 CPU-год із 3000. α уточню після розрахунку поляри вихровою решіткою, щоб потрапити в потрібний CL.

---

## ❓ Відкриті питання

1. **Подовження крила ніколи не обирали.** Для метрики «час у повітрі» це величина першого порядку: на режимі витривалості індуктивний опір становить 65–75 % усього.
2. **Довжина фюзеляжу.** 900 мм вивели для старого крила 0,21 м² за правилом «плече = 3·САХ». Для 0,25 м² те саме правило дає ~1,0 м. На 900 мм плече лише ~0,46 м, тож хвіст росте до ~32 % площі крила проти 25 % у моделі опору.
3. **Кріплення крила.** Лонжерон проходить крізь батарею. Варіанти: середньоплан із розділеним пакетом або крило на сідлі. Не вирішено.
4. **Довжина батареї**: 422 мм (R05) проти ~350 мм (R06). Жодне не перевірено.
5. 🔴 **Режим макс. тривалості польоту стоїть біля зриву.** Потрібен CL ≈ 0,95 при CL_max 1,1–1,3, тобто запас лише V/Vs ≈ 1,1. Зі звичайним запасом 1,2–1,3·Vs швидкість виходить 77–83 км/год, а це мінус кілька хвилин.
6. **Гвинт не перераховано** для 0,25 м² / 5,9 кг / 380–420 kV. 11×14 обирали під скасований ривок 344 км/год.
7. **Закрилки**: R05-V(B) їх лишає (для кута заходу на посадку), у хабі вони не згадані.
8. **Маса**: 5,91 кг або 6,12 кг, якщо шасі 210 г іде зверху. Ніде явно не записано.
9. 🔴 **Витривалість поточної конфігурації** (0,25 м² + шасі + 583 Вт·год) **ніколи не рахувалась**. «125 хв» у хабі — це батарея 333 Вт·год. «143,6 км / 43,1 хв» — це 200 км/год на крилі 0,21 м².
10. Нотатки тримають CD0 сталим. На 72 км/год Cf приблизно на 20–25 % вищий, ніж на 200–250 км/год.
11. Потужність на 250 км/год ніхто не рахував. Оцінка агента: 1,3–1,6 кВт на валу. У мотор 1,5–2 кВт вписується, але впритул.

## 🔎 Для перевірки R07a-V

**Твердження без джерела** (агенти позначили самі):
- штраф маси крила ~1,1 кг/м²;
- склад CD0 0,0257;
- CL_max 1,1–1,3;
- приріст від щілинних закрилків +0,30…+0,45;
- опір обтічного шасі 0,8–1,2 Н;
- таблиці витривалості;
- злітна і посадкова дистанції 42 / 67 м;
- обдув від гвинта +9,2 %;
- «індуктивний = 75 %»;
- опір фюзеляжу 1,45 Н;
- «697 Вт на валу».

**Інше:**
- R04-Rumpfform досі каже «чекає адверсарної перевірки» і не має позначок поправок. Його числа дійсні лише в тому вигляді, як їх виправили в R04-Cruise-Payload і R05.
- R06 досі спирається на застарілі деталі: мотор 456 г, ESC YGE, 125 хв.

---

## 🔍 ПЕРЕВІРКА R07a-V (2026-09-24)

> Окремий прохід, 2 адверсарні аудитори. Перший звіряв специфікацію з R00–R06 і перераховував цілі. Другий незалежно міряв готовий STEP.

### ✅ Вистояло

- **Усі рядки таблиці «Зафіксоване».** Ø75/72,6; ожива 120 (ρ 210,75); S-крива 75→30 за 141 мм (14,07°); 0,25 м²; 11×14; колеса 60; стрічка 4×20. Застарілих параметрів у геометрію не потрапило.
- **Цілі, що збіглися в межах 1 %:**
  - потрібний CL: 0,945 на 72 км/год, 0,078 на 250 км/год;
  - числа Re; зрив 64 км/год;
  - проєктні 19,8 Н (CD0 0,0264 відновлено з R05-V(A));
  - 5,0 Н / L/D 11,5 на 72 км/год; 4,7 Н / L/D 12,3 на 87 км/год.
- **Коефіцієнти об'єму хвоста** V_H 0,49, V_V 0,035.
- **CAD виміряно незалежно:**
  - крило 0,2498 м² (−0,09 %), хорда 204,12, передня кромка на x = 304,00, c/4 = 355,00;
  - кут установки **+2,01° носом угору** (знак правильний), V 2,00°, t/c 8,77 %, задня кромка 0,400 мм;
  - фюзеляж збігся з формулами до 0,002 мм;
  - розріз по y = 0 дає одне валідне тіло з однією плоскою гранню.

### ❌ Не вистояло: поправки внесено вище, видимо

1. **Хвіст у еталоні: 2,2 → 2,7–2,8 Н.** У CAD хвіст займає 31,7 % S, а не 25 %.
2. **Шкала читання на 250 км/год переписана.** Стара сума 13,6–16,5 Н не відповідала власному розкладу, а CFD на 1g неминуче додає ≈1,5–2,5 Н.
3. **Запуск 1 на α 0° — це ≈4g, а не CD0.** 1g досягається при α ≈ −2,8°, нульова підйомна сила — при α ≈ −3,7°.
4. **Балансування.** Стабілізатор на 0° на 1g при 250 км/год тисне вниз з силою ≈ −30 Н, і лишається незбалансований момент ≈ +6 Н·м. Два варіанти: стабілізатор ≈ +1,5° або додати в еталон балансувальний опір (+0,4–0,5 Н).
5. **Ціль на 72 км/год** не враховувала CL-залежний опір і поправку Cf на Re. Очікувано 5,0–5,9 Н.
6. **Запуск 8 (після зриву)** — у резерв.
7. **Потужність на 250 км/год: ~~1,3–1,6~~ 1,1–1,6 кВт.**
8. **Шорсткість** додавати множником на тертя (×1,28–1,40), а не абсолютним CD0 з R04-V. Інакше misc врахується двічі.
9. **Повністю турбулентний розрахунок.** Після шліфування (k ≈ 8–13 мкм, Re_k ≈ 18) крило на 72 км/год буде значною мірою ламінарним. Обидва методи завищують тертя на ~30–50 %, тож **збіг CFD з ручним розрахунком ще не підтверджує витривалість**.

### ❌ Дефекти CAD (аудитор B)

| Дефект | Серйозність | Статус |
|---|---|---|
| Обтічники **не закривають колеса**: 38 % боків і 41 % протектора відкриті, бо еліптичний переріз центровано на 12 мм вище осі | major | ✅ **виправлено.** Обтічник 110 × 34 × 59 мм: переріз-суперeліпс (n = 4), паралельна середина над колесом, центр z = −137,5. Назовні 8,5 % об'єму колеса, тільки низ z −175…−164, тобто шина в прорізі |
| Задня кромка стійки **0,084 мм** (шар сітки колапсує) | major | ✅ **виправлено**: 0,4 мм. Найкоротше ребро моделі тепер 0,4 мм |
| Задні кромки хвоста 0,62–0,93 мм замість 0,4 | minor | ✅ **виправлено**: NACA із закритою кромкою + 0,4 мм у кожному перерізі (виміряно 0,45 мм на відстані 0,15 мм від кромки) |
| Шов обертання фюзеляжу на +y розрізає праві стики (ребра 0,31 мм) | minor | ✅ **виправлено**: шов уздовж черева на y = 0, його прибирає розріз півмоделі |
| Друк об'єму в `model1.py`: 6,69 л, насправді 7,04 л | minor | ✅ **виправлено**: точне інтегрування, 7,09 л (нові обтічники) |
| STL огранений (сегменти до 74 мм, похибка 1 мм) | major, якщо вантажити STL | ✅ неактуально: у SimScale завантажено STEP |

### 🚧 БЛОКЕРИ перед витратою запусків

Це рішення, а не розрахунки. Кожне змінює геометрію, тож запуски на поточній моделі довелося б повторювати.

1. **Подовження крила.** На 72 км/год індуктивний опір становить 68–71 % усього. AR 6 → 8 при S 0,25 дає опір 5,03 → ~4,2 Н (−17 %). Оцінка R05 «AR 6→8 = +1,5 %» стосувалась дальності на 200 км/год і для метрики «хвилини» недійсна.
2. **Довжина фюзеляжу / плече хвоста.** З фактичною станцією крила правило R04 дає ~1,05 м. Хвіст тоді зменшується до ~0,059 м² (−25 % опору хвоста), а змочена площа фюзеляжу росте на 16 %.
   Окремо: «900 мм» у нотатках означає два різні: загальну довжину (аеромодель) і довжину паперової труби (маса). З носом і конусом «труба 900» — це ~1,16 м.
3. **Профіль крила — ➕ нове питання, у R07a його пропущено.** MH 32 обирали під дальність на 200 км/год. Тепер робоча точка — CL 0,83–0,95 біля CL_max, де вирішують CL_max, α0, Cm0 і CL-залежний опір. Порівняти 3–4 кандидати у XFOIL при Re 2,5–3·10⁵.

Ще один блокер, **граничні умови для α поворотом вектора**, ✅ закрито налаштуванням у SimScale:
- вхід швидкості на Min X / Min Z / Max Z / Max Y з одним вектором;
- вихід тиску на Max X;
- симетрія на Min Y;
- напрямки підйомної сили й опору в контролі сил задаються окремо для кожного α.

**Не блокери:** Q3, Q4, Q6 (крім запуску 9), Q7–Q11.
**Q5 посилено.** Мінімум потужності для 0,25 м² лежить на 66–68 км/год, тобто при 1,03–1,07·Vs: витривалість обмежена зривом. Той самий дефект мають «118–126 хв» і «125 хв» у хабі.

---

## 🧪 ЗАПУСК 1: 250 км/год, 1g (2026-09-25)

> Рішення Віктора після R07a-V: **один запуск зараз**. Він перевіряє сам ручний метод опору (тертя + форма) на 250 км/год, і цей висновок переноситься на будь-яку майбутню геометрію. Поляру режиму тривалості польоту робимо лише після рішень щодо AR / довжини фюзеляжу / профілю.

### Налаштування в SimScale (проєкт «Model 1», запуск «V250 alpha -2.8 (1g)»)

| Що | Значення |
|---|---|
| Геометрія | виправлений `model1_cfd.step` (1 тіло, 32 грані, 60 ребер) |
| Домен | півмодель, x −5…12, y 0…5, z −5…5 м. Тіло літака видалено, лишився «Flow region» |
| Фізика | Incompressible, стаціонарна, k-ω SST, SIMPLE, 2 корекції неортогональності; ρ 1,225, ν 1,46·10⁻⁵ |
| Потік | α = −2,8°: U = (69,357; 0; −3,392) м/с на Min X / Min Z / Max Z / Max Y; вихід p = 0 на Max X; симетрія на Min Y. Вхідна турбулентність k 0,181, ω 1240 (I 0,5 %, ν_t/ν 10) |
| Початкові умови | такий самий U, k, ω; ініціалізація потенціальною течією |
| Коефіцієнти сил | підйомна сила (0,04885; 0; 0,99881), опір (0,99881; 0; −0,04885); \|U∞\| 69,44; L_ref 0,2041 м; **S_ref 0,125 м² (півмодель)**; моменти відносно (0,355; 0; 0); усі 20 граней літака |
| Ітерацій | 2000 (критерії нев'язки 1e-6, тож пройде всі) |

### Сітка: з третьої спроби

1. **Mesh 5 v1:** fineness 7, 18 шарів від 7 мкм, зона згущення 20 мм. Результат: 2,09 млн комірок, **лише 127 тис. призм**, ~750 комірок з неортогональністю > 88°, аспектне відношення до 7255. ❌ Автоматичний поверхневий розмір на літаку ~50 мм, тобто 4–5 комірок на хорду. Не запускали.
2. Попутно: після створення об'єму потоку в геометрії лишалося тіло літака без матеріалу, і SimScale не пускав далі. Тіло видалено операцією CAD.
3. **Mesh 5 v2 ✅:** додано поверхневе згущення **≤ 4 мм** (мін. 0,5 мм) на всі 20 граней літака, шари **12 від 10 мкм**. Результат: **3,90 млн комірок** (889 тис. призм, 772 тис. гекса, 2,06 млн тетра), **87** комірок > 88° (0,002 %). Очікуваний y+ ≈ 2 на крилі.

### Результат (завершено 2026-09-25 04:30: 248 хв, 33,1 CPU-год, 2000 ітерацій, «Run finished»)

> 💾 **Записано ДО перевірки.** Трактування попереднє, чекає окремого адверсарного проходу.

| Величина | CFD | Очікування (шкала R07a-V) |
|---|---|---|
| **CD** (на S 0,25) | **0,0334** | ≈ 0,021–0,023 |
| **Опір D** (q 2953,8 Па) | **≈ 24,7 Н** | 15,5–17 Н — метод підтверджено; 19,8 Н — проєктний |
| **CL** | **0,0597** → L ≈ 44,1 Н ≈ **0,76 g** | 0,078 (1 g) |
| **Cm** (відносно x 355) | **+0,0289** → ≈ +4,4 Н·м, **кабрування** | аудитор прогнозував ≈ +6 Н·м незбалансованого |
| Потужність на валу, D·V/0,85 | **≈ 2,0 кВт** | 1,1–1,6 кВт |

Числа знято з кривих графіка на ітерації 2000, похибка зчитування ±0,0003. Контроль: Cl(f) = CL/2 + Cm = 0,0588 ✓, Cl(r) = CL/2 − Cm = 0,0009 ✓.
**Густина на CD не впливає.** У нестисливому OpenFOAM тиск кінематичний, і ρ у коефіцієнтах скорочується. ρ 1,225 входить лише в переведення CD у ньютони.

### Якість розрахунку

- ✅ Сили пласкі з ~300-ї ітерації до 2000-ї. Нев'язки впали на 3–7 порядків і з ~500-ї стоять на плато: p ≈ 4·10⁻⁴, U 5·10⁻⁷…5·10⁻⁵, k ≈ 7·10⁻⁶, ω ≈ 1,6·10⁻⁷.
- ⚠️ SimScale увімкнув стабілізаційне змішування схем у **841** комірці.
- ⚠️ На **кожній ітерації** в кількох комірках обмежуються від'ємні k і ω (k до −0,009, ω до −53).
- ⚠️ Максимум k = 184 м²/с², тобто десь є зона сильної турбулентності (відрив за шасі чи дном?).
- ⚠️ Максимум тиску на гранях 3490 Па, Cp ≈ 1,18 > 1. Найімовірніше, локальний викид на загостреному коку (радіус 2 мм). Не перевірено.
- ⚠️ Лише **одна сітка** (збіжність за сіткою не перевірена), **немає розкладу опору по вузлах**, не виведено y+ і τ_w.

### Попереднє трактування (до перевірки)

1. ~~За шкалою R07a-V **24,7 Н ≥ 19,8 Н, тобто проєктний запас з'їдено**: ручний метод дає на 45–60 % менше, ніж CFD. Якщо це підтвердиться, на 250 км/год потрібно **~2,0 кВт на валу**, це верхня межа класу мотора 1,5–2 кВт.~~ ❌ **ВИПРАВЛЕНО в R07a-V2:** обидва висновки не підтримані, бо 24,7 Н значною мірою завищено сіткою. Найімовірніший опір **16,5–18,5 Н**, на валу ≈ **1,4–1,5 кВт**. Деталі нижче.
2. **Але** один розрахунок ще не розрізняє «ручний метод занижує» і «CFD завищує». Можливі причини завищення в CFD:
   - передня кромка крила: радіус 0,41 мм при мінімальній комірці 0,5 мм;
   - поверхневі комірки 4 мм;
   - 841 змішана комірка;
   - повністю турбулентний пристінний шар.
   Можливі причини заниження в ручному методі:
   - шасі як тупе тіло: фронтальна площа 47 см², більша за фюзеляжну;
   - пласкі законцівки;
   - стики;
   - балансування хвостом.
3. CL 0,060 замість 0,078: 1g досягається приблизно при α −2,55°. На опір це впливає менше ніж на 0,2 Н.
4. Знак Cm (кабрування на α −2,8°) збігся з прогнозом аудитора R07a-V.

### Рекомендований наступний крок

**Запуск 2**: та сама точка, але дрібніша сітка (крило й хвіст 2–3 мм, передня кромка ~0,3 мм) + **сили окремо по вузлах** (крило / фюзеляж / стабілізатор / кіль / шасі) + поля y+ і τ_w. Один запуск дасть і збіжність за сіткою, і розклад опору. Вартість: 1 симуляція з 9 решти, ~6–8 год, ~50 CPU-год. Рішення за Віктором.

---

## 🔍 ПЕРЕВІРКА R07a-V2: трактування запуску 1 (2026-09-25)

> Окремий прохід, 2 адверсарні аудитори, незалежно один від одного.
> **A** оцінював, наскільки CFD при цьому налаштуванні й цій сітці може помилятися.
> **B** склав опір по вузлах з першооснов і опублікованих даних саме для цієї CAD-геометрії.

### Головне: обидва дійшли одного висновку

| | Найімовірніший справжній опір моделі на 250 км/год (гладка, без гвинта, повністю турбулентна, як у CFD) |
|---|---|
| Аудитор A (CFD) | **18,5 Н** (15,5–22) |
| Аудитор B (збірка) | **16,5 Н** (14–20,5) |
| CFD, запуск 1 | 24,7 Н, найімовірніше **завищено на 3–8 Н сіткою** |

### ✅ Що в запуску 1 надійне

- **Налаштування правильне.** Граничні умови, α, вектори сил, S_ref півмоделі, рівень тиску: знакова помилка дала б 28,8 Н, блокування 0,04 %.
- **Підйомна сила й момент узгоджуються з теорією**: CL 0,057–0,080 і Cm +0,03…+0,05 проти CFD 0,060 / +0,029.
- **Навантаження хвоста.** Крило несе ≈ +70…+80 Н, стабілізатор тисне вниз ≈ −26…−40 Н. Мінімум Cp −1,82 — це пік NACA 0009 при α_t ≈ −3,8°. Це придатно для рішень щодо балансування й кутів установки.

### ❌ Що в запуску 1 ненадійне: сам опір

- **Призматичний шар замалий.** Загальна товщина 0,35 × 4 мм = 1,4 мм, ріст шарів 1,40 (норма ≤ 1,2). Шар вміщує лише 29 % пограншару на задній кромці крила, 45 % на стабілізаторі та 9–21 % на фюзеляжі. Решта пограншару лежить в 1–3 тетраедрах по 4–20 мм, а числова дифузія там діє як зайва в'язкість. Стрибок від останнього шару до тетраедра ×10…×25.
- Передня кромка описана 2–4 гранями (радіус 0,41 мм, комірка 0,5 мм). Поперек задніх кромок 0,4 мм ~1 комірка. Стійка шасі має ~5 комірок на бік.
- SST відомо **завищує кутові відриви** на стиках: хвіст на конусі, стійка з обтічником.
- Разом: **+3…+8 Н**. Сіткового етюду немає, тож це інженерна оцінка.

### ⚠️ Що ручний метод справді недооцінював

| Вузол | Ручна оцінка | R07a-V2 |
|---|---|---|
| **Шасі як побудоване** | 1,25–1,87 Н | **1,2–4,1 Н** (найімовірніше ~2,1). Обтічники **закороткі**: L/D 2,3, кут закриття 42° (≤ 15–20° потрібно), тож за ними відрив. Ще відкрита шина 22 × 8–11 мм. Фронтальна площа шасі 53 см², більша за фюзеляжну |
| Дно Ø30, тупі задні кромки, законцівки, стики | не враховано | +0,2…+1,5 Н |
| Індуктивний опір із балансуванням | 1,0–1,4 Н | ❌ завищено: **0,47–0,60 Н** (без урахування взаємного впливу крила й хвоста) |
| Фюзеляж під кутом | 0,3–0,4 Н | ❌ завищено ~10×: 0,02–0,1 Н |

### Наслідки для проєкту

- «Проєктний запас з'їдено» — **не встановлено**. «Ручний метод занижує на 45–60 %» — **не підтверджено**. Імовірніше, ручний метод **дещо занижує** (17–20 Н), переважно через шасі.
- **Проєктний CD0 0,0264 — реалістичний, а не консервативний.** Його «misc»-запас повністю йде на шорсткість, якщо поверхню не шліфувати: тертя ×1,28–1,40 дає 19,5–20,8 Н.
- **Потужність на 250 км/год:** ~~2,0 кВт~~ → **≈ 1,35–1,7 кВт на валу** (16,5–19,8 Н, η 0,80–0,85). У клас 1,5–2 кВт вписується.
- З природним переходом гладкий планер мав би ще на 1,5–4 Н менше. Жоден із розрахунків (ні CFD, ні ручний) цього не враховує.
- 🔧 **Незалежно від блокерів**: обтічники коліс переробити **до Model 2**. Потрібно L/D ≥ 3, закриття ≤ 15–20°, мінімальний проріз для шини.

### Що дасть відповідь

- **Крок 0, без витрати запусків, потрібна згода на завантаження файлів.** Завантажити поля розв'язку запуску 1 і в ParaView проінтегрувати тиск і тертя окремо по кожній із 20 граней. Якщо тертя крила, хвоста й фюзеляжу набагато більше за 11 Н, завищення дала сітка. Якщо на шасі ≥ 3 Н тиску, проблема в геометрії.
- **Крок 1, запуск 2:** та сама точка. Крило й хвіст ≤ 2 мм (передня кромка 0,1 мм), шасі ≤ 1 мм, фюзеляж ≤ 3 мм, пристінне згущення ≤ 2–3 мм у межах 15 мм від усіх граней. Шари: 15–20, від 5–10 мкм, ріст ≤ 1,2. Сили по групах із розкладом на тиск і тертя, плюс y+ і τ_w. ~7–10 млн комірок, 60–100 CPU-год.

---

## 📋 Статус етапу

- [x] Дослідження: 2 агенти, записано
- [x] CAD-модель (CadQuery → STEP), `CAD/model1.py`
- [x] Перевірка R07a-V: записано вище
- [x] SimScale: проєкт «Model 1», геометрія, півдомен, фізика, граничні умови, контроль сил, налаштування сітки
- [x] Виправлення дефектів CAD: перевірено вимірюванням
- [x] Повторне завантаження виправленого STEP у SimScale
- [x] Рішення Віктора: 1 запуск зараз (250 км/год, 1g), решта після рішень щодо блокерів
- [x] Сітка: v2, 3,9 млн комірок
- [x] Запуск 1 (V250, α −2,8°): **CD 0,0334 / D ≈ 24,7 Н / CL 0,060 / Cm +0,029**, записано
- [x] Перевірка трактування запуску 1 (R07a-V2): опір завищено сіткою, найімовірніше 16,5–18,5 Н; обтічники шасі переробити
- [ ] Крок 0 (поля запуску 1 → інтегрування по гранях) або запуск 2 (дрібна сітка + сили по вузлах): рішення Віктора
- [ ] Рішення за блокерами (AR, довжина фюзеляжу, профіль) → Model 2 → поляра режиму тривалості польоту
