NetHunter123/Jflyproject/_Archiv/R07b-Masa-Nutzlast.md

---
tags:
  - project
  - engineering
  - gungnear
etappe: R07b
status: 🔍 перевірено (R07b-V) — маса ≈5,07 кг, поправки внесено видимо
updated: 2026-09-25
---

# R07b — Маса, центрування, вільне місце, запас ваги. Без шасі

> ⚠️ **ДОСЛІДНИЦЬКИЙ прохід.** 2 агенти: (1) розміри, маса по компонентах, центр мас, внутрішні об'єми; (2) запас ваги, катапульта, запуск із руки, посадка на черево. Перша спроба впала на ліміті сесії, друга довела роботу до кінця. Жодна маса **не зважена**, усе розрахунок.
> **Рішення Віктора від 2026-09-25: шасі прибрано повністю.** Запуск із катапульти або з руки, посадка на черево. CAD: `CAD/model1b_nogear.step` (`python model1.py --no-gear`).

![[gungnear-r07b-model1b-nogear.png]]

---

## 1. Фізичні параметри (CAD model1b + нотатки)

| Параметр | Значення | Джерело |
|---|---|---|
| Довжина з коком | **898,5 мм** (номінально «корпус 900») | CAD |
| Розмах / хорда | **1224,7 / 204,1 мм**, прямокутне крило, AR 6 (припущення) | CAD, R07a |
| Площа крила | **0,25 м²** (поза фюзеляжем 0,235) | хаб, CAD |
| Профіль / товщина | MH 32, 8,7 %, макс. **17,75 мм** | CAD |
| Висота (черево → верх кіля) | **257,5 мм** | CAD |
| Труба | **Ø75,0 / Ø72,6 мм, стінка 1,2 мм** (Klima, паперова спіральна) | R05-V(B) |
| **Довжина паперової труби** | **639 мм** (x 120–759). Ніс 120 мм і конус 141 мм друковані. Klima: 500 + 139 мм із муфтою або 385 + 250 = 635 мм | CAD, R04-Rumpfform |
| Маса труби | **153 г** (а не 216 г: «216 г на 900 мм» — це вся довжина корпусу, а не труби) | перерахунок |
| Ніс / хвостовий конус | ожива L 120 (кок Ø57 × 60) / S-крива 75 → 30 за 141 мм, дно Ø30 | R04, R05 |
| Оперення | стабілізатор 470 × 118 (0,0555 м²), кіль 150/100 × 190 (0,0238 м²) | R07a |
| Фронтальна / змочена площа | 0,029 м² / **0,82 м²** | CAD |
| Об'єм зовнішній / внутрішній фюзеляжу | 6,81 л / **3,16 л** брутто | CAD |
| Пакет 12S3P | лягає лише як **6 шарів по 6 комірок** → 2 блоки 6S3P по ≈214 мм, разом ≈426 мм. Потрібно Ø69,7 мм у трубі 72,6 | даташит P45B |

⚠️ **ВИПРАВЛЕННЯ до записів:** «пакет ~350 мм» (R06) геометрично неможливий. 8 комірок у шарі не влазять.

---

## 2. Маса готового до польоту апарата (без шасі)

> ❌ **ВИПРАВЛЕНО в R07b-V:** ~~4,67 кг~~ → **≈5,07 кг (4,4–6,0)** для компонування з ESC у спинному обтічнику (L1c). Якщо ESC усередині (L1b) і з баластом, то **≈5,3–5,5 кг**. Поправки: мотор 12S +92 г, крило +120 г, джойнер +20 г, серви +48 г, оперення +18 г, муфта +16 г, силовий вузол катапульти +23 г, ESC +10 г, запас на першу збірку +50 г. Разом ≈+0,40 кг. 5,8 кг з нотаток — песимістичний край. Деталі в розділі R07b-V нижче.

### Поелементно (агент 1): ~~**4,67 кг (3,95–5,58)**~~, уже з запасом 100 г на неврахований приріст

| Група | г | Головне |
|---|---|---|
| Батарея: 36 × P45B + обв'язка + фіксація | **2634** | комірки 2484 г (≤ 70 г/шт за даташитом). R05 брав 2,85 кг за припущеної щільності 205 Вт·год/кг; поелементно ≈223 Вт·год/кг |
| Мотор + гвинт + кок + моторама + капот | 408 | мотор 288 г: реальний приклад Scorpion SII-4020-420KV. «≈230 г» у нотатках не має конкретної моделі |
| ESC 80 A HV + кожух + BEC + проводка + роз'єми + запобіжник | 281 | Castle Phoenix Edge HV80: 125 г із дротами |
| Фюзеляж: труба 639 мм + муфта + скло + конус + кільця + кріплення крила + люк | 340 | |
| **Крило** (пінопласт + скло/абаші, вуглецевий лонжерон) + джойнер | 380 | ≈1,32 кг/м², оцінка з матеріалів. **Найменш певна позиція** (270–425 г) |
| Серви 6 шт. + кріплення + тяги + подовжувачі | 176 | 2 елерони + 2 закрилки + руль висоти + руль напрямку |
| Оперення | 67 | |
| Авіоніка: приймач, контролер, GPS, датчик швидкості, HV-датчик | 75 | Matek H743-WING приймає ≤ 8S, тож на 12S живлення через BEC |
| Лижа + гак катапульти | 62 | |
| Покриття + клей + запас | 250 | |

**⚠️ Розбіжність із нотатками.** Нотатки кажуть 5,86–5,91 кг без шасі (6,12 кг із шасі), але поелементно цю масу ніхто не складав: 5,26 кг (R03) + 0,6 кг (Li-ion) + крило. Звідки різниця ≈1,2 кг:
1. **Планер.** R03/R04c рахували конструкцію моделлю 0,28·m + 3,0·S ≈ 2,2 кг, відкаліброваною на одному склопластиковому EDF-джеті. Поелементно виходить ≈1,1 кг.
2. **Батарея:** 2,61–2,63 кг проти 2,85.
3. Мотор: 288 г проти 485 г у R03.

Агент 2 рахував запас ваги від **5,80 кг** (старе число з нотаток). **Яка маса ближча до правди, вирішує перевірка R07b-V.**

---

## 3. Центрування

- **Ціль:** 25–28 % САХ = **x 355–361 мм** від носа.
- Джойнер крила на x 361 ділить пакет на 2 блоки: **136–350 і 372–586 мм**, між ними зазор 22 мм під гільзу Ø14.

| Компонування | ЦМ | Наслідок |
|---|---|---|
| R05 буквально (суцільний пакет 180–602) | 382 мм (38 %) | фізично неможливо: джойнер проходить крізь пакет |
| **Усе всередині, ESC за пакетом (L1b)** | **375 мм (35 %)** | **не центрується.** Потрібно **254 г баласту в коку** (≈5,0 кг разом). Посунути пакет не можна: спереду фаєрвол, ззаду джойнер |
| **ESC у невеликому спинному обтічнику над носом (L1c)** | **358 мм (26,6 %)** | ✅ **центрується без баласту.** Ціна: +0,1–0,3 Н на 250 км/год |
| Ніс довший на +100 мм (ESC усередині) | 344 мм | з'являється CG-нейтральний відсік 80 мм на x 321–401 |

**Нейтральна точка** (оцінка без VLM): ~~x ≈ 383–402 мм (38–48 % САХ). Запас стійкості на 358 мм ≈12–21 %. Пропоновані межі ЦМ: **345–370 мм**.~~

> ❌ **ВИПРАВЛЕНО в R07b-V:**
> - Нейтральна точка за VLM (крило + стабілізатор) з поправками на фюзеляж і гвинт: **≈376–394 мм, центр ≈385**. Межі ЦМ **345–365 мм**, перші польоти на 352–358 мм.
> - Баласт для L1b: ~~254 г у коку~~. Кок обертається, тож баласт іде за фаєрвол (x ≈ 128): **≈200 г до ЦМ 365** або ≈350–370 г до 358.
> - Висновок «L1c центрується без баласту» лишається: ЦМ ≈358 мм.

---

## 4. Вільне місце всередині

> **Труба майже повна.** Батарея займає 136–586 мм, мотор і капот ніс, ESC обтічник або корму.

| Відсік | x, мм | Корисний об'єм | Найбільший предмет | Вплив на ЦМ |
|---|---|---|---|---|
| **Кормовий відсік труби** | 631–777 | **≈0,45 л** | **циліндр Ø64 × 140 мм** (Ø68, якщо тяги пустити поза ним) | **+7 мм на 100 г.** Без перебалансування до ≈165 г, далі ≈1 г баласту в коку на кожен 1 г вантажу |
| Верхній канал над батареєю (центр) | 300–420 | 0,04 л | плаский брусок 36 × 10 × 120 мм | ≈0, **CG-нейтральний** |
| Верхній канал над батареєю (корма) | 420–586 | 0,06 л | брусок 36 × 10 × 160 мм | +1,3…+4,7 мм на 100 г |
| Нижній канал під батареєю | 136–586 | 0,12 л | брусок 30 × 8 × 400 мм | ≈0, але тут траса дротів і зона ударів при посадці |
| Зазор джойнера між блоками | 350–372 | 0,05 л | 22 × 50 × 22 мм над гільзою + 22 × 66 × 30 мм під нею | 0 (саме центр мас) |
| Передній зазор за моторамою | 120–136 | 0,04 л | диск Ø68 × 12 мм | −4,8 мм на 100 г (працює як баласт) |
| Хвостовий конус навколо стабілізатора | 777–895 | 0,12 л | напівконус Ø60 → Ø30 × 80 мм, висота ≤ 25 мм | +9…+11 мм на 100 г. Тільки легке: антена, маячок |
| Крило біля лонжерона (обидві консолі) | 314–447 | **0,3–0,6 л** | по брусу 45 × 12 × 350 мм у кожній консолі | ≈0. **Тільки якщо крило порожнисте**; у пінопластово-скляному це вирізання кесона |
| Капот навколо мотора | 1,5–120 | 0 | — | канал охолодження, під вантаж непридатний |

> ⚠️ **R07b-V:**
> - 0,45 л у кормі вільні **лише в L1c**. У L1b там стоять ESC і серви хвоста, тож лишається ≈0,2 л.
> - Без перебалансування в корму влазить ~~≈165 г~~ **≈100 г** (до ЦМ 365). Кожен наступний грам вимагає ≈1,5 г баласту за фаєрволом.
> - Зазор джойнера фактично зайнятий силовим вузлом. Контролер Matek (13 мм) не влазить у верхній канал висотою 10 мм. Верхній канал 300–586 мм разом ≈0,10 л. Конус ≈0,05–0,07 л корисно.
> - Муфта Klima (внутр. Ø70,2) заважає пакету, якщо стик труби припадає на зону пакета.
> - **Реально розмістити вантаж можна ≈0,2 кг без баласту, ≈0,45 кг максимум.** Обмежують об'єм і центрування, а не аеродинаміка.

**Висновок:**
- Великий компактний відсік лише один: **Ø64 × 140 мм у кормі (0,45 л)**. Він дорогий для центрування.
- CG-нейтрально влазять **лише плоскі речі**: верхній канал, зазор джойнера, кармани крила.
- Звільнити нейтральний відсік перестановкою батареї в корпусі 900 мм **не вийде**. Це можливо лише з подовженням носа на ≈100 мм.

---

## 5. Скільки ваги можна додати і що буде

> Таблицю агент 2 рахував **від 5,80 кг** (старе число). Масштабування: швидкість зриву й сходу з катапульти ∝ √m, енергія катапульти ∝ m², час у повітрі ∝ m^−1,5. Модель: CD0 без шасі 0,0243, AR 6, e 0,85, 80 % із 583 Вт·год, політ на 1,2·Vs.
>
> ❌ **ВИПРАВЛЕНО в R07b-V (блокер):** база 5,80 кг хибна. Правильна **≈5,07 кг**. До того ж:
> - ККД ланцюга 0,60 — верхній край, реально **0,56 (0,50–0,62)**;
> - CL_max MH 32 ≈ **1,0** (XFOIL з поправкою на 3D), а не 1,1;
> - «206 хв» за моделлю нотаток **хибні**: ланцюг 0,736 взято з режиму 200 км/год.
>
> Перевірені числа для **5,07 кг**:
> - зрив **65 км/год**;
> - схід **21,6 м/с** (мінімум ≈19,8), енергія 1,19 кДж;
> - **час у повітрі ≈155–160 хв (≈120–190)** на ≈78 км/год;
> - на 6,3 кг ≈116 хв, на 7,3 кг ≈94 хв;
> - час ∝ m^−1,41.
>
> Таблиця нижче лишається як песимістичний випадок для 5,8 кг. Її колонку «Час у повітрі» треба додатково зменшити на ≈10 %: 144 → 130 хв.

| Додано | Разом | кг/м² | Зрив (CL_max 1,0 / 1,1 / 1,2), км/год | Схід із катапульти, м/с | Енергія, Дж | Час у повітрі (реалістичний) | Посадка черевом, км/год |
|---|---|---|---|---|---|---|---|
| 0 | 5,8 | 23,2 | 69 / 66 / 63 | 23,1 | 1552 | **≈144 хв** (125–165) на 79 км/год | 73–79 (з закрилками 61–70) |
| +0,25 | 6,05 | 24,2 | 71 / 68 / 65 | 23,6 | 1688 | ≈136 хв | 74–81 |
| **+0,5** | 6,3 | 25,2 | 72 / 69 / 66 | 24,1 | 1831 | ≈128 хв (−11 %) | 76–83 |
| +1 | 6,8 | 27,2 | 75 / 72 / 69 | 25,0 | 2133 | ≈115 хв (−20 %) | 79–86 |
| **+1,5** | 7,3 | 29,2 | 78 / 74 / 71 | 26,0 | 2458 | ≈104 хв (−28 %) | 82–89 |
| +2 | 7,8 | 31,2 | 81 / 77 / 74 | 26,8 | 2806 | ≈95 хв | 84–92 |
| +3 | 8,8 | 35,2 | 86 / 82 / 78 | 28,5 | 3572 | ≈79 хв (−45 %) | 90–98 |

- **Максимальна швидкість майже не залежить від маси:** з +3 кг лише 250 → 249 км/год. Дальність на 200 км/год падає лише на −1,3 % за кожен кг.
- **Кожен +1 кг:** час у повітрі −20 %, зрив +8 %, енергія катапульти +37 %, згин крила +19 %.
- Агент 2 пропонує межі в **повній масі**: **м'яка ≈6,3 кг, жорстка ≈7,3 кг.** Обидві ставлять катапульта, посадка черевом і неперевірена конструкція (лонжерон не рахували, паперова труба вже біля межі стійкості за R05-V(B)), а не мотор.
- ~~Якщо правдою є 4,67 кг, то повна маса 6,3 / 7,3 кг означає **+1,6 / +2,6 кг вантажу**, а час у повітрі без вантажу був би помітно довшим. ⚠️ Вирішує R07b-V.~~ ✅ **R07b-V:** за масою 5,07 кг межі 6,3 / 7,3 кг дають **+1,2 / +2,2 кг**. Але всередині такий вантаж **не вміщається**: реально ≈0,2–0,45 кг (див. розділ 4). Більше можна лише з подовженням фюзеляжу або зовнішньою гондолою. Самі межі не перевірені: лонжерон і труба не пораховані.
- **Вантаж і центрування пов'язані:** 1 кг має лежати в межах ±40 мм від центру мас, 0,5 кг — у межах ±75 мм.
- «144 хв» — реалістична модель агента: ККД 0,60 і поправки опору. Модель нотаток (ККД 0,736) дає 206 хв. Числа хаба «143,6 км / 43,1 хв» пораховано на 100 % ємності батареї.

---

## 6. Без шасі: що це дає і що вимагає

### Що дає
- Маса −0,21 кг шасі, натомість +0,06…0,11 кг: лижа, гак, складаний гвинт.
- CD0 0,0264 → 0,0243.
- **Час у повітрі +9 %, дальність +8,6 %, −130 Вт на 250 км/год.** Саме без шасі 250 км/год досяжні з 1,5 кВт на валу.

### Катапульта: тільки вона
- Потрібний схід: **23,1 м/с** (1,2·Vs при CL_max 1,0), мінімум 20,2 м/с. Мінімум можна брати лише після вимірювання CL_max і з повним газом до спуску.
- Енергія 1,2–1,6 кДж, з візком ~2–2,5 кДж.
- Хід при 10 g: 2,7 м, сила 569 Н; при 15 g: 1,8 м і 853 Н. Рейка 3,5–4 м (пневматика) або 4,5–7 м (гума).
- **Верхній край ринку:** 24–25 м/с дають лише Embention C400P, Ukrspecsystems SCL-1A і ELI PL-80 (дані з пошукових зведень). Більшість малих катапульт дають 14–20 м/с. Реально — саморобна гумова або лебідкова.
- Штовхати треба через твердий вузол біля лонжерона (x ≈ 340–370). Батарею тримати упорами ≥ 300 Н. Черево вести ≥ 130 мм над рейкою, бо гвинт Ø279.

### ❌ Запуск із руки — нереальний
- Людина кидає ~6 кг на 7–10 м/с, це 0,4–0,55 від швидкості зриву.
- Щоб апарат вилетів, потрібна тяга ≥ 0,9 ваги. 11×14 на 1,5–2 кВт дає лише 0,55–0,87 ваги (дані APC теоретичні).
- Кидок став би можливим лише за навантаження на крило ≤ 10–12 кг/м² (≤ 3 кг на 0,25 м²; сама батарея важить 2,6 кг) або з тягою більшою за вагу. Але з таким гвинтом 250 км/год недосяжні.

### Посадка на черево

> ⏸ **ВІДКЛАДЕНО рішенням Віктора від 2026-09-25.** Мотор і гвинт лишаються стандартні: 1,5–2 кВт, ~380–420 kV, 12S, фіксований APC 11×14. Зламаний на посадці гвинт просто міняють, запас гвинтів є. Складаний гвинт, підбір мотора під нього й обмеження закрилків зараз **не розглядаємо**. Нижче лише довідкові результати дослідження.
> Для довідки (R07b-V): 400 kV × 12S з 11×14 під навантаженням дає 13,9–16,6 тис. об/хв, це в межах ліміту APC 11×14 (17 273 з R05).
- Торкання 73–79 км/год, із закрилками 61–70 км/год. Пробіг 30–70 м по траві.
- Лижа по всьому низу (x ≈ 120–830) з каблуком під друкованим конусом, 40–60 г.
- При звичайному вирівнюванні першим торкається **хвостовий конус** (x 759–816). Законцівка крила торкається вже при крені 5°.
- **Гвинт:** фіксований 11×14 б'ється в **~83 %** посадок. Тож **складаний гвинт обов'язковий**, але він не вписується в 12S із 400 kV:
  - RFM 10×16 і CAM 12×13 тримають ≤ 13 000 об/хв;
  - 400 kV на 12S дає ≈15–16 тис. об/хв;
  - отже потрібен менший kV (~300–330) або 10S. **Гвинт і мотор треба підбирати заново.**
- ⚠️ **Закрилки на 60° (R05) виходять на 11–20 мм нижче черева.** На торканні не більше 20–30°, або «кроу», або верхньоплан.
- Пакет 583 Вт·год без BMS щоразу торкається землі: піна 3–5 мм, упори, огляд комірок після жорсткої посадки.

---

## ❓ Відкриті питання

1. **Справжня маса: 4,67 чи 5,8 кг?** Зважити комірки й перший планер.
2. CL_max профілю MH 32. Від нього залежать швидкість сходу, катапульта й посадка.
3. ESC: у спинному обтічнику, з баластом усередині чи з подовженим носом?
4. Конструкція крила (пінопласт + скло чи формоване порожнисте) визначає масу 270–425 г і чи є в крилі вільний об'єм.
5. Складаний гвинт + мотор із меншим kV для 250 км/год.
6. Лонжерон і труба на катапульту (10–15 g) та посадку черевом не пораховані.
7. Закрилки: ≤ 20–30° на торканні, «кроу» чи верхньоплан?
8. Нейтральна точка лише оцінена. Уточнити VLM/XFLR5 або CFD.
9. Блокери R07a (подовження, довжина фюзеляжу, профіль) змінять і цю карту.

---

## 🔍 ПЕРЕВІРКА R07b-V (2026-09-25)

> Окремий прохід, 2 адверсарні аудитори.
> **A** перевіряв масу, центрування й об'єми: власний розрахунок мас, VLM, CAD.
> **B** перевіряв запас ваги, льотні характеристики, запуск і посадку: дані APC, поляри XFOIL, ринок катапульт.

### ✅ ПЕРЕВІРЕНІ ЧИСЛА (стандартний мотор і гвинт, без шасі)

| Величина | Значення |
|---|---|
| **Маса готового до польоту** | **≈5,07 кг (4,4–6,0)**, ESC у спинному обтічнику. Якщо ESC усередині з баластом, ≈5,3–5,5 кг |
| З неї батарея | 2,63 кг ✅ підтверджено |
| Мотор (12S, 1,5–2 кВт, ~400 kV) | ≈380 г (350–440). 288-грамовий Scorpion із дослідження розрахований лише на 6S |
| Крило з джойнером | ≈520 г (430–650). Реальні швидкі формовані крила важать 1,8–2,1 кг/м² |
| Навантаження на крило | ≈20 кг/м² |
| Центр мас (ESC в обтічнику) | ≈358 мм від носа = 26 % САХ ✅ |
| Нейтральна точка | ≈376–394 мм. **Межі ЦМ 345–365 мм** |
| Зрив (CL_max ≈1,0) | **≈65 км/год** |
| Схід із катапульти | **≈21,6 м/с** (мін. 19,8), 1,2 кДж. При 10 g: хід ≈2,4 м, сила ≈500 Н |
| Час у повітрі | **≈155–160 хв (≈120–190)** на ≈78 км/год, 80 % з 583 Вт·год |
| 250 км/год | ≈1,5 кВт на валу. Від маси майже не залежить |
| Виграш від прибирання шасі | ~~+9 %~~ → **+5…7 %** часу в повітрі |

### Скільки ваги ще можна додати

- **За масою:** м'яка межа ≈6,3 кг повної маси (+1,2 кг), жорстка ≈7,3 кг (+2,2 кг). Межі ставлять катапульта (схід ≤ 24–25 м/с), посадка й **неперевірена конструкція**: лонжерон і труба не пораховані.
- **За місцем і центруванням реально ≈0,2 кг без баласту, ≈0,45 кг максимум.** Труба заповнена. Корма (Ø64 × 140 мм) дорога для центрування: без баласту туди влазить ≈100 г, далі 1,5 г баласту на кожен 1 г.
- **Щоб возити 1–2 кг, потрібна зміна компонування:** довший фюзеляж або ніс (+100 мм дає CG-нейтральний відсік 80 мм), зовнішня гондола під центром мас або порожнисте крило (≈0,38 л).
- **Ціна кожного +1 кг:** час у повітрі **≈−22 %**, зрив +9 %, енергія катапульти +43 %, згин крила +20 %. Дальність на 200 км/год падає лише на −1,3 %, максимальна швидкість майже не змінюється.

### Інші поправки

- Ринок катапульт: ~~«лише C400P, SCL-1A, PL-80»~~ → 24–25 м/с дають також ELI PL-40 і PL-60 (PL-120 — 35 м/с, Robonic — до 70 м/с).
- Упори батареї: ~~≥300 Н~~ → **≥600 Н назад, ≥800 Н уперед**. При 15 g пакет дає 388–419 Н. Упори не повинні спиратися на джойнер.
- Запуск із руки: ✅ **неможливий** з повним пакетом за будь-якої маси з цього діапазону. Можливий лише в полегшеній версії 12S1P (≈2,9 кг).
- «8 комірок у шарі не влазять»: ~~неправда~~ для голих комірок (71,2 < 72,6), але практично нереально. Розкладка «кільцем» (Ø64,65) залишає місце для піни.

---

## 📋 Статус
- [x] Дослідження: 2 агенти, записано
- [x] Перевірка R07b-V: маса ≈5,07 кг, поправки внесено видимо
- ⏸ Посадка, складаний гвинт і закрилки відкладено рішенням Віктора від 2026-09-25
