NetHunter123/Jflyproject/_Archiv/R07d-8kg-160kmh.md

---
tags:
  - project
  - engineering
  - gungnear
etappe: R07d
status: 🔍 перевірено (R07d-V) — арифметика стоїть, модель оптимістична; V60 реально ≈28,5 кг; поправки внесено видимо
updated: 2026-09-25
---

# R07d — Що потрібно, щоб возити ~8 кг на ~160 км/год

> ⚠️ **ДОСЛІДНИЦЬКИЙ прохід** (порція 2, два агенти: (а) розрахунок, (б) правила й катапульти). Обидва **обірвав ліміт сесії** після того, як вони встигли порахувати й зберегти дані. Тут зведено їхні збережені результати: розрахунок `r07d/final.py` + `sens.py`, правила `r07d_rules/progress.md`. Фінального тексту агенти не написали. **Жодне число не перевірене — перевірка R07d-V окремо.**
> **Завдання Віктора від 2026-09-25:** вантаж ~8 кг щільний (~1–1,5 кг/л → 5,3–8 л), крейсер ~160 км/год, три варіанти: **V30** ≈30 хв / 80 км, **V60** ≈60 хв / 160 км, **V90** ≥90 хв / 240 км. Старт — катапульта, без шасі, посадку не розглядаємо.

> [!note] 🎯 РАМКИ (рішення Віктора 2026-09-26)
> **Посадку** (шасі, парашут, лижа, навантаження при посадці) і **правила польотів** (межа 25 кг, VLOS, клуби, дозволи, Remote ID) Віктор продумує сам. У розробці їх **не враховуємо й варіанти ними не обмежуємо**. Правила нижче лишаються лише як довідка; рядки з парашутом закреслено.

## Коротко

- **Це новий планер, а не подовжений light+.** 8 кг вантажу — це більше, ніж увесь light (5,07 кг).
> 🔍 **Після перевірки R07d-V** (деталі — внизу): арифметика відтворюється до сотих, але модель **систематично оптимістична**: пак важчий (×1,12 замість ×1,07), обшивка гондоли в масі взята тонша, ніж у розрахунку міцності, немає гака, Remote ID, вогнів, системи посадки. «Реалістичний мінімум» нижче вже включає ці поправки.

- **V30 реальний:** ~~≈18 кг~~ **≈19,6 кг** злітної маси (з конструкцією ×1,35 — 22,7; ~~з парашутом — 21,8~~ — посадка поза рамками), крило ≈0,6 м² (розмах 2,2 м), мотор класу 2–4,5 кВт, батарея ≈1 кВт·год. **Під 25 кг у будь-якому варіанті.**
- ~~**V60 на межі:** ≈25–26 кг — **трохи понад 25 кг**~~ ❌ ВИПРАВЛЕНО R07d-V: **V60 на 160 км/год — ≈28,5 кг, на 3,5 кг понад межу 25 кг** відкритої категорії ЄС (межа — строго менше 25). Під 25 кг заходить лише **на 130 км/год** (20,6–24,0 кг — залежно від того, що фіксоване: час чи дальність) або **з двома напівтвердотільними паками Tattu** (24,3–25,1 кг, ≈€2 900 — впритул).
- **V90 на Li-ion 21700 недосяжний:** ~~≈40 кг~~ **≈46,6 кг** реалістично, батарея 23+ кг. З напівтвердотільною ~~≈28 кг~~ **29,8–30,8 кг** (3 паки). ❌ ВИПРАВЛЕНО: **єдиний шлях під 25 кг — 2 паки Tattu 33 А·год на 130 км/год** (24,3–25,1 кг, 243–250 км).
- **Дальність 80–240 км — лише колами в межах видимості** (≈1,1–1,6 км від пілота). Політ «з точки А в точку Б» — це BVLOS, потрібна специфічна категорія (SORA 2.5 або PDRA, дозвіл RP Stuttgart, Remote ID).
- **Потрібна професійна катапульта:** ≈6–8 кДж, схід ≈24 м/с для 18–26 кг. Це клас ELI PL-40/60 (офіційна межа виробника **25 м/с**), а не аматорська резинка.

---

## 1. Основні припущення розрахунку (а)

| Параметр | Значення | Статус |
|---|---|---|
| Компонування | гондола Ø150 мм (композит, 1,2 кг/м²) + карбонова хвостова балка Ø35 × 1,5 | припущення. ❌ R07d-V: 1,2 кг/м² — це ≈0,75 мм ламінату, а міцність рахували для 1,2 мм (≈1,9 кг/м²) |
| Крило | навантаження **30 кг/м²**, AR 8, звуження 0,6, t/c 10 %, e 0,78 | вибір (свіп нижче) |
| CL_max | 1,0 чисте / 1,2 із закрилками | як у R07b-V, не виміряно |
| Оперення | V_H 0,50, V_V 0,035, плече 3,2 САХ | |
| Батарея | **Molicel P50B 21700**: 17,5 Вт·год (мін.; типово 18,0), 70–71 г, ~~257~~ 250–260 Вт·год/кг комірка; ~~+7 %~~ ❌ R07d-V: **+9–12 % на збірку** (серійні 12S P50B-паки DanEnergy — ×1,09–1,11); 12S·nP | [datasheet](https://www.molicel.com/wp-content/uploads/Product-Data-Sheet-of-INR-21700-P50B-80122.pdf), [DanEnergy 12S6P](https://www.danenergy.com/catalog/lithium-ion-battery-packs/li-ion-drone-battery-30000mah-43-2v-150a-12s6p-p50b) |
| Використання енергії | 80 % номіналу + **10 % резерв часу** + 15 Вт·год на набір висоти | як у light |
| Мотор | **T-Motor AT7215 KV220**: 565 г, 4,5 кВт (180 с), пік 100 А, 24 мОм, Io ~~2,0~~ **2,4 А** @10 В (R07d-V), $219. ⚠️ R07d-V: **V90 у скрипті насправді рахувався з KV245** (пік 110 А, радять 8–10S) — у нотатці цього не було | [T-Motor](https://store.tmotor.com/product/at7215-fixed-wing-motor.html) |
| Гвинт | APC 16×16 (дані PER3) | [APC](https://www.apcprop.com/files/PER3_16x16.dat) |
| Конструкція | перевантаження 6g × 1,5; полиці лонжерона 500 МПа, джойнер 900 МПа | |
| Опір | розклад Cf / форм-фактори, калібрований на CD0 light 0,0246 (K_misc 1,467) | |
| Візок катапульти | 3 кг | припущення |

## 2. Три варіанти (батарея — ціле число паралелей)

| | **V30** | **V60** | **V90** |
|---|---|---|---|
| Злітна маса (модель) | 18,5 кг (17,97 неперервно) | 25,9 кг (25,3) | 40,8 кг (39,9) |
| **🔍 Злітна маса — реалістичний мінімум (R07d-V)** | **19,6 кг** (5P) | **28,5 кг** (13P) | **46,6 кг** (29P) |
| … з конструкцією ×1,35 (як у реальних БПЛА 15–28 кг) | 22,7 кг (6P) | 33,5 кг (15P) | 57,7 кг (35P) |
| ~~… з парашутом 1 кг (до реалістичного мінімуму)~~ — поза рамками (посадку Віктор вирішує сам) | ~~21,8 кг~~ | ~~30,8 кг~~ | ~~50,0 кг~~ |
| Порожній (без вантажу) | 10,5 кг | 17,9 кг | 32,8 кг |
| Конструкція (частка) | 4,16 кг (23 %) | 5,29 кг (20 %) | 7,63 кг (19 %) — ⚠️ R07d-V: це **нижня межа**; у Penguin BE / Mugin-3 планер + привід = 45–52 % MTOW (вони міцніші й мають шасі) |
| **Батарея** | **12S5P, 1 050 Вт·год, 4,5 кг** | **12S12P, 2 520 Вт·год, 10,8 кг** | **12S26P, 5 460 Вт·год, 23,4 кг** |
| Крило S / розмах / хорда корінь–кінець | **0,62 м² / 2,22 м** / 347–208 мм | 0,86 м² / 2,63 м / 411–246 | 1,36 м² / 3,30 м / 516–309 |
| Гондола Ø × довжина / загальна довжина | 150 × 1 290 / 1 590 мм | 150 × 1 480 / 1 880 | 150 × 1 860 / 2 380 |
| Відсік вантажу | 630 мм (≈10 л з урахуванням заповнення 80 %) | 630 мм | 630 мм |
| Стабілізатор / кіль | 0,096 м² (660 × 146) / 0,053 м² | 0,135 / 0,074 | 0,213 / 0,117 |
| **Опір на 160 км/год / L/D** | **21,0 Н / 8,6** | 27,8 Н / 9,1 | 41,0 Н / 9,8 |
| На валу / з батареї | **1,13 / 1,38 кВт** | 1,49 / 1,77 кВт | 2,22 / 2,60 кВт |
| Струм (≈42 В) / оберти | 31,6 А / 7 060 | 40,7 А / 7 435 | 60 А / 8 110 |
| **Час / дальність на 160** (з резервом 10 %) | **32,7 хв / 87 км** | **61,8 хв / 165 км** | **91,2 хв / 243 км** |
| Без резерву | 36 хв / 96 км | 68 хв / 181 км | 100 хв / 268 км |
| Найдовший політ | 85 хв на 95 км/год | 154 хв | 216 хв |
| Максимум | ≈200 км/год (2,0 кВт) | ≈194 | ≈198 |
| Зрив чисте / з закрилками | 79 / 72 км/год | те саме | те саме |
| **Схід 1,2·Vs (закрилки) / 1,1·Vs (чисте)** | **24,0 / 24,1 м/с** | 24,0 / 24,1 | 24,0 / 24,1 |
| Енергія катапульти (з візком 3 кг) | **6,2 кДж** | 8,3 кДж | 12,6 кДж |
| Катапульта 8 g / 10 g | 3,7 м, 1,7 кН / 2,9 м, 2,1 кН | 3,7 м, 2,3 кН / 2,9 м, 2,8 кН | 3,7 м, 3,4 кН / 2,9 м, 4,3 кН |
| T/W на старті (повний газ) | 0,41 | 0,32 | ~~0,26~~ **0,22** (KV220, R07d-V) |
| Набір висоти (повний газ) | 8,7 м/с | 6,5 м/с | ~~5,0~~ **3,8 м/с** (KV220) |
| Струм на старті / пік мотора | 82 / 100 А | 88 / 100 А (запас 12 %) | ~~119 А (KV245 — понад пік 110)~~ **91 А** з KV220, Vmax ~~198~~ **179 км/год** |
| Згин у корені крила (граничний) | 368 Н·м, лонжерон 29,5 мм, полиці 25 мм² | 611 Н·м, 35 мм² | 1 208 Н·м, 55 мм² |
| Джойнер (суцільний карбон) | Ø16 × 530 мм | Ø19 × 620 мм | Ø24 × 750 мм |
| **< 25 кг (відкрита категорія)?** | ✅ так (з усіма поправками ≤ 22,7) | ❌ ~~на 0,3–0,9 кг більше~~ **на ≈3,5 кг більше** (R07d-V) | ❌ на ~~15~~ ≈22 кг більше |

> 🔍 **R07d-V, що стоїть без змін:** CL 0,243, опір і L/D на 160, час і дальність (32,7 / 61,8 / 91,2 хв; 87 / 165 / 243 км), схід 24,0 / 24,1 м/с, енергія катапульти 6,2 / 8,3 / 12,6 кДж, згин 368 / 611 / 1 208 Н·м, джойнер Ø16 / 19 / 24. ККД APC 16×16 за даними PER3 — 0,83–0,84, але вимірювання UIUC зазвичай на 5–10 % нижчі. CD0 вести діапазоном ×1,0–1,25 (конус гондоли 13,5°, обдув гвинтом, шви кришки не враховані).
> **CL_max 1,0 / 1,2 — консервативно:** у Penguin B/BE 1,3 / 1,7. При 1,3 / 1,6 схід ≈21 м/с замість 24, енергія катапульти −25 %.

**Стандартного мотора Gungnear (1,5–2 кВт, APC 11×14) не вистачає:** на старті потрібно 2,3–4,4 кВт і гвинт ≈16" для тяги 74–104 Н.

## 3. Чутливість (неперервна батарея, злітна маса V30 / V60 / V90, кг)

| Зміна | V30 | V60 | V90 |
|---|---|---|---|
| **Базовий** | 18,0 | 25,3 | 39,9 |
| Вантаж 6 кг | 14,9 | 21,2 | 33,6 |
| Вантаж 10 кг | 21,1 | 29,5 | 46,4 |
| **Крейсер 130 км/год** (той самий час) | **16,1** (65 км) | **19,7** (130 км) | **24,8** (195 км) |
| ➕ R07d-V: 130 км/год, **та сама дальність** 80 / 160 / 240 км (цілі паралелі) | 17,4 | **22,7** (реально 24,0) | **31,2** |
| ➕ R07d-V: 130 км/год, той самий час, цілі паралелі, KV220 | — | 20,6 (141 км) | 25,9 (203 км) |
| Вантаж 5,3 л (1,5 кг/л) | 17,8 | 24,9 | 39,0 |
| **Напівтвердотільна батарея 313 Вт·год/кг** ([Tattu 12S 33 Аг, €1 441](https://gensace.de/products/tarbg3533k12s10x)) — неперервна маса | ~~16,5~~ | ~~21,0~~ | ~~28,0~~ |
| ❌ R07d-V: те саме **цілими паками** по 33 А·год (зараз немає в наявності) | 18,7 (1 пак; 4,5C на старті при 3C тривало — не проходить) | **24,3–25,1** (2 паки, ≈€2 900) | **29,8–30,8** (3 паки) |
| Конструкція ×0,85 / ×1,35 | 17,2 / 20,1 | 24,0 / 28,9 | 37,1 / 48,2 |
| Опір +15 % | 18,7 | 28,1 | 51,9 |
| Гвинт −5 % | 18,3 | 26,3 | 43,6 |
| Без резерву 10 % | 17,5 | 23,7 | 34,7 |
| Крило 26 кг/м² (схід 22,4 м/с) | 18,8 | 27,9 | 49,9 |
| Крило 34 кг/м² (схід 25,6 м/с) | 17,4 | 23,7 | 35,0 |
| Крило 40 кг/м² (схід 27,7 м/с) | 16,8 | 22,2 | 31,0 |
| AR 6 / AR 10 | 17,9 / 18,1 | 25,3 / 25,6 | 40,1 / 40,7 |

**Максимальний вантаж у 25 кг:** V30 — ~~12 кг (обидві батареї)~~ ❌ **12,5 кг (P50B) / 13,9 кг (напівтвердотільна)** (12 було упором пошуку, R07d-V); V60 — 7,8 кг (P50B) / 10,3 кг (напівтвердотільна); V90 — 3,2 / 6,7 кг. (Усе — за моделлю, без реалістичних поправок.)

**V90 під 25 кг** — ~~лише так: напівтвердотільна + крило 45 кг/м² (22,9 кг, але схід 29,4 м/с, поза ринком легких катапульт); або напівтвердотільна на 130 км/год (20,7 кг).~~ ❌ ВИПРАВЛЕНО R07d-V (цілі паки): **єдиний шлях — 2 паки Tattu 33 А·год на 130 км/год: 24,3–25,1 кг, дальність 243–250 км.** З P50B на 130 км/год — 25,9–31,2 кг.

**Висновки чутливості:**
- Найсильніше важелі — **швидкість** і **батарея**. 130 замість 160 км/год знімає з V90 ~~15 кг~~ **10 кг при тій самій дальності** (15 — при тому самому часі, але тоді дальність падає до 195 км; R07d-V). З V60 — 3,6 кг (та сама дальність).
- Подовження AR 6–10 майже не впливає.
- Опір +15 % для V90 додає 12 кг: система на межі збіжності, кожна помилка в опорі множиться.

## 4. Конструкція — перші оцінки

- **Гондола з вирізом відсіку**, граничні моменти на рамах крила: V30 — 170–250 Н·м, V60 — 300–420 Н·м, V90 — 630–870 Н·м.
  - Напруження з вирізом (оболонка композитна, Ø150, t = 1,2 мм): V30 — до 28,5 МПа; V60 — до 49 МПа; V90 — до 100 МПа, і там потрібні стрічки-лонжерони 30–34 мм².
  - ❌ R07d-V: якщо оболонка справді 0,75 мм (як у масі), напруження **×1,6** (V60 до ≈78 МПа на кромці вирізу). У V90 на задній рамі крила потрібно **≈564 мм² стрічок, а не 0** (баг пошуку) — більше за саму оболонку, тобто потрібна товстіша оболонка або кіль.
- **Кручення:** відкритий відсік без силової кришки втрачає жорсткість ~~у ~16 000 разів~~ (R07d-V: 16 226 — теоретична межа для нескінченного профілю; реальний відсік 630 мм між рамами втрачає **в рази–десятки разів**). **Кришка відсіку має бути силовою** — висновок стоїть.
- ➕ R07d-V: поздовжні 8–10 g катапульти на кріплення вантажу (8 кг → 785 Н) і батареї (V60 ≈1,06 кН) не розраховано.
- Матеріал гондоли — **[[R07e-Rumpf-Material]] (перевірено):** лише композитна гондола. Труби KG/HT DN160 міцні, але додають ≈2–4,6 кг злітної маси — годяться лише як **оправка** для викладки або наземний макет. Для V60 склопластик зі звичайної тканини 0/90 товщиною 0,73 мм **не проходить** (MS −0,20) — потрібен карбон, квазіізотропний склопластик або сендвіч.

## 5. Правила ЄС і Німеччини (б)

> Джерела — первинні: EUR-Lex (ЄС 2019/947, 2019/945), gesetze-im-internet.de (LuftVO, LuftVG, LuftVZO, LuftKostV), LBA, RP Baden-Württemberg, DMFV, EASA. Не юридична консультація.

### Відкрита категорія (без клубу)

| Поріг / умова | Вимога | Джерело |
|---|---|---|
| Саморобний апарат, **< 25 кг** | лише підкатегорія **A3**: ≥150 м від житлових, комерційних, промислових і рекреаційних зон; місце без сторонніх людей | [ЄС 2019/947 Art. 4, UAS.OPEN.040](https://eur-lex.europa.eu/legal-content/EN/TXT/HTML/?uri=CELEX:02019R0947-20250501) |
| A2 | тільки для класу C2 — саморобному недоступна | там само, UAS.OPEN.030 |
| Висота | ≤ 120 м | Art. 4(1)(e) |
| **Видимість (VLOS)** | безперервний прямий візуальний контакт; спостерігач лише **поруч** із пілотом | Art. 4(1)(d), Art. 2 |
| Швидкість | **обмеження в A3 немає** (19 м/с — лише для саморобних < 250 г в A1 і класів C0/C1) | UAS.OPEN.020; [2019/945](https://eur-lex.europa.eu/legal-content/EN/TXT/HTML/?uri=CELEX:32019R0945) |
| Вантаж | **заборонено скидати будь-що і возити небезпечні вантажі** | Art. 4(1)(f); [LuftVO §13](https://www.gesetze-im-internet.de/luftvo_2015/__13.html) |
| Реєстрація оператора | LBA онлайн, 20 € (через клуб — 5 €); потрібні дані страховки і скан Personalausweis або паспорта. ❌ R07d-V: **e-ID не потрібна** | [LBA](https://www.lba.de/DE/Drohnen/UAS_Betreiberregistrierung/UAS_Betreiberregistrierung_node.html), LuftKostV |
| Кваліфікація | EU-Kompetenznachweis A1/A3: онлайн-курс + тест 40 питань, ≥75 %, 25 €, 5 років | [LBA](https://www.lba.de/DE/Drohnen/Fernpiloten/Kompetenznachweis_A1_A3.html) |
| Страховка | **обов'язкова** (LuftVG §43), мінімум 750 000 SDR | [§43](https://www.gesetze-im-internet.de/luftvg/__43.html), [LuftVZO §102](https://www.gesetze-im-internet.de/luftvzo/__102.html) |
| > 25 кг або BVLOS | **специфічна категорія** | Art. 5 |
| Нічні польоти | дозволені із зеленим проблисковим вогнем | UAS.OPEN.060(2)(g) |
| Геозони | 1,5 км від аеродромів (зі згодою), 1 км + коридори 5 км від аеропортів (лише специфічна), ~~100 м від доріг / залізниць / водних шляхів~~ ❌ R07d-V: **100 м лише від федеральних трас (автобани), федеральних водних шляхів і залізниць**, з винятками; заповідники, житлові ділянки тощо | [LuftVO §21h](https://www.gesetze-im-internet.de/luftvo_2015/__21h.html) |

### Дальність 80–240 км і видимість — чесно

- EASA рахує межу видимості для літака як **490 × розмах + 30 м** (і не більше 0,3 × видимості). Для розмаху 2,2 м це ≈1,1 км, для 3,3 м ≈1,6 км. [EASA VLOS Guidelines, Issue 3, 2025](https://www.easa.europa.eu/en/downloads/139435/en)
- Отже, **80–240 км можна пролетіти лише колами в радіусі ~1–1,5 км**. Як «відстань маршруту» ці кілометри в межах відкритої категорії й клубу не використати.
- Політ за межі видимості — це **BVLOS → специфічна категорія**. STS-01/02 вимагають класів C5/C6, тож для саморобного не підходять. Лишається **операційний дозвіл за SORA 2.5** від **RP Stuttgart** (для мешканців BW):
  - 4–16 тижнів;
  - ≈250–600 € (за LuftKostV 200–2 000 €);
  - потрібні Operations Manual і оцінка ризиків;
  - сам RP називає це «sehr aufwendig». [RP BW](https://rp.baden-wuerttemberg.de/themen/verkehr/luft/seiten/drohnen/), [LuftVO §21b](https://www.gesetze-im-internet.de/luftvo_2015/__21b.html)
  - ➕ R07d-V: замість повної SORA можна взяти **PDRA** — готову оцінку ризику EASA (напр. G01: BVLOS зі спостерігачами за простором над малонаселеною місцевістю; розмір ≤ 3 м, < 150 м). У специфічній категорії обов'язкові **Remote ID і зелений проблисковий вогонь** (UAS.SPEC.050(1)(l)). [EASA PDRA](https://www.easa.europa.eu/en/domains/drones-air-mobility/operating-drone/specific-category-civil-drones/predefined-risk-assessment-pdra)
  - Формула EASA 490 × габарит + 30 м — рекомендація («may be used»), а не юридична межа.

### Клуб (DMFV / DAeC-MFSD, Art. 16) — реальний шлях для моделі

| Маса | Що потрібно | Джерело |
|---|---|---|
| > 2 кг | Kenntnisnachweis (навчання в асоціації) до першого польоту, 5 років | [LuftVO §21f(2)](https://www.gesetze-im-internet.de/luftvo_2015/__21f.html) |
| **до 12 кг** | без окремого дозволу («grüne Wiese bis 12 kg») | [DMFV Leitfaden 01/2025](https://www.dmfv.aero/wp-content/uploads/2022/07/DMFV-Broschuere-Leitfaden-123.pdf) |
| **12–25 кг** | **Aufstiegserlaubnis** Landesluftfahrtbehörde (RP Stuttgart) для конкретного поля, 30–3 500 €. ➕ R07d-V: якщо поле клубу **вже має дозвіл «bis 25 kg»**, член клубу літає за дозволом поля — власний може бути не потрібен | §21f(3)–(4), LuftKostV |
| **> 25 кг** (до 150) | + **Einzelstückprüfung** (будівельна перевірка + льотні випробування) через DMFV за §31c LuftVG + посвідчення пілота великих моделей | [DMFV Zulassung](https://www.dmfv.aero/der-verband/spezialthemen/zulassung/), [LBA FAQ](https://www.lba.de/DE/Drohnen/FAQ/04_FAQ_Modellflug/FAQ_node.html) |
| Завжди | VLOS; **без комерційного використання**; без повністю автономних функцій (пілот мусить могти втрутитись; RTH / гіро дозволені); ≥150 м від житла для > 2 кг | DMFV Leitfaden |
| ~~Страховка DMFV~~ **Членство DMFV (страховка входить)** | ~~Basis 42 €/рік (до 25 кг на полі), Komfort 56 € (до 150 кг)~~ ❌ R07d-V: це **членські внески 2026**: Basis 42 / Komfort 56,36 / Premium 59,44 / Premium Gold 66,62 €; **з 01.01.2027 — 54 / 68,36 / 71,44 / 78,62 €**. Basis поза полями покриває лише моделі **до 1 кг** → light / light+ на «grüne Wiese» потребують Komfort або вище. Внески місцевого клубу — окремо | [DMFV Mitglied](https://www.dmfv.aero/der-verband/mitglied-werden/), [DMFV Versicherung](https://www.dmfv.aero/rund-ums-fliegen/versicherung/) |

- Поза клубом старий дозвіл «> 5 кг» більше не діє: з 2021 для саморобних до 25 кг — A3. У клубі межа без дозволу зросла з 5 до 12 кг. [DMFV 2021](https://www.dmfv.aero/spezialthemen/internationales/eu-regulierung/neues-luftrecht-auswirkungen-auf-den-modellflug/)
- **Що це означає:**
  - light (5 кг) і light+ (7,75 кг) вільно літають у клубі або в A3;
  - V30 (18 кг) — лише в клубі з Aufstiegserlaubnis для поля або в A3 далеко від житла;
  - V60 / V90 (> 25 кг) — специфічна категорія або клубна Einzelstückprüfung;
  - **перевезення вантажу для когось** — це вже не модельний спорт, а комерційна експлуатація БПЛА: клуб не підходить.

## 6. Ринок катапульт

| Катапульта | Макс. маса | Схід | Рейка | Ціна | Джерело |
|---|---|---|---|---|---|
| **ELI PL-40** (пневмо, EE) | 30 кг | 10 кг — 26,1; 15 кг — 26,1; **20 кг — 23,4**; 30 кг — 19,1 м/с | 5 м | не опубл. | [eli.ee](https://eli.ee/products/catapults/pl40/) |
| **ELI PL-60** | 60 кг | **20 кг — 26,0; 30 кг — 25,0**; 40 кг — 22,7 | 7,5 м | не опубл. | [eli.ee](https://eli.ee/products/catapults/pl60/) |
| ELI PL-80 | 100 кг | 25 кг — 26,6; 50 кг — 25,1 | 8,7 м | не опубл. | [eli.ee](https://eli.ee/products/catapults/pl80/) |
| UAV Factory / Edge Autonomy (пневмо) | 60 кг | до 26 м/с, 11–16 кДж | 4 / 6 м | не опубл. | [2021](https://www.letera.lv/en/biedruzina/uav-factory-releases-upgraded-portable-pneumatic-catapult-system/) |
| Naja H-10A (пневмо) | 6–10 кг | 6 кг — 25; 10 кг — 19 м/с | | $9 400 | [Austars](https://www.austars-model.com/naja-h10a-uav-catapult-launcher-pneumatic-for-610kg-weight-max-2519ms-system-wcustomized-cradle_g27235.html) |
| Naja H-50A (пневмо) | 50 кг | до 28 м/с | | $49 000 | там само |
| TACA-6M (пневмо) | 30–80 кг | 20–35 м/с | 6–10 м | $79 000 | [Austars](https://www.austars-model.com/uav-catapult-610m-launcher-pneumatic-version-max-41ms-for-30100kg-weight-drone-wcustomised-shuttle-base_g24975.html) |
| Ukrspecsystems GLS-1A (пневмо) | 40 кг | 17 м/с на 40 кг, макс. 20 | | | [ukrspecsystems](https://ukrspecsystems.com/uascomponents/pneumatic-uav-launching-system-gls-1a) |
| Ukrspecsystems SCL-1A / SCL-2 (резина) | 12 / 13,5 кг | макс. 18 м/с (у 2020 SCL-1A заявляли **10 кг на 25 м/с**) | ~~4,5 / 3,2 м~~ габарит установки 4,53 / 3,17 м | | [ukrspecsystems](https://ukrspecsystems.com/uascomponents/bungee-uav-launching-system-scl-1a), [UAS Vision 2020](https://www.uasvision.com/2020/11/20/new-bungee-catapult-launcher-from-ukraine/) |
| Robonic MC0315L (пневмо) | 40 кг | 15 м/с на 30 кг | ~~3,5 м~~ габарит 3,5 м | | [Robonic](https://www.robonic.fi/wp-content/uploads/2016/05/MC0315L_brochure_A4.pdf) |
| Skyeye SKE20CER (резина + лебідка) | 30–50 кг | 9–15 м/с | 5,5 м | $5 700 | [uavmodel](https://www.uavmodel.com/products/skyeye-launching-pad) |
| Naja H-05 / Feiyu (резина) | до 5–6 кг | «> 50 км/год з повним газом» | 2,4–2,5 м | $1 300–2 100 | Austars |

- **«Стеля 24–25 м/с» для легких катапульт приблизно підтверджується:** пневматичні класу ELI / UAV Factory дають ~~25–26 м/с~~ **до 25 м/с (ELI — офіційна межа виробника «Maximum allowed launch velocity 25 m/s»; 26,0–26,6 у таблицях — поза дозволеним) і 26 м/с (UAV Factory)**, гумові — ~~≤ 18 м/с~~ ≤ 18 м/с **у нинішніх малих комерційних моделях — це не фізична межа** (R07d-V: SCL-1A 2020 — 10 кг на 25 м/с; гумова MTI за Novaković — ≈70 кг на ≈30 м/с; проблема резини — розміри й повторюваність).
- **light+ (7,75 кг, потрібно 24,4 м/с):** підходить ELI PL-40 ~~(26 м/с для 10 кг)~~ — **формально, із запасом лише ≈0,6 м/с** до 25 м/с. Naja H-10A дає ≈21–22 м/с на 7,75 кг — мало (власна інтерполяція із заголовка товару; товару немає в наявності).
- **V30 (18 кг + візок, 24 м/с, 6,2 кДж):** ELI PL-40 на межі (23,4 м/с для 20 кг), PL-60 — з запасом ≈1 м/с до 25. Ціни не опубліковані (лише за запитом), це професійне обладнання. ❓ Чи включає «Plane mass» у таблицях ELI штатний візок — уточнити (інакше 3 кг візка пораховано двічі).
- ➕ R07d-V: дешевих хобі-катапульт в ЄС під 8 кг / 18–20 кг на 24 м/с **не знайдено**. Українські військові пневмокатапульти (Airdroper $900 до 20 кг, Altair) дають до 20 g — забагато для планера на 6 g, і можливі обмеження експорту.
- **Саморобна гумова катапульта на 6–12 кДж** — велика споруда. Приклади з літератури:
  - LSU-02 розганяє 14,4 кг до 15,2 м/с на рейці 2,5 м ([IJICIC 2024](http://www.ijicic.org/ijicic-200415.pdf));
  - гумово-поліспастна схема на 97 кДж ([Novaković 2014](https://scindeks-clanci.ceon.rs/data/pdf/1820-0206/2014/1820-02061404017N.pdf)).

## 7. Вердикт (до перевірки)

1. **V30** — єдиний варіант, що вкладається в 25 кг на Li-ion 21700 і 160 км/год (**19,6–22,7 кг** з поправками R07d-V). Але це вже **велика модель класу ~20 кг**: розмах 2,2 м, мотор ~4,5 кВт, гвинт 16", батарея ≈1 кВт·год (≈4,5–4,7 кг; 60 комірок P50B — ~~~€300–400~~ **≈€330–395 оптом (nkon) / ≈€750 у німецькій рознизі**, зі збіркою ≈€450–850), катапульта професійного класу, клубне поле з дозволом «bis 25 kg».
2. **V60** — ~~можливий, якщо знизити швидкість до ~130 км/год (≈20 кг) або взяти напівтвердотільну батарею (≈21 кг, батарея ~€1 400+).~~ ❌ R07d-V: на 160 км/год **≈28,5 кг — поза відкритою категорією**. Під 25 кг: **130 км/год** (20,6 кг, якщо фіксований час, але дальність 141 км; 22,7–24,0 кг, якщо фіксована дальність 160 км) або **2 паки Tattu** (24,3–25,1 кг, ≈€2 900, впритул і зараз немає в наявності).
3. **V90 на 160 км/год** — ні (≈46,6 кг). ~~На 130 км/год і з найкращою батареєю — на межі 25 кг.~~ Єдиний шлях під 25 кг — **2 паки Tattu на 130 км/год** (24,3–25,1 кг, 243–250 км).
4. Найсильніший важіль — **швидкість**: 160 → 130 км/год знімає з V60 ~~≈6 кг~~ **≈3,6 кг**, з V90 ~~≈15 кг~~ **≈10 кг** — при тій самій дальності.
5. ~~➕ R07d-V: **без системи посадки апарат не повернеться.** Парашут 0,8–1,2 кг додає V30 ≈2 кг, V60 ≈2–3 кг злітної маси.~~ — поза рамками: посадку Віктор вирішує сам (2026-09-26).
6. **Без обмеження правилами** (рішення 2026-09-26): межа 25 кг — не критерій. Тоді за чистою інженерією: **V30** ≈19,6 кг — найпростіший; **V60 на 160 км/год** ≈28,5 кг — цілком здійсненний, але вдвічі більша батарея, крило 0,86 м², мотор із запасом за струмом і катапульта ≈8–9 кДж; **V90** ≈47 кг — великий апарат, батарея 23+ кг.

## 8. Відкриті питання

- Що це за вантаж і чи ділиться він на дві половини (для центрування)?
- Чи прийнятний крейсер ~130 км/год замість 160 для V60 / V90?
- Бюджет на катапульту (професійна пневматична vs саморобна гумова)?
- Клуб DMFV / MFSD поблизу Фрайбурга з полем, де можна отримати дозвіл на 12–25 кг?
- Матеріал гондоли — R07e.
- ➕ R07d-V: **що обов'язкове — час (30 / 60 / 90 хв) чи дальність (80 / 160 / 240 км)?** Від цього залежить, скільки дає 130 км/год.
- ➕ R07d-V: реальний CL_max крила з закрилками (Penguin: 1,3 / 1,7). При 1,3 / 1,6 схід ≈21 м/с — доступні дешевші катапульти.
- ~~➕ R07d-V: спосіб посадки й маса системи (парашут 0,8–1,2 кг, посилена лижа, сітка).~~ — поза рамками.
- ➕ R07d-V: обшивка гондоли — 0,75 мм (1,2 кг/м²) чи 1,2 мм (1,9 кг/м²)?
- ➕ R07d-V: мотор із запасом за струмом для V60 / V90 (AT7224 + більший гвинт або 14S; ESC 150 А+, зараз закладено 0,2 кг).
- ➕ R07d-V: хвостовий конус гондоли 150 → 35 мм на 240 мм (13,5°) — ризик відриву потоку; CFD або довший конус.
- ➕ R07d-V: чи включає «Plane mass» ELI візок; ціни PL-40 / PL-60 за запитом.
- ➕ R07d-V: геозони біля Фрайбурга — аеродром Freiburg (1,5 км), контрольована зона Basel-Mulhouse, Рейн, A5, залізниця, Natura 2000: де лишається місце для кіл радіусом 1–1,5 км на 160 км/год?
- ➕ R07d-V: чи варто розглядати PDRA-G01 / S02 замість повної SORA для BVLOS на 18–25 кг?

## 9. Що без джерела / припущення

- Питома маса обшивок (крило 0,70, гондола 1,20 кг/м²), нервюр, фітингів, коефіцієнт 1,10 — інженерні оцінки. Частка конструкції 19–23 % не звірена з реальними БПЛА 15–25 кг (довідково: Penguin B — 10 кг порожнього при 21,5 кг MTOW, [datasheet](https://www.unmannedsystemstechnology.com/wp-content/uploads/2014/11/Penguin-B-Datasheet.pdf); Mugin-3 — 14,7 кг рами при 28 кг MTOW).
- CL_max 1,0 / 1,2 — не виміряно. Візок 3 кг — припущення.
- K_misc 1,467 калібровано на light — перенесення на гондолу з балкою не перевірене.
- Модель мотора AT7215 (Rm, Io) — з каталогу; ККД ланцюга 0,68–0,70 не калібрований.
- Ціни комірок — оцінка; ціни катапульт ELI / UAV Factory не опубліковані.
- ~~Вимога e-ID при реєстрації — не підтверджена.~~ ✅ R07d-V: e-ID не потрібна.
- ➕ R07d-V: допустимі напруження (полиці 500, джойнер 900, низ оболонки 40 МПа), перевантаження 6g × 1,5 (порив 15 м/с на 44 м/с дає n ≈ 6,2 — на межі), 15 Вт·год на набір висоти (для V90 замало), авіоніка 10 Вт.
- ➕ R07d-V: Naja H-10A «6 кг — 25, 10 кг — 19 м/с» — лише із заголовка товару; H-50A і TACA-6M — лише з рядків «пов'язаних товарів» / заголовків; ціни — старі («Was»), товарів немає в наявності.
- ➕ R07d-V: «саморобна гумова катапульта на 6–12 кДж — велика споруда» — оцінка без джерела.
- ➕ R07d-V: внески місцевого клубу у вартості клубного шляху не враховані.

---

## 🔍 R07d-V — перевірка (2026-09-25, 2 незалежні адверсарні аудитори)

**Вердикт.** Розрахунок: арифметика відтворюється до сотих (незалежний перерахунок CL, Vs, L/D, часу, дальності, кДж, згину, джойнера). Але модель **систематично оптимістична за масою**. Правила: розділ 5 здебільшого підтверджено першоджерелами (EUR-Lex консолідовані 2019/947 від 01.05.2025 і 2019/945 від 24.06.2025 читались напряму, LuftVO / LuftVG / LuftVZO / LuftKostV — наживо). Поправки внесено вище видимо (~~закреслено~~ + ❌ / ➕ R07d-V).

| Що перевірено | Результат |
|---|---|
| Замикання маси, округлення паралелей | стоїть (арифметика) |
| Частка конструкції 19–23 % | ❌ нижня межа; реальні БПЛА 15–28 кг — 45–52 % (планер + привід) |
| Обшивка гондоли 1,2 кг/м² vs t = 1,2 мм | ❌ суперечність: маса для 0,75 мм, міцність для 1,2 мм |
| Оверхед паку 7 % | ❌ → 9–12 % |
| Повнота списку мас | ❌ немає гака, Remote ID, вогнів, BMS, системи посадки |
| **Злітна маса** | **V30 18,5 → 19,6; V60 25,9 → 28,5; V90 40,8 → 46,6 кг** (реалістичний мінімум) |
| Мотор V90 | ❌ у скрипті KV245 (119 А > 110 А пік); з KV220 — T/W 0,22, набір 3,8 м/с |
| Io мотора | 2,0 → 2,4 А |
| CL, опір, L/D, APC η, час, дальність, катапульта, згин, джойнер | стоять |
| CD0 перенесення з light на гондолу | не перевірено; вести ×1,0–1,25 |
| 130 км/год | ❌ рахувалось при тому самому часі; при тій самій дальності V60 22,7, V90 31,2 кг |
| Напівтвердотільна батарея | ❌ неперервна маса; цілими паками V60 24,3–25,1, V90 29,8–30,8 кг; зараз немає в наявності |
| Макс. вантаж V30 | ❌ 12 → 12,5 / 13,9 кг |
| Стрічки гондоли V90 | ❌ 0 → ≈564 мм² (баг) |
| Кручення ÷16 000 | теоретична межа; реально в рази–десятки разів; висновок стоїть |
| Ціна комірок V30 | ~€300–400 → €330–395 оптом / €750 роздріб |
| A3, A2 = C2, 120 м, VLOS, спостерігач, скидання, швидкість | стоять |
| Реєстрація, Kompetenznachweis, страховка, §21f, DMFV > 25 кг, SORA 2.5, RP Stuttgart, VLOS-формула EASA | стоять |
| e-ID | ❌ не потрібна |
| Геозони «100 м від доріг» | ❌ лише федеральні траси, водні шляхи, залізниці |
| Внески DMFV | ❌ це членські внески (страховка всередині); з 2027 дорожчі; Basis поза полем ≤ 1 кг |
| Специфічна категорія | ➕ PDRA як спрощення; Remote ID + зелений вогонь обов'язкові |
| ELI 25–26 м/с | ❌ офіційна межа 25 м/с |
| Резина ≤ 18 м/с | ❌ не фізична межа (SCL-1A 2020: 10 кг на 25 м/с) |
| Габарити SCL / Robonic | ❌ це довжина установки, не рейки |

**Що це означає:** висновок «V30 — так, V60 — на межі, V90 — ні» **посилився**: V60 на 160 км/год уже не «трохи понад», а ≈28,5 кг. Реалістичні шляхи до 8 кг вантажу в межах 25 кг: **V30 на 160 км/год** або **V60 на 130 км/год**.
