NetHunter123/Jflyproject/CAD/GN+.png

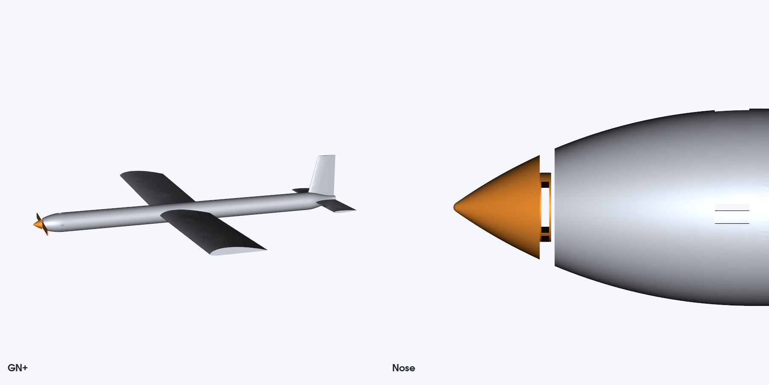
CAD/GN+.png
