NetHunter123/Jflyproject/CAD/nose_lightplus.png

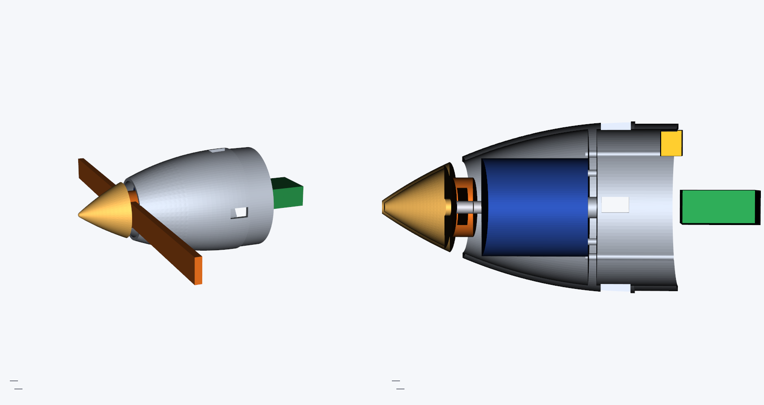
CAD/nose_lightplus.png
