NetHunter123/Jflyproject/CAD/tail_lightplus.png

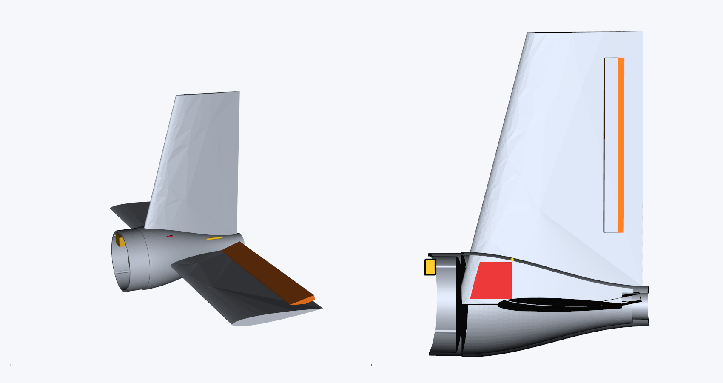
CAD/tail_lightplus.png
