NetHunter123/Jflyproject/_Archiv/R07e-Rumpf-Material.md

---
tags:
  - project
  - engineering
  - gungnear
etappe: R07e
status: 🔍 перевірено (R07e-V) — головне стоїть (HT/ПВХ — ні); саморобній трубі потрібні стрічки; Klima Ø75 зараз не продається; поправки видимо
updated: 2026-09-26
---

# R07e — Матеріал труби фюзеляжу: папір, каналізаційні труби (HT / KG / ПВХ-U), склопластик, карбон, алюміній

> **Питання Віктора (2026-09-25):** «Я не розумію, що то за паперова труба, чому паперова, звідки буде братись жорсткість конструкції? Я думав використовувати якусь ПВХ-трубу, типу каналізаційної».
> **Прохід:** 2 агенти послідовно — (1) ринок: реальні труби Ø70–170 мм з даташитами; (2) міцність, жорсткість і вплив на льотні характеристики для light, light+ і 8-кг апарата. **Перевірено R07e-V** (2 аудитори, 2026-09-26): поправки внесено видимо (~~закреслено~~ + ❌ / ➕ R07e-V), підсумок — унизу.

## 🗣 Відповідь простими словами

- **Паперова труба Klima** — це спірально-намотана картонна труба для моделей ракет (Ø75 / 72,6, 120 г на 500 мм). Її взяли, бо вона найлегша з готових Ø75 і клеїться будь-чим. Жорсткість мала давати сама стінка + шар склотканини.
  - ➕ R07e-V: **зараз Klima Ø75 не продається ніде** (Klima і SRT — «nicht lieferbar»). Наявна заміна — **LOC Precision 3.00" kraft** (Ø78,7 / 76,2, ≈256 г/м, $14) — тоді ніс і конус у CAD треба перебудувати під Ø78,7.
- **Жорсткість труби** росте як модуль матеріалу × радіус³ × стінка. Тому важить не лише «твердість» матеріалу, а й діаметр: удвічі ширша труба — у 8 разів жорсткіша при вдвічі більшій масі.
- **Каналізаційні труби:**
  - **сіра HT** — не ПВХ, а **поліпропілен**: м'який (як папір, але вдвічі важчий), епоксидка його не бере, на морозі крихкий. **Не брати.**
  - **справжній ПВХ-U 75×2,3** — утричі жорсткіший за голий папір і добре клеїться, але на light+ це **+0,4 кг** (≈8,15 кг: зрив вище, катапульта на самій стелі 25 м/с, −6…−7 хв), батарея може не влізти (внутрішній Ø70,4 при пакеті Ø69,7), на сонці в авто м'якне (Vicat 76 °C). **Для літака — ні.** (R07e-V: ця труба зараз ще й «ausverkauft»; тонша 75×1,8 продається лише фірмам.)
  - **руда KG DN110** — ~~+1,2–1,4 кг~~ ❌ R07e-V: Baumarkt-KG — це coex-труба зі спіненою серединою, ≈1,15–1,2 кг/м → **+0,85–1,05 кг**. Однаково **ні.**
- **Що з цього випливає:** паперова труба зі склом у нинішньому вигляді **справді не тримає** люків (і на light+, і — нове — на light). Найпростіший ремонт — **карбонова тканина замість скляної** (та сама маса, жорсткість ×2,6) + 4 вуглецеві стрічки в зоні вантажу. **Найкраще — саморобна тонка карбонова або склопластикова труба, викладена на каналізаційній HT-трубі як на оправці** (поліпропілен не клеїться — тому ідеальна форма): light+ стає на ~~0,2–0,3~~ **≈0,19–0,26 кг** легшим.
  - ❌ R07e-V: **без вуглецевих стрічок така тонка труба (0,36 мм) втрачає стійкість** біля люків (MS −0,46) — стрічки потрібні й тут. Потрібен вакуум (насос R&G ≈€450 або саморобний; без вакууму маса +30 %), матеріали ≈€75–95 на трубу.
- ➕ R07e-V, **новий кандидат «купити готове»:** **LOC Precision 3.0" carbon Ultra Light** — стінка 1,0 мм, Ø78,7 / 76,2, $302 за 1,52 м (+ доставка, 19 % EUSt). Розрахунково ≈0,37–0,38 кг/м — приблизно як папір зі склом, але в рази жорсткіша (EI ≈8 000). Маса й конструкція не підтверджені — запитати виробника.
- **Твоя ідея з каналізаційною трубою корисна, але в іншій ролі:** як **оправка** для викладки, як **наземний макет** і як оправка для гондоли 8-кг апарата (DN160).

---

> ⚠️ **Розрахунковий прохід** (1 агент, 2026-09-25). Нічого не зважено й не випробувано. Навантаження взято з перевіреного списку мас R07b-V / R07c-V (з поправками +60 г) і з чернетки R07d. Скрипти в scratchpad сесії: `fuselage/tubecalc.py`, `tubeeval.py`, `pod8.py`, `extras.py`; журнал — `struct_progress.md`.

## 0. Коротко

- **Що таке Klima:** спірально-намотана паперова труба для моделей ракет (Ø75 / 72,6, 240 г/м). Це найлегша готова труба Ø75, що клеїться будь-чим. На грам вона жорсткіша за будь-яку «каналізаційну». ➕ R07e-V: **зараз не продається** (заміна — LOC 3.00" kraft, Ø78,7).
- **Сіра HT-труба — не ПВХ, а поліпропілен.** EI ≈372 Н·м² — як у голої Klima, при вдвічі більшій масі. Епоксидка її не бере, нижче −10 °C вона крихка, на кручення найм'якша. **Не брати.**
- **Справжній ПВХ-U 75×2,3** (найтонший у продажу, 735 г/м) приблизно втричі жорсткіший за голий папір. Але на light+ він додає **+0,38–0,43 кг** (8,13–8,18 кг), схід 25,0 м/с (стеля ринку), −6…−7 хв у повітрі. Пакет Ø69,7 у його внутрішній Ø70,4 може не влізти. **KG DN110** — ~~+1,2–1,4 кг~~ +0,85–1,05 кг (coex, R07e-V). **Для льотного апарата — ні.**
- **Папір + скло в поточному вигляді не тримає люків** на light+ (MS −0,68), а навіть закритий у вологому стані має MS −0,25 (R07e-V: і сухий −0,14 — проблема не у вологості, а в граничній деформації паперу ≈0,47 %). **Нове:** на light теж ~~не тримає (MS −0,36)~~ — ✏️ R07e-V: **«на межі або нижче»**: −0,36 з неперевіреною силою 30 Н на хвості й припущеним люком 148° через джойнер; без хвоста MS ≈ −0,01.
- **Мінімальне виправлення:** 1 шар **карбону замість скла** — та сама маса, EI ×2,6. Плюс ~~4 стрічки 1×5 у зоні вантажу light+~~ ✏️ R07e-V: стрічки на light+ **через обидві зони (вантаж + батарея, ≈47 г)** — інакше їхні кінці опиняються у вирізах батарейних люків і їх нема куди заанкерувати.
- **Найкраще технічно:** **саморобна карбонова (або склопластикова) труба на оправці з HT-труби**: light+ ~~−0,22…−0,32 кг (+4…+6 хв)~~ **−0,19…−0,26 кг (карбон) / −0,11…−0,17 (скло), +3…+5 хв**, light ~~−0,13…−0,17 кг~~ **−0,10…−0,14 кг** (R07e-V). ❌ **Лише зі стрічками** — тонка тканинна стінка 0/90 без них втрачає стійкість.
- **Силові кришки люків потрібні для будь-якого матеріалу:** відкритий переріз втрачає жорсткість на кручення ~~в тисячі разів~~ (R07e-V: у реальних відсіках 214–223 мм — у 5–100 разів, але на кінцях відсіків виникають осьові напруження від депланації 130–290 МПа — тож кришки обов'язкові вже з міркувань міцності).
- **8 кг:** труби DN160 міцні, але MTOM +1,9…+4,6 кг від моделі, **а від реалістичної бази R07d-V ще більше** (KG160 ≈22,4 / 33,1 кг). Потрібна композитна гондола. R07d занижував напруження в 1,4–1,65 раза. ➕ R07e-V: для V60 склопластик 0/90 0,73 мм **не проходить** (MS −0,20) — потрібен карбон, квазіізотропний склопластик або сендвіч.

## 1. Звідки береться жорсткість і міцність

- **Згин.** EI = E × I. Для тонкої труби I ≈ π·r³·t: радіус у кубі, стінка в першому степені. Вигідно ставити матеріал якнайдалі від осі.
- **Міцність.** σ = M/Z, де Z ≈ π·r²·t. При +6g верх розтягується, низ стискається; при −3g навпаки.
- **Місцева стійкість.** σ_кр = 0,605·E·t/R × γ (NASA SP-8007: γ = 1 − 0,731·(1 − e^−φ) для згину, φ = √(R/t)/16).
- **Люк 131° зверху:** I падає до 25 %, напруження на краю зростає ×3,4. Якщо той самий виріз зробити збоку, I лишається 72–76 % (але там корінь крила).
- **Кручення.** Замкнена труба: GJ = 4A²·G·t/периметр. Розрізана: GJ = G·s·t³/3, тобто ~~÷4 000–6 000~~ (R07e-V: ÷1 200 для ПВХ … ÷50 000 для саморобного карбону — для нескінченного профілю; реальні відсіки між замкненими ділянками — ÷5…÷100, зате з напруженнями депланації на кінцях).
- **Підсилення:** обшивка (скло/карбон), стрічки-лонжерони, шпангоути, щоки рами крила, силові кришки. Окремий хребет (труба як обтічник) у Ø75 не вміщається.
- Поточна схема — **напівмонокок**: оболонка + 4 стрічки + кришки.

## 2. Припущення розрахунку

| Параметр | Значення | Джерело |
|---|---|---|
| Перевантаження | +6 / −3, коефіцієнт безпеки 1,5 (усі напруження нижче — розрахункові, ult) | R07c |
| Сила на стабілізаторі | 30 Н limit на +6g, на ділянці за крилом | R07c-V, припущення |
| Маси | список R07b-V / R07c-V + 60 г; труба розподілена; маса кожного варіанта враховується | розрахунок |
| Кут люка | 2·arcsin(ширина / ID): пакет Ø69,7, камера Ø66 | розрахунок |
| Люк light | один, 148°, x ≈136–586 | **припущення** |
| Стрічки | 4 шт.: 2 на краях люка, 2 під ±135°; CFK UD 135 ГПа, 500 / 350 МПа | оцінка |
| Кручення | 6 Н·м limit; кришки відновлюють ~50 % GJ | оцінка |

### Таблиця 1. Матеріали (допустимі для розрахункового навантаження)

| Матеріал | ρ, г/см³ | E, ГПа | Допустиме, МПа | Температура / холод | Клей |
|---|---|---|---|---|---|
| Папір Klima | 0,86 | 2,0 (1,57–2,36); волога → 1,5. ➕ R07e-V: ракетні паперові труби — уявний E 2,0–2,7, розчавлення 6,6–17 МПа (LOC 3": 12,8–13,7) — розрахункові значення консервативні. ⚠️ Модуль зсуву G, імовірно, 0,14–0,18 ГПа, а не 0,8 | розтяг 10,9 / стиск 7,1 (волога ×0,75) | не м'якне; боїться вологи | будь-який |
| HT PP | 0,95 | 1,275 (20 °C) → 0,96 (40 °C) | 24 (40 °C) / 20 (55 °C); текучість 30,4 при 20 °C | Vicat 158–164 °C; < −10 °C крихкий | ~~лише DP8005, праймер 770, полум'я~~ ✏️ R07e-V: DP8005 (акрил, 7,2 МПа, але **Tg 34–38 °C**); праймер SF 770 — **лише з ціанакрилатом**; полум'я + епоксидка — дані лише для HDPE (екстраполяція) |
| ПВХ-U | 1,38–1,40 | 3,0 → 2,7 (40 °C) | 37,5 (40 °C) / 28 (55 °C); 50 при 23 °C | 0–45 °C, до 60 °C короткочасно; Vicat 76; холод — крихкий | THF-клей; епоксидка після P80 (≈12 МПа) |
| Намотаний склопластик G12 | 1,82 | ≈14 | 100 | Tg смоли | епоксидка |
| Карбон (roll-wrapped) | 1,5 | ≈50 | 300 / 250 | Tg смоли | епоксидка |
| Алюміній 6060 T66 | 2,70 | 69 | 160 | до ~150 °C | епоксидка з праймером |
| Саморобний карбон / склопластик | 1,5 / 1,71 | 45 / 18 | 300/250 / 180/150 (плюс стійкість) | Tg епоксидки кімнатного твердіння 50–60 °C | — |

## 3. Перерізи класу Ø75 (20 °C, розрахунок)

| Варіант | г/м | ID, мм | Зазор пакета | Люки: бат. / вант. | EI, Н·м² | GJ закр., Н·м² | σ_кр, МПа |
|---|---|---|---|---|---|---|---|
| Klima + 1 шар скла | 240 + 70 | 72,6 | +2,9 | 148° / 131° | 729 | ~~443~~ 453 (з G паперу 0,14–0,18 ГПа ≈195–210 — R07e-V) | 28 (папір розчавлюється ~7–10) |
| Klima + 1 шар карбону | 240 + 76 | 72,6 | +2,9 | 148° / 131° | 1 882 | 551 | 20 |
| Klima гола (довідково) | 240 | 72,6 | +2,9 | 148° / 131° | 379 | 303 | 23 |
| HT DN75 PP 75×1,9 | 454 | 71,2 | +1,5 | 156° / 136° | 372 (280 при 40 °C) | 262 (198) | 25 |
| ПВХ-U 75×2,3 | 735 | 70,4 | **+0,7** | **164° / 139°** | 1 041 (937) | 757 (680) | 87 |
| KG DN110 110×3,2 | ~~1 503~~ **≈1 150–1 200** (coex, R07e-V) | 103,6 | +33,9 | 85° / 79° | ~~4 594~~ менше (спінена середина) | 3 337 | 82 |
| ~~Madcow 3" G12 thin 78,7×1,25~~ ❌ R07e-V: **не продається** (лише в базі OpenRocket) | ~~533~~ | 76,2 | +6,5 | 132° / 120° | 3 181 | 2 726 | 214 |
| ➕ Madcow / Wildman 3" G12 (стандарт, у продажу) 79,25×1,52 | 705 | 76,2 | +6,5 | 132° / 120° | більше | більше | — |
| ➕ LOC 3.0" carbon Ultra Light 78,7×1,0 (у продажу, $302 / 1,52 м) | ≈370–380 (розрах.) | 76,2 | +6,5 | ≈132° / 120° | ≈8 000 (оцінка) | — | — |
| Карбон 80×76 (WHABEST) | 728 | 76,0 | +6,3 | 133° / 121° | 18 640 | 3 354 | 1 278 |
| Алюміній 75×1 (не продається) | 628 | 73,0 | +3,3 | 145° / 129° | 10 981 | 8 275 | 868 |
| Алюміній 80×2 | 1 323 | 76,0 | +6,3 | 133° / 121° | 25 723 | 19 381 | 1 764 |
| Саморобний карбон 2 × 160 г/м² | ~~128~~ 136 (вакуум) / 168 (без) | 75,0 | +5,3 | 137° / 123° | 2 721 | 484 | ~~170~~ **≈70** (ортотропно, R07e-V) |
| Саморобний склопластик 3 × 163 г/м² | 195 | 75,0 | +5,3 | 137° / 123° | 1 459 | 567 | ~~96~~ **≈61** (ортотропно, R07e-V) |

Закрутка при 6 Н·м на light+ (закрита / з силовими кришками): ~~папір + скло 0,86° / 1,54°; папір + карбон 0,69° / 1,24°; **PP 1,93° / 3,44°**; ПВХ 0,56° / 1,00°; Madcow 0,14° / 0,25°; саморобний карбон 0,79° / 1,41°~~ ❌ R07e-V: момент від кіля йде лише позаду рами крила (641 мм, не 1 110) → **PP 1,11° / 1,87°; ПВХ 0,32° / 0,55°; саморобний карбон 0,46° / 0,77°; папір + скло ≈1,1° / 2,0°** (з поправкою на реальний G паперу — оцінка). Не враховано реактивний момент мотора 1,8–3,7 Н·м через передні люки. З відкритими люками й несиловими кришками кручення не тримає жоден варіант.

## 4. Light (5,07 кг)

Розрахункові моменти: x 304 — 20 Н·м, x 350 — 29, **x 372 — 45 (з хвостом)**, x 586 — 14.

| Варіант | Пакет труби, г | σ закр. x372 | σ з люком x372 | MS без стрічок | Що потрібно | Δm, г |
|---|---|---|---|---|---|---|
| Папір + скло | 232 | 3,9 | папір 16,8 / −10,0; скло 157 | **−0,36 ❌** (R07e-V: залежить від неперевірених 30 Н на хвості; без них ≈ −0,01) | 4 × 1×5 (+23 г) → +2,5 | 0 (+23 проти 5,07) |
| Папір + карбон | 236 | 1,4 | папір 6,0 / −3,5; карбон 180 | +0,66 ✅ | нічого | −20 |
| HT PP | 290 | 5,7 | 27,0 / −16,1 | −0,11 ❌ | 4 × 1×5 + кріплення | +73 |
| ПВХ-U 75×2,3 | 470 | 4,9 | 26,0 / −15,3 | +0,44 ✅ (55 °C: +0,08) | баласт 58 г або авіоніка вперед | +214 (+272) |
| ~~Madcow 3" thin~~ ❌ не продається; стандарт 705 г/м | 341 → ≈450 | 7,8 | 27,3 / −17,0 | +2,7 ✅ | переробити ніс і конус | ~~+85~~ **≈+200** |
| Карбон 80×76 | 465 | 4,9 | 17,4 / −10,8 | +16 ✅ | — | +210 (+266) |
| Алюміній 75×1 / 80×2 | 401 / 845 | 10,8 / 5,3 | 44,4 / −27,0 | +2,6 / +7,5 ✅ | — | +156 / +600 |
| Саморобний карбон | 82 | 26,9 | 99 / −61 | ~~+1,8 ✅~~ **≈+0,14** (σкр ≈70, R07e-V); вільні краї на −3g не підкріплені | рамка люка або 2 стрічки на краях, накладка під гільзу | ~~−174~~ **−110…−141** |
| Саморобний склопластик | 124 | 20,3 | 75 / −46 | +1,1 ✅ (R07e-V: з ортотропною стійкістю менше — не перераховано) | рамка люка | **−131** (реально менше) |

## 5. Light+ (7,75 кг із 2 кг)

Розрахункові моменти (папір): x 350 — 28 Н·м; x 575 — 79; **x 603 — 109 (з хвостом)**; x 751 — 66; x 843 — 46.

| Варіант | Пакет, г | σ закр. x603 | σ з люком x603 | MS без стрічок | Стрічки 1×5 | MS зі стрічками | Δm, г |
|---|---|---|---|---|---|---|---|
| Папір + скло | 413 | 9,5 (**MS −0,25** волога / −0,14 суха) | папір 32,8 / −20,3; скло 308 | **−0,68 ❌** | 8 шт., обидві зони (47 г) | +0,66 | 0 |
| Папір + карбон | 418 | 3,4 | папір 11,7 / −7,2; карбон 353 | −0,15 ❌ | ~~4, зона вантажу (20 г)~~ **через обидві зони (≈47 г)** — R07e-V: анкерування | +0,62 | ~~−20~~ **≈+6** |
| HT PP | 504 | 13,7 | 50,3 / −31,2 | −0,52 ❌ | 8 (47 г) + кріплення | +0,33 | +106 |
| ПВХ-U 75×2,3 | 816 | 12,0 | 45,6 / −28,1 | −0,18 ❌ | 4, зона вантажу | +0,41 (55 °C: +0,05) | **+377 (+427)** |
| KG DN110 | ~~1 669~~ ≈1 300 | 4,5 | 8,9 / −6,4 | +3,2 ✅ (завищено: спінена стінка) | — | — | ~~+1 210 (+1 414)~~ **≈+850 (+1 050)** |
| ~~Madcow 3" thin~~ ❌ не продається; стандарт 3" G12 705 г/м | ~~592~~ ≈780 | 18,9 | 57,4 / −36,9 | +0,74 ✅ | — | — | ~~+133~~ **≈+320** |
| ➕ LOC 3.0" carbon Ultra Light (оцінка, R07e-V) | ≈410–420 | — | — | ≫ 0 (EI ≈8 000) | — | — | **≈−50…0** (не підтверджено) |
| Карбон 80×76 | 808 | 12,0 | 36,6 / −23,5 | +7,2 ✅ | — | — | +349 (+397) |
| Алюміній 75×1 | 697 | 26,2 | 88,6 / −55,7 | +0,81 ✅ | — | — | +248 |
| Алюміній 80×2 | 1 469 | 13,1 | 39,9 / −25,6 | +3,0 ✅ | — | — | +1 020 |
| Саморобний карбон | 142 | 64,8 | 204 / −130 | ~~+0,31 ✅ (стійкість)~~ ❌ **−0,46** (ортотропна стійкість ≈70 МПа, R07e-V) | ~~— (рамки люків)~~ **4 × 1×5 / 1×10** + рамки країв + накладки | **+0,15 / +0,71** | ~~−317~~ **−185…−256** |
| Саморобний склопластик | 216 | 49,0 | 154 / −98 | ~~−0,03~~ **−0,38** ❌ (R07e-V) | 4, зона вантажу | ~~+1,0~~ **+0,87** | ~~−223~~ **−108…−172** |

Δm враховує все: пакет труби (сама труба + обшивка + муфти), стрічки (+30 % клею) і кріплення. Порівняння йде з папером + склом, у якого теж є свої необхідні стрічки; у дужках — із баластом для повернення ЦМ.

Інші перевірки:
- **Зминання під гільзою джойнера** (Ø18, дві стінки, 605 Н ult): папір 12,4 МПа — потрібні щоки; ПВХ 7,3; PP 8,8; саморобний карбон 46,7 — потрібна локальна накладка.
- **Бічний згин від кіля** (≈36 Н limit): з верхнім люком ≈10 МПа — не визначає.
- **Стиск і розтяг на катапульті** (445 / 686 Н) дають 1–3 МПа — не визначають.

## 6. Вплив маси на льотні характеристики

Методика: витривалість ∝ m^−1,41; потужність на 180 км/год рахується через індуктивну частку (light 4,0 %, light+ 6,6 %); схід і зрив ∝ √m; енергія катапульти ∝ m². Діаметр понад 75 мм додає ≈0,18 × ΔD/D до опору.

| light+ | Маса, кг | Витривалість, хв | 180 км/год, Вт / км | Зрив, км/год | Схід, м/с | Енергія, кДж | ΔЦМ, мм |
|---|---|---|---|---|---|---|---|
| Папір + скло (база) | 7,75 | 96 | 833 / 100 | 73,2 | 24,4 | 2,31 | 0 |
| Папір + карбон | 7,73 | 96 | 833 / 100 | 73,1 | 24,4 | 2,30 | 0 |
| HT PP | 7,86 | 94 | 835 / 100 | 73,7 | 24,6 | 2,37 | −0,4 |
| **ПВХ-U 75×2,3** | **8,13 (8,18)** | **90 (89)** | 838 / 99 | 75,0 | **25,0 (25,1)** | 2,54 | **+2,8** |
| KG DN110 (R07e-V: coex легша, ≈8,6–8,8 кг) | ~~8,96–9,16~~ | 74–77 → ≈79–81 | 923+ / 90 | 78,7 | **26,2–26,5 ❌** (≈25,7–26,0) | 3,09 | +10,6 |
| ~~Madcow 3" thin~~ ❌ → стандарт 3" G12 | ~~7,88~~ ≈8,07 | ≈91 | ≈845 / 99 | ≈74,6 | ≈24,9 | ≈2,50 | ≈+1 |
| Карбон 80×76 | 8,10 | 90 | 848 / 98 | 74,8 | 24,9 | 2,52 | +2,7 |
| Алюміній 75×1 | 8,00 | 92 | 837 / 100 | 74,4 | 24,8 | 2,46 | +1,6 |
| Саморобний карбон | ~~**7,43**~~ **7,49–7,57** | ~~**102**~~ **99–101** | 830 / 100 | ≈72 | **≈24,0–24,1** | ≈2,16–2,20 | −4,5 |
| Саморобний склопластик | ~~7,53~~ **7,58–7,64** | ~~100~~ **≈98–99** | 832 / 100 | ≈72,4 | ≈24,15 | ≈2,22 | −3,7 |

| light | Маса, кг | Витривалість, хв | Схід, м/с | ΔЦМ, мм |
|---|---|---|---|---|
| Папір + скло (+23 г стрічок) | 5,09 | 156 | 21,6 | 0 |
| Папір + карбон | 5,05 | 158 | 21,6 | 0 |
| HT PP | 5,14 | 154 | 21,75 | −0,3 |
| ПВХ-U 75×2,3 | 5,28 (5,34) | 148 (146) | 22,05 (22,2) | +2,5 |
| ~~Madcow 3" thin~~ ❌ → стандарт 3" G12 | ~~5,16~~ ≈5,27 | ≈149 | ≈22,0 | ≈+1 |
| Алюміній 80×2 | 5,67 (5,86) | 134 (128) | 22,8 (23,2) | +7,8 |
| Саморобний карбон | ~~4,90~~ **4,93–4,96** | ~~165~~ **≈160–162** | 21,3 | −3,8 |
| Саморобний склопластик | 4,94 (реально трохи більше) | ~~163~~ ≈160 | 21,3 | −3,0 |

- **ПВХ на light+** переходить поріг 7,9 кг із R07c (тоді крило 0,32 м² або закрилки на старті обов'язкові). ЦМ зсувається на +2,8 мм, до 593,4 при цілі 589 ± 3. Виправити можна 49 г баласту або перенесенням ≈30 г авіоніки вперед.
- Джойнер Ø16 при масі 8,18 кг: ≈197 МПа замість 184.
- **Саморобні труби** зсувають ЦМ вперед на 4–4,5 мм (586), що виставляється розпіркою заднього блоку.

## 7. 8-кг апарат (R07d): гондола Ø150–160

Розрахункові моменти на задній рамі крила: V30 247 Н·м, V60 422 Н·м (у важчих трубах до 271 / 458). Виріз відсіку 100°.

| Варіант | Циліндр V30 / V60, кг | Δ проти композиту, кг | σ з вирізом V60, МПа | MS V30 / V60 | MTOM V30 / V60, кг |
|---|---|---|---|---|---|
| Композит R07d, склопластик 0,73 мм | 0,53 / 0,65 | 0 | +80,4 / −54,4 | +1,1 / **+0,22 ⚠️** — ❌ R07e-V: лише для квазіізотропного; **тканина 0/90: V60 −0,20**, V30 +0,35 | 18,5 / 25,9 (R07d-V: 19,6 / 28,5) |
| Композит, карбон 0,85 мм | 0,53 / 0,65 | 0 | +69,4 / −46,9 | +6,4 / ~~+3,3~~ **+0,86** (0/90, R07e-V) | 18,5 / 25,9 |
| KG DN160 ПВХ 160×4,0 | ~~2,34 / 2,86~~ ≈1,7 / 2,1 (coex ≈2,0 кг/м, R07e-V) | ~~+1,81 / +2,21~~ ≈+1,1…+1,4 | +14,6 / −9,9 | +3,3 / +1,6 (завищено: спінена стінка) | ~~**21,3 / 30,5**~~ **≈22,4 / 33,1** від бази R07d-V (до поправки coex) |
| HT DN160 PP 160×3,9 | 1,74 / 2,14 | +1,22 / +1,49 | +14,6 / −9,9 | +1,8 / +0,6 | ~~20,4 / 29,0~~ **≈21,5 / 31,6** від бази R07d-V |
| Madcow 6" G12 156,7×2,16 | 1,90 / 2,33 | +1,37 / +1,68 | +27,1 / −18,3 | +5,3 / +2,7 | 20,6 / 29,4 |
| Алюміній 160×2 (гіп.) | 2,28 / 2,79 | +1,75 / +2,14 | +28,5 / −19,2 | +8,5 / +4,6 | 21,2 / 30,3 |
| Папір Ø150×2 (гіп.) | 0,68 / 0,83 | +0,15 / +0,19 | +30,2 / −20,4 | −0,41 / **−0,65 ❌** | — |
| KG DN125 (менша гондола) | 1,46 / 1,78 | +0,93 / +1,13 | +28,9 / −19,5 | +1,2 / +0,3 | 19,9 / 28,3 |

- MTOM перераховано через коефіцієнт росту R07d: 1,54 для V30 і 2,06 для V60 (з чутливості до вантажу). ✏️ R07e-V: коефіцієнти розумні, але база має бути R07d-V (19,6 / 28,5 кг), а не модельна 18,5 / 25,9; більший опір Ø160 не врахований — штрафи для труб ще більші.
- Енергія катапульти ∝ MTOM, бо швидкість сходу задана навантаженням на крило.
- **Поправка до R07d:** 1,2 кг/м² × 1,1 — це лише 0,73 мм склопластику або 0,85 мм карбону, а не 1,2 мм. Тому напруження були занижені в 1,4–1,65 раза.

## 8. Альтернативи

1. **ПВХ-труба + внутрішній карбоновий хребет.** Усередині Ø75 місця немає: пакет Ø69,7 і камера Ø66 займають усе. Щоб хребет сам ніс 109 Н·м, потрібна труба CFK Ø20×18 (≈404 МПа, 93 г/м, ≈+100 г), і винести її можна лише назовні в обтічник. Практичний «хребет» — ті самі 4 стрічки.
2. **Труба лише як обтічник.** Має сенс для гондоли з хвостовою балкою (8 кг). Для Ø75 це зайва маса.
3. **Перенести люки.** Униз — напруження ті самі, але вільні краї стискаються вже при +6g (гірше), а там ще лижа й гак катапульти. Вбік — I лишається 72–76 % замість 25 %, але люки вантажу стикаються з коренем крила (x 528–751). Для люків батареї бічний варіант можливий, але вони не визначають міцність.
4. **Силові кришки** (гвинти М2–М3 через 25–30 мм або шипи по всьому краю). Обов'язкові для кручення: дотичне зусилля лише ≈0,7 Н/мм. Якщо кришка несе й згин, закриті перерізи дають: папір + скло x 603 MS −0,25 (вологий), ПВХ +2,1, PP +0,75, папір + карбон +1,1.
5. **Без люків вантажу:** розрізати фюзеляж по рамі крила й завантажувати камери вздовж осі. Прибирає два найгірші вирізи. Стик: 6 болтів М3 на колі 70 мм, ≈1 кН на болт (ult). Мінус: щоразу роз'єднувати фюзеляж і силові дроти.
6. **HT-труба як оправка.** Поліпропілен не клеїться епоксидкою, тож працює як роздільний шар. α = 1,2·10⁻⁴/K, тож на морозі труба зменшується ~0,3 мм у діаметрі й виходить із викладки. Вакуумний рукав запечатати на трубі за межами викладки, кінці труби лишити відкритими, щоб оправку не сплющило. Перевірити на шматку 300 мм.
   - ✅ R07e-V: фізично правдоподібно (зазор 0,32–0,35 мм по діаметру при −18 °C, обтиск від усадки лише 0,01–0,04 мм; моделісти так роблять). **Але основним роздільником краще зробити 2 вільні оберти mylar/PET-плівки + віск**, а не голий PP. Ризики: друк і розтруб на Baumarkt-трубі, овальність і вигин проти радіального зазору 0,18 мм; мерзлий PP крихкий. Рукав на оправці з відкритими кінцями **обов'язковий**: HT 75×1,9 зминається вже при 0,53 бар. Епоксидку кімнатного твердіння треба дотвердити (Tg 52 → ≈100 °C).

## 9. Рекомендації

- **Light:** ~~Klima~~ паперова труба (LOC 3.00", поки Klima немає) + 1 шар карбону замість скла (або скло + 4 стрічки 1×5, +23 г). Краще — саморобна труба на HT-оправці (~~−130…−175 г, +6…+8 хв~~ **−100…−140 г, +3…+5 хв**, з рамкою або 2 стрічками на краях люка). ПВХ і PP не брати.
- **Light+:**
  1. Саморобна карбонова труба на HT-оправці (~~−0,32 кг, ≈102 хв~~ **−0,19…−0,26 кг, 99–101 хв**) — **з 4 стрічками 1×5…1×10**, рамками країв і накладками; вакуум потрібен.
  2. Без ламінування: ~~Klima~~ паперова труба (LOC 3.00") + карбон + ~~4 стрічки 1×5 на x 345–850~~ **стрічки через обидві зони (≈47 г)** + силові кришки.
  3. Купити: ~~Madcow 3" thin (+0,13 кг)~~ ❌ не продається. ➕ **LOC 3.0" carbon Ultra Light** (≈−0,05…0 кг, не підтверджено — запитати масу); запасні — Madcow 3" carbon FW (≈+0,16 кг, $370) або 3" G12 (≈+0,32 кг).
  - ПВХ-U не брати: +0,38–0,43 кг, поріг 7,9 кг, схід 25,0 м/с, пакет. HT PP, KG110, алюміній 80×2 не брати.
- **8 кг:** тільки композитна гондола (V30 — склопластик, V60 — карбон, **квазіізотропний** склопластик або сендвіч; звичайна тканина 0/90 для V60 не проходить). KG/HT DN160 — як оправка або наземний макет.
- **Для всіх:** силові кришки, рамки люків, щоки рами крила, кути вирізів R ≥ 10 мм.
- **Перед виготовленням:** зразки Klima на вологу й стиск; пробна викладка на оправці.

## 10. Поправки до старих нотаток

- **R04:** HT — це PP (0,454–0,48 кг/м, 373–432 г на 900 мм), а не ПВХ 1,4 г/см³. Найтонший реальний ПВХ — 75×2,3, 662 г на 900 мм. Жорсткість HT не «добра», а як у голого паперу. Серійної CFK Ø75 зі стінкою 0,8 мм не існує (✏️ R07e-V: але 1,0 мм існує — LOC 3.0" Ultra Light).
- **R05:** EI 758 Н·м² → 379 для голої Klima (≈730 зі склом). E паперу 1–1,5 ГПа → 1,57–2,36.
- **R05/R06, стійкість:** арифметика R06 (SP-8007) правильна. Коефіцієнт 0,2–0,3 з R05 не для R/t 31. Межу задає розчавлення паперу, ≈7–10 МПа.
- **R07c/R07c-V:** стрічки потрібні й на люках батареї (47 г замість 35). Внесок скла пораховано (EI ×1,9). Закритий вологий папір на x 603 уже за межею.
- **Light (нове):** потрібні стрічки або карбон замість скла; потрібні щоки рами крила.
- **Кути люків** залежать від внутрішнього діаметра (PP 156°/136°, ПВХ 164°/139°).
- **R07d:** товщина оболонки 0,73 / 0,85 мм, а не 1,2; напруження ×1,4–1,65.
- **Ринковий прохід:** «папір + скло найкращий за масою й жорсткістю» — ні. ~~Madcow 3" thin має 533 г/м, а не 705.~~ ❌ R07e-V: thin-версії 3" у продажу немає; купити можна лише 705 г/м.

## 11. Без джерела

- Коефіцієнт вологи 0,75 і міцність паперу (дані архітектурних труб, не Klima).
- Властивості скло- й карбонової обшивки та саморобних викладок.
- Температурні коефіцієнти PP і ПВХ.
- Допуски стінки EN 1451/1452.
- Допустимі для стрічок і міцність паперу між шарами.
- Сила на хвості 30 Н, крутний момент 6 Н·м, критерій 1° закрутки, кришки 50 % GJ.
- Частка опору фюзеляжу 0,18.
- Коефіцієнти росту MTOM з R07d.
- Ціни Madcow thin, DN160, алюмінію 160×2.
- Спосіб зняти викладку з PP-оправки охолодженням.
- Розмір люка light.
- ➕ R07e-V: модуль зсуву паперу G 0,8 ГПа (опубліковане 0,14–0,18 — лише зі сніпетів); властивості саморобних ламінатів (Vf 0,60 без нахлесту — реально 0,50–0,55 + нахлест); допустимі для скла 100 МПа (≈вдвічі консервативно) і для стрічок 500 / 350 МПа (UD-пултрузія ≈2 000 / 1 000); маса LOC 3.0" carbon (розрахункова).

## 12. Відкриті питання

- Розмір люка батареї light.
- Чи влазить пакет Ø69,7 у реальні труби ПВХ 75×2,3 і PP 75×1,9.
- Випробування зразків Klima.
- Чи готовий Віктор ламінувати.
- Конструкція силових кришок.
- Завантаження вздовж осі через розрізну раму.
- Підтвердити навантаження на хвіст і кіль та −3g.
- Діапазон температур експлуатації.
- ~~Посадка черевом.~~ — поза рамками (Віктор вирішує сам).
- 8 кг: тип оболонки й кут вирізу.
- ПВХ 75×1,8 на запит (R07e-V: лише для фірм).
- ➕ R07e-V: схема укладки саморобної труби (0/90, ±45, 3 шари) — ортотропна стійкість + зразок 300 мм на згин.
- ➕ R07e-V: місцева стійкість вільних країв вирізів на −3g; рамки й накладки та їхня маса; кути люків R ≥ 10 мм.
- ➕ R07e-V: анкерування стрічок (міцність паперу на міжшаровий зсув невідома).
- ➕ R07e-V: сила на стабілізаторі при різкому маневрі (≈70 Н проти 30 Н) — від неї залежить висновок для light.
- ➕ R07e-V: LOC 3.0" carbon Ultra Light — реальна маса, технологія, допуск OD, доставка й мито (support@locprecision.com).
- ➕ R07e-V: коли Klima Ø75 з'явиться знову — або перехід на LOC 3.00" kraft (Ø78,7) з перерахунком CAD, люків і EI.
- ➕ R07e-V: вакуум — насос R&G P1-N (≈€447) чи саморобний.
- ➕ R07e-V: ефективний кут люка з рамками: +1–2 мм зазору → Klima 154–162°, а в PP / ПВХ пакет уже не проходить.

## 13. Джерела

- Ostendorf HT (E 1 275 МПа, текучість 30,4, α 1,2·10⁻⁴/K): media.hornbach.at/hb/document/as.46067374.pdf
- OSMA HT, KG2000, Skolan: ostendorf-osma.de (каталоги 2019)
- Marley HT, 0,454 кг/м: static.toom.de/produkte/bilder/5650287/technisches_datenblatt_5650287.pdf
- ПВХ-U (1,38 г/см³, 50 МПа, 3 000 МПа, 0–45 °C / 60 °C, Vicat 76, α 8·10⁻⁵): pvc-welt.de/mediafiles/Artikel_datenblaetter/PVC-U_technische_Charakteristik.pdf
- Klima Körperrohr 75/500: raketenmodellbau-klima.de
- Madcow G12 thin / heavy wall (5,73 / 7,58 / 24 oz/ft): github.com/dbcook/openrocket-database (madcow.orc)
- Паперові труби, E 1,57–2,36 ГПа, стиск 9,5–11,2 МПа: огляд «Paperboard tubes in architecture and structural engineering» (ResearchGate 298064617)
- Композити: ACP «Mechanical Properties of Carbon Fiber Composite Materials»; R&G Wiki
- Алюміній 6060: gemmel-metalle.de/informationen/datenblatt-en-aw-6060.pdf
- Клеї: West System G/flex adhesion data; 3M DP8005; Loctite SF 770
- Стійкість: NASA SP-8007 (Rev. 2, 2020) — формули коефіцієнта зниження (за R06)
- Ринкові дані: scratchpad `fuselage/market_progress.md`

## 📦 Додаток: знайдені труби (ринок, 2026-09-25)

| Труба | Матеріал | OD × стінка, мм | г/м | Основа маси | Ціна | Джерело |
|---|---|---|---|---|---|---|
| Ostendorf HT-Rohr DN75 (HTEM), 2000 mm | PP | 75 × 1.9 | 480 | datasheet | EUR 5.95 per 2 m (EUR 2.98/m), Hornbach | [link](https://ostendorf-osma.de/uploads/page/translation/de/catalog_pdf/85/DE_HT_KATALOG_OSMA_7_2019.pdf) |
| Marley HT-Rohr DN75 | PP-H | 75 × 1.9 | 454 | datasheet | Baumarkt price about EUR 3-8 per piece (not captured exactly) | [link](https://static.toom.de/produkte/bilder/5650287/technisches_datenblatt_5650287.pdf) |
| HT-Rohr DN90 (Ostendorf) | PP | 90 × 2.2 | 610 | datasheet | n/a (Baumarkt, a few EUR) | [link](https://ostendorf-osma.de/uploads/page/translation/de/catalog_pdf/85/DE_HT_KATALOG_OSMA_7_2019.pdf) |
| HT-Rohr DN110 (Ostendorf / Marley) | PP | 110 × 2.7 | 980 | datasheet | n/a (Baumarkt) | [link](https://ostendorf-osma.de/uploads/page/translation/de/catalog_pdf/85/DE_HT_KATALOG_OSMA_7_2019.pdf) |
| Skolan dB (Schallschutz) DN78 | mineral-filled PP, 1.6 g/cm3 | 78 × 4.5 | 1750 | datasheet | n/a | [link](https://ostendorf-osma.de/uploads/page/translation/de/catalog_pdf/86/DE_SKOLAN_KATALOG_OSMA_7_2019.pdf) |
| Ostendorf KG-Rohr SN4 DN110 | PVC-U (❌ R07e-V: coex, спінена середина) | 110 × 3.2 | ~~1503~~ ≈1150–1200 | computed → shop weights | about EUR 4-8 per 1 m in Baumarkt (not captured) | [link](https://media.hornbach.de/hb/document/as.46293821.pdf) |
| Ostendorf KG2000 SN10 DN110 | PP-MD | 110 × 3.4 | 1560 | datasheet | EUR 15.79 per 2 m (baunativ-shop) | [link](https://ostendorf-osma.de/uploads/page/translation/de/catalog_pdf/88/DE_KG2000_KATALOG_OSMA_7_2019.pdf) |
| PVC-U Druckrohr 75 x 2.3 PN6 (pvc-welt) | PVC-U | 75 × 2.3 | 735 | computed | EUR 3.87 per 1 m; EUR 8.76 per 2 m; EUR 20.75 per 5 m | [link](https://www.pvc-welt.de/PVC-U-Rohr-75-x-23mm-PN-6) |
| PVC-U Druckrohr 75 x 3.6 PN10 | PVC-U | 75 × 3.6 | 1131 | computed | EUR 5.96 per 1 m; EUR 12.92 per 2 m; EUR 31.92 per 5 m (pvc-welt); also MCM-Systeme, aquapond | [link](https://www.pvc-welt.de/PVC-U-pipe-75mm) |
| PVC-U Druckrohr 90 x 2.8 PN6 | PVC-U | 90 × 2.8 | 1074 | computed | PN10 90x4.3: EUR 8.57/m; PN6 price not captured | [link](https://www.pvc-welt.de/PVC-U-pipe-90mm) |
| PVC-U Druckrohr 110 x 2.7 PN6 | PVC-U | 110 × 2.7 | 1274 | computed | EUR 6.74 per 1 m; EUR 14.91 per 2 m; EUR 35.99 per 5 m | [link](https://www.pvc-welt.de/PVC-U-Rohr-110-x-27mm-PN-6) |
| PVC-Rohr DN75 x 1.8 (HTH Trier, Abluft/Kunststoffrohr-System) | PVC | 75 × 1.8 | 580 | computed | login required; availability 'auf Anfrage' | [link](https://www.hth-trier24.de/PVC-Rohr--DN-75-x-1-8-mm--item-11281563) |
| Europlast Lüftungsrohr A100-1 (OD102/ID100) | plastic | 102 × 1 | 444 | computed | EUR 9.00 per 1 m | [link](https://www.lueftungsland.de/de_DE/p/lueftungsrohr-kunststoff-o-100-mm-1-meter-a100-1/7624/) |
| Dalap PVC Rundrohr Ø100, 1000 mm | PVC | 100 × 1.4 | 650 | shop listing | EUR 6.00 per 1 m | [link](https://www.iventilatoren.de/pvc-rundrohr-o-100-mm-laenge-1000-mm-x170) |
| Raketenmodellbau Klima Körperrohr 75mm / 500mm (art. 207550000) | spiral-wound special paper | 75 × 1.2 | 240 | datasheet | EUR 9.90 (Klima); EUR 5.90 (Space Rocket Technology) | [link](https://www.raketenmodellbau-klima.de/Raketenmodellbau/Zubehoer/Ersatz-Bauteile/Koerperrohre/Koerperrohr-75mm-500mm-lang.htm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) |
| Klima 101mm Körperrohr Set (AC-10220) | paper | 101 × 1 | ~~318~~ 363 (R07e-V) | shop listing | EUR 22.90 per set | [link](https://www.raketenmodellbau-klima.de/Raketenmodellbau/Zubehoer/Ersatz-Bauteile/Koerperrohre.htm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) |
| Apogee 74mm x 18in thin-wall body tube (10204, slotted) | kraft paper | 76.2 × 0.89 | 180 | datasheet | USD 15.74 (pack of 2, slotted); unslotted 10202 USD 28.34 | [link](https://www.apogeerockets.com/Building_Supplies/Body_Tubes/56mm_to_98mm_4in_Tubes/74mm_X_18in_Slotted_Body_Tube_Thin_Wall) |
| LOC Precision 3.9in (98 mm) body tube | kraft paper | 101.6 × 1.27 | 345 | datasheet | USD 20.96 | [link](https://www.apogeerockets.com/Building_Supplies/Body_Tubes/High_Power_Tubes/3-9in_LOC_Body_Tube) |
| Always Ready Rocketry Blue Tube 75mm | vulcanized cellulose fibre | 78.74 × 1.27 | 468 | datasheet | USD 38.19 | [link](https://www.apogeerockets.com/Building_Supplies/Body_Tubes/Blue_Tubes/75mm_Blue_Tube) |
| LOC/PML 3in phenolic tube | phenolic-impregnated spiral paper | 79.4 × 1.57 | 501 | computed | USD 25.79 | [link](https://www.rocketarium.com/Build/Airframes/Phenolic/30) |
| Madcow Rocketry 3in G12 fiberglass airframe (FT30) | filament-wound E-glass/epoxy | 79.25 × 1.52 | 705 | datasheet | USD 195.81 (listing price); 4in USD 341.19; 6in USD 474.28 | [link](https://www.madcowrocketry.com/3-g12-airframe/) |
| carbonscout GFK Filament Winding 75x70 geschliffen (FWG07570) | filament-wound glass/epoxy | 75 × 2.5 | 1082 | computed | EUR 0.11/mm = EUR 110 per m (min EUR 30; shipping EUR 13.50) | [link](https://www.carbonscout-shop.de/GFK-Glasfaser-Rohr-Filament-Winding-75x70mm-geschliffen.html) |
| carbonscout CFK Filament Winding 75x70 / 90x85 geschliffen | filament-wound carbon/epoxy | 75 × 2.5 | 854 | computed | EUR 0.25/mm = EUR 250 per m (75x70); EUR 290 per m (90x85) | [link](https://www.carbonscout-shop.de/CFK-Carbon-Rohr-Filament-Winding-75x70mm-geschliffen.html) |
| carbonrohr.net CFK Filament Winding 75x70 (65TEF7570) | filament-wound carbon/epoxy, winding 20-88 deg | 75 × 2.5 | 840 | datasheet | EUR 213 per 1 m; 70x65 (767 g/m) EUR 185; 80x75 (1015 g/m) EUR 227.50 | [link](https://carbonrohr.net/produit.php?cat=TEFC3) |
| WHABEST carbon-tubes.com roll-wrapped 3K 80x76 | roll-wrapped 3K twill carbon/epoxy | 80 × 2 | 728 | datasheet | USD 111.30 per 1000 mm; USD 63 per 500 mm | [link](https://www.carbon-tubes.com/products/od-42mm-44-46-48-50-60-64-80-84-90-94-40-104-114mm-x-length-1000mm-100-roll-wrapped-carbon-fiber-tube-3k-tubing-shaft) |
| WHABEST carbon-tubes.com roll-wrapped 3K 100x96 | roll-wrapped 3K twill carbon/epoxy | 100 × 2 | 916 | datasheet | USD 159.60 per 1000 mm; USD 84 per 500 mm | [link](https://www.carbon-tubes.com/products/od-100mm-x-id-96mm-x-500mm-100-roll-wrapped-carbon-fiber-tube-3k-tubing-100-96-3k-twill-matte-2-0-wall) |
| Carbon Composite AG Carbon Rohr gezogen 80x76 (PCT80760-1) | pultruded UD HT carbon, about 65% FVF, braided layers on large diameters | 80 × 2 | 760 | computed | EUR 147.95 per 1 m (in stock); 80x74 EUR 196.55 | [link](https://www.carbon-composite.com/Carbon-Rohr-gezogen-OE-80mm-x-oe-76mm/PCT80760-1) |
| Aluminium Rundrohr 80x2 EN AW-6060 T66 (metallstore) | Al 6060 T66, seamless extruded | 80 × 2 | 1323 | datasheet | EUR 17.65/m net (B2B only, excl. VAT, from 15 working days); 70x2 EUR 15.97; 100x2 EUR 27.23 | [link](https://www.metallstore.de/aluminium/duennwandiges-rohr/oe-40-95-mm-rundrohr/80x2-mm-aluminium-rundrohr-almgsi) |
| Hoffmann Verpackung Versandhülse BT169 Ø80 x 850 | cardboard | 83 × 1.5 | 307 | computed | EUR 1.33-2.18 per piece (packs of 30+) | [link](https://www.hoffmann-verpackung.de/versandverpackungen/post-und-lange-versandhuelsen/) |

**Не знайдено:** Aluminium round tube with 1.0 or 1.5 mm wall at 75-110 mm OD as a stock item from German shops. The metallparadies x1/x1.5 URLs return 404; metallstore and metall-fachhandel start at 2 mm. Private-buyer prices for metallparadies 80x2/100x2 are JS-only and were not captured.; CFK tubes with walls under 2 mm at OD 64 mm or more. The Chinese seller offers 1.0-1.5 mm only up to 55-60 mm; Easy Composites max OD is 60 mm. Rock West 3-4 in roll-wrapped prices and weights were not fetched.; A datasheet weight for LOC/PML phenolic tubes, and the exact wall/material of Naber Rundrohr 125 (price needs login); Rehau Raupiano Plus DN75 datasheet (download link returned HTML); Wildman / Performance Rocketry fiberglass tube prices (Madcow used as the representative); An ABS pipe in 75-110 mm with a thin wall sold to private buyers in DE (only material data collected); Shipping costs and lead time to DE for carbon-tubes.com (currency confirmed as USD; import VAT of 19% plus customs applies); Any official E-modulus for Klima or Apogee rocket paper tubes (only architectural paper-tube data exists)

---

## 🔍 R07e-V — перевірка (2026-09-26, 2 незалежні адверсарні аудитори)

**Вердикт.** Головні висновки стоять:
- **сіра HT-труба (PP) і справжній ПВХ-U для корпусу не підходять**;
- папір зі склом у нинішньому вигляді не тримає люків light+;
- силові кришки люків обов'язкові.

Незалежним кодом відтворено: EI, моменти (light+ x 603 — 108,6 Н·м; light x 372 — 45,1), масу 7,75 кг, ЦМ 590,6 і більшість запасів для паперу й ПВХ. Ринкові дані HT, ПВХ, Klima, карбонових труб і алюмінію підтверджено первинними джерелами. Поправки внесено вище видимо.

| Що перевірено | Результат |
|---|---|
| HT DN75 = PP 75×1,9, 0,454–0,48 кг/м, E 1,275 ГПа, текучість 30,4 | стоїть |
| Клей для PP | ❌ SF 770 — лише під ціанакрилат; DP8005 — Tg 34–38 °C; полум'я на PP — екстраполяція з HDPE |
| KG DN110 1,5 кг/м, «тоншої немає» | ❌ coex зі спіненою серединою ≈1,15–1,2 кг/м, є стінка 3,0 мм; висновок «ні» стоїть |
| ПВХ-U 75×2,3 — найтонший у продажу | стоїть для ПВХ, але зараз «ausverkauft»; 75×1,8 — лише для фірм |
| Klima Ø75 | ❌ **зараз не продається ніде**; заміна LOC 3.00" kraft (Ø78,7 / 76,2, 256 г/м) |
| Дані міцності паперу | ➕ ракетні труби: розчавлення 6,6–17 МПа, E 2,0–2,7 — розрахунок консервативний; G паперу, ймовірно, 0,14–0,18 ГПа (не 0,8) |
| Madcow 3" thin 533 г/м | ❌ **не продається**; реально 705 г/м (≈+0,32 кг на light+) |
| «CFK < 2 мм при Ø ≥ 64 не буває» | ❌ LOC 3.0" carbon Ultra Light 1,0 мм, Madcow 3" carbon 562 г/м, Rock West 1,27 мм |
| Алюміній 75×1 / 80×1 не продається | стоїть |
| EI і вплив вирізу 131° (I → 25 %, край ×3,4), кути люків | стоять (кути дуже чутливі до зазору) |
| Light: папір+скло MS −0,36 | «на межі або нижче» — залежить від неперевірених 30 Н на хвості |
| Light+: папір+скло закритий −0,25, з люками −0,68, 8 стрічок +0,66 | стоять (і сухий −0,14) |
| Папір+карбон + 4 стрічки | MS стоїть, але стрічки через обидві зони (47 г), Δm ≈+6 г, не −20 |
| **Саморобний карбон MS +0,31 без стрічок** | ❌ **−0,46** (ортотропна стійкість ≈70 МПа, не 170); з 4 × 1×5 / 1×10 — +0,15 / +0,71 |
| Саморобний склопластик | −0,03 → −0,38; зі стрічками +1,0 → +0,87 |
| Економія саморобних труб | light+ −0,32 → −0,19…−0,26 кг (99–101 хв); light −0,17 → −0,10…−0,14 |
| Кручення ÷4 000–6 000 | ❌ залежить від труби (÷1 200…÷50 000); у реальних відсіках ÷5…÷100, але напруження депланації 130–290 МПа — кришки однаково обов'язкові |
| Закрутка | ❌ момент кіля діє лише позаду крила: ≈×0,58 |
| Оправка з HT, зняття охолодженням | правдоподібно; основний роздільник — mylar + віск |
| Вартість саморобної труби | €25–40 → **≈€75–95 матеріалів + вакуумний насос ≈€447** |
| 8 кг: гондола з композиту | стоїть; склопластик 0/90 для V60 не проходить (−0,20); штрафи для труб від бази R07d-V ще більші |

**Що змінилося в рекомендації:**
- **Light:**
  - карбон замість скла (MS +0,66, стрічки не потрібні) — стоїть;
  - саморобна труба — лише з рамкою або 2 стрічками по краях люка; економія ≈0,1 кг.
- **Light+:**
  - саморобна карбонова труба лишається найлегшою, але **з 4 стрічками** і вакуумом;
  - без ламінування — паперова труба + карбон + стрічки через обидві зони + силові кришки;
  - «купити Madcow thin» — **скасовано**; новий кандидат — **LOC 3.0" carbon Ultra Light** (масу треба підтвердити).
- **Klima Ø75 зараз немає.** Якщо переходити на LOC 3.00" (Ø78,7), треба перебудувати ніс і конус у CAD, перерахувати люки й EI.
- **8 кг:** лише композитна гондола; для V60 — карбон, квазіізотропний склопластик або сендвіч.
