NetHunter123/Jflyproject/CAD/GN+.step

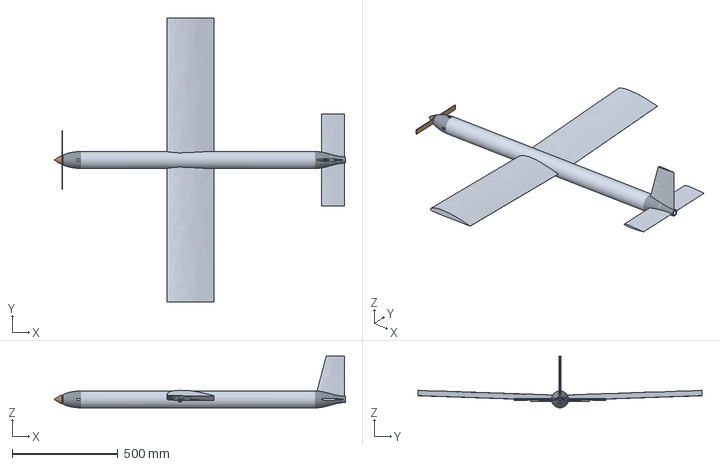
[picture p4: CAD file, 2026-10-07]
CAD/GN+.step
1373.3 x 1341.3 x 244.3 mm
