NetHunter123/Jflyproject/configs/gungnear-v1-light-plus/gungnear-v1-light-plus.step

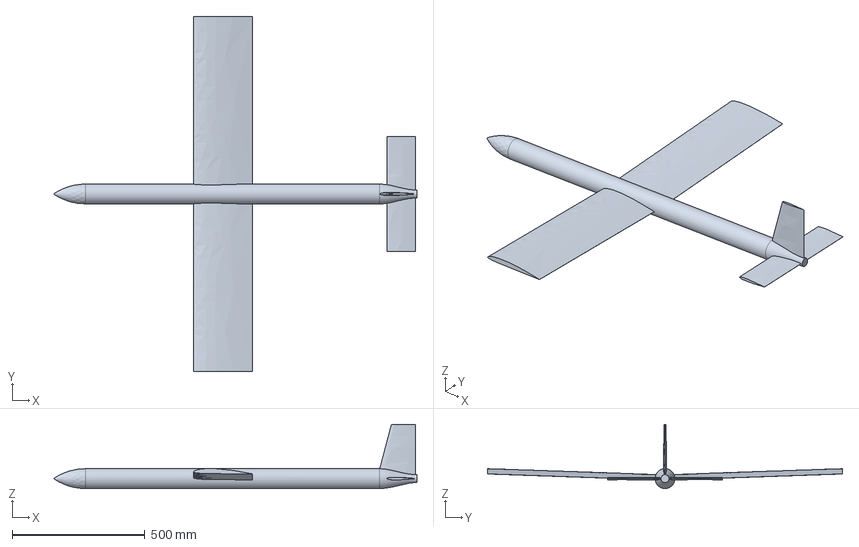
[picture p5: CAD file, 2026-10-07]
configs/gungnear-v1-light-plus/gungnear-v1-light-plus.step
1369.7 x 1341.2 x 241.8 mm
