NetHunter123/Jflyproject/configs/gungnear-v1-light/gungnear-v1-light.step

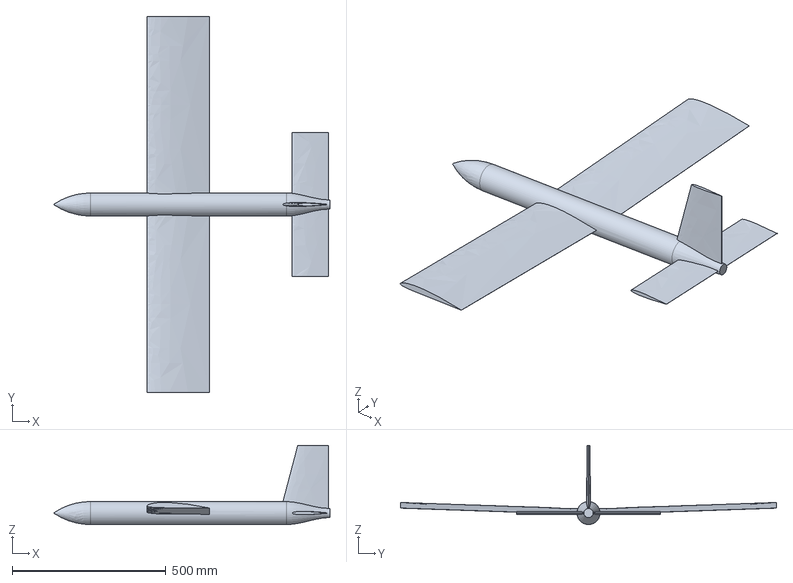
[picture p6: CAD file, 2026-10-07]
configs/gungnear-v1-light/gungnear-v1-light.step
898.5 x 1224.4 x 257.5 mm
