NetHunter123/Jflyproject/CAD/nose_spinner.step

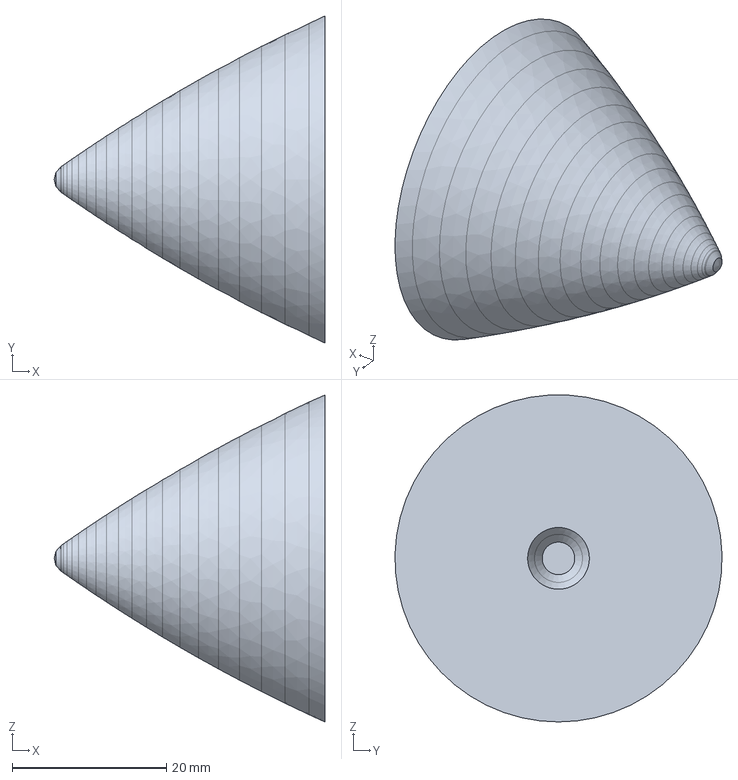
[picture p7: CAD file, 2026-10-07]
CAD/nose_spinner.step
35.1 x 42.4 x 42.4 mm
