NetHunter123/Jflyproject/CAD/_schematic_tmp.stl

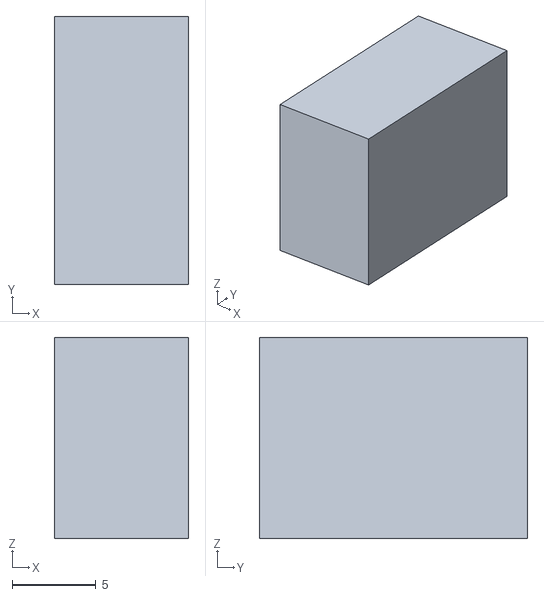
[picture p8: CAD file, 2026-10-07]
CAD/_schematic_tmp.stl
8.00 x 16.0 x 12.0
