NetHunter123/Jflyproject/CAD/GN+_airframe.stl

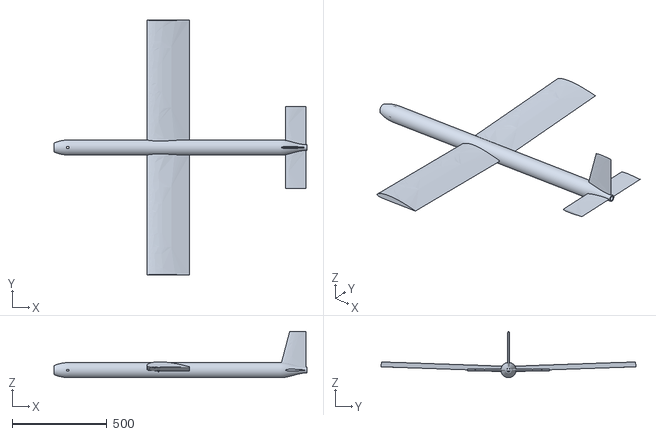
[picture p9: CAD file, 2026-10-07]
CAD/GN+_airframe.stl
1332.3 x 1341.3 x 244.3
