NetHunter123/Jflyproject/CAD/tail_lightplus.step

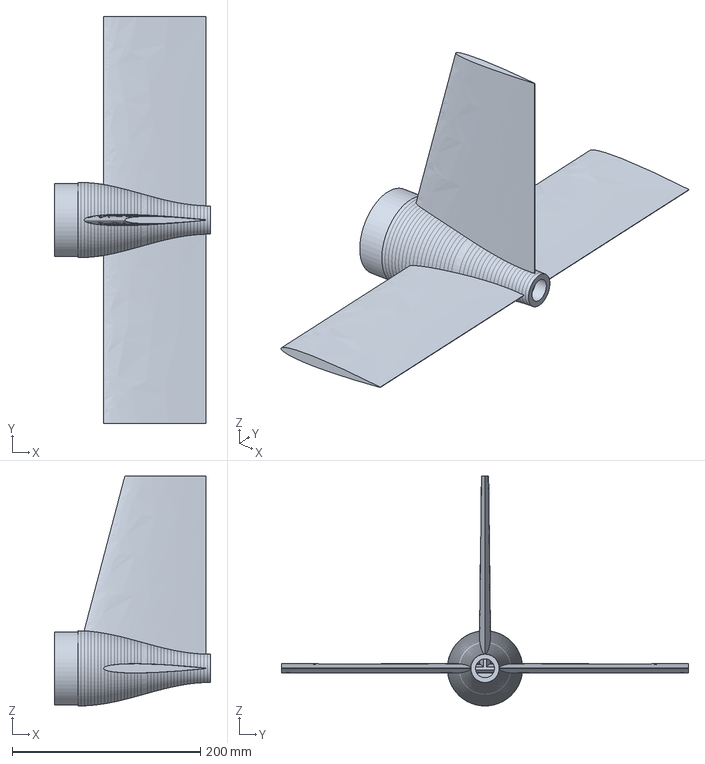
[picture p10: CAD file, 2026-10-07]
CAD/tail_lightplus.step
166.0 x 432.4 x 244.3 mm
