NetHunter123/Jflyproject/CAD/model1_cfd.step

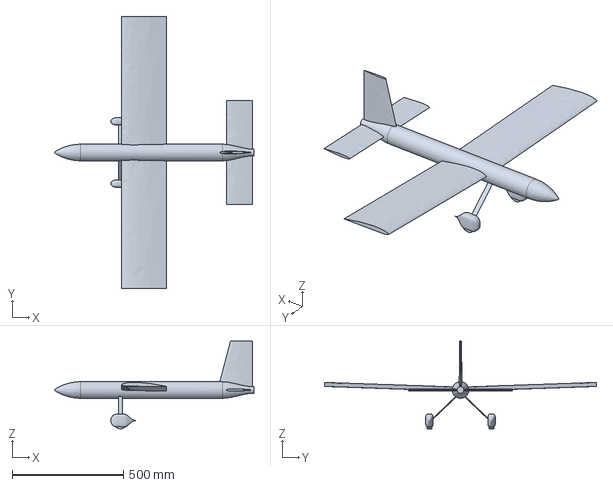
[picture p11: CAD file, 2026-10-07]
CAD/model1_cfd.step
898.5 x 1224.4 x 395.0 mm
