NetHunter123/Jflyproject/CAD/nose_lightplus.step

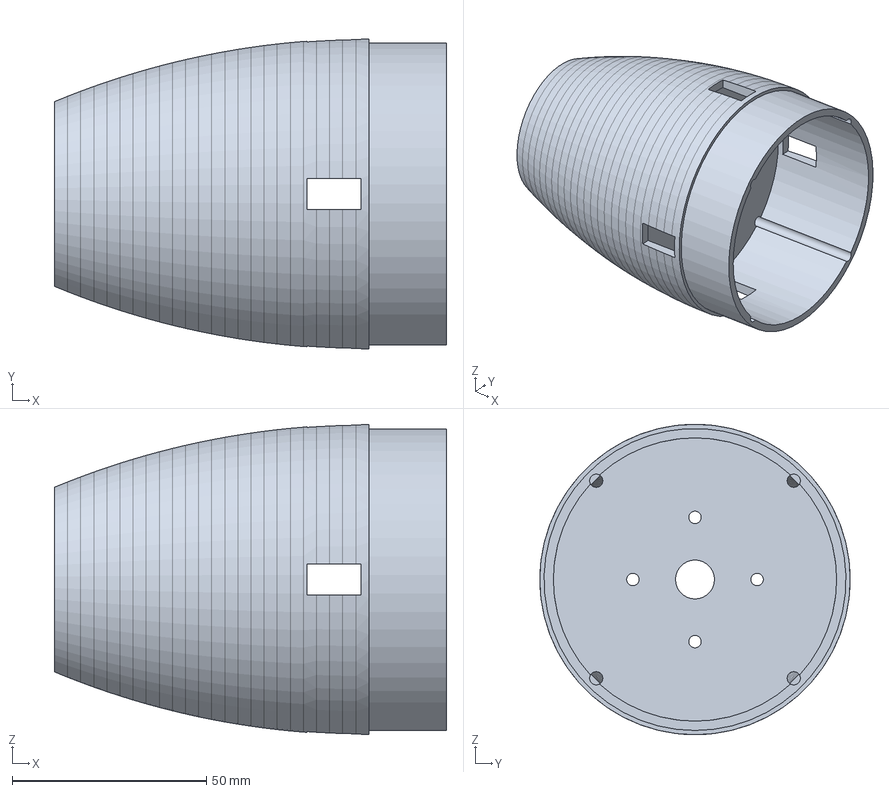
[picture p12: CAD file, 2026-10-07]
CAD/nose_lightplus.step
101.0 x 80.0 x 80.0 mm
