NetHunter123/Jflyproject/CAD/GN+_onshape.step

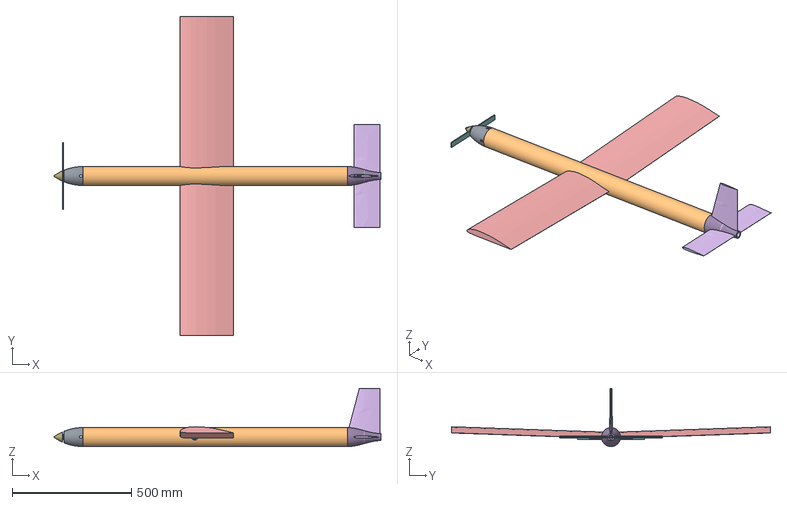
[picture p13: CAD file, 2026-10-07]
CAD/GN+_onshape.step
1373.3 x 1341.3 x 244.3 mm
cowl
tube
joiner_collar
joiner
wing_right
wing_left
tail
spinner
blade_placeholder
