NetHunter123/Jflyproject/CAD/GN+_nose.stl

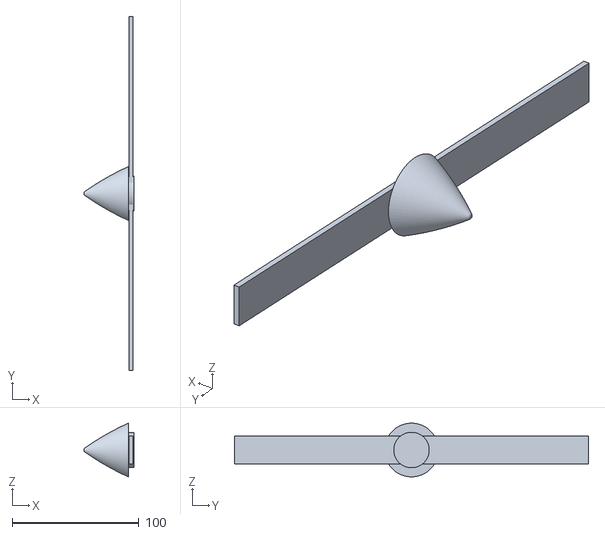
[picture p14: CAD file, 2026-10-07]
CAD/GN+_nose.stl
39.7 x 279.4 x 42.4
