NetHunter123/Jflyproject/CAD/GN+_layout.step

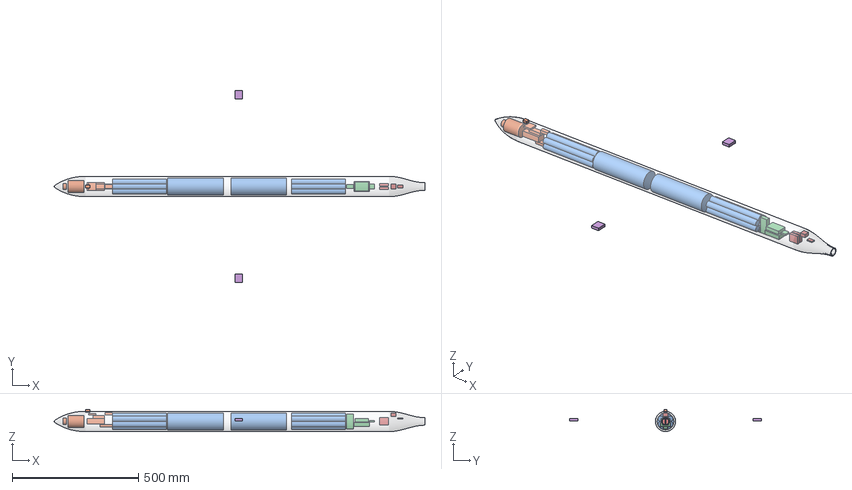
[picture p15: CAD file, 2026-10-07]
CAD/GN+_layout.step
1466.7 x 761.0 x 87.4 mm
skin
M
P
E
I
V
K
X1
J1
B1
Q1
Q2
B2
J2
PM
FC
A
T1
T2
G
RX
WS_R
WS_L
