NetHunter123/Jflyproject/(list of files, cad)

Other CAD files:
CAD/model1b_nogear.step
CAD/GN+_cfd.step
CAD/GN+.stl
CAD/GN+_cfd.stl
CAD/model1b_nogear.stl
CAD/model1c_lightplus.stl
CAD/nose_lightplus.stl
CAD/nose_spinner.stl
CAD/tail_lightplus.stl
